2AMLogic/gf180-parasynth/refprofile/README.md

# refprofile — the frozen reference side

Reference audio rendered **once** through a qualified rig, cached, hashed, and
described in a file that is committed.

**The profile and frozen audio archive are committed.** `profile.json` holds the
hashes, the plugin's identity, every parameter the rig set, and the commit it
was built at. The WAVs live in `cache/`, which is gitignored. `frozen-cache.zip`
contains the exact sixteen previously frozen WAVs, recovered from the earlier
verification worktree. Restoration checks every file's size and SHA-256 against
`profile.json` before writing any clip. It needs no plugin and does not change
the reference.

**Evidence and commentary are split across two committed files (#129).**
`profile.json` holds only what a measurement depends on — clip hashes,
commanded and read-back parameters, rig identity — and is one of
`tools/run_case.py`'s `DEPENDENCIES`/`MODEL_INPUTS` (a hashed input: a batch
whose copy differs from `origin/main`'s refuses). The sibling
`profile-notes.json` holds the prose: the rig's own qualification verdict,
per-clip rationale, boilerplate readback captions. It is committed and it is
**deliberately not named in either tuple**, so correcting a factual error in a
verdict string never invalidates a measurement or forces a re-render.
`refprofile.load_profile()` merges the two back into one in-memory dict, so
every reader (`--list`, a rejection's `why`) still sees exactly what it saw
before the split; only what is written to and hashed from `profile.json` itself
carries none of it. `tools/refprofile.py --render` writes both files together,
from one `split_profile()` call, so they cannot drift into different clip sets.

```sh
python tools/refprofile_restore.py      # restore the committed exact audio
python tools/refprofile.py              # verify the cache against the profile
python tools/refprofile.py --list       # what it holds, and which rigs it rejects
python tools/refprofile.py --render     # re-render it — an explicit act, a visible diff
python tools/refprofile_repro.py        # render it N times and compare the bytes
```

## Why a profile and not a render on demand

A reference that is re-rendered on demand is not a reference. It moves when the
plugin updates, when the host block rate changes, when a preset drifts — and it
moves *silently*, because the number coming out looks exactly the same. Every
comparison made against it before the move becomes a comparison against
something nobody can reconstruct.

So `refprofile.load_clip` **never renders**. A cache that is absent, short, at
the wrong rate, silent, or whose bytes do not hash to what `profile.json` says
is a stated refusal, and the case that wanted it is a no-verdict with the
reason on its record. Re-rendering is `--render` and nothing else, so it always
produces a diff that somebody reviews.

The audio exists because a plugin on an operator's machine produced it;
`profile.json` records that capture. The archive makes those frozen bytes
available to clean checkouts. Fresh plugin renders remain an explicit,
separate operation.

## Three outcomes, kept apart

| exit | | |
|---|---|---|
| 0 | **OK** | every clip is on disk and hashes correctly |
| 1 | **FAIL** | a clip is there and is *not* what the profile describes |
| 2 | **REFUSED** | a precondition is unmet, so nothing was attempted |

**REFUSED is not a failure of the profile and must never be read as one.** Most
hosts in this fleet have neither the plugins nor `dawdreamer`; they can restore
and use the frozen WAVs. Missing or corrupt archives and clips still refuse.

## What is in it, and what is not

One rig qualifies. Three do not and one has **no verdict yet**, and the entries
that say **no** are the load-bearing ones — "we did not use Model D" and "Model D
cannot be used" are different facts and only the second one tells the next person
not to try. So is the entry that says **not yet**: it is neither of those two.

**Every verdict is scoped to a (rig, host) pair (#123).** Read
`tools/refprofile.py`'s `RIG_VERDICTS` through `refprofile.verdict_for(rig,
host)`, which refuses a verdict asked for under a host it was not measured
under — using `RIG_VERDICTS["modeld"]` under whatever host happens to be loaded
is the mistake #123 found.

| rig | host | | why |
|---|---|---|---|
| **Surge XT 1.2.3** Type 2 | `dawdreamer` | ✅ | open source; its LP Vintage Ladder subtype Type 2 is `sst-filters`' `VintageLadder::Huov` — Huovilainen's DAFx-04 model, the same paper DR 0001 implements. The **only** reference here whose cutoff is commanded in Hz and reads back in Hz |
| **Moog Model D** | `dawdreamer` | ❌ | **renders exact silence under `dawdreamer` 0.9.0.** Measured, not inherited: peak 0.0 with oscillator 1 on at full level and the filter wide open, and peak 0.0 with the filter self-oscillating. The rig builds and its pins hold. This verdict is about the (plugin, host) pair and **not** about the plugin — see the row below. `profile-notes.json`'s `disqualified.modeld.verdict` and `rigs.modeld.why` now carry this same host-scoped wording (#129 corrected the unscoped "renders exact silence headlessly" that used to live in `profile.json` itself — a prose edit, and it no longer touches a hashed input) |
| **Moog Model D** | `pedalboard` | ⏳ **no verdict yet** | **NOT silent under `pedalboard`** — peak 1.000, 8.57 % of samples at the rail, strongest partial 131.00 Hz for a commanded MIDI 60 (261.63 Hz, so an octave down — the same default as Mini V3, which is itself the exact reverse: it sounds under dawdreamer and is silent under pedalboard). Both of those disqualify the **default patch**, so `reference_rigs.ModelDPedalboardRig` (#124) exists to try to correct them through Model D's own parameters and measure whether it worked: it sweeps Osc 1 Range and selects the position that *sounds* the commanded note, and steps the master volume to the loudest setting with zero samples at the rail. `qualified` is **`None`, not `false`** — no operator has run it on a machine with the bundle. Run `python tools/qualify_modeld_pedalboard.py`; see [`docs/pedalboard-rig.md`](../docs/pedalboard-rig.md). **What is missing narrowed on 2026-09-30:** the *host* is no longer part of it — `pedalboard` 0.9.25 installs cleanly from a wheel on Linux / CPython 3.12 into an isolated venv, the rig's API surface has been read against that install and holds, and the refusal on this fleet is now `Moog Model D is not installed at …` rather than `no pedalboard on this machine`. The one remaining blocker is the **licensed Model D binary**, which no venv produces |
| **Arturia Mini V3** | `dawdreamer` | ❌ | makes sound under this host (it is **silent** under `pedalboard`), and every parameter is a bare 0..1 with no units and no readback. Its cutoff can be calibrated against its own self-oscillation (`reference_compare.calibrate_knob`); its **envelope** knobs cannot, because nothing here maps a Mini V3 envelope knob to a time. Its Range control also defaults an octave down — note 48 reads 65.42 Hz until parameter 45 is written. **The ❌ is `envelope_timing` alone** — see the capability matrix below, where this rig is ✅ for pitch, waveform and the sustained filter |
| **u-he Diva** | `dawdreamer` | ❌ | found running unlicensed and inserting clicks (`docs/reference-integrity.md` §1), and is a general analogue-modelling synth rather than a Minimoog emulation |

**And every verdict is scoped to a CAPABILITY (#136).** One boolean per rig
forces the most restrictive capability to gate every other one, which is how one
missing calibration came to be recorded as a 32-case blocker. `python
tools/refprofile.py --capabilities` prints this on any host, and
`capability_why` in `RIG_VERDICTS` names the measurement behind every cell:

| rig | overall | pitch | waveform | sustained filter | envelope timing | pitch causality | filter causality |
|---|---|---|---|---|---|---|---|
| **Surge XT** Type 2 | ✅ | ⏳ | ✅ | ✅ | ⏳ | ⏳ | ✅ |
| **Mini V3** | ❌ | ✅ | ✅ | ✅ | ❌ | ⏳ | ⏳ |
| **Model D** / `dawdreamer` | ❌ | ❌ | ❌ | ❌ | ❌ | ❌ | ❌ |
| **Model D** / `pedalboard` | ⏳ | ⏳ | ⏳ | ⏳ | ⏳ | ⏳ | ⏳ |
| **Diva** | ❌ | ❌ | ❌ | ❌ | ❌ | ❌ | ❌ |

⏳ is **no verdict**, not ❌ — and the asymmetry is the point. **Mini V3's pitch is
measured and Surge's is not**, because Mini V3's Range default was *broken* and
somebody therefore had to measure it (MIDI 48 at 65.42 Hz, exactly half of
130.81) while nobody ever doubted Surge's. What is recorded is what was measured,
and "probably fine" is not a verdict. The two all-❌ rows are disqualified at the
**apparatus** level — Model D returns peak 0.0 under this host, Diva was found
unlicensed and inserting clicks — so their rejections are written out across
every capability rather than left blank, and no capability-scoped query can route
around them.

**No clip in this profile comes from a pedalboard-hosted rig.** All sixteen are
Surge XT Type 2 under `dawdreamer`, and adding the pedalboard entry to
`RIG_VERDICTS` changes no clip and no hash — it appears in `profile.json` only
on the next `--render`.

Sixteen clips, all from Surge XT Type 2 at 48 kHz:

- one **wide open** (20 kHz) stepped-tone render — the passband reference that
  makes "low-band gain" a ratio *inside one instrument*
- ten at **250 Hz**, at resonance 0 and at each rung of
  `reference_compare.RES_GRID["surge"]`
- three **drive** clips: a steady 100 Hz tone at −12, −6 and 0 dBFS
- one each at **1 kHz** and **4 kHz**, resonance zero — the other two cutoff
  regions `docs/scorecard/cases.csv` states, read by F1B and F1C. Surge's own
  readback is exactly 1000.00 and 4000.00 Hz; the *corner* those produce is
  neither number and is read off the audio

Only resonance zero is rendered at the new regions, and that is a limit rather
than an omission. F1B and F1C are the only cases those clips can be read by.
F2B and F2C want a resonance ladder there and are blocked on a matched-drive
**definition**, not on audio — see `run_case.NOT_RUN["F2A"]` — so freezing ten
more rungs per region would cache audio no case can consume and move every
consumer's profile hash to do it. Whoever writes that definition renders the
ladder the definition asks for.

## Frozen, and *reproducibly* frozen — two different claims

A list of hashes says these are the bytes that were frozen. It says nothing
about whether the rig would make them again, and only the second makes the
profile a reference rather than a recording. `tools/refprofile_repro.py` asks
the second question: N separate `--render` **processes**, so the VST3 is
reloaded and the rig re-qualified every time, then a byte-for-byte comparison.

At `daf9e64`, macOS/arm64, Surge XT 1.2.3, dawdreamer 0.9.0, Python 3.14.7:

```
16/16 clips bit-identical across 4 independent renders
14 reproduced the committed sha256, 0 changed, 2 new, 0 dropped
```

The second line is a *different* claim from the first and is the load-bearing
one: a host that renders the same thing four times and something else than the
operator who froze the profile has a reproducible rig and a moved reference.
This host reproduced all fourteen, so the two new clips were frozen by the rig
that froze the rest — not merely by a rig that agrees with itself.

Asked again at `01e01e1`, on a host whose `cache/` was empty, after
`--render` rebuilt it from nothing. The verdict is committed as
[`repro-report.json`](repro-report.json) rather than quoted from a log:

```
16/16 clips bit-identical across 4 independent renders
16 reproduced the committed sha256, 0 changed, 0 new, 0 dropped   (exit 0)
```

Sixteen now, not fourteen of sixteen: the two clips #146 added are on their
second independent freeze and `profile.json` is byte-unchanged by the run.
**This is the precondition the filter cases are measured under, not a property
of the profile in general** — #164 had to leave every reference-side F1 number
as a no-verdict precisely because `cache/` is gitignored and that host could not
render it. A host can now recover the identical bytes from `frozen-cache.zip`;
the existing per-read hash guard still protects F1A/F1B/F1C's reference side.

The restored-cache check verified **16/16 exact clips**. Both previously
blocked controls now execute: missing and tampered references each change all
three valid clean F1 comparisons into refusals. No sound measurement was
revised during restoration (0/16 clip identities changed). Synthetic archive
controls also reject a missing clip, a corrupt clip, and an escaping path
before writing any audio. CI runs these controls in an independent job.

What it does **not** vary: the machine, the OS, the plugin build, the sample
rate, the block size. Those are pinned by the rig and recorded in
`profile.json`, and a claim about them needs a second machine, not a second
run. A clip that does not reproduce is not frozen, and the tool refuses to
install it.

## Pins after rendering: what the frozen profile does and does not show (#233)

**The committed `profile.json` makes no post-render pin claim, although its
`pins_held_after_render` field says `true`.** The renderer that built it
(builder `4bbd8e90…`, at `daf9e64`) checked the pinned Surge parameters once,
*before* any clip was rendered, and wrote that field as a constant. Nothing
re-read the pins after a clip. `profile.json` and the frozen audio are left
byte-unchanged here: rewriting the field would change the historical record,
and re-rendering the profile would add nothing a reproduction does not
already show. `tools/refprofile.py --list` says this about the profile, and
`refprofile.post_render_checked()` returns false for it.

Since #233, `--render` re-reads every pinned name and readback after **each**
clip render, before that clip is written, and refuses on any change. The one
name change it accepts is the Classic→Audio In rename that #231 measured at
**259, 260, 264 and 265**. The readback is still required to match exactly.
`pins_held_after_render` is now derived from those checks. The per-clip
results are recorded in `qualification.post_render_check` and in each clip's
`pins_after_render`.

**The builder hash changed, and nothing is re-pinned to it.** Any profile
rendered from now on records the new `builder_sha256`. The committed profile
still records `4bbd8e90…`. `tools/run_case.py` hashes `tools/refprofile.py` as
a model input, so a run_case result from before this change no longer covers
the tree. That is the intended effect of a hashed input.

At `9f106f7` (clean), same host, Surge XT 1.2.3 and dawdreamer 0.9.0 as above,
the new renderer checked every clip in two independent renders
([`post-233-check/`](post-233-check/)):

```
16/16 clips bit-identical across 2 independent renders
16 reproduced the committed sha256, 0 changed, 0 new, 0 dropped   (exit 0)
pins_held_after_render: true, derived; 16/16 clips checked in each run
name aliases observed on every clip: 259, 260, 264, 265 (readbacks unchanged)
```

The last line re-observes #231 independently. From the first clip onward,
Surge reports all four indices under their Audio In names. So the pre-#233
check, had it re-read the pins by exact name, would have refused every clip.
The frozen audio remains the same audio: the 16 committed hashes reproduce
under the new check. That reproduction is evidence about the *current* rig.
It does not show that the 2026-09-18 capture had a post-render check.
`profile.render1.json` in that folder is a run's output, kept for its
`qualification` and `pins_after_render` records. It is **not** the frozen
profile, and nothing reads clips through it.

## The probe level, and the floor it comes from

Every stepped-tone clip is at **−12.04 dBFS** (`amp = 0.25`), the level
`reference_compare.response_curve` has probed at since #87. That is not a level
chosen after seeing an answer, and it is not arbitrary — it is the only level
inside **our own side's** measured stability window:

| input | our corner at res 0 | our corner at res 1.20 |
|---|---|---|
| −60 dBFS | — | 55.7 Hz *(quantisation noise)* |
| −36 dBFS | — | 282.6 Hz |
| −24 dBFS | 125.2 Hz | — |
| −18 dBFS | 124.3 Hz | — |
| −12 dBFS | 117.8 Hz | 361.2 Hz |
| −6 dBFS | 105.0 Hz | — |

Below about −24 dBFS the stepped-tone probe on our 16-bit ladder is reading
truncation noise: at −60 dBFS `audio_measure.slope_db_oct` refuses every
resonant row and the corner moves by 300 Hz. Above −12 dBFS our own saturation
moves the corner. Surge is *level-independent* over the whole range — its
`thermal = 1/70` input scaling keeps it small-signal — so **the window is ours,
and it is stated as ours.** (Issue #92: a published floor that was not actually
constant withdrew a whole column of #61.)

## Rules

- **Expanded cache files remain ignored.** The one frozen archive is committed;
  new capture audio must have a reviewed profile identity before replacing it.
- **A result that used a clip names it**, by clip id and content hash.
  `tools/run_case.py` writes both into every record's `provenance.inputs`.
- **`profile.json` and `profile-notes.json` are generated together by
  `--render`, not edited by hand.** Only `profile.json` is one of
  `tools/run_case.py`'s `DEPENDENCIES`: a batch whose profile differs from
  `origin/main` refuses, because a result measured against a different frozen
  reference is not comparable with one measured against this one. `profile-
  notes.json` is deliberately absent from `DEPENDENCIES` and `MODEL_INPUTS`
  (#129): its prose is commentary, not evidence, and correcting it must never
  refuse a batch or invalidate a measurement.
- **Re-rendering is a decision, and its diff is the review.** If a clip's hash
  changes, something about the reference changed, and the diff says what.
- **A verdict belongs to a (rig, host) pair and is never overwritten by the other
  host's result.** Ask for one through `refprofile.verdict_for(rig, host)`, which
  refuses the cross-host read. Model D's dawdreamer entry records that this bundle
  renders exact silence under the host every clip here was built with; replacing
  it with a pedalboard result would erase that measurement.
- **`qualified: None` is not `qualified: false`.** "Nobody has run it" and "it
  cannot be used" are different facts. `refprofile.qualified_rigs()` returns only
  the `True` entries, and nothing may read a `None` as a rejection.
- **A verdict also belongs to a CAPABILITY, and the three-state rule applies
  there too (#136).** One boolean per rig forces the most restrictive capability
  to gate every other one: Mini V3's uncalibrated envelope knobs were recorded as
  blocking 32 Mono cases, when an oscillator-waveform comparison and a
  sustained-filter comparison need no envelope timing at all. So the key is
  (rig, host, capability):

  ```
  python tools/refprofile.py --capabilities      # the matrix, on any host
  ```

  `verdict_for(rig, host, capability)` returns that capability's verdict and
  keeps the rig-level AND as `rig_qualified`; `require_capability` raises a
  refusal **naming the capability** and saying what the rig *is* qualified for;
  `qualified_rigs(capability=...)` deliberately does **not** consult the
  rig-level boolean, which is the whole point — Mini V3's overall verdict is
  `NO` and it is qualified for `pitch`, `waveform` and `sustained_filter`.
  Asking for a capability a rig has no entry for is a **refusal**, never a
  `False`. A rig disqualified at the apparatus level (`modeld` renders silence,
  `diva` was found unlicensed) carries a measured `False` on *every* capability,
  written out rather than left blank, so no capability-scoped query can route
  around it. `capability_why` is prose and lives in `profile-notes.json` with
  the rest (#129).
- **A case says what it consumes, so the runner can ask the right question.**
  `run_case.capabilities_for(case_id)` derives it from the case's own
  `required_measurements` cell in `docs/scorecard/cases.csv` rather than from a
  second table beside it, and `run_case.capability_refusal(case, rig, host)`
  names the capability. The derivation independently reproduces which Mono cases
  run today: M1A/M5A/M5B need only capabilities Mini V3 has, and the six
  `NOT_RUN` anchors are exactly the ones that need envelope timing.
  `tools/capability_pack.py` is the pack that was parked behind that
  calibration — two waveforms at two pitches plus an open/closed filter pair —
  with the gate it passes and the apparatus refusal it still hits on a host
  with no plugins.
- **Every clip's environment tuple goes through `refprofile.environment_tuple`,
  whichever host rendered it.** One recorder — host and version, plugin and
  binary hash, block size *and its rate in Hz*, sample rate, licence state,
  preset (#123). It refuses rather than reports on a missing field, a plugin with
  no binary hash, and a `block` or `sr` given as `"unstated"`.
