2AMLogic/gf180-parasynth/docs/deadline/README.md

# The production frame deadline: three 2x saws with the 2x filter (plan075 T1)

**Verdict.**

- **Published baseline (OSC2X=1 FILTER2X=1 PULSE2X=0): fits, in every configuration exercised.**
  - The configuration PR #235's component bench refused runs with 79 cycles of sample slack.
  - Under musical stress the worst slack is 14 cycles. On SPI that stress included the full drum kit; on the Arty UART path the same voice ran with the drum page at reset (§3).
  - The observed extreme-case minimum is **6 cycles**, at register-legal increments of 2^23 and above.
  - Zero missed frames, zero sticky `overrun`, in every baseline run.
  - I2S matched the model exactly in **every musical-range comparison**: every required period decoded, once, in order, and compared. The extreme baseline runs do **not** match the model; that is #247, a separate defect, not a deadline result.
  - The cost-model bound (248 cycles, 6 of slack, for any register value) holds only **under the assumptions in §4**. It is checked on 30,333 retained frames but is not a formal proof.
- **The refusal was the bench's, not the chip's.** The bench now launches where the chip does, and its late-completion control fails for the deadline reason, to the cycle.
- **Pulse-enabled (PULSE2X=1): two separate findings.**
  - *Observed:* at register-legal increments of 2^23 and above (above Nyquist), 1597 and 1739 frames missed the deadline and the sticky overrun set.
  - *Proposed, not observed:* in the musical range the cost-model bound is exactly the deadline, 0 cycles of slack. No musical-range miss was seen; the worst musical-range stress had 4 cycles of slack.
  - **PULSE2X=1 is excluded from the first release** as a conservative decision. That is a checkpoint, not a fulfilment. A bounded correction is measured in §7 and deliberately not part of this PR.

Every simulated number comes from `docs/deadline/runs/`, the simulator runs at `2221d2c`: `run_all.json` holds each job's exit status, and each run has its own record. The batch is `tools/deadline_batch.py`. The **analysis** of those same captures was re-run without re-simulating, under analysis version 2 (§4, §4a); those records are in `docs/deadline/reanalysis/`. The traces themselves are archived gzip'd in `docs/deadline/traces/`, with their sha256 in each reanalysis record.

## 1. What was measured

| | |
|---|---|
| Source | batch run at `2221d2c` (`docs/deadline/runs/HEAD.txt`), which is `origin/main` `9337ece` (#235 merged at `ffc1c00`) plus this branch. The tree was dirty only with the batch's own output directory. |
| RTL | `rtl-sketch/voice_dp.v` `a15752570543`, `synth_top.v` `e4f8d97b9785`, `fpga/rtl/arty_a7_top.v` `664a4359af90`. All three are **byte-identical to the published Arty baseline's `source_sha256`** (`fpga/reports/arty/integrated-baseline-2025.1/publication.json`), and the other sources are hashed in each run record. |
| ROMs | `tanh16.hex` `a5c4862a7e90`, `tanh256.hex` `c6e81324b225`, `g_rom128.hex` `97bd3bc7774f`, `k_rom32.hex` `723f288d7bc1`, `sine_q256.hex` `040736830a6b`, `exp_rom65.hex` `c29b6f815d80` |
| Flags | baseline `VOICE_OSC_2X VOICE_FILTER_2X`; pulse-enabled adds `VOICE_PULSE_2X` |
| Clock / rate | 12.288 MHz core, 256 cycles per frame, 48 kHz. The Arty wrapper runs with `SIM_NO_MMCM=1`, so the bench supplies 12.288 MHz directly. |
| Benches | `tb_top_bx.v` drives synth_top through the SPI pins. `tb_uart_bx.v` drives `arty_a7_top` through the UART pins and holds SPI idle. Both are unedited. `rtl-sketch/deadline_mon*.v(h)` is attached as an extra simulation root that reads synth_top hierarchically and drives nothing. |
| Simulator | Icarus Verilog. Python is `/Users/joseph/dev/gf180-parasynth/.venv`, which is a symlink to the gf180-monosynth venv, so the logs show that path. |

**The frame, from the RTL.** `go` is at cycle 8 (`GO_CYCLE`). The voice and drum datapaths are busy from cycle 9. The SPI drain writes in cycles 1–5 and the UART in cycles 6–7; the runs observed cycle 2 (SPI) and cycle 6 (UART). No write ever landed while a datapath was busy.

`i2s_tx` loads the next period's word at cycle 255, so the **sample deadline is a strobe by cycle 254**. `synth_top` latches `overrun` if either datapath is busy in cycle 0, so the **busy deadline is cycle 255**. The next frame's boundary is cycle 256, which is cycle 0 of the next frame. The drum section finishes at cycle 125 in every frame of every run, a constant, so it never gates the voice.

## 2. The refused case, with legal setup

This is PR #235's `f1cal` configuration with SAW instead of revsaw: three 2x saw oscillators with mix 1/0/0, the 2x filter, and `surge-type2-clean-v1` at 250, 1000 and 4000 Hz with resonance 0, then 1000 Hz at resonance 1.0 and 1.1. The words come from the landed calibration and are asserted equal to #235's record: gain 42598, ogain 100825 / 302474 / 322639.

In production, every register of the image was preloaded over the SPI pins before the note. Frames were computed from reset as always, but the gate stayed off until the image was complete. The note (three INC jumps, TRACK, GATE_ON) followed, and each F1 point was then a control write during playback.

| run | frames | missed | worst strobe | sample slack | busy slack | overrun | I2S vs model |
|---|---:|---:|---:|---:|---:|---:|---|
| production, PULSE2X=0 | 3691 | 0 | 175 | **79** | 81 | 0 | 3692 periods, 0 differ |
| production, PULSE2X=1 | 3691 | 0 | 175 | **79** | 81 | 0 | 3692 periods, 0 differ |
| component bench, production launch (frame 0 = whole image + note) | 7200 | 0 | 217 | **37** | 39 | — | 7200 frames, every sample and tap identical |
| component bench, **old launch** (`--go 48`, diagnostic) | — | frame 0 | — | — | — | OVERRUN | reproduces #235's refusal, now as a deadline FAIL |

Frame 0 of the component scenario is the heaviest frame this configuration produces: every register plus three new increments, so three reciprocal divisions. At go = 8 its strobe is at cycle 217. At go = 48 the same frame would strobe at cycle 257. That is the whole refusal.

## 3. Production results for every configuration

Each "stress" run preloads the voice image and the complete 808 kit, all 147 kit words plus the accents. It then plays three audible oscillators (mix 1/0.8/0.7, noise 0.3) with glide and oscillator and filter modulation on. That means every increment moves every frame, so all three reciprocals are recomputed.

Over those notes the run strikes all eleven stops and subsets of them. It switches the drum filter (ROUTE.DFILT) on and off and moves DCUT. It sends cutoff, resonance, volume, wheel and waveform writes during playback. It includes legato glides, retriggers, a gate-off and a three-increment jump. It then sweeps legato runs across MIDI 24–127.

"Extreme" runs set every increment to 2^23 or above by register writes. That is legal, but above Nyquist; note 127 is 0x42xxxx. They glide between such values with the drum filter on, which opens both PolyBLEP windows of every edge.

| configuration | scenario | frames | missed | worst strobe | **sample slack** | busy slack | overrun / busy-at-tick | I2S vs model |
|---|---|---:|---:|---:|---:|---:|---|---|
| baseline | stress-saw (SPI) | 2155 | 0 | 240 | **14** | 16 | 0 / 0 | 2156 periods, 0 differ |
| baseline | arty-uart (UART pins, Arty wrapper) | 3496 | 0 | 240 | **14** | 16 | 0 / 0 | 3300 periods, 0 differ |
| baseline | extreme-saw | 2167 | 0 | 245 | **9** | 11 | 0 / 0 | 1809 differ, see §7 |
| baseline | extreme-saw-mod | 2167 | 0 | 248 | **6** | 8 | 0 / 0 | 1809 differ, see §7 |
| PULSE2X=1 | stress-saw | 2155 | 0 | 242 | **12** | 14 | 0 / 0 | 2156 periods, 0 differ |
| PULSE2X=1 | stress-pulse (square / pulse29 / pulse15) | 2155 | 0 | 250 | **4** | 6 | 0 / 0 | 2156 periods, 0 differ |
| PULSE2X=1 | extreme-pulse | 2167 | **1597** | 255 | **−1** | 0 | **1** / 1293 | FAIL |
| PULSE2X=1 | extreme-pulse-mod | 2167 | **1739** | — | — | — | **1** / 1675 | FAIL |

Every run delivered all its writes (for example 460 of 460 SPI and 71 of 71 UART). None were corrupted, none landed off the frame the pin predicted, and the link `overflow` stayed at 0.

For the baseline stress-saw, the gate was on with three audible 2x saws for 1644 frames: 1188 of them with the drum filter and 44 with a strike in the same frame.

**The full-kit stress claim belongs to the SPI runs only.** The arty-uart run is the published Arty configuration under UART control, checked by `fpga/verify_uart_bridge.py`'s own contract and model comparison. It strikes stops and turns on the drum filter, but its drum page stays at its **reset image**: the 147-word kit would take about 5000 frames at 115200 baud. It shows that the UART control path keeps the same voice schedule. It is **not** a UART full-kit demonstration.

## 4. The cost model: reconciled, re-analysed, and its limits

**What changed (analysis version 2).** Version 1 of `cost_model()`, as reviewed at `4433cf8`, subtracted `ywait` (the S_YWAIT wait for the voice ladder) as if it were a serial term. The README formula did not. So the committed run records said `explained: false`, with residuals 82/76/78/80, while this document said 87. The document was not backed by its own evidence.

The disagreement is visible in two committed frames of stress-saw:

| frame | ywait | every serial term | strobe |
|---|---:|---|---:|
| 538 | 5 | equal | 240 |
| 840 | 11 | equal | 240 |

Frame 840 waited 6 more cycles and completed at the same cycle. Under version 1 their residuals are 82 and 76; under the formula below both are 87. `docs/deadline/reanalysis/red-first-v1.log` records this, and `tools/test_verify_deadline.py` pins it.

**The schedule, as the RTL overlaps it.** The voice ladder is launched at S_LGO and runs in parallel with the sequencer's shadow work: envelope updates, glide slews (two extra states per gliding oscillator), red noise, the modulation pan and the drum-filter coefficients. S_YWAIT then waits for whatever is left of the ladder's latency. As long as the ladder, not the shadow work, ends that wait, the shadow work trades one-for-one with `ywait` and completion does not move:

```
strobe = C + R + O + D + W + 2·A + I + 3·K        overlap condition: ywait >= 2 in the frame
```

- R: reciprocal waits, 19 for each oscillator whose modulated increment changed.
- O: 2x-bank waits, 20 for each oscillator routed through the bank.
- D: the drum-filter wait, 1, or 23 with ROUTE.DFILT.
- W: PolyBLEP windows examined.
- A: active windows.
- I: modulated increments.
- K: shark-tooth oscillators.

`ywait` is not a term. A frame whose `ywait` is below 2 would mean the shadow work ended the wait, so the formula would not apply; it is counted as an exception, never absorbed.

**Re-analysis of every retained trace.** `tools/deadline_reanalyse.py` re-judged all 18 captures of the `2221d2c` batch with `verify_deadline.py --analyse-capture`, without simulating. Every capture was **identified**:

- its stimulus, re-derived from the record's scenario, equals the capture's own command file byte for byte;
- its re-computed frames, misses and worst slacks equal the original record's;
- all 18 re-judged statuses equal the original ones.

| | value |
|---|---|
| deadline-meeting unmutated traces checked | 12 (both threesaw, all four stress, arty-uart, both extreme-saw, four skip2xwin candidates) |
| frames checked | **30,333** |
| value of C | **87 in every frame**; no other residual |
| overlap exceptions (`ywait` < 2) | **0**; `ywait` ranged 5..11 |
| `late:14` / `late:15` controls | C = 101 / 102 in all 2155 frames each, so the stall is exactly additive |
| traces with misses (excluded from the bound) | extreme-pulse, extreme-pulse-mod and the late:160 controls. After the first overrun their frames desynchronise, and those residuals (e.g. −169) are not frames the model describes. |

The records are in `docs/deadline/reanalysis/`: `summary.json` holds the totals and the capture identities, and each `<record>.json` carries `analysis_version: 2` next to the original run's provenance.

**The per-term maximum argument, and what it assumes.**

| configuration | worst oscillator | bound, increments < 2^23 | bound, any register value | observed |
|---|---|---:|---:|---|
| PULSE2X=0 | 2x saw: O 20 + W 2 + 2·A 2·2 | 242 (slack 12) | 248 (slack 6) | 248 reached (extreme-saw-mod); musical-range worst 240 |
| PULSE2X=1 | 2x rectangular: 20 + 4 + 2·4 | 254 (slack 0), **not observed** | 266 (−12) | 255: observed misses above Nyquist; musical-range worst 250 |

The bounds take C = 87, R = 57, D = 23, I = 3, K = 0 and three of the worst oscillator. They assume:

1. **C is 87 in every reachable frame.** It is measured in 30,333 frames; it is not derived.
2. **The overlap condition holds in every reachable frame.** The largest shadow load in the traces (three gliding oscillators) still left `ywait` = 5.
3. **Per-term maxima are structural.** R ≤ 3 × 19 and I ≤ 3 because there are three oscillators. O is 20 per 2x oscillator. D ≤ 23. W is 2 per single edge and 4 per rectangular waveform. A single-edge window pair has at most 1 active when the increment is below 2^23 and at most 2 at or above it, read from the `active` expression in `voice_dp.v`. A shark oscillator (K) is outside the 2x bank and costs less than a 2x saw.
4. **The drum section completes at cycle 125 in every frame.** This is observed with every stop and pair exercised; a drum-engine change needs a re-run.
5. **Writes never land at or after `go`**, by `synth_top.v`'s drain and UART window. This is observed in every frame.

This is a bound from a cost model checked against every retained frame. **It is not a formal proof.** Where the assumptions are not observed, it is a claim. In particular, PULSE2X=1's 0-cycle musical-range figure is a *proposed* bound, not an observed miss.

## 4a. Evidence completeness: a verdict needs every period

**Version 1 accepted missing evidence.** Its I2S comparison looped over whatever periods were decoded. Given the clean SPI facts with `periods` set to 0 or 1, the verdict was still PASS (`red-first-v1.log`). Its schedule parser silently skipped malformed rows and needed only 10 frames.

**Version 2 derives what must be present from the bench contract.**

- **SPI.** The model covers `n = last landed write + tail + 1` frames. `tb_top_bx` stops `tail` ticks after its last transaction, and by its contract the last `I2S_DRAIN = 3` periods are still in the serializer. `verify_synth_top.py` gives M5A three drain frames for the same reason. So periods `0 .. n−4` must **all** be decoded and compared, the whole capture must be exactly `0, 1, …` in order, with no duplicate and no gap, and the schedule trace needs one row per decoded period.
- **Arty UART.** The interval is the one `verify_uart_bridge.analyze` compares, re-derived from the same contract: segment origin plus the model tail. Every period in it must be compared, and the raw capture must be contiguous from 0. The UART schedule and decoded-period counts are **not** assumed equal: the capture had 3498 periods and 3300 were required.
- **Schedule rows.** A malformed line, or frames that are not exactly `0, 1, 2, …`, is a problem, never skipped.

Any of these makes the verdict **NO VERDICT** (exit 2) before any deadline or model judgement. A late but complete capture is still a deadline FAIL; `late:15`'s retained capture is a test.

**Red first, on a retained capture** (`tools/test_verify_deadline.py`, 19 tests, exit 0). The clean stress-saw capture passes with 2156 of 2156 periods compared. Each of the following refuses for completeness and not as a deadline failure:

- empty I2S;
- truncated I2S (1000 rows);
- one interior period dropped;
- one period duplicated;
- empty schedule;
- one interior schedule frame dropped;
- a malformed schedule line.

**Re-applied to every retained capture:** 18 of 18 had complete evidence (`evidence_problems: []`), so no earlier verdict changes. SPI required periods equal the decoded periods exactly, for example 2156 of 2156. UART compared 3300 of the 3300 required, out of 3498 decoded.

## 5. The controls: late completion rejected for that reason

The late-completion control is a **build-time mutant**. `verify_deadline.py --mutant late:N` generates `voice_dp.v` with the master mix held N extra cycles in `S_OUT2`. Every value is unchanged; only completion is later. It is generated from the current file, and each anchor must occur exactly once or the run refuses (`tools/test_verify_deadline.py`). It is not an `ifdef` in `voice_dp.v`, because any byte change there unbinds the published Arty image: 16 `fpga/test_publish_arty.py` failures, measured.

| control | result | reason recorded |
|---|---|---|
| production SPI, threesaw-f1cal, late:160 | caught (exit 0 with `--expect-fail`) | 3691 missed frames, busy at 1846 ticks, sticky overrun 1 |
| Arty UART, late:160 | caught | 3496 missed, busy at 1749 ticks, overrun 1 |
| production stress-saw, **late:14** | PASS: slack exactly **0** (strobe 254), 0 missed, I2S exact | the measured slack of 14 is exact |
| production stress-saw, **late:15** | caught: 41 missed frames, strobe 255, first frame 538 (the recorded worst frame) | one cycle past the measured slack |
| component bench, late:160 | caught | `OVERRUN at frame 0`, a deadline FAIL, status 1 |
| component bench, **late:37** | PASS, strobe 254 | the component slack of 37 is exact |
| component bench, **late:38** | caught: `LATE SAMPLE` at frame 0, cycle 255 | one cycle past |
| component bench, `--go 48` | caught as a deadline FAIL | the original refusal, reproduced |

`--expect-fail` in `verify_deadline.py` and `--expect-deadline-fail` in `verify_voice.py` accept **only a deadline failure**. An I2S or value mismatch alone does not count; `tools/test_verify_deadline.py` pins that.

Pre-existing controls still behave. OSC2X_OFF is caught. The all-X stub red run now compiles and fails with X, exit 1. It had been dying at compile since `bd7ba32` added the `phase_os2`/`inc_mod` taps, and the stub now declares them.

## 6. The component bench's setup/launch contract (repaired)

`tb_voice.v` now pulses `go` at **synth_top's `GO_CYCLE`** (8). `verify_voice.py` REFUSES a bench whose GO differs from `synth_top.v`; `--go N` is available for diagnostics only and is labelled as such.

A frame's writes occupy the n cycles ending at go−1. When n > 7, they begin in the **previous frame's tail**. Every such cycle is asserted idle, and a write that would land mid-computation REFUSES the run rather than being applied. The register state at `go` is therefore the one the chip would hold, and **no write lands after the launch**. The chip itself delivers at most six writes per frame, all before cycle 8. The bench's larger bursts are whole-image loads for verification convenience, placed where they cannot overlap computation.

An overrun (busy in the frame's last cycle) and a strobe after cycle 254 are now FAILs of the design (status 1), not "did not run".

Regressions at the new launch all passed, bit-exact: quick default, quick `--osc2x` (64,416 frames), `waves3 --filter2x`, `waves3 --filter2x --pulse2x`, #235's `f1cal` (revsaw), and the new `threesaw` with and without `--pulse2x`.

## 7. Disposition

| configuration | disposition |
|---|---|
| **OSC2X=1 FILTER2X=1 PULSE2X=0** (published Arty baseline) | **Qualified for the frame deadline in the exercised configurations:** the #235 case (slack 79), SPI full-kit stress and UART-control stress (both 14), with every musical-range I2S comparison exact and complete. The **observed** extreme-case minimum is 6 cycles. The cost-model bound for combinations not run (242 musical, 248 any register value) holds under the §4 assumptions and is not a formal proof. |
| **PULSE2X=1** | **Excluded from the first release** (not supported, not published as supported), a conservative decision. **Observed:** deadline misses at register-legal increments above Nyquist. **Proposed, not observed:** a musical-range bound of exactly 0 slack. **Unqualified.** |
| Model/RTL agreement at glides between increments of 2^23 and above | **Separate defect, #247.** Frames 310–357 (jumps) match; the first difference is 7 frames after the first glide write. Every frame still met its deadline. It is outside the musical range but register-legal. |

**Candidate correction, measured and not shipped.** An oscillator whose output comes from the 2x bank still runs the scalar PolyBLEP window loop. That loop's `c_pp`/`c_ps` feed only the scalar path, which the oscillator does not use. Skipping it is one condition in `S_WIN`: `if (!blep || (use_osc2x && shape_osc2x)) state <= S_MIX;` (`--mutant skip2xwin`).

With the loop skipped, every 2x oscillator costs 21 cycles, so the bound becomes **233 (slack 21) for every combination in both configurations**, and the runs reach it. `extreme-pulse` went from −1 (1597 missed frames) to +24. `extreme-pulse-mod` and `extreme-saw-mod` both went to +21. On `stress-pulse` the slack went from 4 to 21 and the I2S stayed bit-exact against the unchanged model. The extreme candidate runs show the same 1809 differences as the unmodified RTL, which is #247.

It is not committed. It changes `voice_dp.v`, which would unbind the published baseline image. The baseline does not need it; it fits. And the pulse-enabled image needs a rebuild anyway (#205, plan075 T4). **It belongs in T4, with the full verify_voice and synth_top evidence at that head.**

## 8. Wrong-then-right, and apparatus incidents

1. **Launch at 48 versus 8.** The original refusal came from the bench's schedule. Re-run at the chip's launch, the same scenario passes with 37 cycles of slack.
2. **The late mutant was absorbed.** Its first version stalled in `S_DWAIT`, alongside the drum filter's own 23-cycle wait. The 1-cycle boundary control (late:15) reported NOT CAUGHT; nothing had moved. It now stalls in `S_OUT2`, and late:14 and late:15 bracket the measured slack exactly.
3. **An `ifdef` control broke the published-image binding.** It was compiled into `voice_dp.v` and caused 16 `fpga/test_publish_arty.py` failures. It was reverted and replaced by a build-time mutant.
4. **Tick-relative indexing.** `tb_voice` reads outputs just after the clock edge, so their chip cycle is `cyc + 1`. Caught when writing the deadline fields, before any run was quoted.
5. **The cost model's code disagreed with this document** (plan080 review). Version 1 subtracted `ywait`, so the run records said `explained: false` while the README said 87. Paired frames 538/840 show `ywait` overlaps rather than adds. Reconciled in analysis version 2 and re-analysed over all 30,333 frames, with no exceptions.
6. **Missing evidence could pass** (plan080 review). A verdict with 0 compared periods was PASS. Version 2 requires every period in the bench-contract interval, and every schedule frame, or gives NO VERDICT. No retained capture was incomplete.
7. Apparatus, not results:
   - A zsh batch did not word-split `$D` and ran nothing (exit 2). It is now `tools/deadline_batch.py`.
   - The stub red run was invoked with the wrong relative path (NO-VERDICT). It was re-run with the right path (`runs/run_all-stub.json`, PASS).
   - The stub itself had been uncompilable since `bd7ba32`; it is fixed.

## 8a. The batch is an investigation record, not 32 release tests

`docs/deadline/runs/run_all.json`: 24 of 32 jobs exited 0. Grouped by what they are:

| group | jobs | outcome |
|---|---|---|
| **Supported-baseline qualification** (PULSE2X=0) | production threesaw-f1cal, stress-saw, arty-uart; component threesaw; component regressions (quick, quick `--osc2x`, `waves3 --filter2x`, `f1cal`); FPGA binding and deadline tests | all PASS |
| **Controls** (must fail for the recorded reason) | late:160 on SPI, UART and the component bench; late:15 and late:38 boundaries; `--go 48`; OSC2X_OFF; the all-X stub | all caught (exit 0 under `--expect-fail`); late:14 and late:37 pass at slack 0 |
| **Excluded-configuration experiments** (PULSE2X=1) | threesaw-f1cal-p2x, stress-saw-p2x, stress-pulse-p2x, component threesaw-p2x and `waves3 --pulse2x`: PASS; **extreme-pulse, extreme-pulse-mod: FAIL** | retained design counterexamples: observed deadline misses |
| **Known-defect reproductions** (baseline, above Nyquist) | **extreme-saw, extreme-saw-mod: FAIL** | #247 model/RTL mismatch; deadline met (slack 9 and 6) |
| **Candidate correction** (skip2xwin; not in this PR) | stress-pulse-p2x PASS; **three extreme runs FAIL** | #247 only; deadline met (slack 21 to 24) |
| **Apparatus** | the stub red run, invoked with a wrong relative path | NO-VERDICT; re-run correctly in `run_all-stub.json`, PASS |

So the 8 non-passing jobs are 7 retained design counterexamples and 1 apparatus invocation error. None of them is counted as a successful test.

## 9. Reproduce

```
.venv/bin/python tools/deadline_batch.py      # writes docs/deadline/runs/, ~35 min
.venv/bin/python tools/deadline_reanalyse.py  # re-judges the retained captures, archives traces; no simulation
.venv/bin/python tools/deadline_recapture_l2.py  # re-cuts the two -l2 evidence traces, ~80 s
.venv/bin/python -m pytest tools/test_verify_deadline.py -q
```

`tools/test_verify_deadline.py` judges two committed captures,
`traces/prod-stress-saw-l2` (clean) and `traces/ctl-prod-stress-late15-l2`
(its `late:15` negative control), each against the stimulus that drove it, and
**refuses** either one whose stimulus disagrees with the one this tree builds
now on anything the schedule can see. The retained pre-L2 `prod-stress-saw` /
`ctl-prod-stress-late15` captures stay in the tree as history and are
*expected* to be refused (460 writes, not 461); one test asserts exactly that.

**What the binding is (#443).** It used to be every byte of `top_bx_cmds.txt`,
which is strictly stronger than the property it protects: it cost two
re-captures in three days, and in #426 the whole difference was two drum
register values while the schedule trace was byte-identical
(`tools/deadline_binding_probe.py --history 8c3de22 a224050`: 2 command lines,
0 of 2159 schedule lines, 997 of 2158 I2S periods). It is now
`verify_deadline.stimulus_binding`, which relaxes exactly one thing -- the data
of a drum-page write other than STOPS -- because drum_dp / modal_dp advance on
counters only and drum_regs acts on addresses, never data (the argument is in
the source, above `DRUM_LATENCY_ARGUED_AT`).

- *Still refused:* a different write count or order, any wait (landing frame),
  flag, section or address, **any voice-page value** (INC moves the PolyBLEP
  windows, WAVE the window loop, ROUTE the drum filter's wait -- the voice is
  not classified register by register, it is bound whole), the STOPS value (a
  coverage fact), and a drum value change when the drum RTL in the tree or in
  the capture's run record is not the RTL the argument was made on, or the
  capture's drum busy window is not one fixed window.
- *Admitted:* drum parameter values only, and the capture is then judged
  against its own recorded stimulus.
- *Controls:* `test_a_schedule_relevant_stimulus_change_is_still_refused` (ten
  edits on the real capture, including a voice INC value -- the issue's
  "value change that does move the slack"), the premise test, and
  `test_the_controls_can_fail`. `tools/deadline_binding_probe.py` is the
  simulator check of the argument (build box, ~80 s per probe): three drum
  perturbations must leave the schedule identical and the voice-INC control
  must move it.
- *Never covered:* the capture is bound to its stimulus, not to the RTL that
  ran it; a `voice_dp.v` change that moves the schedule is not seen. The
  byte-exact binding had the same gap.
