2AMLogic/gf180-parasynth/docs/scorecard/r1/README.md

# R1 scorecard: five gates, no average

Generated by `tools/r1_scorecard.py` from `fpga/release/r1-candidate.json`, `fpga/reports/r1-candidate/summary.json` and the case board. Do not edit by hand; `--check` fails when this file is stale.

**Candidate:** R1 player preview: contract revision 14, `synth_design -top arty_a7_top -part xc7a100tcsg324-1` with `OSC2X=1 FILTER2X=1 PULSE2X=0`, RTL frozen at `6864435aa6eb`, kit `321a93546cfa` (148 writes, clap ENV_FRATE[8] = 68), host `--image r1`. R0 is `arty-a7-100t baseline 2025.1, r1 (plan087 R0; contract revision 11; image a66c9349...)`; nothing below is evidence about R0.

Evidence produced at `14e12bc02808, ccf7ed49515b` (origin/main `86838760ccce`) on the build box; harvested at `8f6db97bb676`.

| gate | question | verdict | evidence level |
|---|---|---|---|
| trust | are the results trustworthy? | **PASS** | receipts re-checked; every declared control caught |
| implementation | does this implementation work? | **PASS** | RTL simulation of the Arty wrapper at its pins (digital production path); routed image `544499e2c970`: WNS +15.445 / WHS +0.036 ns, external I/O qualified, DSP review complete (`fpga/release/r1-2025.1.json`, BOUND, T-RELEASE-BOUND-R1) |
| playability | is it an instrument? | **PASS** (digital, 11 of 16 sounds mapped) | live-MIDI session against the device contract and the RTL; no hardware latency |
| sound properties | does it meet its references? | **property vector** (below): 9 pass, 10 fail, 7 no verdict, 74 not run of 100 | mostly fixed-point model |
| physical | did the device produce it? | **BLOCKED** | R1 image `544499e2c970` published, not yet programmed on a board, no capture (#208); simulation cannot satisfy this gate |

## Implementation

| run | identity (sender / target, kit) | workload | expected vs observed coverage | verdict | evidence level |
|---|---|---|---|---|---|
| T-DEADLINE sim | `ccf7ed49`; engineering stream (no kit) | arty-uart: three audible 2x saws, glide, wheel, waveform and control writes over the UART pins; drum page at reset (strikes silent) | arty-uart: I2S 3300/3300 periods; frames 3496, missed 0, worst sample slack 13 | **PASS** | RTL simulation, Arty wrapper at its UART pins (digital production path; no image) + deadline monitor |
| T-DEADLINE stress | `ccf7ed49`; engineering stream, kit rev 14 321a93546cfa | stress-saw: three audible 2x oscillators, glide + oscillator/filter modulation, noise, full revision-14 kit loaded and all eleven stops struck, cutoff/resonance/volume/wheel/waveform writes, drum filter toggled (a superset of the player domain) | stress-saw: I2S 2158/2158 periods; frames 2157, missed 0, worst sample slack 13 | **PASS** | RTL simulation, synth_top at its SPI pins + deadline monitor |
| T-PLAY-DIGITAL r1 | `14e12bc0`; tree / tree (frozen), kit rev 14 321a93546cfa | held notes (default, m5a-saw, m5a-pulse), `run --note 45 --fixture m5a`, `demo` and `bar808-full` as the CLI emits them (known-state preamble, full kit, three oscillators on the default patch, knob moves, glides on legato) | held-default: I2S 3820/3820 periods; I2S 3820/3820 periods, peak 12760 LSB (floor 1024) / held-m5a-saw: I2S 3820/3820 periods; I2S 3820/3820 periods, peak 7345 LSB (floor 1024) / held-m5a-pulse: I2S 3820/3820 periods; I2S 3820/3820 periods, peak 10376 LSB (floor 1024) / run-m5a: I2S 8109/8109 periods; I2S 8109/8109 periods, peak 12760 LSB (floor 1024) / phrase-demo: demo: writes 511/511, I2S 257427/257427 periods, mismatch 0, off-frame 0, worst strobe 198 / phrase-bar808-full: bar808-full: writes 397/397, I2S 266937/266937 periods, mismatch 0, off-frame 0, worst strobe 196 | **PASS** | RTL simulation, Arty wrapper at its UART pins (digital production path; no image) |
| supported domain + session start (unit) | `8f6db97b`; R1 host (--image tree) | refusals with a reason (INC_RANGE, GLIDE_247, ROUTE_DRUMFILTER, MOD_EXCURSION, WAVES, PULSE2X, NOT_IN_IMAGE R1 wording, preset with fixture); known-state preamble; queued-event refusal; wrong-kit controls | pytest exit 0: 71 passed, 2 deselected in 5.73s | **PASS** | host code (no RTL) |

## Playability

| run | identity (sender / target, kit) | workload | expected vs observed coverage | verdict | evidence level |
|---|---|---|---|---|---|
| T-LIVE-MIDI sim | `ccf7ed49`; session --image tree / frozen oracle, kit rev 14 321a93546cfa | coverage (incl. counter wrap), pressure, sustained 20 s declared load | session-sim: latency n 905 p95 16.73 p99 16.98 ms | **PASS** | host against the device contract on simulated time (no RTL) |
| T-LIVE-MIDI rtl | `14e12bc0`; session --image tree / frozen oracle, kit rev 14 321a93546cfa | the session's own bytes for coverage, pressure and 3 s of the declared load, replayed through the wrapper; two I2S controls | session-rtl: latency n 905 p95 16.73 p99 16.98 ms; RTL I2S periods compared/required coverage 109053/109053, pressure 46653/46653, sustained 166513/166513 | **PASS** | RTL simulation, Arty wrapper at its UART pins (digital production path; no image) |

The live player maps **11 of the 16** 808 sounds: BD, SD, LT, MT, HT, CH, OH, CP, CB, CL and CY. The three congas, the rimshot and the maracas are refused as unmapped; #298 tracks exposing them. MIDI-to-audio latency on hardware (USB/FTDI) is not measured.

## Trust

| run | verdict | detail |
|---|---|---|
| T-DEADLINE sim | PASS | receipt valid True; controls caught 1/1 |
| T-DEADLINE stress | PASS | receipt valid True; controls caught 1/1 |
| T-LIVE-MIDI sim | PASS | receipt valid True; controls caught 3/3 |
| T-LIVE-MIDI rtl | PASS | receipt valid True; controls caught 3/3 |
| T-PLAY-DIGITAL r1 | PASS | receipt valid True; controls caught 2/2 |
| T-RELEASE-BOUND check | PASS | receipt valid True; controls caught 2/2 |
| supported domain + session start (unit) | PASS | no receipt (pytest exit status) |

## Sound properties (per case; distances are each property's error over its own tolerance, pass at <= 1)

None of these was measured on the R1 production path. Each row names its engine and the commit it was measured at; a fixed-point-model result supports R1 development and certifies neither R0 nor R1 playback.

| case | subject | state | properties | evidence level | measured at |
|---|---|---|---|---|---|
| D01A | Bass drum / anchor | no verdict | Pitch trajectory 0.15; early/body energy 0.07 | fixed-point model | `4b560cb` |
| D02A | Snare / anchor | pass | Body/noise balance 0.65; attack 0.02; noise decay 0.04 | integrated RTL (component bench) | `99637db` |
| D03A | Low tom / anchor | fail | Pitch drop 0.06; body spectrum 6.04; decay 0.04 | fixed-point model | `7dd6337` |
| D04A | Low conga / anchor | no verdict | Pitch 0.77; body spectrum 4.14 | fixed-point model | `7dd6337` |
| D05A | Mid tom / anchor | fail | Pitch drop 0.14; body spectrum 5.46; decay 0.04 | fixed-point model | `7dd6337` |
| D06A | Mid conga / anchor | fail | Pitch 0.04; body spectrum 3.99; decay 0.0 | fixed-point model | `7dd6337` |
| D07A | High tom / anchor | fail | Pitch drop 0.14; body spectrum 4.51; decay 0.04 | fixed-point model | `7dd6337` |
| D08A | High conga / anchor | fail | Pitch 0.3; body spectrum 3.64; decay 0.01 | fixed-point model | `7dd6337` |
| D09A | Claves / anchor | pass | Pitch 0.32; attack duration 0.14; tail decay 0.61 | fixed-point model | `7dd6337` |
| D10A | Rimshot / anchor | fail | Partial balance 2.85; attack 0.39; tail decay 0.17 | fixed-point model | `811acdf` |
| D11A | Maracas / anchor | fail | Rise time 1.68; band energy 1.43; decay 5.42 | fixed-point model | `7dd6337` |
| D12A | Clap / anchor | no verdict | burst/tail ratio 0.28; decay 0.88 | fixed-point model | `d42ac140` |
| D13A | Cowbell / anchor | fail | Partial balance 2.02; unwanted difference tone 0.0; decay 0.23 | fixed-point model | `be9b0c9` |
| D14A | Cymbal / anchor | no verdict | Band energy 0.5; band decay 0.25 | fixed-point model | `32e824d` |
| D14B | Cymbal / variation | no verdict | Band energy 3.57 | fixed-point model | `32e824dc` |
| D15A | Open hat / anchor | no verdict | Band energy 0.81; attack 1.6 | fixed-point model | `7dd6337` |
| D16A | Closed hat / anchor | pass | Band energy 0.96; attack 0.57; decay 0.73 | fixed-point model | `7dd6337` |
| M1A | Round bass / anchor | no verdict | Fundamental/harmonics 19.82; bass level 0.35 | fixed-point model | `cea5525` |
| M5A | Bright high lead / anchor | fail | Pitch 0.15; Harmonic shape 7.56; Foldback energy 3.42; Envelope attack 1.07; Envelope release 0.06; Gain 0.47; Clipping 0.0 | integrated RTL (component bench) | `746b2605` |
| M5B | Bright high lead / lower / darker | fail | Pitch 0.15; Harmonic shape 5.96; Foldback energy 2.95; Envelope attack 1.21; Envelope release 0.24; Gain 0.9; Clipping 0.0 | fixed-point model | `746b260` |
| F1A | Cutoff response / low | pass | Corner frequency 0.76; low-band gain 0.0; rolloff 0.6 | integrated RTL (component bench) | `25d7efe1` |
| F1B | Cutoff response / mid | pass | Corner frequency 0.42; low-band gain 0.04; rolloff 0.02 | fixed-point model | `e356498` |
| F1C | Cutoff response / high | pass | Corner frequency 0.36; low-band gain 0.03; rolloff 0.09 | fixed-point model | `e356498` |
| E1A | Bass and kit / sparse | pass | Event timing 0.2; bus balance 0.0; output artifacts 0.0 | integrated RTL (component bench) | `af8f8ef` |
| E1B | Bass and kit / dense | pass | Event timing 0.2; bus balance 0.0; output artifacts 0.0 | fixed-point model | `d42ac140` |
| E2A | Lead and kit / sparse | pass | Event timing 0.2; bus balance 0.0; output artifacts 0.0 | fixed-point model | `d42ac140` |

A count such as the pass total above is coverage, not a quality percentage or a release-readiness percentage.
