2AMLogic/gf180-parasynth/spec/decision-records/0025-shared-bus-dc-coupling-register-and-numeric-contract.md

# 0025: The shared-bus DC coupling: register, fixed K = 10, widths, lifecycle

- **Status**: proposed. Model and contract only; no RTL (#552), no sound claim (#553).
- **Date**: 2026-10-07
- **Decided by**: Builder, issue #551 (part of #510, which rests on the diagnosis of #152 and the prototype of #165).

## Context

The drum block has no DC blocking, and the machine does (`docs/dcblock/README.md`).
`model/drums_fx.py` carried an EXPERIMENTAL constructor-selected blocker (`DrumsFx(couple=...)`),
default off, measured by `tools/probes/dc_blocker.py`. That is an instrument, not a product:
it has no register, no declared widths, no stated enable or reset behaviour, and a
Python integer accumulator that cannot overflow, so no number measured on it says what a
finite RTL word must be. #551 turns it into a specified, register-driven block so #552
(RTL) and #553 (sound preservation, decoded I2S) have one contract to meet.

## Decision

Specified in `spec/NUMERIC-CONTRACT.md` 15.10 (revision 16); the model is `drums_fx.DrumsFx`
and `drums_fx.DcBlockFx`, the tests `model/test_drums_fx.py::test_coupling_*`.

1. **Address `0x30`, one enable bit.** Audited against the model's map (`0x00`, `0x10..0x1A`,
   `0x20..0x25`, `0x40..0x87`, `0x90..0xA6`, `0xB0..0xEF`, `0xFF`) and `rtl-sketch/drum_regs.v`
   (no `8'h30` literal; decoder ranges are the same set). Candidates `0x88` and `0xA7` were
   rejected: both sit directly after a block that has already grown (ENV 8 -> 18 entries moved
   PATH and MODE once; `0x88` would be the first address ENV's next entry takes). `0x30` is
   16 addresses from ENV and 10 from OSC_INC. Bit 0 enables; bits 31..1 reserved and ignored;
   no read-back; reset 0.
2. **K = 10, fixed, not a register.** A tunable corner is a register and a verification
   surface nobody has asked for; the sweep (below) is the evidence for the value.
3. **Placement**: one filter on `dmix` (22 bits signed) and one on `body` (19 bits signed), after
   the bank and before the output stage's products and its single clamp. Not on excitations
   (`COUPLE_EXC`: the excitation is asymmetric by design) and not after the clamp
   (`COUPLE_POST`: DC removed after clipping cannot recover what the clip destroyed;
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
