2AMLogic/gf180-parasynth/docs/scorecard/mono-m1a-miniv3/phase-cycle-capture/odd-partials-vs-psi.png

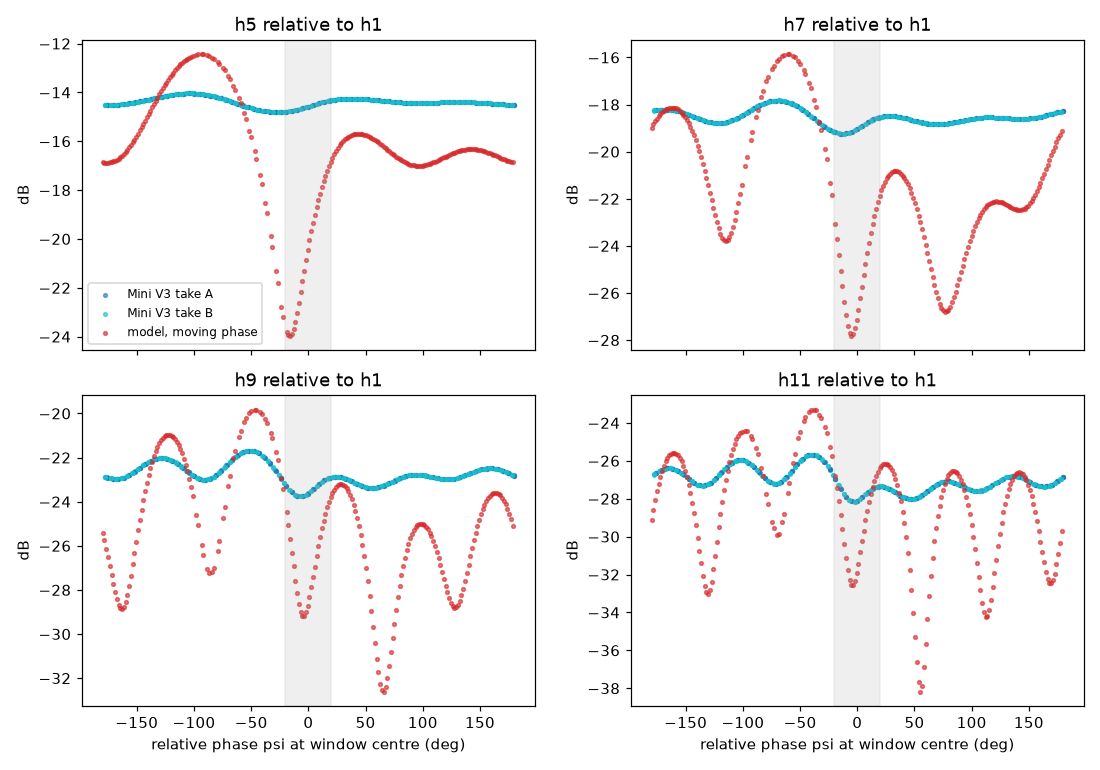
docs/scorecard/mono-m1a-miniv3/phase-cycle-capture/odd-partials-vs-psi.png
