2AMLogic/gf180-parasynth/docs/res-tuning/validation.txt

Issue #257 validation on the UNTOUCHED grid -- `python3 model/res_tuning.py validate`.
candidate: LAW_DEGREE 3, CORR_ENTRIES 33, REFIT_ENTRIES 1, correction table [32768, 32838, 32999, 33168, 33296, 33425, 33575, 33699, 33828, 33934, 33987, 34075, 34152, 34217, 34245, 34310, 34367, 34440, 34479, 34532, 34581, 34598, 34633, 34669, 34694, 34724, 34767, 34790, 34809, 34819, 34826, 34841, 34841]

offset_cents -- every point, cents of f_osc against commanded (baseline | candidate)
cut_hz b1.03 c1.03 b1.15 c1.15 b1.33 c1.33 b1.6 c1.6 b1.85 c1.85 b1.99 c1.99
30 -2.77 +10.24 -32.57 +40.85 -78.80 -0.89 -103.88 +24.60 -117.36 +11.13 -122.05 +6.45
150 +0.75 -4.59 -29.00 +0.14 -61.32 +1.64 -85.77 -2.32 -99.27 -3.13 -103.94 -7.79
300 +9.59 +4.19 -20.25 +2.53 -52.69 +4.35 -77.07 +0.75 -90.60 +3.92 -95.02 -0.48
566 +11.89 +0.88 -18.10 +0.84 -50.75 +1.21 -74.99 +3.13 -88.57 +0.73 -92.54 -0.40
1131 +13.90 +1.90 -16.45 +2.00 -49.43 +1.59 -73.43 +2.63 -87.07 +2.28 -89.99 +2.42
2263 +15.73 +3.95 -15.35 +2.69 -48.91 +1.61 -72.63 +2.48 -86.23 +1.82 -86.99 +3.55
4525 +12.86 +2.73 -19.62 -0.13 -54.27 -2.41 -78.40 -1.21 -88.14 +2.10 -88.14 +4.34
9000 -2.83 -0.94 -38.11 -6.94 -74.57 -11.02 -100.23 -11.36 -104.96 -2.72 -104.96 -0.00
12000 -11.40 +0.00 -48.63 -2.74 -86.46 -11.34 -113.18 -13.07 -116.31 +0.00 -116.31 +0.00
16000 -13.30 +4.64 -53.15 -0.00 -92.62 -0.00 -120.44 +0.00 -126.43 +0.00 -126.43 +0.00

baseline: mean-offset travel 106.08 c, worst per-cut travel 119.28 c, worst |offset| 126.43 c, mean |offset| 66.12 c
  per-cut travel: 30 Hz 119.3, 150 Hz 104.7, 300 Hz 104.6, 566 Hz 104.4, 1131 Hz 103.9, 2263 Hz 102.7, 4525 Hz 101.0, 9000 Hz 102.1, 12000 Hz 104.9, 16000 Hz 113.1
  mean offset by res: 1.03 +3.4, 1.15 -29.1, 1.33 -65.0, 1.6 -90.0, 1.85 -100.5, 1.99 -102.6
  onset (0.97 sustains / 1.03 sustains): 30 0/1, 150 0/1, 300 0/1, 566 0/1, 1131 0/1, 2263 0/1, 4525 0/1, 9000 0/1, 12000 0/1, 16000 0/1
candidate: mean-offset travel 5.45 c, worst per-cut travel 41.74 c, worst |offset| 40.85 c, mean |offset| 4.06 c
  per-cut travel: 30 Hz 41.7, 150 Hz 9.4, 300 Hz 4.8, 566 Hz 3.5, 1131 Hz 1.0, 2263 Hz 2.3, 4525 Hz 6.7, 9000 Hz 11.4, 12000 Hz 13.1, 16000 Hz 4.6
  mean offset by res: 1.03 +2.3, 1.15 +3.9, 1.33 -1.5, 1.6 +0.6, 1.85 +1.6, 1.99 +0.8
  onset (0.97 sustains / 1.03 sustains): 30 0/1, 150 0/1, 300 0/1, 566 0/1, 1131 0/1, 2263 0/1, 4525 0/1, 9000 0/1, 12000 0/1, 16000 0/1

PASS T1_mean_offset_travel
PASS T2_worst_per_cut_travel
PASS N1_worst_abs
PASS N2_mean_abs
PASS N3_onset
OVERALL PASS
