2AMLogic/gf180-parasynth/fpga/reports/arty/r2-clean/verification.txt

tb_uart_bx: SEG 0 origin_tcc 20 periods 0 strobes 0
tb_uart_bx: ran 6975 frames in 1 segments; 6974 I2S periods decoded
tb_uart_bx: writes drained 87, spi+uart slot collisions 0 (must be 0)
tb_uart_bx: sample strobed in 6975 frames, MISSING in 0, worst strobe cycle 171 of 256
tb_uart_bx: datapath busy at a tick: 0; core overrun 0; link overflow 0
tb_uart_bx: TX bytes captured 175
