2AMLogic/gf180-parasynth/docs/verification-rules.md

# Verification rules

Short, and every one of them was learned the expensive way in this repository —
the first three on 2026-09-17, rules 4 and 5 on 2026-09-26 (issue #52), rule 6
from #123, rule 7 from #135, and rule 8 on 2026-10-01 (#155). This sentence read
"there are only five" for as long as there were seven — `docs/failure-modes.md`
mechanism 4, a claim outliving its evidence, in the file that argues against it.

---

## 1. Start red

**Before an implementation exists, run its harness against a stub with the
right ports and no behaviour, and watch it fail.** Record the result. Only
then write the implementation.

A `verify_*.py` script must support this directly:

```bash
.venv/bin/python rtl-sketch/verify_ladder.py --rtl rtl-sketch/stubs/ladder_dp_stub.v
#   first mismatch at sample 6: model -1, RTL 0, error +1 LSB
#   worst |error| 64290 LSB; error RMS 25961.9 LSB vs signal RMS 25961.9 LSB (+0.0 dB)
#   exit 1
```

Model-first is not enough. This repository was already model-first — a Python
reference model as the specification, RTL compared against it — and still shipped
four separate harnesses that had never been observed to fail:

| what | how it hid |
|---|---|
| the cocotb bit-exact suite | died at `import synth_ref` before running a test; the negative-control job read *any* non-zero exit as "bug caught" and reported four catches in 1.6 s |
| `ladder_dp_t16.v` | its `tanh` index was out of range, yosys marked the datapath don't-care, **every output was X** — and it was quoted at 1,917 cells for three rounds |
| `tb_ladder_n.v` | read 120-bit words from a 128-bit vector file; it could never have passed against anything |
| `voice_dp.v` | bit-exact over 43,200 frames with **zero** injected-bug controls, so nothing had shown the bench could detect a defect |

Every one is the same shape: **a harness nobody had watched fail.** Starting
red catches all four by construction, and costs about fifteen lines of stub.

### The hardware-specific part

In software an unimplemented function raises. In hardware it outputs **X**, and
an X comparison can silently pass depending on how the bench is written — which
is exactly how `ladder_dp_t16` survived. So the red run must distinguish three
outcomes, not two:

- **X** — the design did not elaborate, or synthesis optimised it away
- **wrong value** — it computes, incorrectly
- **right value** — it computes correctly

A bench that reports "mismatch" for all three is fine. A bench that reports
"pass" for X is not a bench. Check this explicitly; do not assume it.

---

## 2. Every bench carries injected-bug controls

A green bench means nothing until each control has been demonstrated to turn it
red, with a mismatch count. Target the things most likely to be silently wrong
rather than the easy ones — in this design that has meant the PolyBLEP square
sign flip (backwards measures 5 dB *worse* than no correction at all), the
envelope release floor (without it a note never ends), and the resonance
compensation lookup (without it the filter dies above 3 kHz).

---

## 3. A cell count is not evidence of correctness

Synthesis and cycle counts establish area and schedule. They say nothing about
whether the circuit computes anything: a netlist whose every output is X has an
area, and it was reported here three times before anyone simulated it.

Quote area only alongside a simulation result, and say which flow produced it —
`klt` allows `*_1` cells and ORFS excludes them by default, which is a 22–42 %
difference on the same RTL.

This is now enforced rather than advised, for one tool: `pnr/report_synth_area.py`
simulates before it answers and REFUSES — withholding the cell count it already
has — when any output is X. Rule 5 records what that refusal cost to make
trustworthy, and why the netlist-side checks cannot do the job.

---

## 4. A multi-property suite reports what it is BLIND to, not just what failed

Rule 2 asks whether a control turns the bench red. That is a yes/no about the
**bench**. It does not say which of the bench's properties actually saw the
defect, and a property that never sees anything is decoration wearing the
costume of coverage.

So: **when a suite measures more than one property, every injected control
prints a properties × defects matrix — MOVED for the properties that saw it,
BLIND for the ones that did not.**

This is not a proposal; it has already caught a hole in a metric that looked
rigorous. `model/sound_report.py --inject ladder-cut30` — a uniform 30 %
cutoff error — put `corner ratio drift` in the BLIND column, because a
**non-uniformity** metric cannot by construction see a **uniform** skew. Both
properties were correct. One of them could never have failed for that defect.

Four suites print the matrix, and they are the only four that can:

| suite | its "properties" | example |
|---|---|---|
| `model/sound_report.py --inject` | named acoustic properties per voice | `sd-centroid-amp-weighted` moves SD brightness 1918 → 5868 Hz and leaves SD's other **five** properties BLIND |
| `fpga/verify_xdc_binding.py --matrix` | the nine properties that decide whether the Arty constraint file still binds this wrapper | `UART_SLASH_JOIN` — #315's own bytes — moves `hier_separators` and leaves the other **eight** BLIND, including `query_counts`: every query still has a declared required count, which is exactly why the text-level gates passed while both constraints were dropped |
| `rtl-sketch/verify_ctl.py --inject` | the four fields of a register write, plus the write `count` and the `drain` window | `SPI_ADDR7` moves `address` on 105 of 206 writes and the other five are BLIND. `SPI_DATA24` moves `data` on 42 of 206. `SPI_ANYLEN` moves only `count` (208 writes reach the port for 206 sent) and `SPI_DRAIN_LATE` only `drain` (206 of 206 applied at `go`) — each row is printed against its OWN population, so `count` is over the 206 sent while `drain` is over the 208 that arrived |
| `tools/probes/estimator_ground_truth.py controls` (#517) | the sixty-four estimator checks the synthetic ground-truth suite runs against `model/audio_measure.py` | twenty-two named mutants, each declared against the ONE (estimator, family) pair it must redden. `transfer` returning \|H\|&sup2; moves `transfer`, `corner_3db` and `bandwidth_q` — three of the four readers that go through it, `resonant_peak` reading the same curve's argmax and surviving a monotone squaring — and leaves the other **sixty-one** BLIND; `rms` as the mean of \|x\| moves exactly one. Thirty-nine checks are blind to every mutant, thirty-six of those were reddened by a start-red stub instead, and the run FAILS on any check reddened by **neither** |

**Every other `--expect-fail` suite here is single-property by construction and
a matrix would be a table with one column.** `verify_ladder.py`,
`verify_modal.py`, `verify_voice.py`, `verify_synth_top.py`, `verify_drums.py`,
`tools/verify_rate_conv_2x.py` and `fpga/verify_fixture.py` all compare an RTL
sample stream against the Python model **with no tolerance**, sample for
sample. There is exactly one question — "is the stream identical" — so there is
exactly one property, and "which property saw it" has one possible answer.
Those suites already report the thing a matrix would add: the first mismatching
sample, the mismatch count, and the error in LSB.

The test for whether this rule applies is therefore: *does the suite reduce its
comparison to more than one named quantity?* If yes, print the matrix. If it is
one bit-exact stream comparison, do not invent columns to fill.

`verify_ctl.py` is the one that was **not** obvious — its verdict is pass/fail
like the others, but `compare_writes` had already been decomposing the failure
into four per-field counters for its own error message. The matrix was one
function away and nobody had asked for it.

---

## 5. A bug is not closed until it is an injection

**The failure mode of injection testing is that you inject the bugs you already
thought of.** That is `docs/failure-modes.md`'s root cause wearing a lab coat:
validating against our own imagination. An injection suite grown only from
what its authors imagined is as internally consistent, and as ungrounded, as an
estimator calibrated on our own model.

There is one source of defects guaranteed **not** to come from our imagination:
the bugs this project actually made. So when a bug is fixed, the fix is half
the work; the other half is reinstating the exact broken behaviour as a
permanent control that must stay red.

Seven already work this way — two at the control layer, two at the measurement
layer, two in the build/report tools, and one at the constraint layer:

| the bug, as it shipped | the injection it became |
|---|---|
| the SPI address truncated to 7 bits | `verify_ctl.py --inject SPI_ADDR7` — the exact broken frame |
| the SPI datum truncated to 24 bits | `verify_ctl.py --inject SPI_DATA24` |
| a 5 ms moving average used as an envelope on a 56 Hz carrier — 0.28 of a cycle | `sound_report.py --inject bd-ma-envelope` |
| an amplitude-weighted centroid read where a power-weighted one belonged | `sound_report.py --inject sd-centroid-amp-weighted` |
| `ladder_dp_t16`'s out-of-range tanh index quoted at **1,917 cells** for three rounds | `pnr/report_synth_area.py --inject TANH_INDEX_OOR --expect refused-x` — the tool REFUSES and withholds the number |
| a die area recovered from its own `{"method": "utilization", "utilization_pct": 50}` | `pnr/orfs/area_provenance.py --inject UTILIZATION_TARGET --expect refused-circular`, and `CORE_UTILIZATION_SET` for the ORFS spelling |
| the two UART-RX synchroniser constraints joined their generate block with a **slash**, matched nothing, and were dropped by Vivado from the R0 **and** R1 bitstreams while every text-level gate passed (#315) | `fpga/verify_xdc_binding.py --inject UART_SLASH_JOIN --expect-fail` — and, better, the pre-#315 file itself as the bench's start-red, read straight out of `383f10b^` rather than reconstructed |

The last two are the measurement layer, which is where most of this project's
errors actually lived, and both were already pinned by a helper-function unit
test before this rule existed. **A unit test on the helper is not the same
control**: it proves the broken function is broken, not that the acceptance
path would have noticed someone using it. Reinstating them through
`sound_report.py` puts them where the verdict is issued.

A third historical measurement bug — the Hann-windowed 700 Hz noise-share
split, wrong by 15× — is kept the other way round, as a method retained
*because it must stay wrong*, in `model/test_drum_fit.py`. That is the same
rule with the sign flipped and is equally valid.

**Not yet injections**: the list is empty. It held two entries — X-propagation
quoted as a 1,917-cell area, and a die area recovered from its own utilization
input — and both became controls under issue #245. It is a debt marker, not
coverage; it shrinks only when an entry becomes a control, and it grows again
the next time a bug is fixed without one.

The two newest are refusal controls rather than comparison controls, which is a
distinction worth keeping straight. The four above ask "does the bench notice a
wrong number?" The two below ask "does the tool decline to produce a number it
cannot stand behind?", so their `--expect` names the *reason* for the refusal
(`refused-x`, `refused-circular`), not merely that one occurred. Without that, a
missing yosys would have made the X control look like it had fired.

**What enforcing the second one immediately found**, and this is the argument
for a check over a comment: `pnr/orfs/ladder_dp/config.mk` and
`pnr/orfs/synth_core/config.mk` both set `CORE_UTILIZATION = 50`, the setting
`synth_top/config.mk`'s own header warns against at length, so
`pnr/orfs/summarize.py` would have quoted a `die / synth cell area` of about 2
for either of them without a word. The convention held exactly where somebody
had written a paragraph about it and nowhere else.

**And what the first one measured is a warning about which checks are worth
anything here.** Under `TANH_INDEX_OOR` — a tanh index field one bit wider than
the table it reads, the `ladder_dp_t16` defect — the synthesised netlist contains
no `x`, simulates `x`-free at the gate level, and its cell count moves by
**0.1 %** (1,677 against 1,679). Yosys is entitled to resolve a don't-care to
anything it likes, and does. Only a behavioural simulation of the sources sees
it: `y` is `x` on 506 of 512 sampled cycles. The area is not a weak detector of
this class of defect, it is not a detector at all.

### The three conditions, because a control that cannot run looks like one that works

A control counts as caught only if **all three** hold, and anything else is
`NO VERDICT` — which is red, and is *not* a fail:

1. the clean run passes;
2. the mutant **builds, activates and actually executes**;
3. the intended assertion is the one that fails.

Condition 2 is not theoretical. The nightly's injection check once swallowed
the exit status with `|| true` and then grepped the output for `MISS`/`FAIL`/
`MOVED` — so **a traceback containing any of those words counted as a caught
defect.** A tool that could not run was indistinguishable from a control that
worked. Separately, this repository has shipped a "negative control" that
mutated a function signature into invalid Python and passed, proving only that
Python rejects syntax errors.

And per `CLAUDE.md`: **run the gate against the current state before committing
it.** An unsatisfiable gate is worse than no gate — it trains everyone to
ignore gates, including the working ones.

## 6. A claim about an external tool is a claim about a configuration

"Model D renders silence" was true of `dawdreamer` 0.9.0 and false under
`pedalboard`; unlicensed Diva clicks; Surge parameter 265 depends on oscillator
type; "94 Hz stepping" was our host block rate; "Mini V3 plays an octave down"
was a defaulted Range parameter (Model D does the same). Each recorded a tool
property that was a property of (host, version, binary hash, block size, sample
rate, licence state, preset). Rules (#123), checked by `tools/external_claim.py`
over `docs/external-tool-claims.json` in `make verify` and, through its test,
`make verify-fast`. A record with no polarity or environment is REFUSED:

1. **No external-tool claim without its environment tuple** -- host and version,
   loader, machine, binary sha256, block size, sample rate, licence state, preset. Negative
   claims included, especially.
2. **A negative result needs a second route** (different host, loader or
   machine) that reproduces it before it is believed.
3. **Which host works per plugin is data** (`host_per_plugin` in that file).
   Each entry is `unverified` or names a passing claim; `host_result()` refuses
   unverified entries. Today every entry is unverified.
4. **Assert what defaults wrongly, every time**: pitch, level (silence is not
   data) and pin readback, via `external_claim.assert_readback`. Plugin defaults
   are chosen for demos, not measurement. This rule is not yet enforced: no
   render harness calls `assert_readback` yet. Wiring it in is follow-up work.

The same applies to yosys, iverilog, ORFS and scipy defaults (`sosfiltfilt`
`padtype`, #101).

## 7. A measured effect and its mechanism are different claims

Issue #135: two renders of the same Diva patch differed in 1,763,954 of
1,764,000 samples — measured, and real, and nobody disputes it. The conclusion
drawn from that number — that the cause was an artefact inserted on a
wall-clock timer, therefore non-deterministic relative to the note, therefore
Diva is a valid *positive control* for a demo-artefact detector — was asserted
and never tested. If the real cause were a free-running LFO or a modelled
drift instead, Diva would be an ordinary analogue-modelled synth and a
*terrible* positive control: non-determinism would be correct behaviour, and a
detector calibrated on it would flag every plugin of that kind. The two
sentences read as one finding. They are not — one is evidence, the other is a
story that happened to sit next to it and borrowed its credibility.

1. **State the effect and the mechanism in separate sentences.** Do not let a
   connective like "because" join a measured number to an unmeasured
   explanation inside one clause — the explanation inherits the number's
   authority the instant they share a sentence, and a reader cannot easily
   tell which half they are agreeing with.
2. **Every mechanism claim carries its evidentiary status, from a closed
   vocabulary, machine-checked.** `mechanism=<status>` is a marker modifier
   (`docs/claim-markers.md`), usable alongside any of the existing claim kinds
   (`test=`, `grep=`, `absent=`, `commit=`). An invalid or missing status is
   `REFUSED`, the same discipline this file's marker convention already
   applies to an unrecognised key — a typo must not be able to hide as a
   confident claim. The five values, four of them #114's own
   (`model/drums_fx.py`'s constant-provenance registry) carried over
   unchanged because #135 asks for exactly that:

   | status | what it means here |
   |---|---|
   | `measured` | the mechanism itself was tested, not just the effect it explains |
   | `derived` | follows from documented behaviour (a datasheet, a spec, a known circuit) without a new measurement |
   | `inferred` | a plausible reading of indirect evidence that does exist, but was not measured for this claim |
   | `fitted` | chosen or tuned to match other data; it explains that data by construction, which is not independent support |
   | `unverified` | asserted with zero evidence of any kind — weaker than `inferred`, which at least cites something indirect. This is the Diva case: nothing was measured about *why*, only *that*. |
3. **A mechanism is load-bearing — used to justify a design decision, a
   detector, or a go/no-go call — only at `measured`.** Everything weaker may
   be recorded as a hypothesis worth testing later; it may not decide
   anything in the meantime. (This third rule is policy, not something
   `check_doc_claims.py` can enforce by itself — see
   `docs/claim-markers.md`, "What this does and does not enforce.")

The two sentences from #135 itself, marked up with the convention they argue
for — the rule demonstrating itself:

Measured, and sound: two renders of the same Diva patch differ in 1,763,954 of 1,764,000 samples; Mini V3 is bit-identical across the same test.
<!-- claim: grep="1,763,954 of 1,764,000 samples" in=docs/verification-rules.md note="the effect -- a specific count, re-derivable from this file" -->

Asserted, and never tested: that the cause is an artefact inserted on a wall-clock timer, therefore non-deterministic relative to the note, therefore Diva is a positive control for a demo-artefact detector.
<!-- claim: grep="an artefact inserted on a wall-clock timer" in=docs/verification-rules.md mechanism=unverified issue=135 note="the mechanism -- zero measurement, so not load-bearing; #135's own example of exactly this rule" -->

## 8. A guard ships with the input that defeats it, or with a stated reason none exists

**Four guards in this repository have been satisfied by the exact pathology they
were written to catch** (#155): the silence check defeated by NaN, because IEEE
comparisons with NaN are always False (#134); `tail_db` defeated by the backward
integral's own shape, which falls toward −∞ at the last sample of any finite
record (#118); the decay *length* criterion defeated by zero-padding (#139); and
the DAG verdict defeated by a node's evidence file merely existing (#140). In
every case the criterion was correct **for well-formed input** and blind outside
the domain it assumed — and in every case the question that would have found it
is askable in seconds, at the moment the guard is written:

> *What input satisfies this check while violating its intent?*

So that question is now part of writing one. **A new guard, threshold or refusal
criterion ships with the adversarial input that defeats it**, in one of exactly
two forms:

1. **A committed control** — the defeating input as a test or an `--inject`
   mutant that must stay red, per rule 5's pattern. This is the preferred form,
   because an input that lives only in a commit message stops being checked the
   moment the guard is next edited.
2. **An explicit stated reason none exists** — in the PR or the commit, naming
   what was tried. "No defeating input was constructed" is an acceptable answer;
   *silence* is not, because a guard with no stated adversary is
   indistinguishable from a guard whose adversary nobody looked for. A reason
   that turns out to be wrong is a finding, which is worth more than a blank.

**This is not rule 5 restated, and the distinction is the whole point.** Rule 5
is retrospective: a bug *this project actually made* becomes a permanent control
so the fix cannot silently regress. Its input set is the history of real
defects. Rule 8 is prospective, and applies to guards that have **never** been
defeated by anything — the input is *constructed adversarially at write time*
and need not correspond to any bug that has happened. A guard can satisfy rule 5
trivially by never having failed, and still be wide open; the four above all
were. Where a rule-8 input later turns out to describe a real bug, it graduates
into a rule-5 control and the two rules agree.

### Worked example: the decay-length guard and zero-padding (#139)

One example, worked through; **this is not a licence to retrofit every existing
guard in the tree**, the same scope-guard rule 7 uses.

The guard: a decay estimate is refused unless the record holds at least
`min_tail_t20` times the fitted T20 *after* the −25 dB point. It replaced a
*level* criterion (`tail_db`) that the backward integral defeats — so it was
already the second attempt at this guard, written by someone who had just been
burned by exactly this class of failure.

The defeating input is four words long: **append digital silence.**

```
full 2.0 s                   ok=True    T20 = 0.4605 s
truncated to 0.30 s          ok=False   REFUSED, correctly
truncated + 1.7 s of SILENCE ok=True    T20 = 0.2387 s      <-- 48 % error
```
<!-- claim: test=model/test_audio_measure.py::test_appending_silence_cannot_rescue_a_refused_decay -->

Zeros carry no information and cannot change what the decay was, so padding
converted a correct refusal into an accepted answer wrong by 48 %. The criterion
counted **samples in the array**; its intent was **signal in the tail**. Nobody
needed a corpus or a render to find this — only the question above, asked once,
before the guard shipped.

What the repair looks like under this rule: the estimate is read off the
record's *sounding* extent, which makes appending silence an exact **invariance**
of the function rather than a threshold that might hold, and both directions of
that invariance are committed controls — the pad cannot rescue a refusal, and it
cannot move an accepted answer either.
<!-- claim: test=model/test_audio_measure.py::test_appending_silence_cannot_change_an_accepted_decay_either -->

And the repair ships with form 2 as well, for the adversary it does **not**
stop: a record padded with **low-level noise** is still accepted, because that
pad is signal by every measure the function has. That is stated rather than
left to be discovered, with the measurement behind it — a −60 dB noise pad reads
−24.8 dB where `bd8/BD5050.WAV`, the board's own bass-drum reference, reads
−33.6, so any threshold that refused the pad would refuse the references first.
A known, bounded, *written-down* blind spot is rule 4's discipline applied to a
guard: report what it is blind to, not only what it catches.
