2AMLogic/gf180-parasynth/fpga/reports/arty/ARTY_MOSI_ZERO/verification.txt

verify_synth_top: 67 writes over the pins (67 voice, 0 drum), 957 frames after the last
verify_synth_top: M5A controls: pulse=pulse29; effective pulse=pulse479 (47.90% duty); saw cutoff=20000 Hz; saw volume correction=-0.45428 dB
verify_synth_top: M5A stimulus has 4 note events, smoke: envelope completion not claimed; selected filter drive 0.75; pulse pulse29; saw cutoff 20000 Hz; saw volume correction -0.45428 dB; reference sha256 a808cd22448ecea1c639f9311578eb72399f69bda373e9036174c2ca208a1f0a
verify_synth_top: selected 2x saw + causal 2x filter candidate; compile defines: VOICE_OSC_2X, VOICE_FILTER_2X, INJECT_BUG_ARTY_MOSI_ZERO
verify_synth_top: simulator backend iverilog
  sim: tb_top_bx: status word on MISO = 4d210001
  sim: tb_top_bx: 67 writes sent, 4822 frames, 4821 I2S periods decoded
  sim: tb_top_bx: transactions accepted at the pin 67, writes drained 67, landing frame differs from the pin prediction 0 times (must be 0)
  sim: tb_top_bx: sample strobed in 4822 frames, MISSING in 0, worst strobe cycle 154 of 256
  sim: tb_top_bx: datapath busy at a tick: 0 (must be 0); overrun 0; overflow 0
verify_synth_top: built from ce32c9e-dirty, outdir /private/tmp/wt-arty-bringup/build/arty-rom-controls/ARTY_MOSI_ZERO; synth_top.v e476bfdfe93d, drum_kit.v 41bdf7a73aaa, drum_regs.v c20808c86b23; ROMs tanh16.hex a5c4862a7e90, tanh256.hex c6e81324b225; 2 source(s) taken from None: arty_a7_top.v, tb_top_bx.v
verify_synth_top: NOTE -- the core strobes its sample as late as cycle 154 of 256, past the LRCLK transition at 128 (40 % of the frame still spare, no overrun). A right-channel-only defect is INVISIBLE at the pins in this configuration: see the I2S_SWAP entry in the Makefile's controls target
verify_synth_top: FAIL -- 67 of 67 writes arrived corrupted (run verify_ctl.py: that is the link, not the datapath)
