2AMLogic/gf180-parasynth/fpga/uart_host.py

#!/usr/bin/env python3
"""fpga/uart_host.py -- the USB-UART control bridge, HOST side.

The Arty's FTDI USB-UART is the control link a musician actually has: no SPI
header, just the connector the board is programmed through. This module is the
host half of that link. `spi_host.py` remains the reference for WHAT a musical
event becomes (48-bit DR 0007 revision 2 register frames, named presets, the
KeyHost note logic); this module is about DELIVERY over a byte stream, and the
one rule the project plan makes non-negotiable:

    TIMED EVENTS EXECUTE ON THE DEVICE. Host-side sleeps cannot honour an
    audio-frame deadline over USB, so they are not used. The host uploads
    commands stamped with the FRAME each write applies in; the device's event
    queue fires them.

THE WIRE. 115200 8N1 by default, LSB-first bytes. Every packet is

    opcode payload... checksum

with checksum = two's complement of the byte sum (mod 256), so a corrupted
packet is REJECTED at the device and reported, never half-applied. The payload
of a write is exactly the SPI framing's six bytes, MSB first:
{F, 6'b0, SEC, A[7:0], D[31:0]}.

PACKETS (host -> device):
  W 0x57  6 reg bytes ck          write now: applies at the start of the frame
                                  after the packet is accepted (the live path)
  E 0x45  due_lsb due_msb 6 ck    scheduled write: applies AT the due frame,
                                  executed from the device's event queue
  Q 0x51  ck                      status query; device answers on its TX
  X 0x58  ck                      abort: clear both queues (queued, unexecuted
                                  events are discarded; counters survive)

PACKETS (device -> host):
  ACK    06 seq                   accepted into a queue
  ERR    1C code seq info         1 write-queue overflow, 2 event-queue
                                  overflow, 3 due in the past / out of order,
                                  4 resync (framing error or byte gap),
                                  5 bad checksum, 6 bad opcode. `info` is the
                                  register address for drops.
  STATUS 55 fr1 fr0 evq wrq drops errs flags
                                  flags bit3..0: {resync, late, wrq_ovf, evq_ovf}

THE CONTRACT (mirrors rtl-sketch/uart_bridge.v; the bench checks the RTL
against THIS module, and the host refuses to schedule what the contract
cannot deliver):

  * accepted commands are ordered: within each queue, FIFO, never reordered;
  * per frame the device executes at most WRITE_SLOTS = 2 register writes for
    the UART path (the two cycles after the SPI drain window -- the SPI link
    keeps priority by construction), due-scheduled first, then live writes;
  * a scheduled event accepted with due >= accept_frame + 1 lands in EXACTLY
    its due frame (the deadline the SPI host could only predict);
  * a live write applies at accept_frame + 1, +-1 on real hardware from
    link-phase quantisation -- the live path has no deadline to keep;
  * both queues have published depths (EVENT_QUEUE = 64, WRITE_QUEUE = 8).
    Overflow drops the arriving packet, is counted, and is REPORTED on the
    device TX -- never silent;
  * a note-off is a live write: it is never blocked by a full event queue,
    and if it is ever dropped the ERR packet names its register address;
  * reset (BTN0 or clock unlock) clears both queues and counters. A queued
    phrase dies with the reset BY CONSTRUCTION (the queue is RAM behind the
    reset); the host detects it: status after reset shows an empty queue and
    a frame counter that did not advance as scheduled;
  * timestamps are 16-bit frames, wrap-safe within +-32768 frames (1.37 s
    modulo window). `plan()` refuses anything wider.

FLOW CONTROL (the contract this module implements and the preflight enforces):

  The device's event queue is 64 deep and the wire delivers one event packet
  per `budget()["frames_per_event_packet"]` frames. A phrase the queue cannot
  hold in flight is a phrase the device will DROP, and a dropped event is
  music that silently does not happen. The host's answer, in order of
  preference:

  1. PRELOAD: if the whole phrase's peak in-flight demand (deterministically
     computed by `preflight()` from the plan's ideal acceptance times) fits
     the queue, send it all; the device fires each event at its own due.
  2. WATERMARK BATCHING: otherwise the host must hold packets back, polling
     STATUS (the device's own evq count, ACK/ERR codes) until the queue
     drains below the watermark before sending more. That works only if the
     wire's sustained event rate meets the fixture's due rate; if it does
     not, the fixture is REFUSED with the exact packet index and reason.
  3. REFUSE: the host never relies on the device dropping packets, and never
     silently re-times a fixture to fit the wire. `preflight()` is the gate;
     REFUSED exits 2 with the packet index, the queue peak and the bandwidth
     numbers.

`DeviceClock`/`plan()` are the timing model. They are derived from the device
contract above -- NOT from USB sleeps -- and `--dry-run` prints exactly what
would go down the wire and when it would land, before any hardware is opened.

REFUSAL is a first-class outcome: no pyserial, no port, no status answer, or a
schedule the contract cannot deliver -- all exit 2 with the reason, and never
fall through to a best-effort attempt.
"""
from __future__ import annotations

import argparse
import json
import os
import sys
import time
from dataclasses import dataclass, field
from fractions import Fraction
from pathlib import Path

HERE = os.path.dirname(os.path.abspath(__file__))
ROOT = os.path.dirname(HERE)
for _p in ("model", "audition"):
    _q = os.path.join(ROOT, _p)
    if _q not in sys.path:
        sys.path.insert(0, _q)

# ---- the device contract (mirror of rtl-sketch/uart_bridge.v) ---------------
CLK_HZ = 12_288_000
CYC_PER_FRAME = 256
SR = 48_000
FRAME_S = Fraction(CYC_PER_FRAME, CLK_HZ)

DEFAULT_BAUD = 115_200
UART_DATA_BITS = 8                 # 8N1: start + 8 data (LSB first) + stop

# ---- the image this CLI drives, and so the drum kit it sends ------------------
# The kit is a property of the IMAGE on the board, not of the tree the CLI runs
# from. The published R0 image (fpga/release, integrated-baseline-2025.1) is
# contract revision 11 RTL: no ENV_FRATE, no final strike. Revision 14's
# `kit_808()` programs a clap that image cannot play, so the default -- the
# image a player actually has -- sends revision 11's frozen kit, and a board
# built from this tree is named explicitly (`--image tree`).
#
# `r1` (#323, plan092 section 2) is the NAMED, FROZEN R1 player release: the
# published R1 image (fpga/release/r1-2025.1.json). It sends R1's kit frozen by
# value (fpga/release/r1-kit.json, checked against its digest), so later work
# on the tree's kit cannot change what an R1 board is sent. `tree` stays the
# development selector: whatever this tree builds. `release` and no --image
# stay R0 (plan092: the public default does not flip).
#
# `r2` (fpga/release/R2.md) is the NAMED R2 image: OSC2X=1 FILTER2X=1
# PULSE2X=1 with the R2 RTL changes. Its drum RTL and contract revision are
# R1's (14 -- not the tree's, which moved to 15 with #388), and it has no
# preset or kit change, so it is sent R1's kit frozen by value and R1's
# known-state start: its bytes equal `r1`'s, command for command (fpga/test_named_r2.py). What differs is the image on the board and
# the qualified domain (qualified_domain.PULSE2X_IMAGES admits PULSE2X on r2).
# The host cannot read the image back, so the name is declared, not verified.
IMAGE_REVISION = {"release": 11, "tree": 15, "r1": 14, "r2": 14}
DEFAULT_IMAGE = "release"
# the images whose sessions start from the known state (voice + drum RESET)
KNOWN_STATE_IMAGES = ("tree", "r1", "r2")
# the images that are sent R1's frozen kit (uart_host.r1_kit)
R1_KIT_IMAGES = ("r1", "r2")
R1_KIT = Path(__file__).resolve().parent / "release/r1-kit.json"
R1_KIT_SHA256 = "321a93546cfa5ffab03b3cf91557580ea7655ada933ce380c81cd07597a9b683"


def r1_kit() -> list:
    """R1's kit as frozen by value; REFUSES (KitRefused) unless it hashes to
    R1_KIT_SHA256."""
    import json
    import drums_fx as dx
    rec = json.loads(R1_KIT.read_text())
    kit = [(int(a), int(v)) for a, v in rec["writes"]]
    got = dx._kit_sha256(kit)
    if got != R1_KIT_SHA256 or rec.get("sha256") != R1_KIT_SHA256:
        raise dx.KitRefused(f"{R1_KIT.name} hashes to {got[:12]}, not R1's frozen kit "
                            f"{R1_KIT_SHA256[:12]}")
    return kit


R1_PRESETS_SHA256 = "faca91bad851fbb2319de6e764a2608e442d0d2d7c6540d82d28ac75fa550146"
# the images that expose the five alternate sounds (#298): R0 (`release`) is
# qualified for its eleven stops only; `r2` has R1's drum RTL and is sent R1's
# frozen positions (fpga/release/R2.md)
ALTERNATE_IMAGES = ("tree", "r1", "r2")


def image_sound_presets(image: str) -> dict:
    """{sound: [(addr, value)]}: the writes that put each of the sixteen sounds'
    circuit in that sound's position, for `image` (#298). `r1` and `r2` read
    R1's table frozen by value (r1-kit.json, REFUSED unless it hashes to
    R1_PRESETS_SHA256; R2 has R1's drum RTL); `tree` is this tree's
    drums_fx.preset_writes; `release` has none (R0 is eleven sounds)."""
    import hashlib
    import json
    import drums_fx as dx
    if image in R1_KIT_IMAGES:
        rec = json.loads(R1_KIT.read_text())
        table = rec.get("presets") or {}
        canon = json.dumps(table, sort_keys=True, separators=(",", ":"))
        got = hashlib.sha256(canon.encode()).hexdigest()
        if got != R1_PRESETS_SHA256:
            raise dx.KitRefused(f"{R1_KIT.name} presets hash to {got[:12]}, not R1's frozen "
                                f"sound presets {R1_PRESETS_SHA256[:12]}")
        return {k: [(int(a), int(v)) for a, v in w] for k, w in table.items()}
    if image == "tree":
        return {k: [(int(a), int(v)) for a, v in dx.preset_writes(k)] for k in dx.SOUND_NAMES}
    return {}


def image_kit(image: str = DEFAULT_IMAGE) -> list:
    """The drum kit `image` plays. The frozen revision-11 kit (R0) and R1's
    frozen kit REFUSE (drums_fx.KitRefused) if they no longer hash to the image
    they were verified with; `tree` is this tree's kit_808()."""
    import drums_fx as dx
    if image not in IMAGE_REVISION:
        raise ValueError(f"image {image!r} is not one of {sorted(IMAGE_REVISION)}")
    if "WRONG_KIT" in INJECT_BUGS and image in KNOWN_STATE_IMAGES:
        # the control (#279, plan088): the release kit under `--image tree|r1`
        return dx.KITS_BY_REVISION[IMAGE_REVISION["release"]]()
    if image in R1_KIT_IMAGES:
        return r1_kit()
    return dx.KITS_BY_REVISION[IMAGE_REVISION[image]]()
BITS_PER_BYTE = 10

OP_WRITE = 0x57
OP_EVENT = 0x45
OP_STATUS = 0x51
OP_ABORT = 0x58
RSP_ACK = 0x06
RSP_ERR = 0x1C
RSP_STATUS = 0x55

ERR_WRQ_FULL = 1
ERR_EVQ_FULL = 2
ERR_DUE = 3
ERR_RESYNC = 4
ERR_CHECKSUM = 5
ERR_OPCODE = 6
ERR_NAMES = {1: "write-queue overflow", 2: "event-queue overflow",
             3: "due in the past or out of order", 4: "resync",
             5: "bad checksum", 6: "bad opcode"}

EVENT_QUEUE_DEPTH = 64
WRITE_QUEUE_DEPTH = 8
WRITE_SLOTS = 2                    # register-write slots the UART path gets per frame
WRAP_HALF = 32_768                 # 16-bit due arithmetic, wrap-safe window
MIN_LEAD_FRAMES = 2                # due must be >= accept_frame + MIN_LEAD at send time
PREFLIGHT_WATERMARK = 48           # batching threshold the preflight simulates
# Injected host defects (the Python side of the INJECT_BUG_* convention):
# fpga/verify_rolling_playback.py sets one and must turn red for its reason.
#   ROLL_QUEUE_UNAWARE  the window cut ignores earlier windows' queued events
#   ROLL_TAG_SPLIT      setup/performance split by tag (in-pattern accents
#                       and glides play at t=0) -- the defect the WIP had
#   ROLL_NO_UNWRAP      the roller reads each anchor as a signed distance
#                       from the first one: right for 0.68 s, then wrong
#   WATERMARK_PRELOAD   a watermark preflight verdict is sent as preload
#                       (the latent defect on main: nothing held back)
INJECT_BUGS: set = set()
ROLLING_HORIZON_FRAMES = WRAP_HALF - 2048   # a window's dues all sit within this
                                   # distance of ITS OWN anchor (~0.64 s): the
                                   # whole batch stays wrap-safe by construction
ROLLING_BATCH_CAP = 48             # events per window: the 64-event queue minus
                                   # in-flight margin, since a batch is accepted
                                   # far faster than its dues pass
ROLLING_QUEUE_MARGIN = 4           # queue slots never planned into: the
                                   # occupancy bound is computed at the
                                   # earliest acceptance, and a late STATUS
                                   # can only make the real queue emptier
ROLLING_START_FRAMES = 2400         # the phrase's musical t=0 lands this far
                                    # (50 ms) after the static image completes:
                                    # the first window accepts up to BATCH_CAP
                                    # packets (~2006 frames of wire at the
                                    # contract's 41.8 frames/packet), and its
                                    # earliest dues must trail that acceptance
ROLLING_PACKET_SLACK_FRAMES = 64    # per-packet safety in the window cut: the
                                    # contract needs due >= accept+1; this adds
                                    # a frame of STATUS slop per hop. It is NOT
                                    # PLAN_SLACK -- that margin is for planning
                                    # jitter inside one window, and requiring
                                    # it per packet would split every musical
                                    # cluster across dozens of windows
PLAN_SLACK_FRAMES = 500            # minimum due-minus-acceptance margin (~10 ms):
SEND_GATE_FRAMES = 120             # the send gate: send once the first due is at
                                   # least this far ahead of the verify STATUS
                                   # (2.5 ms -- beyond that we re-anchor, and a
                                   # saturated host may take a few rounds to get
                                   # there, but a schedule sent from a fresh
                                   # anchor is never a stale one)
                                   # covers USB/host arrival jitter. It is NOT
                                   # the anchor-to-send latency budget -- that is
                                   # re-anchored away by run()'s verify loop --
                                   # because for a phrase whose dues run 1 frame
                                   # apart, every frame of preload margin is a
                                   # queued event: margin and queue depth are
                                   # coupled, and the preflight holds both.


class Refused(Exception):
    """A first-class outcome, distinct from pass and fail: the link, the
    device or the schedule cannot deliver this. main() prints the reason and
    exits 2; it never falls through to a best-effort attempt."""
    pass


def checksum(payload: bytes) -> int:
    return (-sum(payload)) & 0xFF


def reg_frame(flag: int, sec: int, addr: int, data: int) -> bytes:
    """The SPI framing's six bytes, MSB first: {F, 6'b0, SEC, A[7:0], D[31:0]}."""
    word = (((flag & 1) << 47) | ((sec & 1) << 40)
            | ((addr & 0xFF) << 32) | (data & 0xFFFFFFFF))
    return word.to_bytes(6, "big")


def decode_reg_frame(b: bytes) -> tuple:
    if len(b) != 6:
        raise ValueError("register frame must be 6 bytes")
    word = int.from_bytes(b, "big")
    if (word >> 41) & 0x3F:
        raise ValueError(f"reserved bits set in {word:012x}")
    return ((word >> 47) & 1, (word >> 40) & 1, (word >> 32) & 0xFF, word & 0xFFFFFFFF)


def pkt_write(flag: int, sec: int, addr: int, data: int) -> bytes:
    body = bytes([OP_WRITE]) + reg_frame(flag, sec, addr, data)
    return body + bytes([checksum(body)])


def pkt_event(due: int, flag: int, sec: int, addr: int, data: int) -> bytes:
    if not 0 <= due <= 0xFFFF:
        raise ValueError("due must be a 16-bit frame index")
    body = bytes([OP_EVENT, due & 0xFF, (due >> 8) & 0xFF]) + reg_frame(flag, sec, addr, data)
    return body + bytes([checksum(body)])


def pkt_status() -> bytes:
    body = bytes([OP_STATUS])
    return body + bytes([checksum(body)])


def pkt_abort() -> bytes:
    body = bytes([OP_ABORT])
    return body + bytes([checksum(body)])


# ---- parsing the device's TX stream -----------------------------------------
@dataclass
class DevicePacket:
    kind: str                       # "ack" | "err" | "status" | "boot"
    seq: int = -1
    code: int = -1
    info: int = -1
    frame: int = -1
    evq: int = -1
    wrq: int = -1
    drops: int = -1
    errs: int = -1
    flags: int = -1

    def describe(self) -> str:
        if self.kind == "ack":
            return f"ACK seq {self.seq}"
        if self.kind == "err":
            return (f"ERR {ERR_NAMES.get(self.code, self.code)} (code {self.code})"
                    f" seq {self.seq} info 0x{self.info:02x}")
        if self.kind == "boot":
            return "BOOT 0xA5 (device left reset)"
        return (f"STATUS frame {self.frame} evq {self.evq} wrq {self.wrq}"
                f" drops {self.drops} errs {self.errs} flags 0x{self.flags:02x}")


def scan_packets(buf: bytes) -> tuple:
    """Resynchronising scan for BOOT/ACK/ERR/STATUS packets, with consumption:
    returns (packets, consumed) where `consumed` is the offset just past the
    last COMPLETE packet. An incomplete tail stays buffered, so a caller that
    drops `buf[:consumed]` can never serve a stale reply twice. BOOT (0xA5,
    one byte at reset release) is how a host SEES a device reset on the wire
    rather than inferring it."""
    out, i, consumed = [], 0, 0
    while i < len(buf):
        b = buf[i]
        if b == RSP_ACK and i + 1 < len(buf):
            out.append(DevicePacket("ack", seq=buf[i + 1])); i += 2; consumed = i
        elif b == RSP_ERR and i + 3 < len(buf):
            out.append(DevicePacket("err", code=buf[i + 1], seq=buf[i + 2],
                                    info=buf[i + 3])); i += 4; consumed = i
        elif b == RSP_STATUS and i + 7 < len(buf):
            out.append(DevicePacket("status", frame=(buf[i + 1] << 8) | buf[i + 2],
                                    evq=buf[i + 3], wrq=buf[i + 4], drops=buf[i + 5],
                                    errs=buf[i + 6], flags=buf[i + 7])); i += 8; consumed = i
        elif b == 0xA5:
            out.append(DevicePacket("boot")); i += 1; consumed = i
        else:
            i += 1
    return out, consumed


def parse_device_stream(buf: bytes) -> list:
    """The whole-buffer scan, for benches and logs: every parseable packet
    from the first valid header on. The live link uses `scan_packets`, which
    also says how many bytes it consumed."""
    return scan_packets(buf)[0]


# ---- the timing model: THE DEVICE CONTRACT, AS CODE -------------------------
@dataclass
class Placed:
    """One host packet, planned. Cycles are device core cycles from the origin
    the plan was anchored to; `apply_frame` is the frame the write applies in."""
    index: int
    kind: str                       # "write" | "event" | "status" | "abort"
    packet: bytes
    send_frame: int                 # frame boundary the first byte leaves at
    end_cycle: int                  # last byte's stop bit done (device cycles)
    accept_frame: int = -1          # frame the packet is accepted (push) in
    due: int = -1                   # scheduled events
    apply_frame: int = -1           # live writes: accept + 1
    note: str = ""


def byte_cycles(baud: int) -> int:
    """Device cycles per byte, as the receiver counts them: 10 bit times at
    ceil(CLK_HZ/baud). The wire's nominal rate differs by <1 %; the receiver
    re-synchronises at every start bit, so the difference never accumulates."""
    div = (CLK_HZ + baud // 2) // baud
    return BITS_PER_BYTE * div


def plan(commands: list, *, baud: int = DEFAULT_BAUD, start_frame: int = 0,
         anchor_frame: int = 0) -> list:
    """Lay packets on the wire against the device contract.

    commands: ("write", flag, sec, addr, data) | ("event", due, flag, sec, addr, data)
              | ("status",) | ("abort",) | ("wait", frames), executed in order.
              ("wait", n) sends nothing; it holds the wire idle for n frames,
              which is how a phrase's inner timing is expressed -- the DEVICE
              still fires every event at its own due frame.

    An event's `due` is RELATIVE TO THE ANCHOR (a performance whose anchor is
    device frame N and whose first phrase due is 0 fires that event N frames
    into the performance). This is deliberate: a fixture's dues are 0-based
    musical frames, and a 16-bit due interpreted against the device's
    free-running counter instead of the anchor silently means "the next
    wrap" -- a schedule the device queues for 30 000 frames and overflows.
    Absolute frames in the result are anchor + relative; the packet carries
    the low 16 bits, and every check below runs in ABSOLUTE arithmetic, where
    "30 000 frames behind" cannot masquerade as "30 000 frames ahead".

    Each packet starts at the first frame boundary at or after the previous
    packet's end, so the acceptance instant sits mid-frame by
    construction. `plan` REFUSES (raises ValueError) when the schedule asks
    the contract for something it does not deliver: a due inside the
    +-32768-frame wrap window of the anchor, a due that has already passed at
    upload speed, or dues out of order.

    `anchor_frame` is the device frame that `start_frame` names (from a STATUS
    query). Frames in the result are device frames; the caller subtracts the
    anchor to get relative time.
    """
    if baud <= 0 or CLK_HZ // baud < 16:
        raise ValueError(f"baud {baud} unsupported: need CLK_HZ/baud >= 16")
    cyc_per_byte = byte_cycles(baud)
    placed, t = [], start_frame * CYC_PER_FRAME
    last_apply = -1
    last_due = None
    for index, cmd in enumerate(commands):
        kind = cmd[0]
        if kind == "wait":
            t += max(0, int(cmd[1])) * CYC_PER_FRAME
            continue
        if kind == "write":
            packet = pkt_write(*cmd[1:5])
        elif kind == "event":
            # the wire carries the low 16 bits of anchor+due; checks below
            # use the absolute value
            packet = pkt_event((anchor_frame + cmd[1]) & 0xFFFF, *cmd[2:6])
        elif kind == "status":
            packet = pkt_status()
        elif kind == "abort":
            packet = pkt_abort()
        elif kind == "raw":
            packet = bytes(cmd[1])          # a deliberately damaged packet
        else:
            raise ValueError(f"unknown command kind {kind!r}")
        # first frame boundary at or after the previous packet's end
        end_prev = t
        send_frame = -(-end_prev // CYC_PER_FRAME)
        t = send_frame * CYC_PER_FRAME
        nbytes = len(packet)
        t_end = t + nbytes * cyc_per_byte
        # acceptance: stop-bit centre of the last byte, plus receiver sync
        div = (CLK_HZ + baud // 2) // baud
        push = t + (nbytes - 1) * cyc_per_byte + 4 + 9 * div + div // 2
        accept = push // CYC_PER_FRAME
        row = Placed(index=index, kind=kind, packet=packet,
                     send_frame=anchor_frame + send_frame,
                     end_cycle=anchor_frame * CYC_PER_FRAME + t_end,
                     accept_frame=anchor_frame + accept)
        if kind == "write":
            row.apply_frame = anchor_frame + accept + 1
            last_apply = max(last_apply, row.apply_frame)
        elif kind == "event":
            # absolute due: anchor + relative; the mask above only built the
            # wire packet. Signed distance, no mod -- a due the device would
            # queue past the wrap window is refused, not interpreted as
            # "30155 frames ahead".
            due = anchor_frame + cmd[1]
            rel = due - (anchor_frame + accept)
            if rel < 1:
                raise ValueError(f"event {index}: due {cmd[1]} (+anchor "
                                 f"{anchor_frame}) is at or before its "
                                 f"acceptance frame {anchor_frame + accept}")
            if rel > WRAP_HALF - 1 - (t_end - t) // CYC_PER_FRAME:
                raise ValueError(f"event {index}: due {cmd[1]} (+anchor "
                                 f"{anchor_frame}) is inside the wrap guard")
            if last_due is not None and kind == "event":
                if due <= last_due:
                    raise ValueError(f"event {index}: due {cmd[1]} (+anchor "
                                     f"{anchor_frame}) is not strictly "
                                     f"after the previous due {last_due}")
            last_due = due
            row.due = due
            row.apply_frame = due
        placed.append(row)
        t = t_end
    return placed


# ---- the musical front end --------------------------------------------------
def voice_image_writes(preset: str | None = None) -> list:
    """The boot image as (flag, sec, addr, data) writes, in send order.

    The same named presets `fpga/play.py --preset` accepts, through the same
    register conversion -- this module decides DELIVERY, never values."""
    import spi_host as sh
    import synth_top_model as stm
    import voice_fx as vf
    import drums_fx as dx
    import selected_preset
    regs = (selected_preset.definition(preset)["registers"] if preset
            else vf.VoiceFx.patch_regs())
    wave_code = dict(vf.WAVE_CODE)
    w = []
    for k, s in enumerate(regs["waves"]):
        w.append((0, sh.SEC_VOICE, stm.A_WAVE + k, wave_code[s]))
    for base, key in ((stm.A_AMP, "amp"), (stm.A_FILT, "fenv")):
        for j, v in enumerate(regs[key]):
            w.append((0, sh.SEC_VOICE, base + j, v))
    for addr, key in ((stm.A_CUT_LO, "cut_lo"), (stm.A_CUT_HI, "cut_hi"),
                      (stm.A_K, "k"), (stm.A_GAIN, "gain"), (stm.A_OGAIN, "ogain"),
                      (stm.A_GLIDE, "glide"), (stm.A_VOL, "vol")):
        w.append((0, sh.SEC_VOICE, addr, regs[key]))
    w.append((0, sh.SEC_VOICE, stm.A_DVOL, dx.accent_reg(0.45)))
    w.append((0, sh.SEC_VOICE, stm.A_BVOL, dx.accent_reg(0.45)))
    return w


def preset_regs(preset: str | None = None) -> dict:
    """The control image a named preset (or the default patch) programs."""
    import voice_fx as vf
    import selected_preset
    return (selected_preset.definition(preset)["registers"] if preset
            else vf.VoiceFx.patch_regs())


def voice_mixer_writes(preset: str | None = None) -> list:
    """The rest of the voice image `voice_image_writes` does not carry: the
    four mixer weights (as `MusicHost.load` writes them) and the noise/
    modulation registers. Without the weights a note-only run is SILENT --
    every weight resets to 0 -- which is what `run --note 45 --fixture none`
    played until the release validator (fpga/release/qualified_domain.py)
    refused it. Sent only when no fixture image follows (a fixture's own
    load() writes its weights), so every fixture's byte stream is unchanged."""
    import spi_host as sh
    import synth_top_model as stm
    regs = preset_regs(preset)
    w = [(0, sh.SEC_VOICE, stm.A_W + k, int(g)) for k, g in enumerate(regs["weights"])]
    for addr, key in ((stm.A_NSEL, "nsel"), (stm.A_MROUTE, "mroute"), (stm.A_MMIX, "mmix"),
                      (stm.A_MWHEEL, "mwheel"), (stm.A_MPD, "mpd"), (stm.A_MFD, "mfd")):
        w.append((0, sh.SEC_VOICE, addr, int(regs.get(key, 0))))
    return w


def apply_order(commands: list) -> list:
    """The (flag, sec, addr, data) writes of a command list in the order the
    device APPLIES them: live writes in order, the scheduled gate-off, then
    events by due (stable). What the release validator checks."""
    live = [c[1:] for c in commands if c[0] in ("write", "gate-off")]
    ev = sorted((c for c in commands if c[0] == "event"), key=lambda c: c[1])
    return live + [c[2:] for c in ev]


def qualify(commands: list, *, preset: str | None, note: int | None,
            image_sent: bool, image: str = DEFAULT_IMAGE) -> dict:
    """The player-facing release domain (fpga/release/RELEASE.md), enforced
    on the final register writes. Raises qualified_domain.Rejected."""
    sys.path.insert(0, os.path.join(ROOT, "fpga", "release"))
    import qualified_domain as qd
    regs = preset_regs(preset)
    out = {}
    if image_sent:
        out["patch"] = qd.check_patch(regs, name=preset or "default")
    if note is not None:
        qd.check_note(note, regs)
    # device state before this command is not readable: everything the
    # stream does not write is unknown, except the modulation registers the
    # player path never writes on a fixture run (declared precondition)
    out["stream"] = qd.check_stream(apply_order(commands), initial="unknown",
                                    mod_initial="reset", image=image)
    return out


def known_state_preamble() -> list:
    """R1's session start: voice RESET (0x23), drum RESET (0xFF), as
    (flag, sec, addr, data). Owned by fpga/release/r1_candidate.py."""
    sys.path.insert(0, os.path.join(ROOT, "fpga", "release"))
    import r1_candidate
    return [tuple(w) for w in r1_candidate.PREAMBLE]


def note_writes(note: int, on: bool, *, preset_regs: dict | None = None,
                held: bool = False) -> list:
    """One key event through the model's own KeyHost (contract 5.6): pitch
    increments, note track and the gate. `held` says a key is already down, so
    a note-off of the last key is GATE_OFF and a note-on while held is TRIG.

    An OFF is stateless by construction -- this host is a command line, it
    does not know which keys are down -- so an off ALWAYS means "release what
    is sounding": the gate-off write. A gate-off addressed to a silent voice
    is a no-op on the device; a gate-off that is not sent is a note that
    never ends. The second failure is the one that matters."""
    import voice_fx as vf
    import synth_top_model as stm
    import spi_host as sh
    if not on:
        return [(0, sh.SEC_VOICE, stm.A_GATE_OFF, 0)]
    regs = preset_regs or vf.VoiceFx.patch_regs()
    events = [(0, "on", note)] + ([(1, "off", 45)] if held else [])
    out = vf.KeyHost().writes(events, regs, first_from_reset=not held)
    writes = []
    for f, op, *args in out:
        if op == "INC":
            k, v, jump = args
            writes.append((1 if jump else 0, sh.SEC_VOICE, stm.A_INC + k, v))
        elif op == "TRACK":
            writes.append((0, sh.SEC_VOICE, stm.A_TRACK, args[0]))
        elif op == "GATE":
            writes.append((0, sh.SEC_VOICE, stm.A_GATE_ON if args[0] else stm.A_GATE_OFF, 0))
    return writes


def fixture_split(fixture: str, image: str = DEFAULT_IMAGE) -> tuple:
    """(static, timed, n_frames, host): a scripted fixture's writes, spread
    by the link's own rules, split into the configuration image its
    `MusicHost.load()` emitted and everything after it. The split is by
    POSITION (`load_span`), never by tag: a hit writes an "accent" and a
    key writes a "glide" too, and treating those as setup would play every
    accent of the pattern at t=0 and none on its step. The kit in the load
    image is the one `image` plays (`image_kit`)."""
    import fixtures
    import spi_host as sh
    host, n_frames, _cover = fixtures.FIXTURES[fixture](kit=image_kit(image))
    if host.load_span is None:
        raise ValueError(f"fixture {fixture!r} has no load(): nothing to "
                         "deliver as static configuration")
    first, end, load_frame = host.load_span
    load_ids = {id(w) for w in host.w[first:end]}
    if "ROLL_TAG_SPLIT" in INJECT_BUGS:
        tags = {w.tag for w in host.w[first:end]}
        load_ids = {id(w) for w in host.w if w.tag in tags}
    raw = sorted(host.w, key=lambda w: w.frame)      # stable: load order kept
    # a timed write at or before the load frame would be ambiguous: it is
    # music scheduled into the setup. Refuse rather than guess.
    early = [w for w in raw if id(w) not in load_ids and w.frame <= load_frame]
    if "ROLL_TAG_SPLIT" in INJECT_BUGS:
        early = []
    if early:
        raise ValueError(f"fixture {fixture!r} schedules {len(early)} timed "
                         f"writes at or before its load frame {load_frame}")
    is_load = [id(w) in load_ids for w in raw]
    ws = sh.feasible(raw, sh.LinkTiming.contract_max())    # 1:1, order kept
    static = [w for w, s in zip(ws, is_load) if s]
    timed = [w for w, s in zip(ws, is_load) if not s]
    return static, timed, n_frames, host


def phrase_static_and_events(fixture: str, image: str = DEFAULT_IMAGE) -> tuple:
    """A scripted phrase SPLIT the way the link delivers it: the fixture's
    configuration image (`MusicHost.load()`: patch, kit, initial accents)
    as live writes carrying no due, and everything after it (keys, hits,
    their accents, knobs, the timed coefficient sequences) as scheduled
    events at their frames.

    The split is not a convenience: the load image is 224 writes due at
    musical t=0, and the UART wire delivers one event packet per 41.8
    frames at 115200 -- a due'd load image would die under the wire no
    matter how the phrase rolled. As live writes it applies ahead of the
    music, which starts ROLLING_START_FRAMES after the image completes."""
    static, timed, n_frames, _host = fixture_split(fixture, image)
    st = [(w.flag, w.sec, w.addr, w.data & 0xFFFFFFFF) for w in static]
    ev = [(w.frame, w.flag, w.sec, w.addr, w.data & 0xFFFFFFFF) for w in timed]
    end = (max(d for d, *_ in ev) + 64) if ev else n_frames
    return st, ev, end


def phrase_events(fixture: str, image: str = DEFAULT_IMAGE) -> tuple:
    """A scripted phrase as scheduled events: (due, flag, sec, addr, data),
    reusing the existing fixtures and the link's own spreading rules. Dues are
    >= 1 frame apart, which the device's two write slots deliver exactly.

    bar808 is the full musical fixture (its preflight verdict is REFUSED --
    peak demand 189 against a queue of 64 at 115200 baud, so it exists here
    as the documented over-budget case, not as a default); `m5a` is the
    short scripted M5A phrase the UART bench (fpga/verify_uart_bridge.py
    scenario `phrase`) already proves feasible end to end. Whether a fixture
    ACTUALLY fits the queue and the wire is `preflight()`'s verdict, not
    this function's claim. Callers NAME the fixture; there is no default,
    because the last default here was the refused one.
    """
    if fixture == "m5a":
        return _phrase_events_m5a()
    import fixtures
    import spi_host as sh
    host, n_frames, _cover = fixtures.FIXTURES[fixture](kit=image_kit(image))
    link = sh.LinkTiming.contract_max()
    step = link.min_land_gap()
    ws = sh.feasible(sorted(host.w, key=lambda w: w.frame), link)
    out, prev = [], None
    for w in ws:
        due = w.frame if prev is None else max(w.frame, prev + 1)
        out.append((due, w.flag, w.sec, w.addr, w.data & 0xFFFFFFFF))
        prev = due
    return out, max(d for d, *_ in out) + 64


def _phrase_events_m5a() -> tuple:
    """The short M5A smoke phrase, as scheduled events. The same rendering the
    RTL bench's `phrase` scenario runs, so the CLI and the bench exercise one
    fixture -- and the bench's clean run is the evidence the CLI's phrase is
    bit-exact against the integer model.

    Dues are spread to the UART link's own event pacing (one 10-byte event
    packet per wire round-up of the packet time). The SPI reference spread its
    writes the same way through `feasible()` at the SPI budget; the smoke
    fixture's claim -- register schedule and bit-exact audio -- is invariant
    to that pacing, and the schedule the model is driven with is exactly the
    schedule the device fires. (bar808's tempo, by contrast, is load-bearing:
    that fixture is REFUSED rather than stretched.)"""
    gap = -(-10 * byte_cycles(DEFAULT_BAUD) // CYC_PER_FRAME)   # one event packet
    rtl = os.path.join(ROOT, "rtl-sketch")
    if rtl not in sys.path:
        sys.path.insert(0, rtl)
    import verify_synth_top as top
    cmds, tail, _info = top.m5a_script(
        str(os.path.join(ROOT, "docs/scorecard/mono-m5a-miniv3/manifest.json")),
        smoke=True, saw_cutoff_hz=20000, saw_volume_correction_db=-0.45428)
    f, prev, out = 0, None, []
    for wait, flag, sec, addr, data in cmds:
        f += wait
        due = f if prev is None else max(f, prev + gap)
        out.append((due, flag, sec, addr, data & 0xFFFFFFFF))
        prev = due
        f += 1
    return out, prev + 64


# ---- the tool ---------------------------------------------------------------
def _require_serial():
    try:
        import serial                          # noqa: F401
    except ImportError:
        print("uart_host: REFUSED -- pyserial is required for hardware and is not "
              "installed. Run `.venv/bin/pip install pyserial` (see README). "
              "--dry-run works without it.", file=sys.stderr)
        raise SystemExit(2)


class Bridge:
    """The open link. REFUSES rather than guessing: no port, no answer, no play.

    STATE the apparatus asserts, in one place: `origin` is the device frame
    the anchoring STATUS named, `lead_frames` is the send lead measured from
    THIS link's own STATUS round trip (a constant two-frame lead is no
    protection against USB/host delay), and every STATUS answer is read as
    the framed 8-byte packet it is, consumed from the buffer, so a stale
    snapshot can never be served twice."""

    def __init__(self, port: str, baud: int = DEFAULT_BAUD, timeout: float = 2.0):
        _require_serial()
        import serial
        try:
            self.ser = serial.Serial(port, baud, timeout=timeout)
        except (OSError, serial.SerialException) as exc:
            print(f"uart_host: REFUSED -- cannot open {port}: {exc}", file=sys.stderr)
            raise SystemExit(2)
        self._init_state(baud, time)

    @classmethod
    def on_serial(cls, ser, baud: int = DEFAULT_BAUD, clock=None) -> "Bridge":
        """A Bridge on an already-open endpoint and an injected clock: the
        seam deterministic tests use (uart_device_sim.SimSerial/SimClock).
        Every method is the production one; only transport and time differ."""
        self = cls.__new__(cls)
        self.ser = ser
        self._init_state(baud, clock if clock is not None else time)
        return self

    def _init_state(self, baud: int, clock) -> None:
        self.clock = clock                # anything with monotonic()/sleep()
        self.baud = baud
        self.buf = b""
        self.origin = None
        self.performance_origin = None   # device frame of a rolled phrase's t=0
        self.boots_seen = 0              # BOOT packets: the device reset
        self.device_errors: list = []    # (code, info) of every ERR packet read
        self.lead_frames = None
        self.status_round_trip_s = None
        self.acks_seen = 0
        self._run_ack_base = 0
        self._run_acks_expected = 0
        # R1 (#279): refuse to start over events or writes an earlier session
        # left queued -- they would fire into this one after its known state
        self.require_idle = False
        self._idle_checked = False

    def _take(self, kinds: set, deadline: float) -> DevicePacket | None:
        """Read bytes until one complete packet of `kinds` parses. The buffer
        is consumed only up to the last complete packet, so partial reads are
        retried and stale replies are never re-served."""
        while True:
            pkts, consumed = scan_packets(self.buf)
            self.buf = self.buf[consumed:]
            # every consumed packet is a delivery and is counted BEFORE the
            # first match returns: returning mid-scan dropped the rest of the
            # chunk from the counts, so a burst whose ACKs arrived four to a
            # read counted one in four (#281: 48 of 190 on a real-time pty;
            # SimSerial delivers one ACK per read and could not show it)
            match = None
            for p in pkts:
                if p.kind == "ack":
                    self.acks_seen += 1
                elif p.kind == "boot":
                    self.boots_seen += 1
                elif p.kind == "err":
                    self.device_errors.append((p.code, p.info))
                if match is None and p.kind in kinds:
                    match = p
            if match is not None:
                return match
            now = self.clock.monotonic()
            if now >= deadline:
                return None
            self.ser.timeout = min(0.05, max(0.005, deadline - now))
            chunk = self.ser.read(8)          # a STATUS packet is 8 bytes
            if chunk:
                self.buf += chunk

    def send(self, rows: list, *, paced: bool = True) -> None:
        """Write the plan to the wire, preserving its timing semantics.

        Contiguous packets -- each one the natural continuation of the
        previous packet's last byte -- go as one serial write: the WIRE paces
        them at exactly the spacing the plan assumed, so timing is preserved
        byte for byte; per-packet write syscalls (each ~2-3 ms on USB/pty
        drivers) would NOT preserve it, and would push scheduled dues into
        the past. Where the plan says the wire must idle (an explicit wait
        item), the burst is split and the device's own frame -- polled by
        STATUS, never a host sleep -- must reach the next send window first.
        Application timing is the device's throughout: live writes apply at
        accept+1, events at their due."""
        bursts: list[list] = []
        prev_end = None
        for row in rows:
            natural = None if prev_end is None else -(-prev_end // CYC_PER_FRAME)
            contiguous = (prev_end is not None
                          and row.send_frame <= (natural or 0))
            if bursts and contiguous:
                bursts[-1].append(row)
            else:
                bursts.append([row])
            prev_end = row.end_cycle
        for i, burst in enumerate(bursts):
            if i > 0 and paced:
                window = burst[0].send_frame - MIN_LEAD_FRAMES
                self.wait_until(window)
            self.ser.write(b"".join(r.packet for r in burst))
        self.ser.flush()

    def status(self, attempts: int = 3, timeout_s: float = 2.0) -> DevicePacket:
        """One STATUS question, one fresh answer, framed. The round trip is
        measured and carried in `status_round_trip_s` for the plan's lead."""
        for _ in range(attempts):
            # a fresh question deserves a fresh answer -- but packets already
            # in the buffer are still deliveries: count them before the discard
            for p, _n in [scan_packets(self.buf)]:
                self.acks_seen += sum(1 for q in p if q.kind == "ack")
                self.boots_seen += sum(1 for q in p if q.kind == "boot")
                self.device_errors += [(q.code, q.info) for q in p if q.kind == "err"]
            self.buf = b""
            t0 = self.clock.monotonic()
            self.send([Placed(0, "status", pkt_status(), 0, 0)], paced=False)
            pkt = self._take({"status"}, t0 + timeout_s)
            if pkt is not None:
                self.status_round_trip_s = self.clock.monotonic() - t0
                return pkt
        print("uart_host: REFUSED -- no STATUS reply from the device; check the "
              "bitstream, wiring (A9/D10) and baud", file=sys.stderr)
        raise SystemExit(2)

    def assert_idle(self) -> None:
        """One STATUS before anything is sent: both device queues must be
        empty, or the session start is not a known state. REFUSES."""
        st = self.status()
        self._idle_checked = True
        if st.evq or st.wrq:
            raise Refused(f"the device holds {st.evq} queued events and {st.wrq} queued "
                          "writes from an earlier session; they would play into this one. "
                          "Run `uart_host.py --port ... abort` (or press BTN0) and retry")

    def run(self, commands: list, *, dry_run: bool = False, baud: int = DEFAULT_BAUD,
            quiet: bool = False, hold_frames: int = 0) -> list:
        """Origin FIRST, then the plan: the schedule is anchored to the
        device's own frame counter and the origin is applied EXACTLY ONCE
        (`start_frame` is relative to it). The plan is then preflighted; a
        fixture the queue and wire cannot deliver is REFUSED before the first
        packet leaves, with the packet index and the arithmetic.

        Because a real host takes real milliseconds to plan (and USB takes
        more to deliver), the anchor is VERIFIED before sending: a fresh
        STATUS must still leave slack before the first event's due, or the
        plan is re-anchored -- a plan whose dues died during planning is
        re-planned, never sent late."""
        if self.require_idle and not self._idle_checked:
            self.assert_idle()
        markers = [c for c in commands if c[0] == "gate-off"]
        if markers:
            return self._run_with_hold(commands, baud=baud, quiet=quiet,
                                       hold_frames=hold_frames)
        if rolling_needed(commands):
            # a phrase longer than one planning window: roll it. (A marker
            # path that also needs rolling is handled inside the hold.)
            return self.run_rolling(commands, baud=baud, quiet=quiet)
        self._run_ack_base = self.acks_seen
        rows = None
        ahead = 0
        planned = commands
        for _ in range(8):
            anchor = self.status()
            self.origin = origin = anchor.frame
            round_trip = self.status_round_trip_s or 0.0
            self.lead_frames = lead = (MIN_LEAD_FRAMES
                                       + int(round_trip * SR) + 1)
            rows = plan_show(planned, hold_frames=hold_frames, baud=baud,
                             start_frame=lead, anchor_frame=origin)
            if planned is commands:
                # the first plan: a schedule the queue and wire cannot carry
                # is refused NOW, for that reason -- not after the verify
                # loop has had a chance to fail first on host timing noise
                # (preflight is anchor-relative, so this verdict holds)
                early = preflight(rows, baud=baud)
                if early["verdict"] != "FEASIBLE":
                    raise Refused(early["reason"])
            dues = [r.due for r in rows if r.kind == "event"]
            if not dues:
                break
            now = self.status()
            ahead = (dues[0] - now.frame) & 0xFFFF
            if WRAP_HALF > ahead >= SEND_GATE_FRAMES:
                break               # the first due is comfortably ahead: send
            # planning + the STATUS round trips consumed part of the margin:
            # shift the dues by the deficit (spacing intact) and re-anchor,
            # so the schedule is re-established rather than sent late. The
            # deficit never goes negative: a wrapped `ahead` means the dues
            # are BEHIND the device by 65536-ahead frames, and the correction
            # must add that, not subtract.
            behind = 0 if ahead < WRAP_HALF else (1 << 16) - ahead
            # top up to the full plan margin, not just the send gate: a
            # top-up to the gate leaves the next verify hovering at the gate
            # and the loop coin-flipping against scheduling noise
            deficit = max(0, PLAN_SLACK_FRAMES - ahead) + behind
            planned = [c if c[0] != "event" else
                       ("event", c[1] + deficit, *c[2:]) for c in planned]
        else:
            raise Refused("the device's frame counter kept outrunning "
                          f"planning (last first-due margin {ahead} frames); "
                          "refusing to send a schedule whose dues are "
                          "already dying")
        verdict = preflight(rows, baud=baud)
        if verdict["verdict"] != "FEASIBLE":
            raise Refused(verdict["reason"])
        if dry_run:
            return rows
        if (verdict.get("mode") == "watermark"
                and "WATERMARK_PRELOAD" not in INJECT_BUGS):
            # preflight proved a HELD-BACK schedule lands every due; `send`
            # holds nothing back (it lays the plan down as preload), so a
            # watermark verdict sent that way overflows the queue -- 7 drops
            # on `run --note 45 --fixture bar808`. The roller is the sender
            # that bounds the queue against STATUS: deliver through it.
            return self.run_rolling(commands, baud=baud, quiet=quiet)
        self._run_acks_expected = len(rows)
        self.send(rows)
        if not quiet:
            for row in rows:
                print(f"  send f{row.send_frame:<6} {row.kind:<7} "
                      f"{row.packet.hex()} -> applies f{row.apply_frame}")
        return rows

    @staticmethod
    def _refuse_unreachable_hold(hold_frames: int, *, rtt_frames: int,
                                 lead: int, baud: int,
                                 anchor_frame: int) -> None:
        """Plan the gate-off alone against the REAL anchor (so an
        anchor-dependent guard would show here, not be hidden); a due plan()
        calls inside the wrap guard becomes Refused (exit 2), not a
        ValueError traceback."""
        probe = [("event", max(1, int(hold_frames) - rtt_frames), 0, 0, 0, 0)]
        try:
            plan_shifted(probe, baud=baud, start_frame=lead,
                         anchor_frame=anchor_frame)
        except ValueError as exc:
            raise Refused(f"hold_frames {hold_frames} cannot be delivered as "
                          f"one scheduled note-off: {exc}. The device reasons "
                          f"about dues within +-{WRAP_HALF} frames; use a "
                          f"shorter hold") from None

    def _run_with_hold(self, commands: list, *, baud: int, quiet: bool,
                       hold_frames: int) -> list:
        """A scheduled note-off anchors to the OBSERVED gate, not a
        prediction: the live writes go first, the gate-on's ACK is waited for
        (the device ACKs every accepted packet), a fresh STATUS names the
        frame the gate actually landed in, and only then is the gate-off
        event -- and the phrase behind it -- planned and sent. A hold
        measured from reality survives exactly the host/USB jitter that
        breaks a predicted schedule."""
        import synth_top_model as stm
        anchor = self.status()
        self.origin = origin = anchor.frame
        round_trip = self.status_round_trip_s or 0.0
        self.lead_frames = lead = (MIN_LEAD_FRAMES + int(round_trip * SR) + 1)
        # REFUSE an unreachable hold before the note-on leaves: a refusal
        # after it would leave a gate sounding (issue #458). The wrap guard
        # measures the due from its own acceptance frame, so this verdict is
        # a function of the hold and the lead, not of the free-running
        # counter's anchor -- re-anchoring and retrying cannot change it.
        if hold_frames > 0:
            self._refuse_unreachable_hold(
                hold_frames, rtt_frames=int(round_trip * SR),
                lead=MIN_LEAD_FRAMES + 1, baud=baud, anchor_frame=origin)
        mi = next(i for i, c in enumerate(commands) if c[0] == "gate-off")
        live_cmds, markers, rest = commands[:mi], commands[mi], commands[mi + 1:]
        rows_live = plan(live_cmds, baud=baud, start_frame=lead,
                         anchor_frame=origin)
        verdict = preflight(rows_live, baud=baud)
        if verdict["verdict"] != "FEASIBLE":
            raise Refused(verdict["reason"])
        acked_before = self.acks_seen
        self.send(rows_live)
        # the note-on's GATE_ON write is the last live packet: its ACK is the
        # gate landing, loud on the wire
        want = acked_before + len(live_cmds)
        deadline = self.clock.monotonic() + 10.0
        while self.acks_seen < want:
            if self.clock.monotonic() > deadline:
                raise Refused(f"the note-on's gate write was never ACKed "
                              f"({self.acks_seen - acked_before} of "
                              f"{len(live_cmds)} packets acknowledged)")
            # short sub-windows: the ACK that satisfies the count must not
            # leave the loop waiting out a long read deadline -- every extra
            # millisecond here is added to the musician's hold
            self._take({"status"}, min(deadline, self.clock.monotonic() + 0.02))
        # the gate's frame, sampled on the device's own timeline: one STATUS
        # right after the gate's ACK, minus that STATUS's own round trip
        fresh = self.status()
        rtt_frames = int((self.status_round_trip_s or 0.0) * SR)
        gate_frame = fresh.frame - rtt_frames
        if hold_frames <= 0:
            raise Refused(f"hold_frames {hold_frames} is not a hold")
        gate_off_due = gate_frame + int(hold_frames)
        origin2 = fresh.frame
        lead2 = MIN_LEAD_FRAMES + 1
        min_phrase = min((c[1] for c in rest), default=None)
        offset = 0
        if min_phrase is not None:
            offset = max(0, (gate_off_due + 1) - (origin2 + min_phrase))
        ev_cmds = [("event", gate_off_due - origin2, *markers[1:5])]
        ev_cmds += [("event", c[1] + offset, *c[2:]) for c in rest]
        rows = rows_live
        needs_flow = False
        if not rolling_needed(ev_cmds):
            # short enough for one window -- but can it PRELOAD? A watermark
            # verdict needs a sender that holds packets back (see run())
            probe = plan_shifted(ev_cmds, baud=baud, start_frame=lead2,
                                 anchor_frame=origin2)
            needs_flow = (preflight(rows_live + probe,
                                    baud=baud).get("mode") == "watermark"
                          and "WATERMARK_PRELOAD" not in INJECT_BUGS)
        if needs_flow or rolling_needed(ev_cmds):
            # the phrase behind the gate-off is a musical-length one: the
            # gate-off event is musical t=0 (it IS the hold's deadline), and
            # the rest rolls from there. Live rows are already counted; the
            # roller adds its own windows to the expected-ACK total.
            self._run_acks_expected = len(rows_live)
            ev_abs = [(origin2 + c[1], c) for c in ev_cmds]
            self.performance_origin = origin2 & 0xFFFF
            rows_ev = self._roll_events(ev_abs, baud=baud, quiet=quiet)
            rows += rows_ev
            if not quiet:
                for row in rows:
                    print(f"  send f{row.send_frame:<6} {row.kind:<7} "
                          f"{row.packet.hex()} -> applies f{row.apply_frame}")
            return rows
        try:
            rows_ev = plan_shifted(ev_cmds, baud=baud, start_frame=lead2,
                                   anchor_frame=origin2)
        except ValueError as exc:
            # backstop: the gate is already on, so say so
            raise Refused(f"the gate-off cannot be planned ({exc}); the "
                          "note-on was already sent -- run `abort`") from None
        rows = rows_live + rows_ev
        verdict = preflight(rows, baud=baud)
        if verdict["verdict"] != "FEASIBLE":
            raise Refused(verdict["reason"])
        self._run_acks_expected = len(rows)
        self.send(rows_ev)
        if not quiet:
            for row in rows:
                print(f"  send f{row.send_frame:<6} {row.kind:<7} "
                      f"{row.packet.hex()} -> applies f{row.apply_frame}")
        return rows

    # ---- rolling scheduling --------------------------------------------------
    #
    # A MUSICAL-length phrase (bar808-full, demo: four seconds, three counter
    # wraps) cannot be planned in one window: `plan` refuses any due beyond
    # the +-32768-frame horizon its anchor can reason about, and even if it
    # did not, 200+ events would overrun the 64-event queue. The phrase is
    # delivered in ROLLING WINDOWS instead: static initialization first (the
    # patch image and note-on are live writes -- no dues, no horizon), then
    # successive batches of scheduled events, each planned against a FRESH
    # STATUS anchor with every due inside one wrap-safe horizon, each
    # preflighted against the queue and the wire before its first packet
    # leaves. The device is unchanged: its queue fires each event at its own
    # due; the host merely keeps the queue topped up. The wire needs one
    # event packet per ~500 frames at musical tempo and delivers one per
    # 41.8 -- the existing baud is not the constraint, the queue is, and the
    # batch cap leaves it margin.

    def run_rolling(self, commands: list, *, baud: int = DEFAULT_BAUD,
                    quiet: bool = False) -> list:
        """Deliver a phrase too long for one planning window.

        Static initialization goes first through the ordinary planned path
        (live writes: no dues, no horizon). The timed events then roll via
        `_roll_events`, each batch planned from a FRESH STATUS anchor with
        every due inside one wrap-safe horizon and preflighted against the
        queue and the wire before its first packet leaves. The performance's
        musical t=0 lands ROLLING_START_FRAMES after the static image
        completes."""
        static = [c for c in commands if c[0] != "event"]
        events = [c for c in commands if c[0] == "event"]
        static_rows = self.run(static, baud=baud, quiet=True)
        if not events:
            return static_rows
        anchor = self.status()
        origin = anchor.frame
        lead = MIN_LEAD_FRAMES + int((self.status_round_trip_s or 0.0) * SR) + 1
        p0 = origin + lead + ROLLING_START_FRAMES   # musical t=0 on the device
        self.performance_origin = p0 & 0xFFFF       # recorded for replay checks
        ev_rows = self._roll_events([(p0 + c[1], c) for c in events],
                                    baud=baud, quiet=quiet)
        return static_rows + ev_rows

    def _roll_events(self, ev_abs: list, *, baud: int = DEFAULT_BAUD,
                     quiet: bool = False) -> list:
        """The window loop, shared by the plain and the hold paths.

        `ev_abs` is [(absolute_due, ("event", due_rel, flag, sec, addr,
        data)), ...] in due order, on an UNWRAPPED timeline whose zero is
        the device frame the first anchor named. Each iteration takes a
        fresh STATUS and asks `rolling_batch` what is deliverable from it:
        a batch (planned, preflighted FEASIBLE, sent), or the frame the
        device must reach first (horizon entry, or a queue slot freeing),
        which the host waits for on the device's own counter. An event
        whose due died is REFUSED: P0 belongs to the performance, and
        moving it would be a musical edit, not scheduling."""
        all_rows: list = []
        sent_dues: list = []
        i = 0
        # the device's 16-bit counter wraps several times during a musical
        # phrase: progress is accumulated per STATUS as a signed step
        # (wrap-safe because consecutive answers are far less than half a
        # revolution apart) and COUNTED across revolutions
        anchor = self.status()
        boots0 = self.boots_seen
        errs0 = len(self.device_errors)
        # place this anchor on ev_abs's own scale: the callers built it from
        # an earlier STATUS a few frames ago, so the signed 16-bit distance
        # to the first due is exact even if the counter wrapped in between
        ref = ev_abs[0][0]
        d = (anchor.frame - ref) & 0xFFFF
        origin0 = ref + (d if d < 0x8000 else d - 0x10000)
        prev16, progress = anchor.frame, 0
        t_prev = self.clock.monotonic()   # host time of the previous anchor
        origin_prev = None

        def unwrap(frame16: int) -> int:
            nonlocal prev16, progress
            if "ROLL_NO_UNWRAP" in INJECT_BUGS:
                d = (frame16 - (origin0 & 0xFFFF)) & 0xFFFF
                progress = d if d < 0x8000 else d - 0x10000
                return origin0 + progress
            step = (frame16 - prev16) & 0xFFFF
            progress += step if step < 0x8000 else step - 0x10000
            prev16 = frame16
            return origin0 + progress

        while i < len(ev_abs):
            anchor = self.status()
            before = progress
            t_now = self.clock.monotonic()
            interval_s = t_now - t_prev
            t_prev = t_now
            interval_frames = interval_s * SR
            # the modulo step cannot show a whole revolution (#459, #474
            # pattern): REFUSE rather than unwrap an interval it can alias
            if "ROLL_NO_UNWRAP" not in INJECT_BUGS \
                    and interval_frames >= 0x10000:
                raise Refused(
                    f"host latency: {interval_s * 1000:.0f} ms between anchors "
                    f"({interval_frames:.0f} frames) reaches the 16-bit "
                    "counter's one-revolution aliasing bound (0x10000 frames, "
                    "1.365 s at 48 kHz); the unwrap cannot tell it from a "
                    "short or zero step -- refusing to re-time the phrase. "
                    "This is the host or USB link, not the device")
            origin = unwrap(anchor.frame)
            if self.boots_seen != boots0:
                raise Refused("the device reset mid-phrase (BOOT on the wire): "
                              "its queue and patch are gone -- refusing to "
                              "continue a phrase with a hole in it")
            if all_rows and progress <= before:
                raise Refused(self._no_advance_verdict(anchor, interval_s))
            # every event sent and due after this anchor must still be
            # queued: fewer means the device lost them (a reset clears the
            # queue by construction) and the music has a hole the host
            # cannot see any other way. Only dues >= origin + 2 count: an
            # event due at the anchor frame may fire as STATUS is answered.
            owed = sum(1 for d in sent_dues if d >= origin + 2)
            if anchor.evq < owed:
                errs = self.device_errors[errs0:]
                why = (f"the device reported ERR {sorted({c for c, _ in errs})}"
                       if errs else "no ERR was read, so the queue itself was lost")
                raise Refused(f"the device holds {anchor.evq} queued events "
                              f"but {owed} sent events are not yet due: "
                              f"{owed - anchor.evq} never queued ({why}) -- "
                              "refusing to continue a phrase with a hole in it")
            lead = MIN_LEAD_FRAMES + int((self.status_round_trip_s or 0.0) * SR) + 1
            try:
                batch, wait = rolling_batch(ev_abs, i, origin, lead, baud,
                                            inflight=sent_dues[-EVENT_QUEUE_DEPTH:],
                                            prev_origin=origin_prev,
                                            anchor_interval_s=interval_s)
            except ValueError as exc:
                raise Refused(f"{exc} -- refusing to re-time the phrase") from None
            origin_prev = origin
            if not batch:
                # wait on the DEVICE for the frame the cut named, in steps
                # inside the +-32768 window the 16-bit compare can answer
                step = min(wait - origin, ROLLING_HORIZON_FRAMES)
                try:
                    self.wait_until((anchor.frame + max(1, step)) & 0xFFFF,
                                    timeout_s=5.0)
                except SystemExit:
                    raise Refused("the device's frame counter did not reach "
                                  "the next window; the phrase's dues will "
                                  "die -- refusing to re-time the phrase") from None
                continue
            rows = plan([("event", due_abs - origin, *c[2:])
                         for due_abs, c in batch],
                        baud=baud, start_frame=lead, anchor_frame=origin)
            # `plan` restores the absolute due (anchor + relative) itself
            verdict = preflight(rows, baud=baud)
            if verdict["verdict"] != "FEASIBLE":
                raise Refused(f"window at device frame {origin} cannot deliver "
                              f"its {len(batch)} events: {verdict['reason']}")
            self.send(rows)
            all_rows += rows
            sent_dues += [d for d, _c in batch]
            self._run_acks_expected += len(rows)
            i += len(batch)
            if not quiet:
                print(f"  window f{origin:<6}: {len(batch)} events, dues "
                      f"f{rows[0].due}-f{rows[-1].due}")
        self.wait_until(all_rows[-1].due + 64)
        return all_rows

    # the 16-bit step the unwrap can read as forward progress is < 0x8000
    # frames; the roller plans its waits ROLLING_HORIZON_FRAMES below that,
    # so a host interval within this margin of the horizon is where a step
    # may already have crossed it
    UNWRAP_AMBIGUOUS_FRAMES = WRAP_HALF - ROLLING_HORIZON_FRAMES

    def _no_advance_verdict(self, anchor: DevicePacket, interval_s: float) -> str:
        """Why did the unwrapped counter not move between two anchors? A
        stopped device and a host that stalled past the unwrap horizon
        (0x8000 frames, 0.683 s) look identical to the modulo step: both
        read as 'no forward progress'. The HOST clock between the two reads
        separates them where it can; where it cannot, a second STATUS gives
        the direction, and the verdict names the evidence it used (#459)."""
        frames = interval_s * SR
        ms = interval_s * 1000
        tail = "the phrase's dues will die -- refusing to re-time the phrase"
        if frames < WRAP_HALF - self.UNWRAP_AMBIGUOUS_FRAMES:
            return ("the device's frame counter did not advance "
                    f"(STATUS f{anchor.frame}; {ms:.0f} ms since the previous "
                    f"anchor, inside the 0.683 s unwrap horizon, so the "
                    f"host's own delay cannot explain it); {tail}")
        # the host interval is long enough to have crossed the horizon:
        # ask the device again to learn which way the counter is moving
        again = self.status()
        moved = (again.frame - anchor.frame) & 0xFFFF
        if 0 < moved < WRAP_HALF:
            return (f"host latency: {ms:.0f} ms between anchors "
                    f"({frames:.0f} frames) exceeds the 16-bit unwrap horizon "
                    "(0.683 s), so the step read as backwards. A second STATUS "
                    f"read f{anchor.frame} -> f{again.frame} and the counter "
                    f"advanced {moved} frames: the device clock is running; "
                    f"{tail}")
        return ("the device's frame counter did not advance "
                f"(STATUS f{anchor.frame}); the interval since the previous "
                f"anchor ({ms:.0f} ms) was long enough to hide a stall, so a "
                f"second STATUS was read: f{again.frame}, no forward motion "
                f"-- the counter is stopped; {tail}")

    @staticmethod
    def _reached(frame: int, target: int) -> bool:
        """Wrap-safe 'has the 16-bit frame counter reached target': true iff
        frame is at or after target within the +-32768-frame window the
        contract defines. An ordinary integer compare answers the question
        backwards for half the counter's range."""
        return ((frame - target) & 0xFFFF) < WRAP_HALF

    def wait_until(self, due_frame: int, *, timeout_s: float = 30.0) -> DevicePacket:
        deadline = self.clock.monotonic() + timeout_s
        target = due_frame & 0xFFFF
        last = self.status()
        while not self._reached(last.frame, target):
            if self.clock.monotonic() > deadline:
                print(f"uart_host: REFUSED -- device frame {last.frame} did not "
                      f"reach {due_frame} within {timeout_s:.0f}s", file=sys.stderr)
                raise SystemExit(2)
            self.clock.sleep(0.02)
            last = self.status()
        return last


def render_plan(plan_rows: list, *, anchor_frame: int = 0) -> str:
    lines = [f"{'#':>3} {'send@frame':>10} {'accept':>7} {'due':>7} {'applies':>8}  bytes",
             f"{'':>3} {'contract: device time, not host sleeps':>48}"]
    for row in plan_rows:
        due = f"{row.due}" if row.due >= 0 else "-"
        accept = f"{row.accept_frame}" if row.accept_frame >= 0 else "-"
        lines.append(f"{row.index:>3} {row.send_frame:>10} {accept:>7} {due:>7} "
                     f"{row.apply_frame:>8}  {row.packet.hex()}")
    return "\n".join(lines)


def plan_shifted(commands: list, *, baud: int = DEFAULT_BAUD, start_frame: int = 0,
                 anchor_frame: int = 0) -> list:
    """plan() with the whole phrase shifted later, dues' spacing intact, until
    the contract accepts it: a phrase rendered from absolute musical frames
    often starts before its own upload finishes, and the contract refuses
    what the device cannot deliver. The shift is whole frames; the schedule
    stays the device's. EVERY event carries PLAN_SLACK_FRAMES of margin over
    its acceptance -- the last packet of a dense phrase is the one that
    otherwise arrives with none."""
    shift = PLAN_SLACK_FRAMES
    for _ in range(400):
        shifted = [c if c[0] != "event" else ("event", c[1] + shift, *c[2:])
                   for c in commands]
        try:
            rows = plan(shifted, baud=baud, start_frame=start_frame,
                        anchor_frame=anchor_frame)
        except ValueError as exc:
            if "acceptance" not in str(exc):
                raise
            shift += 256
            continue
        slack = _min_event_slack(rows)
        if slack >= PLAN_SLACK_FRAMES:
            return rows
        shift += PLAN_SLACK_FRAMES - slack
    raise Refused("could not plan the phrase within 400 shifts of 256 frames: "
                  "no schedule puts every due far enough past its packet's "
                  "acceptance")


def _min_event_slack(rows: list) -> int:
    """The smallest (due - acceptance) margin over a plan's events, in
    absolute frames -- the plan's dues are anchor-relative and its checks run
    in absolute arithmetic, so there is no mod window to hide behind."""
    return min(((r.due - r.accept_frame) for r in rows
                if r.kind == "event"), default=PLAN_SLACK_FRAMES)


def plan_show(commands: list, *, hold_frames: int = 0, baud: int = DEFAULT_BAUD,
              start_frame: int = 0, anchor_frame: int = 0) -> list:
    """Plan a whole performance. A ("gate-off", flag, sec, addr, data) command
    marks the note-off: it is scheduled ON THE DEVICE as an event due at the
    note-on's gate apply frame + `hold_frames` -- the hold is the device's,
    never a host sleep (host-side sleeps cannot honour an audio-frame
    deadline over USB). Phrase events follow the gate-off, shifted later in
    whole frames so their dues stay strictly increasing and each lands after
    its packet can possibly be accepted; a shift never reorders or rescales
    musical time inside the phrase.

    `start_frame` is RELATIVE to `anchor_frame` (the device frame the STATUS
    reply named); the caller's origin enters the arithmetic exactly once."""
    import synth_top_model as stm
    markers = [i for i, c in enumerate(commands) if c[0] == "gate-off"]
    if not markers:
        return plan_shifted(commands, baud=baud, start_frame=start_frame,
                            anchor_frame=anchor_frame)
    if len(markers) > 1:
        raise Refused("more than one scheduled note-off in one plan: upload "
                      "them as separate performances")
    mi = markers[0]
    prefix, marker, rest = commands[:mi], commands[mi], commands[mi + 1:]
    for c in rest:
        if c[0] != "event":
            raise Refused(f"a ({c[0]!r} ...) command sits after the gate-off: "
                          "the scheduled note-off must come after the live "
                          "writes and before the phrase events")
    live_rows = plan(prefix, baud=baud, start_frame=start_frame,
                     anchor_frame=anchor_frame)
    gate_apply = None
    for r in live_rows:
        if r.kind == "write" and decode_reg_frame(r.packet[1:7])[2] == stm.A_GATE_ON:
            gate_apply = r.apply_frame
    if gate_apply is None:
        raise Refused("a gate-off was requested but the live writes carry no "
                      "note-on gate (A_GATE_ON) write")
    if hold_frames <= 0:
        raise Refused(f"hold_frames {hold_frames} is not a hold: the note-off "
                      "must be scheduled after the note-on's gate lands")
    gate_off_due = gate_apply + int(hold_frames)
    if gate_off_due - gate_apply > (1 << 16) - 4096:
        raise Refused(f"hold_frames {hold_frames} leaves the +-32768-frame "
                      "wrap window the contract can reason about")
    # the gate-off's own packet must be accepted strictly before its due;
    # a hold shorter than the packet's upload time is refused, not bent
    try:
        probe = plan(prefix + [("event", gate_off_due - anchor_frame, *marker[1:5])],
                     baud=baud, start_frame=start_frame, anchor_frame=anchor_frame)
    except ValueError as exc:
        raise Refused(f"hold_frames {hold_frames} is shorter than the gate-off "
                      f"packet's own upload time: {exc}") from exc
    gate_off_row = probe[-1]
    first_phrase = min((c[1] for c in rest), default=None)
    offset = 0
    if first_phrase is not None:
        # the phrase starts after the note ends: one ordered due sequence,
        # carrying the same planning-slack margin as every scheduled batch
        offset = max(0, gate_off_due + 1 - first_phrase) + PLAN_SLACK_FRAMES
    rel_gate_off = gate_off_due - anchor_frame
    for attempt in range(400):
        ev_cmds = [("event", rel_gate_off, *marker[1:5])]
        ev_cmds += [("event", c[1] + offset, *c[2:]) for c in rest]
        # the gate-off event goes on the wire FIRST: its due is ~hold_frames
        # in the future, while the boot image ahead of it is live writes the
        # device applies whenever they arrive. Sending the event after 20-odd
        # live packets would tie its arrival to the whole upload and push it
        # past its due on a slow host; sending it first makes the deliverable
        # deadline the device's, not the host's.
        try:
            rows = plan(ev_cmds[:1] + prefix + ev_cmds[1:], baud=baud,
                        start_frame=start_frame, anchor_frame=anchor_frame)
        except ValueError as exc:
            if "acceptance" not in str(exc):
                raise
            offset += 256
            continue
        # the gate-on's apply frame in THIS layout is what the hold is
        # measured against; the leading event moved it by one packet
        # position, so re-derive the due once from the final layout
        gate_apply_final = None
        for r in rows:
            if r.kind == "write" and decode_reg_frame(r.packet[1:7])[2] == stm.A_GATE_ON:
                gate_apply_final = r.apply_frame
        if gate_apply_final is not None and gate_apply_final + int(hold_frames) != gate_off_due:
            gate_off_due = gate_apply_final + int(hold_frames)
            rel_gate_off = gate_off_due - anchor_frame
            if attempt >= 398:
                raise Refused("could not settle the gate-off due")
            continue
        slack = min(((r.due - r.accept_frame) for r in rows
                     if r.kind == "event" and r.due != gate_off_due),
                    default=PLAN_SLACK_FRAMES)
        if slack >= PLAN_SLACK_FRAMES:
            return rows
        offset += PLAN_SLACK_FRAMES - slack
    raise Refused("could not plan the phrase within 400 shifts of 256 frames")


def preflight(rows: list, *, baud: int = DEFAULT_BAUD,
              event_queue: int = EVENT_QUEUE_DEPTH,
              watermark: int = PREFLIGHT_WATERMARK) -> dict:
    """Queue AND bandwidth feasibility, deterministic from the plan's ideal
    acceptance times. Nothing here is measured on a live link: the plan says
    when each packet is accepted and each event is due, and arithmetic says
    whether the device's 64-deep queue absorbs the difference.

    In-flight demand at the moment packet i is accepted is every earlier
    event whose due is still in the future. Peak demand over the whole plan
    against the queue depth is the whole verdict:

      * peak <= event_queue: FEASIBLE by preload -- send it all; the device
        fires each event at its own due and nothing is dropped.
      * peak >  event_queue: the watermark schedule (hold packets back until
        STATUS shows the queue below the watermark) is simulated; it lands
        every event before its due only if the wire's sustained event rate
        meets the fixture's due rate. If it cannot, REFUSED -- naming the
        first packet whose deadline fails, the peak, the index where the
        queue first overflows, and the bandwidth arithmetic.

    The host never relies on the device dropping packets and never silently
    re-times a fixture to fit the wire."""
    cyc = byte_cycles(baud)
    packet_frames = {8: 8 * cyc / CYC_PER_FRAME, 10: 10 * cyc / CYC_PER_FRAME}
    ev_rows = [r for r in rows if r.kind == "event"]
    total_bytes = sum(len(r.packet) for r in rows)
    report = {
        "verdict": "FEASIBLE", "baud": baud, "packets": len(rows),
        "events": len(ev_rows), "bytes": total_bytes,
        "event_queue": event_queue, "watermark": watermark,
        "frames_per_event_packet": round(packet_frames[10], 1),
    }
    if not ev_rows:
        report["reason"] = "no scheduled events: nothing can queue"
        return report
    # dues are absolute (anchor-relative, checked in plan without mod) and
    # strictly increasing in plan order
    unwrapped = [r.due for r in ev_rows]
    acc = [r.accept_frame for r in ev_rows]
    span = unwrapped[-1] - unwrapped[0] + 1
    report["due_span_frames"] = span
    report["wire_frames"] = -(-total_bytes * cyc // CYC_PER_FRAME)
    in_seq = [unwrapped[i] - unwrapped[0] for i in range(len(ev_rows))]
    avg_gap = in_seq[-1] / max(1, len(ev_rows) - 1)
    report["avg_frames_between_dues"] = round(avg_gap, 1)

    def inflight_curve():
        peak, peak_i, first_excess = 0, 0, None
        for i in range(len(ev_rows)):
            n = sum(1 for j in range(i + 1) if unwrapped[j] > acc[i])
            if n > peak:
                peak, peak_i = n, i
            if n > event_queue and first_excess is None:
                first_excess = i
        return peak, peak_i, first_excess

    peak, peak_i, first_excess = inflight_curve()
    report["peak"] = peak
    report["peak_index"] = peak_i
    report["first_excess_index"] = first_excess
    if peak <= event_queue:
        report["mode"] = "preload"
        report["reason"] = (f"peak in-flight demand {peak} fits the "
                            f"{event_queue}-deep event queue: preload the "
                            "whole schedule, the device fires at each due")
        return report

    # watermark batching: hold packets back until the queue drains below the
    # watermark, then resume. Send times slide; dues do not. A held packet
    # still costs the wire its own transmission time -- the pacing constraint
    # chains through the holds (accept_i >= prev_accept + packet wire time).
    pace = [-(-len(r.packet) * cyc // CYC_PER_FRAME) for r in ev_rows]
    queued, prev_acc, first_miss = [], None, None
    for i, (a, d) in enumerate(zip(acc, unwrapped)):
        if prev_acc is None:
            earliest = a
        else:
            earliest = max(a, prev_acc + pace[i])
        if len(queued) >= watermark:
            need = len(queued) - watermark + 1
            resume = sorted(queued)[need - 1] + 1     # fires free slots next frame
            accept = max(earliest, resume)
        else:
            accept = earliest
        prev_acc = accept
        queued = [q for q in queued if q > accept]
        queued.append(d)
        if first_miss is None and accept >= d:
            first_miss = {"index": i, "accept": accept, "due": d}
    report["watermark_first_miss"] = first_miss
    if first_miss is None:
        report["verdict"] = "FEASIBLE"
        report["mode"] = "watermark"
        report["reason"] = (f"peak demand {peak} exceeds the queue; the "
                            f"watermark-{watermark} schedule lands every "
                            "event before its due")
        return report
    i = first_miss["index"]
    report["verdict"] = "REFUSED"
    report["mode"] = "none"
    report["reason"] = (
        f"event packet {i} cannot be delivered in time: earliest acceptance "
        f"frame {first_miss['accept']} is at or after its due "
        f"{first_miss['due']}. The wire carries one 10-byte event packet per "
        f"{packet_frames[10]:.1f} frames at {baud} baud but this fixture "
        f"schedules one every {avg_gap:.1f} frames; the queue's peak demand "
        f"is {peak} against a depth of {event_queue} (first excess at packet "
        f"index {first_excess}). The fixture cannot preload and flow control "
        f"cannot keep up: REFUSED at {baud} baud. Musical dues are not "
        "silently moved to fit the wire.")
    return report


def rolling_needed(commands: list) -> bool:
    """True when the phrase cannot be planned in one window: any event due
    beyond ROLLING_HORIZON_FRAMES from the performance's start would die in
    plan()'s wrap guard. Static-only command lists never roll."""
    events = [c[1] for c in commands if c[0] == "event"]
    return bool(events) and (events[-1] - events[0]) > ROLLING_HORIZON_FRAMES


def event_packet_frames(baud: int = DEFAULT_BAUD) -> int:
    """Wire frames one 10-byte event packet occupies, rounded up: the pacing
    unit the device's own acceptance rate runs at."""
    return -(-10 * byte_cycles(baud) // CYC_PER_FRAME)


def event_packet_frames_min(baud: int = DEFAULT_BAUD) -> int:
    """The FASTEST a 10-byte event packet can arrive, rounded down: the
    sender's true baud (10*CLK/baud cycles a byte, 1066.7 at 115200), not
    the receiver's 10*div (1070). Back-to-back bytes arrive at the sender's
    rate -- measured: a 202-packet burst lands 21 frames ahead of the
    receiver-rate model on the RTL bench. Use this where EARLIER is the
    unsafe direction (queue occupancy), `event_packet_frames` where LATER
    is (deadlines)."""
    return (10 * 10 * CLK_HZ) // (baud * CYC_PER_FRAME)


def rolling_batch(ev_abs: list, i: int, origin: int, lead: int,
                  baud: int = DEFAULT_BAUD, inflight: list = (), *,
                  prev_origin: int = None, anchor_interval_s: float = None
                  ) -> tuple:
    """The window cut, shared by the live roller and the virtual planner.

    From event `i`, take the events deliverable from a STATUS anchor named
    `origin`: each must sit within ROLLING_HORIZON_FRAMES of the anchor
    (wrap safety), the batch caps at ROLLING_BATCH_CAP (queue), and -- the
    rule that orders the whole phrase -- event j of the batch must leave the
    wire time to accept it: due >= origin + lead + (j+1) packets + slack.
    That last bound is what makes consecutive windows chain: the cut event's
    relative due minus the previous window's wire time is exactly the next
    window's first-packet requirement, so the phrase neither starves the
    queue nor dies under the wire, whatever the local density of the music.

    `inflight` is the absolute dues of events ALREADY sent by earlier
    windows: they occupy the queue until their dues pass, so the queue
    bound is checked at each packet's acceptance against everything the
    device will still hold then -- earlier windows plus this one -- not
    against the batch alone (a batch cap alone overflowed `demo` four
    times on the contract device).

    Returns (batch, wait_until): when the batch is EMPTY, `wait_until` is
    the absolute frame the anchor must reach before the next event can be
    taken -- its horizon entry, or the due that frees a queue slot. None
    when the batch is not empty or the phrase is done. An event that can
    never be accepted before its due (the wire cannot reach it from this
    anchor) raises: waiting would only make it later."""
    F = event_packet_frames(baud)
    F_min = event_packet_frames_min(baud)
    batch = []
    wait = None
    for j, (due_abs, c) in enumerate(ev_abs[i:]):
        rel = due_abs - origin
        if rel <= 0:
            # lateness (#459) vs a malformed schedule: a due that was still
            # AHEAD of the previous anchor died while the host was between
            # the two reads -- host/USB latency, not the device and not the
            # schedule. A due already behind the previous anchor (or with no
            # previous anchor) was never deliverable from where it started.
            if (prev_origin is not None and anchor_interval_s is not None
                    and due_abs > prev_origin):
                raise ValueError(
                    f"event due f{due_abs} is behind the anchor f{origin} by "
                    f"{-rel} frames ({-rel * 1000 / SR:.1f} ms): its due died "
                    "before the window could deliver it -- host/USB latency "
                    f"({anchor_interval_s * 1000:.1f} ms between anchors), "
                    "not a device fault and not a malformed schedule")
            raise ValueError(f"event due f{due_abs} is behind the anchor "
                             f"f{origin}: its due died before the window "
                             "could deliver it (the schedule itself is "
                             "late for its anchor)")
        if rel > ROLLING_HORIZON_FRAMES:
            if not batch:
                wait = due_abs - ROLLING_HORIZON_FRAMES
            break
        if len(batch) >= ROLLING_BATCH_CAP:
            break
        if rel < lead + (len(batch) + 1) * F + ROLLING_PACKET_SLACK_FRAMES:
            if not batch:
                raise ValueError(
                    f"event due f{due_abs} is {rel} frames from the anchor "
                    f"f{origin}; one packet needs {lead + F} frames of wire "
                    f"plus {ROLLING_PACKET_SLACK_FRAMES} of slack -- it "
                    "cannot be accepted before its due")
            break
        # queue occupancy when this packet lands, bounded at its EARLIEST
        # possible acceptance -- fewer events have fired by then. That is
        # origin + (j+1) packets and NOT + lead: `lead` is mostly STATUS
        # round trip already spent when the anchor is read, and a poll queued
        # behind the previous window's bytes measures that backlog as round
        # trip (628 frames observed). With lead included the bound predicted
        # acceptances up to 600 frames late and demo reached 62 of 64.
        accept = origin + (len(batch) + 1) * F_min
        if "ROLL_QUEUE_UNAWARE" in INJECT_BUGS:
            inflight = ()
        held = (sum(1 for d in inflight if d >= accept)
                + sum(1 for d, _c in batch if d >= accept) + 1)
        if held > EVENT_QUEUE_DEPTH - ROLLING_QUEUE_MARGIN:
            if not batch:
                # the queue is full of earlier windows' events: the next
                # slot frees when the earliest of them fires
                pending = sorted(d for d in inflight if d >= accept)
                wait = pending[0] + 1 - F_min
            break
        batch.append((due_abs, c))
    return batch, wait


def plan_rolling_virtual(commands: list, *, baud: int = DEFAULT_BAUD,
                         origin0: int = 0) -> tuple:
    """The rolling schedule WITHOUT a device: (rows, windows) -- the window
    structure the real run produces, under the EARLIEST anchors the contract
    allows (the device frame advances no slower than the wire). Conservative
    by construction -- smaller relative dues split windows sooner -- so a
    schedule this function accepts, a real run accepts with room to spare;
    and the rows are a complete, replayable byte schedule (origin0 stands in
    for the anchoring STATUS). This is what --dry-run renders and --capture
    writes for the RTL bench before any hardware exists; a real run
    re-anchors from live STATUS and its capture is the one the board
    hears."""
    static = [c for c in commands if c[0] != "event"]
    events = [c for c in commands if c[0] == "event"]
    windows = 0
    rows = plan(static, baud=baud, start_frame=MIN_LEAD_FRAMES + 1,
                anchor_frame=origin0) if static else []
    if not events:
        return rows, 0
    lead = MIN_LEAD_FRAMES + 1
    # the first window's anchor is the static image's wire end (the real run
    # STATUSes after the init completes); musical t=0 clears it by the start
    # margin, so no timed event is ever due while the config is still in
    # flight
    origin = (max((r.end_cycle for r in rows), default=0) // CYC_PER_FRAME)
    p0 = origin + lead + ROLLING_START_FRAMES
    ev_abs = [(p0 + c[1], c) for c in events]
    i = 0
    sent_dues: list = []
    while i < len(ev_abs):
        try:
            batch, wait = rolling_batch(ev_abs, i, origin, lead, baud,
                                        inflight=sent_dues[-EVENT_QUEUE_DEPTH:])
        except ValueError as exc:
            raise ValueError(f"{exc} (virtual anchor f{origin})") from None
        if not batch:
            # nothing deliverable from this anchor yet: advance the virtual
            # anchor to the frame the cut named (the wait the live roller
            # makes with wait_until)
            origin = max(origin + 1, wait)
            continue
        wrows = plan([("event", due_abs - origin, *c[2:])
                      for due_abs, c in batch],
                     baud=baud, start_frame=lead, anchor_frame=origin)
        verdict = preflight(wrows, baud=baud)
        if verdict["verdict"] != "FEASIBLE":
            raise ValueError(f"window at virtual anchor {origin} cannot "
                             f"deliver its {len(batch)} events: "
                             f"{verdict['reason']}")
        rows += wrows
        sent_dues += [d for d, _c in batch]
        i += len(batch)
        origin = wrows[-1].end_cycle // CYC_PER_FRAME
        windows += 1
    return rows, windows


def _row_expect(r):
    """The decoded intent of one planned row: what the device should do."""
    if r.kind == "write":
        flag, sec, addr, data = decode_reg_frame(r.packet[1:7])
    elif r.kind == "event":
        flag, sec, addr, data = decode_reg_frame(r.packet[3:9])
    else:
        return None
    return {"flag": flag, "sec": sec, "addr": addr, "data": data}


def write_capture(prefix: str, rows: list, *, origin: int,
                  baud: int = DEFAULT_BAUD) -> str:
    """The exact bytes the tool emits, in plan order, with the schedule the
    planner gave them: `<prefix>.cmds` in the RTL bench's S-line format and
    `<prefix>.plan.json` with every row (rebased so frame 0 is the first
    send). The bench path (fpga/verify_uart_bridge.py --replay) feeds these
    bytes through the UART RX of the real wrapper -- what is verified there
    is what this CLI emits, not a bench-scripted lookalike."""
    base = rows[0].send_frame if rows else 0
    parent = os.path.dirname(os.path.abspath(prefix))
    os.makedirs(parent, exist_ok=True)
    cmds_path, plan_path = f"{prefix}.cmds", f"{prefix}.plan.json"
    with open(cmds_path, "w") as fh:
        for row in rows:
            fh.write(f"S {row.send_frame - base} {row.packet.hex(' ')}\n")
    # "packet" is what the tool EMITS (the stimulus); "expect" is the decoded
    # schedule the tool INTENDED (the expectation). Keeping them separate lets
    # a replay mutate the emitted bytes and still know what should have
    # happened -- a stimulus-only mutation is otherwise invisible by
    # construction, which is exactly the kind of self-consistent pass this
    # repository does not trust.
    record = {
        "origin": origin, "baud": baud, "base_send_frame": base,
        "rows": [{"index": r.index, "kind": r.kind,
                  "packet": r.packet.hex(),
                  "expect": _row_expect(r),
                  "send_frame": r.send_frame - base,
                  "accept_frame": r.accept_frame - base,
                  "due": (r.due - base) if r.due >= 0 else -1,
                  "apply_frame": r.apply_frame - base} for r in rows],
    }
    with open(plan_path, "w") as fh:
        json.dump(record, fh, indent=2)
        fh.write("\n")
    return cmds_path


def budget(baud: int = DEFAULT_BAUD) -> dict:
    """The link's numbers, from the contract. Quoted wherever a schedule is."""
    cyc = byte_cycles(baud)
    per_frame = CYC_PER_FRAME / cyc
    return {
        "baud": baud,
        "bytes_per_s": CLK_HZ / cyc,
        "frames_per_write_packet": CYC_PER_FRAME / (8 * cyc),
        "frames_per_event_packet": CYC_PER_FRAME / (10 * cyc),
        "event_packets_per_frame": per_frame / 10,
        "write_slots_per_frame": WRITE_SLOTS,
        "event_queue": EVENT_QUEUE_DEPTH,
        "write_queue": WRITE_QUEUE_DEPTH,
        "max_sustained_event_rate_per_kframe": per_frame / 10 * 1000,
    }


def main(argv=None, *, bridge_factory=None) -> int:
    """`bridge_factory(port, baud)` replaces `Bridge` for tests and replay
    capture (uart_device_sim.SimSerial): everything else is the CLI as shipped."""
    open_bridge = bridge_factory or Bridge
    ap = argparse.ArgumentParser(description=__doc__,
                                 formatter_class=argparse.RawDescriptionHelpFormatter)
    ap.add_argument("--port", default=os.environ.get("UART_BRIDGE_PORT", ""))
    ap.add_argument("--baud", type=int, default=DEFAULT_BAUD)
    ap.add_argument("--preset", default=None, help="named selected preset to load")
    ap.add_argument("--note", type=int, default=None, help="MIDI note for on/off/run")
    ap.add_argument("--hold-frames", type=int, default=1920, help="note hold (40 ms default x48)")
    ap.add_argument("--fixture", default=None,
                    help="scripted phrase: none (no phrase; run's note-only "
                         "mode -- the DEFAULT), m5a (the short phrase the "
                         "UART bench proves), bar808 (full musical fixture; "
                         "preflight REFUSES it: over queue and wire budget)")
    ap.add_argument("--image", default=DEFAULT_IMAGE, choices=sorted(IMAGE_REVISION),
                    help="the Arty image on the board, which decides the drum kit a "
                         "fixture sends: release (the published R0 image, contract "
                         "revision 11, no final strike -- the DEFAULT), r1 (the "
                         "published R1 player release, its frozen kit and known-state "
                         "start), r2 (the R2 image, PULSE2X=1: the same bytes as r1, "
                         "fpga/release/R2.md) or tree (an image built from this tree, "
                         "revision 14; development)")
    ap.add_argument("--dry-run", action="store_true",
                    help="render the exact byte schedule and landing frames; no hardware")
    ap.add_argument("--engineering", action="store_true",
                    help="skip the release-domain validator: the raw engineering "
                         "interface, OUTSIDE the qualified player-facing domain")
    ap.add_argument("--capture", default=None, metavar="PREFIX",
                    help="write the exact emitted bytes to PREFIX.cmds (RTL bench "
                         "S-line format) and PREFIX.plan.json, for replay through "
                         "the wrapper sim (fpga/verify_uart_bridge.py --replay)")
    # the same flags on every subcommand, so `run --note 45` and
    # `--note 45 run` both parse
    common = argparse.ArgumentParser(add_help=False)
    # SUPPRESS defaults: a subparser that does not see the flag must not
    # clobber the value the top-level parser already parsed
    common.add_argument("--port", default=argparse.SUPPRESS,
                        help="serial device (or UART_BRIDGE_PORT)")
    common.add_argument("--baud", type=int, default=argparse.SUPPRESS)
    common.add_argument("--preset", default=argparse.SUPPRESS)
    common.add_argument("--note", type=int, default=argparse.SUPPRESS)
    common.add_argument("--hold-frames", type=int, default=argparse.SUPPRESS)
    common.add_argument("--fixture", default=argparse.SUPPRESS)
    common.add_argument("--image", default=argparse.SUPPRESS, choices=sorted(IMAGE_REVISION))
    common.add_argument("--dry-run", action="store_true", default=argparse.SUPPRESS)
    common.add_argument("--engineering", action="store_true", default=argparse.SUPPRESS)
    common.add_argument("--capture", default=argparse.SUPPRESS, metavar="PREFIX",
                        help="write the exact emitted bytes to PREFIX.cmds (RTL bench "
                             "S-line format) and PREFIX.plan.json, for replay through "
                             "the wrapper sim (fpga/verify_uart_bridge.py --replay)")
    sub = ap.add_subparsers(dest="cmd")
    for name, help_text in (("load", "load the preset image"),
                            ("note-on", "start a note"),
                            ("note-off", "release a note"),
                            ("play", "replay a scripted phrase, scheduled on the device"),
                            ("run", "ONE command: preset, note on, hold, off, phrase"),
                            ("status", "query the device"),
                            ("abort", "clear both queues")):
        sub.add_parser(name, parents=[common], help=help_text)
    a = ap.parse_args(argv)

    commands = []
    phrase = None
    # the phrase, split BEFORE assembly: a fixture's setup image belongs
    # with the preset (ahead of any held note -- loading a patch under a
    # sounding key changes the note), its timed writes after the note-off
    fx_static, fx_events = [], []
    if a.cmd in ("play", "run"):
        # the default is the FEASIBLE mode: a bare `run` is the held note and
        # nothing else. bar808 was the default once; preflight refused it
        # every time, so the advertised first playback failed by construction.
        # The first phrase is `--fixture m5a` (bench-proven), never a default.
        fixture = a.fixture or "none"
        if fixture == "m5a":
            fx_events, _end = phrase_events(fixture, a.image)
        elif fixture != "none":
            # the fixture's own structure: its load() image as live setup,
            # everything after it as scheduled events
            fx_static, fx_events, _end = phrase_static_and_events(fixture, a.image)
    fixture_image = a.cmd in ("play", "run") and (a.fixture or "none") != "none"
    if fixture_image and a.preset and not a.engineering:
        # the fixture programs its own patch over the preset: the player
        # would hear the fixture's sound under the preset's name
        print(f"uart_host: REFUSED -- --preset {a.preset} with --fixture {a.fixture}: "
              "the fixture loads its own patch over the preset", file=sys.stderr)
        return 2
    image_sent = a.cmd in ("load", "run") or a.cmd is None
    if image_sent and a.image in KNOWN_STATE_IMAGES:
        # R1's known-state session start (#279): voice RESET and drum RESET
        # zero every register and state of both sections BEFORE the image,
        # so routing, modulation, drift and any drum register the image does
        # not write are known -- not assumed from an earlier (engineering)
        # session. The frozen target lives in fpga/release/r1_candidate.py.
        # The release image's byte streams are unchanged (its manifest pins them).
        for flag, sec, addr, data in known_state_preamble():
            commands.append(("write", flag, sec, addr, data))
    if image_sent:
        for flag, sec, addr, data in voice_image_writes(a.preset):
            commands.append(("write", flag, sec, addr, data))
        if not fx_static:
            for flag, sec, addr, data in voice_mixer_writes(a.preset):
                commands.append(("write", flag, sec, addr, data))
    for flag, sec, addr, data in fx_static:
        commands.append(("write", flag, sec, addr, data))
    if a.cmd == "note-on" or (a.cmd == "run" and a.note is not None):
        note = a.note if a.note is not None else 45
        for flag, sec, addr, data in note_writes(note, True,
                                                 preset_regs=preset_regs(a.preset)):
            commands.append(("write", flag, sec, addr, data))
    if a.cmd == "note-off":
        # a standalone off releases what is sounding: the live gate-off write
        note = a.note if a.note is not None else 45
        for flag, sec, addr, data in note_writes(note, False):
            commands.append(("write", flag, sec, addr, data))
    if a.cmd == "run" and a.note is not None:
        # the run's note-off is a DEVICE-side event: gate lands, the device
        # counts hold_frames, the gate goes off -- no host sleep involved
        note = a.note if a.note is not None else 45
        for flag, sec, addr, data in note_writes(note, False):
            commands.append(("gate-off", flag, sec, addr, data))
    for due, flag, sec, addr, data in fx_events:
        commands.append(("event", due, flag, sec, addr, data))
    if a.cmd == "status":
        bridge = open_bridge(a.port, a.baud)
        print(bridge.status().describe())
        return 0
    if a.cmd == "abort":
        bridge = open_bridge(a.port, a.baud)
        bridge.send([Placed(0, "abort", pkt_abort(), 0, 0)])
        print("sent abort (queued events discarded)")
        return 0
    if not commands:
        ap.print_usage(); return 2
    played_note = (a.note if a.note is not None else 45) if (
        a.cmd == "note-on" or (a.cmd == "run" and a.note is not None)) else None
    if a.engineering:
        print("uart_host: ENGINEERING -- release-domain validator skipped; this "
              "traffic is OUTSIDE the qualified player-facing domain", file=sys.stderr)
    else:
        sys.path.insert(0, os.path.join(ROOT, "fpga", "release"))
        import qualified_domain as qd
        try:
            q = qualify(commands, preset=a.preset, note=played_note, image_sent=image_sent,
                        image=a.image)
        except qd.Rejected as exc:
            print(f"uart_host: REFUSED -- outside the qualified release domain: {exc}",
                  file=sys.stderr)
            return 2
        st = q["stream"]
        print(f"uart_host: release domain OK -- {st['inc_writes']} increment writes, "
              f"{st['glide_transitions']} glide transitions, all in "
              f"[{qd.INC_LO}, {qd.INC_HI}]")

    if a.dry_run:
        try:
            if rolling_needed(commands):
                # the window structure the device will see, under the
                # earliest anchors the contract allows; every window is
                # preflighted inside, and the rows are a complete,
                # replayable byte schedule
                rows, windows = plan_rolling_virtual(commands, baud=a.baud)
                n_events = sum(1 for r in rows if r.kind == "event")
                verdict = {"verdict": "FEASIBLE", "mode": "rolling",
                           "reason": f"{n_events} scheduled events delivered "
                                     f"in {windows} wrap-safe windows, each "
                                     f"preflighted against the queue and the "
                                     f"wire before its first packet"}
            else:
                rows = plan_show(commands, hold_frames=a.hold_frames, baud=a.baud)
                verdict = preflight(rows, baud=a.baud)
        except Refused as exc:
            print(f"uart_host: REFUSED -- {exc}", file=sys.stderr)
            return 2
        except ValueError as exc:
            print(f"uart_host: REFUSED -- {exc}", file=sys.stderr)
            return 2
        if a.capture:
            write_capture(a.capture, rows, origin=0, baud=a.baud)
        b = budget(a.baud)
        print(f"uart_host: {len(rows)} packets, {sum(len(r.packet) for r in rows)} bytes "
              f"at {b['baud']} baud; device schedule (frames are device frames):")
        print(render_plan(rows))
        print(f"contract: {b['write_slots_per_frame']} write slots/frame, "
              f"event queue {b['event_queue']}, write queue {b['write_queue']}, "
              f"1 event packet per {1/b['frames_per_event_packet']:.1f} frames at this baud")
        print(f"preflight: {verdict['verdict']} ({verdict.get('mode', 'none')}) -- "
              f"{verdict['reason']}")
        if verdict["verdict"] != "FEASIBLE":
            print(f"uart_host: REFUSED -- {verdict['reason']}", file=sys.stderr)
            return 2
        return 0

    if not a.port:
        print("uart_host: REFUSED -- no --port given (or UART_BRIDGE_PORT); "
              "use --dry-run for the schedule without hardware", file=sys.stderr)
        return 2
    try:
        bridge = open_bridge(a.port, a.baud)
        # only a command that establishes R1's known state asserts it: a
        # standalone note-off must never be refused for a busy queue
        bridge.require_idle = a.image in KNOWN_STATE_IMAGES and image_sent
        rows = bridge.run(commands, baud=a.baud, hold_frames=a.hold_frames)
    except Refused as exc:
        print(f"uart_host: REFUSED -- {exc}", file=sys.stderr)
        return 2
    if a.capture:
        write_capture(a.capture, rows, origin=bridge.origin, baud=a.baud)
    last = max(r.apply_frame for r in rows)
    end = bridge.wait_until(last + 64)
    acked = bridge.acks_seen - bridge._run_ack_base
    if acked < bridge._run_acks_expected:
        # the device ACKs every accepted packet; a packet with no ACK never
        # arrived -- and nothing on the wire announces an absence
        print(f"uart_host: FAIL -- {bridge._run_acks_expected - acked} of "
              f"{bridge._run_acks_expected} packets "
              "were never ACKed by the device", file=sys.stderr)
        return 1
    st = bridge.status()
    print(f"uart_host: done; device frame {st.frame}, evq {st.evq}, wrq {st.wrq}, "
          f"drops {st.drops}, errs {st.errs}, flags 0x{st.flags:02x}")
    if st.drops or st.errs or (st.flags & 0x0F):
        print("uart_host: FAIL -- the device reported dropped or corrupted traffic",
              file=sys.stderr)
        return 1
    return 0


if __name__ == "__main__":
    raise SystemExit(main())
