2AMLogic/gf180-parasynth/fpga/verify_rolling_playback.py

#!/usr/bin/env python3
"""Verify musical-length playback: the real CLI, rolled, against the fixture.

    .venv/bin/python fpga/verify_rolling_playback.py                 # sim + controls
    .venv/bin/python fpga/verify_rolling_playback.py --rtl demo      # + UART RTL replay

WHAT IS UNDER TEST. `uart_host.main(["run", "--fixture", F])` -- the shipped
command, its Bridge and its rolling scheduler -- talking to the device
contract (fpga/uart_device_sim.py) on SIMULATED time. Nothing in the host is
replaced but the serial port and the clock (`main(bridge_factory=...)`).

WHAT IT IS CHECKED AGAINST. The fixture itself, not the planner: every
write `MusicHost.load()` emitted must execute, in order, before the music's
t=0; every other write must execute at EXACTLY t=0 plus its fixture frame
(after the link's own simultaneous-event spreading, which is part of the
fixture's rendering and is reported, not hidden). t=0 is the one number the
host chooses; it is read from the host and checked for plausibility, and
every other expectation is fixed relative to it.

WHAT IT RECORDS. The feasibility numbers the plan's whole-phrase average
cannot give: peak event-queue occupancy, minimum deadline slack (due minus
acceptance frame, per event), window count, counter wraps crossed, and the
spreading: how many writes the link moved and how far the worst anchor
(a stop bit or gate -- the audible instant) moved.

--rtl ALSO replays the host's ACTUAL bytes (the SimSerial transmit log,
STATUS polls included, at the frames the host wrote them) through the UART
RTL wrapper bench (fpga/verify_uart_bridge.py), whose I2S is compared with
the model driven by the INTENDED schedule above -- so a host that emitted
the wrong due, value or order is visible on the wire, not cancelled out.

CONTROLS (each must turn the run red for its recorded reason):

  ROLL_QUEUE_UNAWARE  window cut ignores queued events -> device drops (demo)
  ROLL_TAG_SPLIT      setup split by tag -> in-pattern accents play at t=0
  ROLL_NO_UNWRAP      anchors not counted across wraps -> refused or late
  WATERMARK_PRELOAD   watermark verdict sent unthrottled -> device drops, FAIL
  corrupt-byte        one payload bit flipped on the wire -> checksum ERR, FAIL
  reset-mid           device reset mid-phrase -> host REFUSES, never continues
  UNWRAP_LONG_REST    a 1 s rest between bars -> writes further apart than a
                      16-bit frame log can step -> REFUSED, not measured

Exit 0 when every clean case passes and every control is caught for its
reason, 1 otherwise, 2 refused (apparatus precondition failed).
"""
from __future__ import annotations

import argparse
import contextlib
import hashlib
import io
import json
import sys
from pathlib import Path

ROOT = Path(__file__).resolve().parents[1]
for _p in ("fpga", "rtl-sketch", "model"):
    sys.path.insert(0, str(ROOT / _p))

import uart_device_sim as dev                     # noqa: E402
import uart_host as uh                            # noqa: E402

sys.path.insert(0, str(ROOT / "fpga" / "release"))
import r1_candidate as r1c                        # noqa: E402

SR = uh.SR
FIXTURES = ("bar808-full", "demo")
RTL_TIMEOUT_S = 10_800
TAIL_S = 1.0          # simulated time after the host returns: decay tails
ANCHOR_TAGS = {"stops-on", "gate", "trig"}        # the audible instants


# ---- the intended schedule, from the fixture ---------------------------------
def intended(fixture: str, preset: str | None = None,
             note: int | None = None, image: str = uh.DEFAULT_IMAGE) -> dict:
    """What must happen, derived from the fixture and the preset image
    alone. `static` is in send order; `timed` is (rel_frame, flag, sec,
    addr, data) with rel_frame measured from the music's t=0. With `note`,
    the held note's on-writes follow the setup and its gate-off is the
    first timed write (`held` names it); the phrase's frames are then
    fixed RELATIVE to each other -- the host places the whole phrase after
    the hold, spacing intact.

    `image` is the TARGET the expectation is built for, never the sender's
    selector. For R1 ("r1", the named release; #323) and R2 ("r2", which is sent R1's
    kit and start) the expectation is checked against the frozen
    target (fpga/release/r1_candidate.py) before it is used: the known-state
    preamble and the revision-14 kit by digest, with its nonzero final
    strike. An expectation that is not that target REFUSES (Refused)."""
    static_w, timed_w, _n, _host = uh.fixture_split(fixture, image)
    static = [tuple(w) for w in r1c.PREAMBLE] if image in uh.KNOWN_STATE_IMAGES else []
    static += [tuple(w) for w in uh.voice_image_writes(preset)]
    static += [(w.flag, w.sec, w.addr, w.data & 0xFFFFFFFF) for w in static_w]
    held = []
    if note is not None:
        static += [tuple(w) for w in uh.note_writes(note, True)]
        held = [tuple(w) for w in uh.note_writes(note, False)]
    timed = [(w.frame, w.flag, w.sec, w.addr, w.data & 0xFFFFFFFF) for w in timed_w]
    if image in uh.R1_KIT_IMAGES:           # r1, and r2 (R1's kit and start; R2.md)
        probs = r1c.check_init(static, kit_expected=True)
        if probs:
            raise r1c.Refused(f"the {fixture} expectation is not the frozen R1 target: {probs}")
    moved = [w for w in timed_w if w.frame != w.nominal]
    anchors = [w for w in timed_w if w.tag in ANCHOR_TAGS]
    worst = max((w.frame - w.nominal for w in anchors), default=0)
    return {"static": static, "timed": timed, "held": held, "target": image,
            "spreading": {"timed_writes": len(timed_w),
                          "moved": len(moved),
                          "anchors": len(anchors),
                          "anchors_moved": sum(1 for w in anchors
                                               if w.frame != w.nominal),
                          "worst_anchor_shift_frames": worst,
                          "worst_anchor_shift_ms": round(worst * 1000 / SR, 3)}}


# ---- one run of the real CLI on the simulated device --------------------------
class Harness:
    def __init__(self, epoch: int = 0):
        self.clock = dev.SimClock()
        self.sim = dev.UartDeviceSim(epoch_frame=epoch, clock=self.clock)
        self.ser = dev.SimSerial(self.sim)
        self.bridge = None

    def factory(self, _port, baud):
        self.bridge = uh.Bridge.on_serial(self.ser, baud, clock=self.clock)
        return self.bridge


def run_cli(fixture: str, *, epoch: int = 0, inject: str | None = None,
            wire_fault=None, reset_after_events: int | None = None,
            note: int | None = None, image: str = uh.DEFAULT_IMAGE,
            target: str | None = None) -> dict:
    """uart_host.main on the scripted device; returns everything observed.
    `image` is what the SENDER is told (`--image`); `target` is what the
    expectation is built for (default: the same, the historical R0 check).
    They are separate so a sender that picks the wrong kit is visible."""
    h = Harness(epoch)
    if wire_fault:
        h.ser.mutate = wire_fault
    if reset_after_events is not None:
        # press BTN0 once the device has accepted this many scheduled events
        orig_accept = h.sim._accept

        def accept(op, pkt, t):
            orig_accept(op, pkt, t)
            n = sum(1 for k, _ in h.sim.received if k == "event")
            if op == dev.OP_EVENT and n == reset_after_events and not h.sim.resets:
                h.ser.reset()
        h.sim._accept = accept
    want = intended(fixture, note=note, image=target or image)   # uninjected intent
    saved = set(uh.INJECT_BUGS)
    uh.INJECT_BUGS.clear()
    if inject:
        uh.INJECT_BUGS.add(inject)
    out, err = io.StringIO(), io.StringIO()
    try:
        with contextlib.redirect_stdout(out), contextlib.redirect_stderr(err):
            try:
                argv = ["run", "--fixture", fixture, "--port", "sim", "--image", image]
                if note is not None:
                    argv += ["--note", str(note)]
                rc = uh.main(argv, bridge_factory=h.factory)
            except SystemExit as exc:          # a Bridge REFUSED path
                rc = exc.code if isinstance(exc.code, int) else 2
    finally:
        uh.INJECT_BUGS.clear()
        uh.INJECT_BUGS.update(saved)
    h.ser.run_until(h.clock.t + TAIL_S)
    return {"rc": rc, "stdout": out.getvalue(), "stderr": err.getvalue(),
            "h": h, "want": want}


class UnwrapRefused(RuntimeError):
    """The 16-bit frame log cannot be unwrapped unambiguously here."""


UNWRAP_GAP_BOUND = 0x8000
"""The largest step `_unwrap` can read. Its own branch is `d < 0x8000 ->
forward, else backward`, so a TRUE forward gap of 0x8000 or more is read as a
backward one: the bound is 0x8000, not the 0x10000 of the forward-only
`naive_unwrap` in fpga/test_play_song.py. Same ambiguity, a different half of
it, because this unwrap admits backward steps (the link can log two writes out
of frame order) and that one does not."""


def _unwrap(frames16: list, start: int, expected: list) -> list:
    """16-bit device frames as a monotone timeline beginning near `start`.

    PRECONDITION, ASSERTED HERE RATHER THAN ASSUMED (#474): consecutive
    writes are less than UNWRAP_GAP_BOUND frames apart. A modulo-2^16 step
    cannot show a longer gap -- g and g - 2^16 are the same 16-bit step -- and
    the log itself cannot say which happened, so `expected` (the schedule the
    run is checked against, in frames from `start`) is checked instead and an
    unmeasurable one REFUSES rather than being silently mis-unwrapped.

    WHAT THE PRECONDITION DOES NOT COVER, because the expected schedule cannot
    say it: a write DELIVERED an exact multiple of 2^16 frames off its due
    frame is unwrapped straight back onto it, and one delivered further than
    0x8000 off is aliased to the wrong size and possibly the wrong sign. The
    first is undetectable from the log; the second is still reported (as a
    write off its frame) but with a wrong number attached. `check()` closes
    both against the sim's own unwrapped log, which a board does not have --
    see `_unwrap_offsets`."""
    gaps = [b - a for a, b in zip(expected, expected[1:])]
    worst = max((abs(g) for g in gaps), default=0)
    if worst >= UNWRAP_GAP_BOUND:
        raise UnwrapRefused(
            f"the expected schedule steps {worst} frames between consecutive "
            f"writes; a 16-bit frame log cannot tell that from "
            f"{worst - 0x10000}, so this run cannot be unwrapped (bound "
            f"{UNWRAP_GAP_BOUND})")
    out, prev, acc = [], start & 0xFFFF, start
    for f in frames16:
        d = (f - prev) & 0xFFFF
        acc += d if d < 0x8000 else d - 0x10000
        prev = f
        out.append(acc)
    return out


def _unwrap_offsets(got_frames: list, truth: list) -> list:
    """How far `_unwrap`'s answer sits from the device's own UNWRAPPED log,
    which the sim keeps (`UartDeviceSim.write_frames`) and a board does not.

    Every unambiguous step moves both timelines by the same amount, so a
    correct unwrap is a SINGLE constant offset -- `start` is a 16-bit value and
    the truth is not, so the constant is whatever whole wraps separate them.
    Two or more offsets means some step was read as its alias: the answer is
    wrong from that write on, and the harness must refuse rather than report
    it. This is the one check here whose reference is independent of the thing
    being measured."""
    return sorted({g - t for g, t in zip(got_frames, truth)})


def check(run: dict) -> dict:
    """Compare what the device executed with the fixture's intent."""
    h, want = run["h"], run["want"]
    sim, bridge = h.sim, h.bridge
    res = {"rc": run["rc"], "reasons": []}
    ev_i = [i for i, w in enumerate(sim.writes) if w[5] == "event"]
    live = [w for w in sim.writes if w[5] == "live"]
    ev = [sim.writes[i] for i in ev_i]
    res["static_executed"] = len(live)
    res["static_intended"] = len(want["static"])
    res["timed_executed"] = len(ev)
    res["timed_intended"] = len(want["timed"])
    res["device_errors"] = [list(e) for e in sim.errors]
    res["drops"] = sim.drops
    res["resets"] = sim.resets
    if run["rc"] != 0:
        tail = (run["stderr"].strip().splitlines() or ["?"])[-1]
        res["reasons"].append(f"cli rc {run['rc']}: {tail}")
    if sim.errors or sim.drops:
        codes = sorted({e[0] for e in sim.errors})
        res["reasons"].append(f"device errors {codes}, drops {sim.drops}")
    executed = [(w[1], w[2], w[3], w[4]) for w in live]
    if want.get("target") in uh.R1_KIT_IMAGES:
        # the frozen R1 target (r1, and r2, which is sent R1's kit and start),
        # checked on what the device EXECUTED from the
        # host's bytes: a wrong kit is a host-correctness failure, named
        res["init_check"] = r1c.check_init(executed, kit_expected=True)
        for p in res["init_check"]:
            res["reasons"].append(f"init bytes: {p}")
    if executed != list(want["static"]):
        res["reasons"].append("static image not executed exactly, in order")
    p0 = bridge.performance_origin if bridge else None
    res["performance_origin"] = p0
    if p0 is None:
        res["reasons"].append("host recorded no performance origin")
        res["ok"] = False
        return res
    # P0 must follow the whole static image: music never plays on a
    # half-loaded patch
    if live and ((p0 - live[-1][0]) & 0xFFFF) >= 0x8000:
        res["reasons"].append(f"t=0 f{p0} precedes the last static write "
                              f"f{live[-1][0]}")
    # The device logs 16-bit frames. Unwrapping them is only unambiguous while
    # consecutive writes stay inside UNWRAP_GAP_BOUND, which the log cannot
    # show -- so the EXPECTED schedule is checked and an unmeasurable one
    # REFUSES (#474). t=0 leads it: the first timed write is unwrapped from
    # `p0`, so its own distance from t=0 is a step like any other. A held
    # note's gate-off IS t=0 and the phrase behind it is placed by the host,
    # so that one step is not in the expectation -- `_unwrap_offsets` below is
    # what covers it.
    try:
        got_frames = _unwrap([w[0] for w in ev], p0,
                             [0] + [e[0] for e in want["timed"]])
    except UnwrapRefused as exc:
        res["refused"] = str(exc)
        res["reasons"].append(f"REFUSED: {exc}")
        res["ok"] = False
        return res
    # ... and then the answer is checked against the sim's own unwrapped log,
    # which is not derived from it. Skipped after a reset: the device's frame
    # counter (and the sim's absolute timeline with it) restarts at 0, so the
    # two sides have no common origin to be constant about.
    truth = [sim.write_frames[i] for i in ev_i]
    if not sim.resets and len(truth) == len(got_frames):
        offs = _unwrap_offsets(got_frames, truth)
        res["unwrap_offsets"] = offs
        if len(offs) > 1:
            res["refused"] = (f"the frame log unwrapped to {len(offs)} different "
                              f"offsets from the device's own unwrapped log "
                              f"{offs}: at least one write is further than "
                              f"{UNWRAP_GAP_BOUND} frames from the one before it")
            res["reasons"].append(f"REFUSED: {res['refused']}")
            res["ok"] = False
            return res
    got = [(f - p0, w[1], w[2], w[3], w[4]) for f, w in zip(got_frames, ev)]
    exp = list(want["timed"])
    if want["held"]:
        # the gate-off(s) first, then the phrase: the phrase is checked
        # relative to its own first write (the host shifts it past the hold
        # whole), the gate-off against the requested hold
        nh = len(want["held"])
        if [g[1:] for g in got[:nh]] != want["held"]:
            res["reasons"].append("the held note's gate-off is not the first "
                                  "timed write")
        res["hold_frames_observed"] = got[0][0] if got else None
        got = got[nh:]
        if got:
            base_g, base_e = got[0][0], exp[0][0]
            got = [(g[0] - base_g, *g[1:]) for g in got]
            exp = [(e[0] - base_e, *e[1:]) for e in exp]
    timing_bad = sum(1 for g, e in zip(got, exp) if g[0] != e[0])
    value_bad = sum(1 for g, e in zip(got, exp) if g[1:] != e[1:])
    res["timing_bad"], res["value_bad"] = timing_bad, value_bad
    if len(got) != len(exp):
        res["reasons"].append(f"{len(got)} timed writes executed, {len(exp)} intended")
    if timing_bad:
        first = next((g, e) for g, e in zip(got, exp) if g[0] != e[0])
        res["reasons"].append(f"{timing_bad} timed writes off their frame "
                              f"(first: at {first[0][0]}, intended {first[1][0]})")
    if value_bad:
        res["reasons"].append(f"{value_bad} timed writes with wrong values/order")
    # feasibility numbers, from the device's own acceptance log
    acc = [(f, due) for k, v in sim.received if k == "event" for f, due, *_ in [v]]
    slack = [((due - f) & 0xFFFF) for f, due in acc]
    slack = [s if s < 0x8000 else s - 0x10000 for s in slack]
    span = (got_frames[-1] - got_frames[0]) if got_frames else 0
    res["metrics"] = {
        "peak_queue": sim.evq_peak, "queue_depth": uh.EVENT_QUEUE_DEPTH,
        "min_deadline_slack_frames": min(slack) if slack else None,
        "event_packets": len(acc),
        "status_polls": sim.status_requests,
        "phrase_span_frames": span,
        "phrase_span_s": round(span / SR, 4),
        "counter_wraps_crossed": ((p0 + span) >> 16) - (p0 >> 16) if span else 0,
        "host_sim_seconds": round(h.clock.t, 3),
        "spreading": want["spreading"],
    }
    bound = uh.EVENT_QUEUE_DEPTH - uh.ROLLING_QUEUE_MARGIN
    if sim.evq_peak > bound:
        res["reasons"].append(f"queue peaked at {sim.evq_peak}, above the "
                              f"planned bound {bound}: the cut's occupancy "
                              "model is not conservative")
    res["ok"] = not res["reasons"]
    return res


# ---- the RTL replay of the host's actual bytes -------------------------------
def _packets(data: bytes) -> list:
    sizes = {dev.OP_WRITE: 8, dev.OP_EVENT: 10, dev.OP_STATUS: 2, dev.OP_ABORT: 2}
    out, i = [], 0
    while i < len(data):
        n = sizes[data[i]]
        out.append(data[i:i + n])
        i += n
    return out


def write_rtl_capture(run: dict, prefix: Path) -> dict:
    """<prefix>.cmds/.plan.json in verify_uart_bridge's replay format, from
    the host's TRANSMIT LOG (the bytes main() actually wrote, at the frames
    it wrote them) with expectations from the INTENDED schedule. Requires a
    run from epoch 0 so device frames and bench frames coincide."""
    h, want = run["h"], run["want"]
    if h.sim.epoch != 0 or h.sim.resets:
        raise ValueError("RTL capture needs an epoch-0 run with no reset")
    p0 = h.bridge.performance_origin
    # the wire at the TRUE baud (the bench serialises bits of 1e9/baud ns):
    # 10*CLK/baud = 1066.7 cycles a byte, not the receiver's 10*div = 1070.
    # Across a 202-packet back-to-back setup burst the difference is 21
    # frames -- a receiver re-syncs per start bit, but a continuous burst's
    # bytes arrive at the SENDER's rate. Acceptance is the planner's rule:
    # the last byte's stop-bit centre as the receiver samples it.
    bc = 10 * uh.CLK_HZ / uh.DEFAULT_BAUD
    div = (uh.CLK_HZ + uh.DEFAULT_BAUD // 2) // uh.DEFAULT_BAUD
    rows, static_i, timed_i = [], 0, 0
    wire_free = 0
    first_event_t = next(t for t, b in h.ser.tx_log if b and b[0] == dev.OP_EVENT)
    k = round((first_event_t * SR - p0) / 65536)
    p0u = p0 + 65536 * k                       # t=0 on the bench's timeline
    for t, data in h.ser.tx_log:
        send = int(t * SR) + 1                 # the bench starts on a frame edge
        for pkt in _packets(data):
            start = max(send * uh.CYC_PER_FRAME + 1, wire_free)
            end = start + len(pkt) * bc
            wire_free = end
            push = start + (len(pkt) - 1) * bc + 4 + 9 * div + div // 2
            accept = int(push // uh.CYC_PER_FRAME)
            row = {"index": len(rows), "packet": pkt.hex(), "send_frame": send,
                   "accept_frame": accept}
            if pkt[0] == dev.OP_WRITE:
                f, s_, a, d = want["static"][static_i]
                static_i += 1
                row.update(kind="write", due=-1, apply_frame=accept + 1,
                           expect={"flag": f, "sec": s_, "addr": a, "data": d})
            elif pkt[0] == dev.OP_EVENT:
                rel, f, s_, a, d = want["timed"][timed_i]
                timed_i += 1
                row.update(kind="event", due=p0u + rel, apply_frame=p0u + rel,
                           expect={"flag": f, "sec": s_, "addr": a, "data": d})
            elif pkt[0] == dev.OP_STATUS:
                row.update(kind="status", due=-1, apply_frame=-1, expect=None)
            else:
                raise ValueError(f"unexpected opcode 0x{pkt[0]:02x} in the host log")
            rows.append(row)
    prefix.parent.mkdir(parents=True, exist_ok=True)
    with open(f"{prefix}.cmds", "w") as fh:
        for r in rows:
            fh.write(f"S {r['send_frame']} {bytes.fromhex(r['packet']).hex(' ')}\n")
    rec = {"origin": 0, "baud": uh.DEFAULT_BAUD, "base_send_frame": 0,
           "performance_origin": p0u, "source": "SimSerial transmit log",
           "rows": rows}
    Path(f"{prefix}.plan.json").write_text(json.dumps(rec, indent=1) + "\n")
    return {"rows": len(rows), "writes": static_i, "events": timed_i,
            "last_due": max((r["due"] for r in rows), default=0)}


def rtl_replay(fixture: str, outdir: Path, reuse: bool = False, *,
               image: str = uh.DEFAULT_IMAGE, target: str | None = None) -> dict:
    """The capture (the evidence of what was replayed) lands in `outdir`;
    the bench's bulky wave/I2S dumps stay under build/, one directory per
    (sender, target) so a reuse can never cross images."""
    import verify_uart_bridge as vub
    target = target or image
    run = run_cli(fixture, image=image, target=target)
    sim_res = check(run)
    if not sim_res["ok"]:
        # a wrong sender is found here, in seconds, before any RTL
        return {"state": "FAIL" if sim_res.get("init_check") else "REFUSED",
                "reason": "the sim run is not clean; replaying it would test nothing",
                "sim": sim_res}
    cap = write_rtl_capture(run, outdir / fixture)
    work = "rolling-rtl" if (image, target) == (uh.DEFAULT_IMAGE, uh.DEFAULT_IMAGE) \
        else f"rolling-rtl-{image}-for-{target}"
    # the RTL defines and the model are the TARGET image's configuration
    # (r2: PULSE2X=1; vub.image_config); the run identity records the defines,
    # so a reuse can never cross configurations either
    with vub.image_config(target):
        rr = vub.simulate_replay(str(outdir / fixture),
                                 ROOT / "build" / work / fixture,
                                 tail_frames=int(TAIL_S * SR),
                                 # ~258k frames of the full wrapper: 3600 s
                                 # reached 87% on a loaded machine (62 fr/s)
                                 timeout_s=RTL_TIMEOUT_S, reuse=reuse)
        if rr is None:
            return {"state": "REFUSED", "reason": "RTL replay did not run",
                    "capture": cap}
        ok, comp, detail = vub.analyze(rr)
        # completeness (#300 review): every period the stimulus requires, and a
        # control showing the check can fail
        trunc = vub.truncation_control(rr)
    # the run's RECEIPT (sources, ROMs, defines, stimulus, length, output
    # digests) is published beside the result it produced
    receipt = Path(rr["outdir"]) / "run_identity.json"
    published = outdir / f"{fixture}.run_identity.json"
    published.write_bytes(receipt.read_bytes())
    out = {"state": ("NO VERDICT" if comp.get("i2s_incomplete") or not trunc["caught"]
                     else "PASS" if ok else "FAIL"), "capture": cap,
           "truncation_control": trunc,
           "comparison": comp, "detail": detail[:10],
           "reused_rtl_run": bool(rr.get("reused")),
           "rtl_run": vub.rtl_run_report(rr),
           "run_receipt": {"path": published.name,
                           "sha256": hashlib.sha256(published.read_bytes()).hexdigest()}}
    with vub.image_config(target):
        out["control"] = rtl_control(fixture, outdir, vub, work)
    if not out["control"]["caught"] and out["state"] == "PASS":
        out["state"] = "FAIL"
    return out


def rtl_control(fixture: str, outdir: Path, vub, work: str = "rolling-rtl") -> dict:
    """The comparison must be able to fail: move ONE intended event a single
    frame later in the expectation (stimulus untouched) and re-analyse the
    same RTL run. It must report that event off its frame."""
    import shutil
    src = outdir / fixture
    ctl = outdir / f"{fixture}-control-due+1"
    shutil.copyfile(f"{src}.cmds", f"{ctl}.cmds")
    rec = json.loads(Path(f"{src}.plan.json").read_text())
    evs = [r for r in rec["rows"] if r["kind"] == "event"]
    victim = evs[len(evs) // 2]
    victim["due"] += 1
    victim["apply_frame"] += 1
    Path(f"{ctl}.plan.json").write_text(json.dumps(rec, indent=1) + "\n")
    rr = vub.simulate_replay(str(ctl), ROOT / "build" / work / fixture,
                             tail_frames=int(TAIL_S * SR), reuse=True)
    if rr is None:
        return {"caught": False, "reason": "control could not re-analyse"}
    ok, comp, detail = vub.analyze(rr)
    caught = (not ok) and comp.get("frame_pred_bad") == 1 and not comp.get("i2s_incomplete")
    return {"caught": caught, "victim_index": victim["index"],
            "frame_pred_bad": comp.get("frame_pred_bad"),
            "wire_mismatch": comp.get("wire_mismatch"), "detail": detail[:3]}


# ---- controls ---------------------------------------------------------------
def _flip_one_event(nth: int):
    """Wire fault: flip one payload bit of the nth scheduled-event packet."""
    seen = {"n": 0}

    def mutate(data: bytes) -> bytes:
        out = bytearray(data)
        for off, pkt in _offsets(data):
            if pkt[0] == dev.OP_EVENT:
                seen["n"] += 1
                if seen["n"] == nth:
                    out[off + 5] ^= 0x01
        return bytes(out)
    return mutate


def _offsets(data: bytes):
    i = 0
    for pkt in _packets(data):
        yield i, pkt
        i += len(pkt)


CONTROLS = {
    # name: (fixture, run kwargs, predicate on the result, the reason)
    "ROLL_QUEUE_UNAWARE": ("demo", {"inject": "ROLL_QUEUE_UNAWARE"},
                           lambda r: r["drops"] > 0 and any(
                               e[0] == dev.ERR_EVQ_FULL for e in r["device_errors"]),
                           "event-queue overflow reported by the device"),
    "ROLL_TAG_SPLIT": ("bar808-full", {"inject": "ROLL_TAG_SPLIT"},
                       lambda r: r["timed_executed"] < r["timed_intended"]
                       and r["static_executed"] > r["static_intended"],
                       "in-pattern writes executed as setup, missing from the music"),
    "ROLL_NO_UNWRAP": ("bar808-full", {"inject": "ROLL_NO_UNWRAP"},
                       lambda r: r["rc"] != 0 and r["timing_bad"] + abs(
                           r["timed_executed"] - r["timed_intended"]) > 0,
                       "phrase not delivered past the first half-revolution"),
    "WATERMARK_PRELOAD": ("bar808", {"inject": "WATERMARK_PRELOAD", "note": 45},
                          lambda r: r["drops"] > 0 and r["rc"] == 1,
                          "a held-back schedule sent as preload overflows "
                          "the queue; the CLI exits FAIL"),
    "corrupt-byte": ("bar808-full", {"wire_fault": "flip"},
                     lambda r: r["rc"] == 2 and any(
                         e[0] == dev.ERR_CHECKSUM for e in r["device_errors"])
                     and any("never queued" in x and "ERR [5]" in x
                             for x in r["reasons"]),
                     "checksum ERR; the host sees the missing event at its "
                     "next window and REFUSES rather than play on with a hole"),
    "UNWRAP_LONG_REST": ("bar808-rest", {},
                         lambda r: bool(r.get("refused"))
                         and "16-bit frame log" in r["refused"],
                         "consecutive writes 0x8000 frames or more apart: the "
                         "device's 16-bit log cannot be unwrapped, so the run "
                         "is REFUSED rather than mis-measured"),
    "reset-mid": ("demo", {"reset_after_events": 100},
                  lambda r: r["rc"] == 2 and r["resets"] == 1
                  and r["timed_executed"] < r["timed_intended"],
                  "host REFUSES after the reset instead of continuing"),
}


def run_control(name: str, image: str = uh.DEFAULT_IMAGE, target: str | None = None) -> dict:
    fixture, kw, pred, reason = CONTROLS[name]
    kw = dict(kw)
    if kw.get("wire_fault") == "flip":
        kw["wire_fault"] = _flip_one_event(120)
    r = check(run_cli(fixture, image=image, target=target, **kw))
    caught = (not r["ok"]) and bool(pred(r))
    return {"control": name, "fixture": fixture, "intended_reason": reason,
            "caught": caught, "reasons": r["reasons"],
            "rc": r["rc"], "timed": [r["timed_executed"], r["timed_intended"]],
            "static": [r["static_executed"], r["static_intended"]],
            "device_errors": sorted({e[0] for e in r["device_errors"]})}


def wrong_kit_control(fixture: str, target: str) -> dict:
    """The sender plays the RELEASE (revision-11) kit under `--image <target>`
    (r1 or r2; uart_host INJECT WRONG_KIT) while the expectation stays the
    frozen R1 target. Caught only if the check fails FOR THE KIT: the
    init-byte check names the kit or the final strike (plan088)."""
    r = check(run_cli(fixture, image=target, target=target, inject="WRONG_KIT"))
    init = r.get("init_check") or []
    kit_named = any("kit" in p or "ENV_FRATE" in p for p in init)
    return {"control": "WRONG_KIT", "fixture": fixture,
            "intended_reason": "the sender's revision-11 kit under a frozen revision-14 target "
                               "is a host-correctness FAIL at the init bytes",
            "caught": (not r["ok"]) and kit_named, "reasons": r["reasons"][:4],
            "init_check": init, "rc": r["rc"]}


def main(argv=None) -> int:
    ap = argparse.ArgumentParser(description=__doc__.split("\n")[0])
    ap.add_argument("--outdir", type=Path,
                    default=ROOT / "fpga/reports/arty/rolling-playback")
    ap.add_argument("--rtl", nargs="*", default=None, metavar="FIXTURE",
                    help="also replay the host bytes through the UART RTL")
    ap.add_argument("--reuse-rtl", action="store_true",
                    help="re-analyse the RTL run on disk (refused unless its "
                         "stimulus is byte-identical to this capture's)")
    ap.add_argument("--epochs", default="0,32000,65300",
                    help="device frame counter at the host's first STATUS")
    ap.add_argument("--reuse-rtl-if-identical", action="store_true",
                    help="re-analyse the RTL run on disk when its full identity (sources, "
                         "defines, stimulus, length, outputs) is this run's; else simulate")
    ap.add_argument("--image", default=None, choices=sorted(uh.IMAGE_REVISION),
                    help="the SENDER's image selector (uart_host --image); default release")
    ap.add_argument("--expect-image", default=None, choices=sorted(uh.IMAGE_REVISION),
                    help="the TARGET the expectation is built for. Required with --image: "
                         "the target is never inferred from the sender (plan088)")
    ap.add_argument("--expect-fail", action="store_true",
                    help="exit 0 only if every clean case FAILS at the init bytes (a sender "
                         "that is not the target); no RTL, no host controls")
    a = ap.parse_args(argv)
    if a.image is not None and a.expect_image is None:
        print("verify_rolling_playback: REFUSED -- --image names the sender; state the "
              "target with --expect-image (it is never inferred from the sender)")
        return 2
    image = a.image or uh.DEFAULT_IMAGE
    target = a.expect_image or image
    try:
        if target in uh.R1_KIT_IMAGES:
            r1c.frozen_kit()                    # the frozen target exists, or nothing runs
        for fx in FIXTURES:
            intended(fx, image=target)          # the expectation is the target, or REFUSED
    except (r1c.Refused, ValueError) as exc:
        print(f"verify_rolling_playback: REFUSED -- {exc}")
        return 2
    epochs = [int(e) for e in a.epochs.split(",")]
    a.outdir.mkdir(parents=True, exist_ok=True)
    ok = True
    clean = {}
    cases = [(fx, ep, None) for fx in FIXTURES for ep in epochs]
    if not a.expect_fail:
        cases += [(fx, ep, 45) for fx in FIXTURES + ("bar808",) for ep in (0, 65300)]
    for fx, ep, note in cases:
            r = check(run_cli(fx, epoch=ep, note=note, image=image, target=target))
            key = f"{fx}@{ep}" + (f"+note{note}" if note is not None else "")
            clean[key] = r
            ok &= r["ok"]
            m = r.get("metrics", {})
            print(f"rolling[{key}]: {'PASS' if r['ok'] else 'FAIL'} -- "
                  f"timed {r['timed_executed']}/{r['timed_intended']}, static "
                  f"{r['static_executed']}/{r['static_intended']}, peak queue "
                  f"{m.get('peak_queue')}, min slack "
                  f"{m.get('min_deadline_slack_frames')} fr, wraps "
                  f"{m.get('counter_wraps_crossed')}"
                  + ("" if r["ok"] else f" -- {r['reasons']}"))
    ident = {"sender": image, "target": target,
             "target_contract_revision": uh.IMAGE_REVISION[target],
             "target_kit_sha256": (r1c.KIT_R14_SHA256 if target in uh.R1_KIT_IMAGES else None)}
    refused = {k: r["refused"] for k, r in clean.items() if r.get("refused")}
    if refused:
        # the apparatus could not measure these runs. That is not a FAIL about
        # the host, and must not be reported as one (#474).
        record = {"tool": "fpga/verify_rolling_playback.py", "image": ident,
                  "clean": clean, "controls": {}, "state": "REFUSED",
                  "refused": refused}
        (a.outdir / "verification.json").write_text(
            json.dumps(record, indent=2, default=str) + "\n")
        for k, why in refused.items():
            print(f"verify_rolling_playback: REFUSED [{k}] -- {why}")
        return 2
    if a.expect_fail:
        fails = {k: r.get("init_check") for k, r in clean.items()}
        caught = bool(clean) and all((not r["ok"]) and r.get("init_check")
                                     for r in clean.values())
        record = {"tool": "fpga/verify_rolling_playback.py", "image": ident, "clean": clean,
                  "controls": {}, "state": "FAIL" if caught else "PASS",
                  "expect_fail": {"caught": caught, "init_check": fails}}
        (a.outdir / "verification.json").write_text(
            json.dumps(record, indent=2, default=str) + "\n")
        print(f"rolling: expect-fail {'CAUGHT' if caught else 'NOT CAUGHT'} -- sender "
              f"{image}, target {target}")
        return 0 if caught else 1
    controls = {}
    for name in CONTROLS:
        c = run_control(name, image=image, target=target)
        controls[name] = c
        ok &= c["caught"]
        print(f"rolling control {name}: {'CAUGHT' if c['caught'] else 'MISSED'} "
              f"-- {c['reasons'][:2]}")
    if target in uh.R1_KIT_IMAGES:
        for fx in FIXTURES:
            c = wrong_kit_control(fx, target)
            controls[f"WRONG_KIT:{fx}"] = c
            ok &= c["caught"]
            print(f"rolling control WRONG_KIT[{fx}]: {'CAUGHT' if c['caught'] else 'MISSED'} "
                  f"-- {c['init_check'][:2]}")
    record = {"tool": "fpga/verify_rolling_playback.py", "baud": uh.DEFAULT_BAUD,
              "image": ident, "clean": clean, "controls": controls,
              "state": "PASS" if ok else "FAIL"}
    if a.rtl is not None:
        rtl = {}
        for fx in (a.rtl or ["demo"]):
            rr = rtl_replay(fx, a.outdir / "rtl-replay",
                            reuse="auto" if a.reuse_rtl_if_identical else a.reuse_rtl,
                            image=image, target=target)
            rtl[fx] = rr
            ok &= rr["state"] == "PASS"
            comp = rr.get("comparison", {})
            print(f"rolling RTL[{fx}]: {rr['state']} -- writes "
                  f"{comp.get('writes_seen')}/{comp.get('writes_sent')}, timing bad "
                  f"{comp.get('frame_pred_bad')}, I2S mismatch "
                  f"{comp.get('wire_mismatch')} over {comp.get('periods')} periods"
                  + (f"; control due+1 "
                     f"{'CAUGHT' if rr.get('control', {}).get('caught') else 'MISSED'}"
                     f" ({rr.get('control', {}).get('frame_pred_bad')} off-frame)")
                  + (f" -- {rr.get('detail') or rr.get('reason')}"
                     if rr["state"] != "PASS" else ""))
        record["rtl"] = rtl
        nv = any(r["state"] in ("NO VERDICT", "REFUSED") for r in rtl.values())
        record["state"] = "NO VERDICT" if nv else "PASS" if ok else "FAIL"
        if nv:
            (a.outdir / "verification.json").write_text(
                json.dumps(record, indent=2, default=str) + "\n")
            return 2
    (a.outdir / "verification.json").write_text(
        json.dumps(record, indent=2, default=str) + "\n")
    return 0 if ok else 1


if __name__ == "__main__":
    raise SystemExit(main())
