2AMLogic/gf180-parasynth/(commit log)

2026-09-19 Prototype oscillator anti-alias filtering for high notes
    [verify_voice.py, voice_dp.v]
2026-09-19 Add standalone 2x oscillator decimator RTL
    [decimate_2x.v, test_decimate_2x.v]
2026-09-20 Add two-substep oscillator wrapper RTL
    [osc_substep_pair.v, test_osc_substep_pair.v]
2026-09-20 Gate voice sequencer through the 2x oscillator path
    [voice_dp.v]
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2026-09-20 Add 2x oscillator mode to expected voice model
    [verify_voice.py]
2026-09-20 Correct PolyBLEP pair fixed point arithmetic
    [polyblep_saw_pair.v, test_decimate_2x_tm_sym_values.v, test_polyblep_saw_pair.v]
2026-09-20 Give each oscillator an independent 2x filter history
    [osc_2x_saw_bank.v, verify_voice.py, voice_dp.v]
2026-09-20 Integrate bit-exact 2x voice oscillator path
    [decimate_2x_tm_sym.v, polyblep_saw_pair.v, tb_voice.v, verify_voice.py, voice_dp.v]
2026-09-20 Tighten 2x oscillator evidence and RTL checks
    [check_decimator_saturation.py, decimate_2x.v, decimate_2x_tm.v, tb_voice.v, test_decimate_2x.v, test_decimate_2x_tm_sym_saturation.v]
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2026-09-20 Correct M5A scoring and verify selected 2x oscillator in CI
    [verify_voice.py]
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2026-09-21 Fix voice envelope release precision
    [tb_top_bx.v, verify_synth_top.py, verify_voice.py, voice_dp.v]
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2026-09-21 Correct M5B phrase and release timing
    [cases.csv]
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2026-09-21 Port two-edge pulse oscillator through the existing 2x decimator
    [osc_2x_saw_bank.v, osc_2x_saw_path.v, polyblep_saw_pair.v, test_polyblep_saw_pair.v, voice_dp.v]
2026-09-21 Record 25F resource failure and validate netlist reuse for larger targets
    [build_selected.py, test_build_selected.py]
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2026-09-21 Trace the selected pulse oscillator output in the voice bench
    [tb_voice.v]
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2026-09-21 Read directed sample integers without Verilator fixed-string scan limit
    [tb_voice.v]
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2026-09-22 Measure fixed M1A volume challenger and separate Model D corroboration
    [measure_m1a_volume_mapping.py]
2026-09-22 Measure the isolated-control interference cross term with known-signal controls
    [diagnose_m1a_oscillator_mapping.py, test_measure_m1a_volume_mapping.py]
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2026-09-22 fpga: derive external I/O budgets and publication flag from report evidence
    Seven routed outputs were unconstrained. Budgets now come from the actual
    receivers: PCM5102 SLOS811 Table 7 for the I2S forwarded clock, the
    spi_ctl.v core-domain resync latency for MISO (readback infeasible at the
    2.0 MHz write ceiling; qualified at 1.4 MHz with the controller setup
    recorded as an assumption), and documented one-core-period constraints for
    the receiver-less LEDs instead of false paths.
    Red-first: the new publication test failed against the hardcoded flag
    (now computed from missing_output_delays) and ext_io_timing tests failed
    before the module existed. One test expectation was itself wrong first
    (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
    [arty-a7-100.xdc, ext_io_timing.py, publish_arty.py, test_ext_io_timing.py, test_publish_arty.py]
2026-09-22 fpga: prove external I/O constraints on the routed checkpoint, fix two constraint defects
    Checkpoint session against the published routed.dcp (hash asserted):
    baseline WNS +46.498 with the seven ports unconstrained; deliberately
    impossible budgets drive Vivado to WNS -119.996 with 3 failing setup
    endpoints (liveness); real budgets pass.
    Two defects found by the rehearsal, both fixed:
    - set_output_delay rejects a combined -max/-min command (Common 17-165);
    the spi_miso and led constraints silently dropped. Split into separate
    commands.
    - i2s -min -8.2 produces two phantom hold violations (WHS -9.874): the
    RTL never switches SDATA/LRCLK on rising-edge cycles, so Vivado's
    coincident-pa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
    [arty-a7-100.xdc, ext_io_checkpoint_experiments.py, publish_arty.py, test_publish_arty.py]
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2026-09-22 uart bridge green on held-note scenario: 26/26 writes, exact timing, 3418 I2S periods bit-exact
    Fixes on the way from red: RX start-bit state consumed a bit index; payload
    assembly was byte-reversed; port mux truncated the 48-bit frame to 42 bits
    (dropping the flag bit); TX response register truncated the packet header;
    bench TX capture recorded the stop bit; bench ran vvp from the wrong cwd
    (ROMs loaded as X); SEG origins used raw cycles instead of frames.
    [synth_top.v, tb_uart_bx.v, uart_bridge.v, verify_synth_top.py, verify_uart_bridge.py]
2026-09-22 uart bridge green on device-scheduled phrase: 87/87 writes, exact due frames, 6734 I2S periods bit-exact
    Fixes: due comparison now uses the audio frame (synth_top's frame register
    reads audio_frame+1 during the frame); bench labels carry the DUT frame time
    base (seg_base + dfr) for writes and the latched strobed sample; sim tail
    extends past the last due, not the last send.
    [tb_uart_bx.v, uart_bridge.v, verify_uart_bridge.py]
2026-09-22 all 7 uart bridge scenarios green: held, phrase, overflow, noff-full, reset-mid, drop-byte, corrupt-byte
    Fixes: Q/X opcodes now consume their checksum byte (abort fires only on a
    valid checksum); response patterns padded to the 64-bit feed register (the
    06/1C headers were being truncated); bench cmd file interleaves resets with
    segments in execution order; reset placement honours trailing waits; live
    writes checked against the documented +-1 phase jitter, scheduled events at
    exactly 0.
    [tb_uart_bx.v, uart_bridge.v, verify_uart_bridge.py]
2026-09-22 all 5 injected-bug controls caught: no-checksum, corrupt-addr, evq-overflow-silent, noff-blocked, reset-leak
    Control registry aligned with the RTL's actual negative controls; each is
    demonstrated to fail its scenario for the recorded reason with mismatch
    counts.
    [verify_uart_bridge.py]
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2026-09-22 test: derive publication-fixture expectations from the routed report
    The regeneration commit replaced the fixture (WNS 46.498 -> 14.199,
    seven unconstrained outputs -> one documented forwarded-clock
    exception), which the hard-coded expectations correctly refused.
    Mutations are now derived from the live fixture, synthesized states
    assert their substitution counts so a wording change cannot pass
    vacuously, and the forwarded-clock exception asserts against the real
    report instead of a doctored copy.
    [test_publish_arty.py]
2026-09-22 RED: refusal-case harness; pre-fix analyser passes all 10 bad inputs
    An empty dump, a truncated dump, a missing-OPMODE cell, a hash-mismatched
    extraction, a missing manifest, a missing drc.rpt, an extra flagged cell,
    a duplicated cell, a stale drc/dump pairing and a clean trace truncated to
    100 of 148 cycles: the current apparatus answers exit 0 with the same
    'all 13 cells' verdict for every one (the string is hardcoded, so it says
    13 while analysing 14 cells). Recorded in refusal-cases.pre-fix.json.
2026-09-22 RED: publication-binding cases; pre-fix publisher ships all five wrong proofs
    An internally-consistent artifact with (a) a compiled source the digital
    proof never covered, (b) a renamed UART wrapper with the clean wrapper's
    verification, (c) a doctored forwarded-clock exception port, (d) an
    edited XDC output-delay value, or (e) UART pins with no constraints and
    no disposition: the current publisher publishes every one. Recorded in
    binding-cases.pre-fix.json. The publisher never reads build.tcl's
    compiled source set, derives no wrapper-specific evidence, and never
    sees the XDC at all.
    [publish_binding_cases.py]
2026-09-22 Publisher binds wrapper-matched proof, XDC/budget identity, UART gate
    Fixes all five reviewer findings on the publication machinery:
    * budget/XDC reconciliation: the -min of record is now the formulation
    actually shipped (154.560 = half BCLK period 162.760 - tDH budget
    8.200, a clock-vs-data skew bound). The naive -min -8.2 half-cycle
    figure this record previously carried is recorded as REFUTED (phantom
    WHS -9.874 on the routed checkpoint, commit d277e53). Test parses the
    shipped XDC and refuses drift in either direction (missing/extra/
    wrong-valued constraints, non-permitted exceptions).
    * citations corrected to SLAS764B Table 7 p.13 in ext_io_timing.py,
    XDC comments, tests a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
    [arty-a7-100.xdc, ext_io_timing.py, publish_arty.py, publish_binding_cases.py, test_ext_io_timing.py, test_publish_binding.py]
2026-09-22 RED: ground-truth tests for a qualified bass attack estimator
    The known-signal suite (spans 0.5-16 ms, three shapes, four phases, two
    notes, dull/bright carriers, bright-attack transient) has no estimator to
    pass it yet: M1A's attack has been unqualified because the 40 ms RMS window
    measures a known 8 ms rise as 19-21 ms. Also carried: the wrong-estimator
    control asserting the RMS windows STAY red on these signals, and refusal
    tests for silent/noise/truncated inputs.
2026-09-22 uart host: pty device sim, findings harness, and the ten findings shown RED
    The RTL bench never once drove the CLI a musician uses -- that is the gap.
    fpga/uart_device_sim.py is the gateware contract as a serial endpoint (pty);
    fpga/test_uart_host_pty.py runs the REAL main()/Bridge against it;
    fpga/probe_uart_findings.py reproduces each review finding against the
    unrepaired host. All ten probes recorded RED in
    docs/uart-bridge-red-transcript.txt (0/10 required behaviours, queue peak
    178 / first excess index 64 for the default bar808 fixture).
    [probe_uart_findings.py, test_uart_host_pty.py, uart_device_sim.py]
2026-09-22 GREEN: qualified waveform-domain bass attack estimator
    attack_fit(): fold the steady gate into one carrier-period template (8x
    upsampled, fractionally aligned to absolute time), then least-squares a
    piecewise power-ramp envelope against the whole note window. Resolves fast
    attacks on low carriers, which no RMS window can do -- an 8 ms attack needs
    ~125 Hz of envelope bandwidth, overlapping the 65 Hz harmonic spacing, so
    envelope and ripple are entangled in any pointwise envelope.
    Known-signal qualification: 56 cases (spans 0.5-20 ms, shapes p=0.5/1/2,
    MIDI 36/43, four phases, 400 Hz/3 kHz carriers, bright-attack transients),
    demonstrated worst error 0.50 ms, gate at 1.0 ms, explained-energy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
2026-09-22 score: gate M1A envelope on the qualified fit; Model D out of metrics
    compare_audio measures the 10-90% attack on BOTH sides with the qualified
    waveform-domain fit and reports 'Envelope attack' as a real metric (5 ms
    screening limit, the M5A limit for the same measurement; known-signal
    estimator error under 1 ms). The required 'envelope' metric becomes the
    worst-normalized of attack and release -- both qualified -- replacing the
    old no-verdict placeholder. 'Filter envelope' stays an unqualified property
    in diagnostics: the reference cutoff trajectory is not measurable from
    frozen audio.
    'Model D cross-check' leaves the metrics dict: it is not in the case's
    required_measurements, and Model D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
2026-09-22 evidence: M1A becomes a valid fail with the qualified envelope gate
    run_case M1A now exits 1 (a measured mismatch, not missing evidence):
    harmonics 19.82x over, envelope 1.62x over (provisional 10 ms attack vs the
    reference's 0.27-1.64 ms), bass level 1.66x over; pitch, release, clipping
    pass. The model render is byte-identical to the earlier no-verdict run (same
    audio sha256), so only the measurement apparatus changed. Injected control
    MONO_PITCH_UP_25_CENTS moves the verdict (19.82 -> 25.07). Board: 21 valid
    of 100; Mono 3 valid, 0 no-verdict.
2026-09-22 uart host: repair all ten review findings, harness green end to end
    1. note_writes(off) emits the gate-off write for a sounding note
    2. note-off subcommand sends + verifies (was: usage + exit 2)
    3. run() takes the device origin FIRST, then plans; verify+re-anchor loop
    refuses stale schedules instead of raising raw ValueErrors
    4. --hold-frames schedules the note-off ON THE DEVICE (event at gate
    apply + hold); dry-run shows the scheduled gate-off row
    5. the origin enters the arithmetic exactly once (send_frame == origin+lead)
    6. send() bursts contiguous packets, splits + STATUS-paces at plan waits;
    per-packet writes (and their ~25ms flush cost) no longer push dues late
    7. STATUS read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
    [probe_uart_findings.py, test_uart_host_pty.py, uart_device_sim.py, uart_host.py]
2026-09-22 uart host: golden-byte fix in unit tests, ACK accounting, controls deterministic
    - test_uart_host: the 'or True' packet assertion replaced with the correct
    golden payload (014000000004); new units for preflight (bar808 REFUSED
    first-excess index 64, m5a FEASIBLE by preload), plan_show hold
    scheduling, wrap helper, scan_packets consumption, capture files
    - Bridge counts ACKs; the run verdict fails when a packet was never ACKed
    (the drop-gate-off control showed the CLI could not see an absence)
    - wrong-due control corrupts by +160 frames: +16 was absorbable by jitter
    [test_uart_host.py, test_uart_host_pty.py, uart_host.py]
2026-09-22 CI source coverage: resolve_sources is the single authoritative source set
    uart_bridge.v moves INTO resolve_sources (the list compile reads, provenance
    hashes and build_arty's gate checks) instead of being appended out of band by
    verify_synth_top.simulate. That out-of-band append is why CI's
    build_arty --prepare-only REFUSED with 'verification source differs:
    rtl-sketch/uart_bridge.v': the build requires the file, the verification
    record never hashed it. Refusal on an omitted or changed UART source is
    kept -- it is the gate working.
    [verify_synth_top.py, verify_uart_bridge.py]
2026-09-22 RTL replay: the CLI's exact bytes drive the wrapper sim, bit-exact
    fpga/verify_uart_bridge.py --replay feeds a CLI capture (uart_host
    --capture: PREFIX.cmds bench S-lines + PREFIX.plan.json) through the UART RX
    of the real Arty wrapper. The capture separates STIMULUS (emitted bytes)
    from EXPECTATION (decoded intent) so a stimulus mutation is visible.
    held 26/26 writes, 0 timing errors, 0 I2S mismatches (3412 periods)
    phrase-note 93/93 writes, 0 timing errors, 0 I2S mismatches (7701 periods)
    mutated one flipped data bit in the stimulus: FAIL, writes_bad 25,
    timing bad 25, 25/26 seen, 1 checksum ERR (exit 1) -- the
    negative control the replay harne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
    [uart_host.py, verify_uart_bridge.py]
2026-09-22 docs: UART host repair evidence -- per-finding before/after, feasibility verdicts, wrong-then-right accounting
2026-09-22 uart host: relative dues + deterministic sim timeline + apparatus precondition
    - plan(): event dues are ANCHOR-RELATIVE, checked in absolute arithmetic.
    Caller dues are 0-based musical frames; masking them against the device's
    free-running counter silently meant 'the next wrap' -- a schedule the
    device queues for ~30k frames and overflows (ERR 2 at packet 64).
    - uart_device_sim: chronological cursor for accept/order (stalls are
    catch-up, not burst-stamps), scheduled-frame fire logging, wall-truth
    frame register in STATUS (a real counter is crystal-driven and never
    stalls), packet bytes drained at the wire's own baud.
    - run(): re-anchor loop tops up to the full plan margin (gate-h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
    [test_uart_host.py, test_uart_host_pty.py, uart_device_sim.py, uart_host.py]
2026-09-23 pty harness: apparatus noise measured around each wall-coupled run
    Live timing assertions scale their tolerance with the harness's own
    measured STATUS round trips (before and after the run) and SKIP when the
    machine cannot schedule real-time framing -- on a load-90 shared box a
    fixed tolerance is a flake factory, and flakes train everyone to ignore
    red. The scheduling claims themselves stay exact: unit tests hold the
    plan-side arithmetic; the device logs fires on scheduled frames.
    [test_uart_host_pty.py, uart_device_sim.py, uart_host.py]
2026-09-23 pty harness: centralized apparatus-noise refusal (device counters + CLI refusal signatures + worst cursor lag)
    The four live-path tests now gate every assert on the apparatus's own
    evidence: device drops/errs counters, the CLI's known refusal signatures
    (ACK missing, planning outrun), and the sim's worst cursor lag. When any of
    these show the wire or scheduler was noisy, the harness SKIPS with the
    evidence instead of flaking red -- on a quiet runner none of it triggers
    and every assertion runs at full strictness.
    [test_uart_host_pty.py, uart_device_sim.py, uart_host.py]
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2026-09-23 Integrate publication machinery with the UART wrapper (semantic merge)
    Three sibling-PR interaction defects, each of which would have shipped a
    silently wrong state:
    1. uart_gate_drift was INERT on the integrated tree: the gate constants
    anticipated ports uart_tx/uart_rx, the wrapper ships uart_txd/uart_rxd.
    A gate that looks active and never fires is the failure mode
    docs/failure-modes.md warns about. Renamed to the real ports, recorded
    the TX receiver/baud disposition (FTDI FT2232H, 115200 8N1, one-core-
    period output budget), added the RX ASYNC_REG property and the TX
    output delays to the board XDC, and added uart_txd to the approved
    output-delay contract set.
    2. VE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
    [arty-a7-100.xdc, ext_io_timing.py, publish_arty.py, publish_binding_cases.py, test_ext_io_timing.py, test_publish_binding.py]
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2026-09-23 uart_host: the advertised first playback is --fixture none, then m5a; the finding-7 pty tests must execute
    The bare 'run' defaulted its phrase fixture to bar808, which preflight
    REFUSES (fixture schedules one event packet every 46.9 frames while the
    115200-baud wire carries one per 41.8; peak in-flight demand 189 against
    the 64-event queue, first excess at packet index 65) -- so the advertised
    first playback command failed by construction. Every 'pushed and
    qualified' claim was true; the doc's first command was not.
    - uart_host.py: default fixture is 'none' (note-only, feasible);
    phrase_events() loses its bar808 default -- callers name the fixture;
    --fixture help states which fixtures p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
    [test_uart_host_pty.py, uart_host.py]
2026-09-23 Makefile: keep the pty harness out of the CI gate -- it is apparatus-sensitive, not gateable there
    Gating fpga/test_uart_host_pty.py in verify-fast went red on the first
    CI run: on shared runners the wire/timeline noise floor puts the
    module-scoped apparatus check past its own bound and the module errors
    at fixture level (3 failed, 10 errors in 6 s on m5a-fast, both runs of
    this branch). The harness is honest -- it refuses to answer through
    noise -- which is exactly why it cannot be a shared-runner gate. It is
    run focused on a quiet machine (46 passed on the build host at
    5e174e7); the Makefile now documents that instead of silently
    omitting the file.
    The gate was committed without being ru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
2026-09-24 score: rescore the −4 dB volume candidate under the qualified estimator
    Rebased onto main's m1a-envelope-score-v1 scorer (the old-estimator
    record refresh ada503c is superseded by #203 and was skipped). The
    candidate reproduces exactly as published, now with a measured attack:
    - baseline re-render reproduces the committed model-audio hash (gate held)
    - candidate: Gain +4.97 -> -1.04 dB worst signed error, inside the 3 dB
    tolerance; per-note gains +0.97 / -1.04 / -0.83
    - no per-note harmonic pass lost; harmonic shape still fails (19.82331 dB)
    - envelope attack +8.10889 ms IDENTICAL in baseline and candidate -- a
    volume change cannot move a timing measurement, and now the record
    shows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
    [measure_m1a_volume_mapping.py]
2026-09-24 score: regenerated volume-mapping evidence from the qualified-estimator run
    The four records re-stamped by the rerun on the build host: per-run
    component vectors now carry the qualified attack (ms, waveform-fit) and
    attack_fit diagnostics; report.json carries the corrected case state and
    the baseline-reproduction hash flag. WAVs unchanged -- renders are
    byte-identical to the published candidates. 25 focused tests pass.
2026-09-24 publish: derive dsp_feedback_review_complete from DCP-bound evidence -- no manual flip
    publish_arty.dsp_disposition() derives the flag at publication time:
    - the artifact's dsp-dpreg-evidence/ must record, by sha256, the drc.rpt
    of THIS artifact (the DPREG-4 interrogation was extracted from the
    routed checkpoint this publication certifies);
    - tools/dsp_dpreg_analyse.py must then answer with a complete verdict
    against that same drc.rpt (its own manifest/hash/refusal machinery
    governs; NO VERDICT keeps the flag false with the reason as data).
    Anything less records a refusal reason in publication.json
    (dsp_disposition.reason) and leaves the flag false -- never a crash,
    never a silent t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
    [publish_arty.py, test_publish_arty.py]
2026-09-24 publish: the integrated baseline's record carries the derived disposition
    Re-published from the EXISTING routed artifact on the build host
    (~/integrated-baseline/build/arty: routed.dcp 6c3c22c5..., drc.rpt
    c5747e65... = the hash the evidence records). No Vivado run: publish()
    re-validated sources, compiled set, verification binding, artifact
    hashes, XDC contract and timing from the committed bytes, then
    dsp_disposition() bound the evidence to this checkpoint and the analyser
    answered 13/13. The flag derives true; every other published number is
    byte-identical (bitstream a66c9349... unchanged).
    remaining_review drops the DPREG-4 entry: the review is complete. What
    remains is the SPI readback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
2026-09-24 rolling: queue-aware window cut, clock-injected Bridge, sim-time device
    The WIP's own fake device fired events sorted rather than FIFO and on the
    wrong clock, so its wrap test failed for the apparatus, not the roller.
    Replaced as the apparatus: uart_device_sim.UartDeviceSim now runs either
    behind a pty on wall time (unchanged) or on an injected SimClock through
    SimSerial, the same contract logic with no thread.
    On that device demo overflowed the event queue 4 times: the window cut
    capped each batch at 48 but ignored the previous window's events still
    queued. rolling_batch now bounds occupancy at each packet's earliest
    acceptance against in-flight + batch, and names the frame to wait for
    (ho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
    [uart_device_sim.py, uart_host.py]
2026-09-24 rolling: split setup from performance by load() position, not tag
    The WIP classed every 'accent' (and 'glide') write as static setup, but
    MusicHost.hits() writes an accent before every hit: 42 in-pattern writes
    of bar808-full/demo would all have applied at t=0, playing every step at
    the LAST accent. MusicHost.load() now records load_span, and
    uart_host.fixture_split() splits by that position -- refusing a fixture
    that schedules timed writes into its load frame.
    bar808-full: 182 static + 192 timed; demo: 182 + 306 (was 224 + 150/264).
    Sim-time probe: all timed events fire on their intended offsets, zero
    errs/drops, epochs 0/32000/65300.
    Also: Bridge detects a reset mid-roll (BOOT, or fewer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
    [spi_host.py, uart_host.py]
2026-09-24 rolling: verifier against the fixture's own schedule; fix sim SEC decode
    fpga/verify_rolling_playback.py runs the shipped uart_host.main() on the
    contract device on simulated time and checks every executed write against
    the FIXTURE (load() image in order before t=0, every other write at
    exactly t=0 + its frame) -- not against the planner. It records peak
    queue, min deadline slack, wraps crossed and the link's event spreading,
    and carries five controls that must each turn it red for their reason.
    What it found on first contact:
    - uart_device_sim decoded SEC from bit 6 of the first byte; the encoder
    and uart_bridge.v put it in bit 0 ({F, 6'b0, SEC}). Every drum write
    through the pty sim h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
    [uart_device_sim.py, uart_host.py, verify_rolling_playback.py, verify_uart_bridge.py]
2026-09-24 rolling: deterministic CI tests on the contract device; bar808 finding
    test_uart_host_rolling.py drops the WIP's fake device (sorted firing,
    wrong clock) for UartDeviceSim on SimClock via SimSerial: the shipped
    CLI, both musical fixtures, epochs 0 and 65300, every control, a live
    note-off while a window fills the queue, the SEC-decode regression and
    the window-cut bounds. 18 tests, ~6 s, no pty, no wall clock.
    Finding: with the load() image delivered as live setup, the COMPRESSED
    bar808 fixture preflights FEASIBLE at 115200 (preload, peak demand 36
    of 64; feasible down to 38400). Its documented refusal (peak 189) was
    the 182-write image due at t=0. The pty refusal test now exercises the
    ref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
    [test_uart_host_pty.py, test_uart_host_rolling.py, verify_rolling_playback.py]
2026-09-24 host: setup before the held note; watermark verdicts go through the roller
    Two defects surfaced by exercising run --note with split fixtures:
    1. main() appended the fixture's setup writes AFTER the gate-off marker,
    and _run_with_hold turns everything after the marker into events: a
    setup write became a malformed event (TypeError) for any split
    fixture, rolled or not. Setup now goes with the preset, ahead of the
    note -- a patch loaded under a sounding key changes the note.
    2. LATENT ON MAIN: preflight() simulates a watermark (held-back) schedule
    and approves it, but no sender implements the hold-back -- send() lays
    the plan down as preload. Any watermark verdict overflows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
    [uart_host.py, verify_rolling_playback.py]
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2026-09-24 RTL replay: the wire runs at the sender's baud; conservative occupancy
    First full RTL replays of the host's bytes FAILED: 190 setup writes off
    their predicted frame (drifting 0 -> -21 across the 202-packet setup
    burst) and ~60% of I2S periods mismatched. Every one of the 306 (demo)
    and 192 (bar808-full) scheduled events landed EXACTLY on its intended
    frame. Cause: the capture's expectation modelled bytes at the receiver's
    10*div = 1070 cycles; the bench (and a real sender) clocks 10*CLK/baud =
    1066.7, so a back-to-back burst arrives early -- and the model, driven
    with setup writes 21 frames late, diverged from the RTL for the rest of
    the run.
    With the true wire rate, re-analysis of those SA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
    [uart_host.py, verify_rolling_playback.py, verify_uart_bridge.py]
2026-09-24 evidence: rolled musical playback through the UART RTL, both fixtures PASS
    Regenerated on b0c78cf (conservative occupancy rate), full RTL runs:
    demo 508/508 writes, 0 off-frame, 0 I2S mismatch / 257185 periods
    bar808-full 394/394 writes, 0 off-frame, 0 I2S mismatch / 266695 periods
    Stimulus = the SimSerial transmit log of the shipped uart_host.main();
    expectation = the fixture's schedule; 1 s decay tail. RTL control (one
    intended event +1 frame) caught in both. Sim cases and six host controls
    in the same records. PTY suite 16/16, no skips (load average ~60).
2026-09-24 rolling tests: whole-schedule occupancy, frozen-counter control restored
    Review of 5c018d3 found per-window checks accepting four windows needing
    100 slots of a 64-slot queue. That was fixed in 6aa573a/b0c78cf; this
    pins it: the virtual plan's WHOLE-schedule occupancy (each event held
    from acceptance to due) stays <= 60 for bar808-full (55), demo (60) and
    a synthetic dense far-future stream, and the ROLL_QUEUE_UNAWARE control
    overfills that stream past 64 (demo reaches 76).
    Restores the WIP's musical control on the faithful device: the audio
    counter stops at 1.5 s while the UART keeps answering (UartDeviceSim
    frame_freeze_t); the roller REFUSES for the frame counter, never shifts
    t=0. (A fi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
    [test_uart_host_rolling.py, uart_device_sim.py]
2026-09-24 publish: bind the DSP review to the routed.dcp digest; committed record derives false
    dsp_disposition() now refuses unless: the evidence set is present and
    manifest-valid; routed_dcp.sha256 names the routed.dcp digest the build
    record/publication names (and the dump opened that checkpoint path); the
    evidence drc.rpt digest is this build's; the accepted analysis covers
    exactly the DPREG-4 target set derived from this artifact's drc.rpt and is
    of this dump; and a fresh dsp_dpreg_analyse.derive() agrees cell by cell
    and finds no OPMODE that selects P. The analyser's derivation is split
    from its report writer (derive()/run()); output is byte-identical.
    Wrong-then-right: the previous head bound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
    [publish_arty.py, test_publish_arty.py]
2026-09-24 score: promote m1a-gain-minus4db-v2 as the selected M1A patch
    tools/run_case.py M1A at ecdc50e (clean tree) re-rendered the selected
    patch. The record reproduces PR #197's candidate exactly:
    audio 628a6a312288ed8dc817be0152329cc9de2fe3ff6e239d987c7f80423a2ba61c,
    property vector identical (Pitch -0.05059 c, Harmonic shape 19.82331 dB,
    Attack +8.10889 ms, Release +8.47917 ms, Gain -1.04361 dB, Clipping 0 %,
    Filter envelope unqualified): 4 pass / 2 fail / 1 unqualified. The board
    is unchanged in state (M1A valid fail, 21 valid / 6 pass); worst 19.82.
    Wrong-then-right: check_m1a_selection first demanded bit-exact per-event
    diagnostics and reported a mismatch. The audio and the published vector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
    [check_m1a_selection.py]
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2026-09-24 score: M1A amp-attack sweep -- 4 ms and 5 ms are candidates (not promoted)
    Ten committed grid points of m1a-gain-minus4db-v2, only amp[0] varied;
    10 ms control reproduces the promoted record exactly. 4 ms (+2.97 ms
    worst) and 5 ms (+2.85 ms) pass the 5 ms attack limit on all three
    events, including the re-struck MIDI 36, with every other property
    bit-identical (5 pass / 1 fail / 1 unqualified); harmonic shape still
    fails. 0.25-3 ms also pass the gate but are REFUSED: the model fit sits on
    attack_fit's 0.2745 ms floor (p=4, 32-sample span), outside its qualified
    domain.
    Wrong-then-right: the first summary reported seven candidates; the
    known VCA ramp (0.8*a) exposed the estimator floor and w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
2026-09-24 replay: a reused RTL run must be the run asked for
    Review: reuse=True checked stimulus and duration only -- changed sources,
    a requested injection, or edited outputs would all have been re-analysed
    as if fresh, and the returned run dropped the injection.
    A fresh replay now writes run_identity.json: sha256 of every compiled
    source, the defines (injection included), the stimulus and the frame
    count, plus sha256 of every output it wrote. Reuse is REFUSED unless the
    identity THIS call would produce matches and the outputs are unchanged;
    a failed run leaves no identity. Runs on disk from before this change
    have none, so they can no longer be reused.
    fpga/test_uart_replay_reuse.py (simulator stu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
    [test_uart_replay_reuse.py, verify_uart_bridge.py]
2026-09-24 replay identity: hash the ROM images; publish each RTL run's receipt
    Review: the reuse identity omitted the sound-producing ROMs the RTL
    $readmemh's (tanh16/256 in rtl-sketch, exp/g/k/sine tables in
    spec/reference/tables -- resolved by build_arty.roms(), the same set the
    FPGA build ships). A ROM edit changes the audio with no Verilog change.
    They are now part of run_identity.json.
    The published playback records lacked the receipt of the run that
    produced them. verify_rolling_playback now publishes
    <fixture>.run_identity.json (sources, ROMs, defines, stimulus, length,
    output digests) beside each RTL result and records its sha256.
    Tests: reuse refuses a changed ROM (a real file edited on dis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
    [test_uart_replay_reuse.py, verify_rolling_playback.py, verify_uart_bridge.py]
2026-09-24 publish: ship the DSP evidence bundle; the published output re-derives its verdict
    Review of 3cda9d6: publish() derived true from the artifact's
    dsp-dpreg-evidence/ but did not copy it, so re-deriving from the
    published directory refused ("missing evidence: no dsp-dpreg-evidence
    directory bound to this artifact").
    publish() now copies the bundle into the output, checks every copied file
    against its source digest (a difference refuses publication), re-validates
    the copy's manifest when the source's validates, records the digests as
    published_evidence_sha256, and refuses to publish a true verdict that
    dsp_disposition(output) does not reproduce. A source bundle that is already
    invalid remains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
    [publish_arty.py, test_publish_arty.py]
2026-09-24 M1A scorer: attack is UNQUALIFIED unless BOTH sides' fits are in domain
    mono_m1a_score.attack_fit_qualified() states attack_fit's known-signal
    domain (p in {0.5,1,2}, ramp 0.5-20 ms, above the 32-sample search
    minimum). compare_audio marks each note's attack_state and, when any
    model OR reference fit is outside the domain, makes the Envelope attack
    property invalid (raw reading kept as unqualified_*); required_metrics
    then gives the envelope metric no distance rather than the release's
    alone. analysis_version -> m1a-envelope-score-v2.
    Start red: the 8 new scorer tests fail against the previous scorer
    (6 side x fit-shape cases, the control, the in-domain case). Control:
    attack_domain_rule=Fa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
    [check_m1a_selection.py]
2026-09-24 score: regenerate M1A under the two-sided attack rule -- no verdict
    tools/run_case.py M1A (selected patch m1a-gain-minus4db-v2, scorer
    m1a-envelope-score-v2 at dc9c111). Audio unchanged: 628a6a31...a2ba61c.
    Envelope attack is now UNQUALIFIED: the reference fits for MIDI 36 (p=3)
    and MIDI 43 (p=4) are outside attack_fit's validated domain. The raw
    +8.10889 ms is kept as unqualified_*, not graded. The envelope metric
    has no distance, so M1A is no verdict. Vector: Pitch -0.05059 pass,
    Harmonic 19.82331 fail, Attack unqualified, Release +8.47917 pass,
    Gain -1.04361 pass, Clipping 0 pass, Filter envelope unqualified
    (4/1/2). Board: 100 cases, 20 valid, 6 pass, 14 fail, 5 no verdict,
    75 not run (w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
    [check_m1a_selection.py]
2026-09-24 evidence: fresh RTL playback runs with their published receipts
    Both fixtures re-run fresh on 325ace2 (reuse identity includes the six ROM
    images), each result published with the run_identity.json receipt that
    produced it (sources, ROMs, defines, stimulus, length, output digests;
    its sha256 in verification.json):
    RTL control (one intended event +1 frame) caught in both. Captures are
    byte-identical to the previously committed ones.
    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
2026-09-25 [m1a] attack known-answer suite and quadratic-level v3 fit (grid stated before v3 evaluation)
    The v2 estimator on the new suite (build-time run, 1898 cases): decay after
    the attack biases the 10-90 short by up to 4.8 ms on a steady spectrum, and a
    filter sweep during the attack drives the fit to the search ceiling.
    [attack_fit_v3.py, attack_known_answer.py]
2026-09-25 docs: the keychain dongle, itemised from manufacturers' drawings (#1 board fit) (#216)
    * DESIGN 8: the keychain dongle, itemised from manufacturers' drawings
    Issue 1's board-fit item had a placeholder "~20 x 40 mm" guess and section 8
    had a 29 x 20 mm dongle row with no parts list behind it. Neither could be
    checked. This itemises the BOM the product target actually names -- USB-C in,
    3.5 mm out, no speaker, no amplifier, no battery -- with every footprint read
    off a manufacturer's mechanical drawing and labelled `drawing` / `package` /
    `estimate`.
    243.5 mm2 of parts x 2.1 routing = 511 mm2, against the dongle row's
    580 mm2. It fits with 12 % slack, and "~20 x 40 mm" (800 mm2) is 1.6x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
2026-09-25 M1A attack: close for now, blocked on reference/method suitability
    Records the #214 review's decision and its two qualifications:
    - status: attack BLOCKED on reference/method suitability; 10 ms kept, M1A
    NO VERDICT, board 20 valid / 6 pass; the frozen reference is not changed
    to obtain a score
    - the sub-ms bounds are the worst OBSERVED error in selected regions of a
    synthetic suite, not an accuracy guarantee for arbitrary audio
    - known nonblocking generator defect: carrier() normalizes by summed
    component power, but the octave saw's harmonics coincide with the base
    saw's even harmonics and add coherently; fix on next revision, then
    requalify affected claims
    Docs and a docstring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
    [attack_known_answer.py]
2026-09-25 Revert the generator docstring: the scorer binds the suite to its hash
    The first commit added the defect note to carrier()'s docstring. The
    scorer hashes tools/attack_known_answer.py and refused the qualification
    as stale (4 tests failed) -- the guard working. The note now lives only in
    the README, with that reason.
    [attack_known_answer.py]
2026-09-25 docs/tools: M1A harmonic-shape diagnosis -- phase-sensitive mix, unresolved at the notches
    Reference oscillators free-run at -3.49 c (free-running phase prediction
    within 0.2 deg; reset-at-note-on off by 113.6 deg). The model's relative
    phase is locked (psi 0.9/5.0/9.1 deg), and in the model the relative phase
    moves odd partials by up to 12.6 dB through the ladder input. At the
    matched phase, a -1.4 to -3.2 dB odd remainder persists on the MIDI 36
    pair. h4/h8/h10/h12 are unresolved (h8 19.82 -> 10.52 at matched phase).
    No sound change is supported; one minimal Mini V3 capture (a held MIDI 36
    note over a full psi cycle) is named with a fixed decision rule.
    No patch, engine, reference, estima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
    [diagnose_m1a_harmonic_phase.py, test_diagnose_m1a_harmonic_phase.py]
2026-09-25 tools: M1A phase-cycle capture wrapper with asserted preconditions
    Wraps the existing M1A reference renderer for one held MIDI 36 note.
    Refuses on identity mismatch, non-bit-exact frozen reproduction, failed
    integrity qualification, clicks/dropouts/silence, settings that differ from
    the frozen record, wrong octave, or isolated takes that do not sum to the
    both-open take.
    [capture_m1a_phase_cycle.py]
2026-09-25 tools: phase-cycle click detector blocks are two periods of the take's fundamental
    Four MIDI 36 periods missed one injected click on oscillator 2 (REFUSED,
    4 of 5). Two periods of each take's own fundamental: clean residual
    <= 0.16 dB, injected clicks >= 2.69 dB on all six takes; floor 1 dB.
    [capture_m1a_phase_cycle.py]
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2026-09-25 docs: BD excitation-shape probe for #21 -- mechanism confirmed, blocked by #220, kit unchanged (#221)
    * bd_excitation_probe: measure what the BD excitation's shape can and cannot move
    The probe for issue #21 / contract 17.20. Reproduces both published anchors of
    docs/drum-verification.md section 8.3 (reference 41.16 %, ours 22.30 % of the
    first 4 ms in 80-150 Hz) and REFUSES if either has moved, then sweeps three
    families of excitation shape against them: the exciter envelope, the BD mode's
    unused numerator register, and -- as a bound -- an arbitrary integer sequence
    replayed into the same modal bank.
    The bound arm's precondition is bit-exactness against the DrumsFx render it
    recorded its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
2026-09-25 docs: M1A drive experiment -- reporting corrections from review
    - no previously passing property loses its pass (harmonic shape, already
    failing, worsens numerically)
    - the repeated-note h8 error is positive and rises: the model's h8 rises
    against the reference notch, not a deeper model notch; #218's +10.52 dB
    matched-phase residual retained
    - mean-ratio agreement restricted to h3/h5/h7 (h9 +0.46, h11 +1.05 dB)
    - selection rule stated as committed; compensation described as a
    predeclared one-pass development calibration
    - report-consistency check for the quoted numbers
    No re-render, no rule change.
    [check_m1a_drive_report.py]
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2026-09-25 measure: F1 selected-path level sweep, controls and baseline table
    Level sweep shows the F1 corner error is level-dependent on both paths:
    -7.6/-4.2/-3.7 % at <= -24 dBFS vs -16.8/-16.5/-16.4 % at the -12 dBFS
    probe level. #178's rolloff repair moves only ours F1A (+1.67 dB/oct,
    pass -> fail); the curves are unchanged (531aa8a estimators reproduce the
    committed records exactly).
2026-09-25 test: make the ideal four-pole fixture a four-pole; narrow the reproduction claim
    The fixture was -40*log10|1+jf/fp|, a two-pole. As a true four-pole
    (-80*log10) the old agreement assertion fails (|diff| 1.62 >= 1.0, logged in
    fixture-repair-red.log); the estimators are expected to disagree there,
    -18.68 (531aa8a) vs -17.06 (current), matching test_run_case's four-pole pin.
    README now claims only that the old metrics reproduce to 4 dp, not that the
    curves are identical.
2026-09-25 feat: gate optimisation work on a committed sensitivity sweep
    Adds tools/sensitivity.py, a registry-scoped gate that asserts a tunable
    parameter ships a value its own committed sweep covers, that the sweep's
    grid IS the set of points the measurement artefact holds, that every
    recorded point re-extracts from that artefact, that the flat/sensitive
    verdict is recomputed rather than asserted, and that the measured shape
    matches a prediction derived independently of the measurement.
    Retrofits the 8-vs-12 mode debate from docs/failure-modes.md mechanism 5:
    MODES against drum_kit cell area is a staircase (a 16.8 % step from 8 into
    the 9-16 bracket, then a 0.67 % plateau across 11-16), NUMS against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
2026-09-25 measure: matched-level Surge Type 2 captures for F1 (0.25/0.125/0.0625, two takes each)
    Frozen profile reproduced first: refprofile_repro 2 runs, 16/16 bit-identical
    and 16/16 equal to the committed sha256 (exit 0); profile.json untouched.
    tools/f1_level_capture.py renders the F1 stepped tone at three amplitudes,
    three cutoffs plus wide-open, two takes per level each in its own process,
    into docs/scorecard/f1-level/captures/ (never refprofile/). Plugin version and
    binary hash must equal the frozen profile's or it refuses; pins are re-checked
    after every clip.
    That post-render pin check REFUSED the first capture: Surge's 259/260/264/265
    report Classic-oscillator names at construction and th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
2026-09-25 probe: say the old metrics no longer reproduce, not that the curves moved
    Wording only; the probe's hash changes (8c310f99 -> ee680e65).
2026-09-25 measure: F1A-F1C records at the current estimator (measurement-version update)
    Re-run through tools/run_case.py at runner 77739a9434f2605e (#169/#178
    rolloff-estimator repair), replacing the 531aa8a3731dfdb8 records. Only
    F1A's rolloff moves: -18.5395 -> -16.8728 dB/oct (error 0.1483 -> 1.8151,
    tol 1.5), property pass -> fail. Not a sound change: no model, ROM or
    CUT_TRIM change. F1A already failed on corner, so worst 1.68 and the board
    totals are unchanged: 20 valid, 6 pass, 14 fail, 5 no verdict, 75 not run.
    selected-path.json re-run with the reworded probe: numbers identical, probe
    hash now ee680e654b55625e.
2026-09-25 Doc-claim-to-evidence checker, and the failure-modes status list it was commissioned to correct (#230)
    * tools: check_doc_claims.py -- re-derive prose claims from evidence
    docs/failure-modes.md mechanism 4 asks for exactly this and then demonstrated
    the need: its own "Not yet" list was written 2026-09-18 15:55 and two of the
    five items were delivered later the same day. Nothing could notice, because
    nothing was checking.
    Three outcomes, and the third is the point: OK / STALE / REFUSED. A skipped
    test backs nothing -- REFUSED, never OK -- because a skipped check looks
    exactly like a passing one. Exit 1 for STALE, 2 for REFUSED, the repository's
    convention where 2 means no evidence rather th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
    [check_doc_claims.py]
2026-09-25 test: extend the claim/ground-truth gate to test_moog_acceptance.py (#227)
    * test: extend the claim/ground-truth gate to test_moog_acceptance.py (#222)
    `test_808_acceptance.py` was the only acceptance suite that enforced every
    test declare a claim-status tag and a ground-truth reference into
    `test_audio_measure.py`. Factor that check into a shared helper
    (`model/acceptance_meta.py`), have both suites' own `test_meta_*` functions
    call it, and tag all 68 tests in `test_moog_acceptance.py` (the suite issue
    #45 named as the motivating example, with zero such references) with a
    status and a resolvable ground truth.
    Verified red-then-green: a temporarily added untagged test, and one with an
    unre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
2026-09-25 test(refprofile): per-clip post-render pin checks (#233), start red
    Stubbed-plugin tests for refprofile.render. Against the current renderer:
    10 failed (exit 1): 8 refusal cases DID NOT RAISE, 2 pass cases lack the
    derived post_render_check record.
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2026-09-25 feat(F1): official runner measures the selected filter path under surge-type2-clean-v1; RTL/SPI benches and headroom probe
    plan074 C/D. run_case F1 model side is now tools/f1_filter_path.py: the
    selected RateConvertedLadder built by the M5A scorer's constructor, identity
    checked, words entering the ladder asserted, bit-exact match to a selected-
    voice note under the calibration; legacy OurLadder reads kept per record as
    diagnostics.legacy_standalone. F1_LEGACY_SUBSTITUTE inject must refuse.
    verify_voice --only f1cal (opt-in) and verify_synth_top --f1cal-smoke with
    --f1cal-fault LEGACY_WORDS negative controls. Headroom probe (screen passed;
    wrong-then-right first run kept).
    First RTL attempt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
    [verify_synth_top.py, verify_voice.py]
2026-09-25 measure(F1): official F1A-F1C on the selected filter under surge-type2-clean-v1 -- 3 passes; board 20/9/11/5/75
    plan074 C/E. run_case F1A F1B F1C exit 0: worst 0.76 / 0.42 / 0.36, agreeing
    with #231's separate experiment (corner -7.62/-4.17/-3.63 %). Controls by
    exit status: REF_PROFILE_MISSING, REF_PROFILE_TAMPERED, F1_LEGACY_SUBSTITUTE
    fired 3/3; REF_CORNER_2X fired on F1A/F1B (2/2) and is NO-VERDICT on F1C (our
    rolloff has 3 points on the halved grid) -- recorded, not fitted around.
    Component RTL (7200 frames exact) and SPI->I2S smoke (5841 periods exact) pass;
    both LEGACY_WORDS negative controls caught. Legacy records kept as history.
    Model measurement, not integrated-RTL F1; resonance h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
2026-09-26 fix(F1): REF_CORNER_2X shifts only the reference axis; DUT keeps the frozen probe grid; runner comment names the selected path
    plan075 4. dut_probe_grid(meta) drives our side whatever a reference-side
    control does; asserted equal to the reference axis when clean and to the
    wide-open clip's grid; grid sha recorded. Invariant test added. The stale
    'our side is OurLadder' section comment now describes the selected path.
    make controls gains the F1 REF_CORNER_2X (--expect fail) and
    F1_LEGACY_SUBSTITUTE controls.
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2026-09-26 measure: what is left in the shipped ladder, and the tuning offset nothing was watching (#240)
    * test: the Rung 1 ladder-headroom audit's ground truth and controls, red first
    Written before model/ladder_headroom.py exists, and observed red for the
    right reason (ModuleNotFoundError, not a typo in an assertion) -- rule 1 of
    docs/verification-rules.md applied to a measurement tool rather than to RTL.
    Part of #46
    * measure: what is left in the ladder we already ship (issue #46 rung 1)
    model/ladder_headroom.py audits five axes of the shipped Huovilainen ladder
    and reports a verdict plus the number that decided it on each. Findings:
    cutoff-offset WORTH PURSUING 105 cents of trave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
2026-09-26 deadline: per-frame production schedule monitor; tb_voice launches at the chip's cycle
    - rtl-sketch/deadline_mon*.v(h): extra simulation root that records, per frame,
    go / voice / strobe / drum / write cycles of synth_top on the SPI bench and
    the Arty wrapper's UART bench, without editing either bench.
    - rtl-sketch/verify_deadline.py: production deadline driver (slack, missed
    frames, sticky overrun, writes-before-go, I2S vs model, coverage refusal).
    - tb_voice.v: go at synth_top's GO_CYCLE (8, was 48); a frame's writes occupy
    the cycles ending at go-1 and REFUSE if the datapath is busy; overrun and a
    strobe after cycle 254 are FAILs of the design.
    - verify_voice.py: refuses a bench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
    [deadline_mon_arty.v, deadline_mon_top.v, tb_voice.v, verify_deadline.py, verify_voice.py, voice_dp.v]
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2026-09-26 D13A rescored under the declared difference-tone ceiling: 11.34 -> 2.82, a rubric change (#141)
    Same audio (D13A-ours.wav sha256 31bb9100... before and after), same
    reference. The record keeps its old verdict in rubric_history, labelled a
    rubric change. The headline is now the partial balance (#107). The case is
    still fail, and the board's valid/pass/fail counts are unchanged.
    DR 0017 records why the metric is a defect ceiling and not a renamed
    two-sided match. docs/scorecard/cowbell-141/ holds the start-red logs, the
    CB_GATE_THE_SUM control (the ceiling still fails nl(a+b) at 15.81x), and the
    first control attempt that the runner correctly refused.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
2026-09-26 deadline: revert the LATE_DONE ifdef in voice_dp.v
    Any byte change to voice_dp.v unbinds the published Arty image from its
    sources (16 fpga/test_publish_arty.py failures). The late-completion control
    moves to a build-time mutant instead.
    [voice_dp.v]
2026-09-26 scorecard: a non-finite number is no verdict under either purpose; one corpus location, a required gate refuses (#241 review)
    Review of #241 found that max(0, error) / tolerance certified a NaN or -inf
    error, and anything over a +inf tolerance, as a pass at distance 0.
    metric_distance now validates error, tolerance, value and reference before
    any clamp or division. A non-finite number, or a tolerance that is not
    strictly positive, is 'invalid number' -> NO VERDICT under both 'match' and
    'defect ceiling'. measure_pair refuses a non-finite estimate at the point of
    use, so NaN is never written as an error.
    The tests now read the corpus location the runner reads
    (run_case.configured_refs: $GF18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
2026-09-26 deadline: late mutant stalls in S_OUT2; voice stub carries the 2x taps again
    - The late-completion mutant stalled in S_DWAIT, where it overlapped the drum
    filter's own wait and was absorbed: late:15 moved no DFILT frame and the
    1-cycle boundary control reported NOT CAUGHT. It now stalls in S_OUT2,
    after every wait.
    - stubs/voice_dp_stub.v lacked phase_os2 / inc_mod (tapped by tb_voice since
    bd7ba32), so the red run of verification-rules 1 could not compile (exit 2).
    It now compiles and fails with X, exit 1.
    [verify_deadline.py, voice_dp_stub.v]
2026-09-26 deadline: report and run records for plan075 T1
    Baseline (OSC2X FILTER2X, PULSE2X=0) meets the production frame deadline:
    threesaw-f1cal slack 79, stress 14 (SPI and Arty UART), register-legal bound
    248 = slack 6, reached; zero missed frames, zero overrun, I2S exact.
    PULSE2X=1 misses at register-legal extremes (1597 missed frames) and is
    excluded from the first release; the skip2xwin correction is measured
    (bound 233, slack 21) and deferred to T4. Model/RTL divergence at extreme
    glides filed as #247.
    [deadline_batch.py]
2026-09-26 Movement, part two: the resonance moving, and filter modulation at audio rate (#246)
    * reference_movement: resonance-through-onset and audio-rate filter modulation
    Two new measurement stages for #53, both with their START-RED injected
    control run before any number is printed:
    --stage resonance k swept CONTINUOUSLY through self-oscillation
    onset, both directions, three rates
    --stage audio-rate-mod oscillator 3 on MR_FILT at an audio rate,
    three depths x three rates
    * acceptance: standing checks for the two #53 movement cases, with their controls
    Two properties and tw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
2026-09-26 measure: rungs 2-4 compared, and the candidate that wins on sound and cannot be afforded (#249)
    * measure: the rungs-2-to-4 candidate ladders in one fixed-point frame
    Four discretisations of one ODE behind one interface -- the shipped
    Huovilainen explicit form, a trapezoidal implicit form solved by a fixed
    2- or 3-iteration Newton (DR 0001's own reversal condition), an explicit
    delay-free loop closed in one linearisation, and a converged float
    reference at 32x that is not a shipping candidate.
    The ground truth is the ladder's closed-form transfer function, not one
    of ours: assert_apparatus measures the rung-4 reference against it and
    REFUSES above 0.05 dB.
    Part of #46.
    * measure: the six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
    [compare_ladder_candidates.py]
2026-09-26 D12A probe: window decomposition, reference fine structure, frozen candidates, noise-realisation nuisance and accent headroom
    [clap_d12a_probe.py, clap_d12a_start_red.py]
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2026-09-26 test: every shipped measurement bug becomes a permanent injection, and a second suite reports its blindness (#251)
    * test: two shipped measurement bugs become permanent injections, and a second suite reports its blindness
    Issue #52 asks for two things. Both now have code behind them.
    **Historical bugs as injections (AC1, AC2).** `SPI_ADDR7`/`SPI_DATA24` replay
    the exact broken SPI frame that shipped; these do the same at the measurement
    layer, which is where most of this project's errors actually lived:
    sound_report.py --inject bd-ma-envelope
    the deprecated 5 ms moving-average envelope, patched into
    drum_verify.envelope for every voice. Measured: BD T20 308 -> 207 ms,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
    [test_verify_ctl_blindness.py, verify_ctl.py]
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2026-09-26 plan081 B/C: burst-timing apparatus check and the frozen final-strike experiment (conditions, offsets, anchor and selection rule fixed before rendering)
    [clap_burst_timing_qual.py, clap_final_strike_experiment.py]
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2026-09-26 plan081 B result (timing UNQUALIFIED); C: fix doubled first strike in the programmed-strike report
    [clap_final_strike_experiment.py]
2026-09-26 Oscillator drift: the references bound it, so the amount is a choice (contract 6.11, DR 0019) (#252)
    * osc_drift_probe: measure pitch drift, with the static-detune control
    The instrument for issue #56's 'establish the amount first'. A sustained-tone
    pitch-trajectory estimator with two independent readings (zero crossings, the
    method model/tom_pitch_probe.py uses and whose bandpass/Schmitt this imports;
    and a heterodyne phase differentiator) and four outcomes, REFUSED among them.
    Three results were wrong before they were right, all caught by the controls
    rather than by inspection, and each is recorded at the constant it moved:
    * one heterodyne boxcar leaves harmonic leakage that reads as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
    [check_arty_evidence_binding.py, publish_arty.py, tb_voice.v, test_build_arty.py]
2026-09-26 docs: re-derive discrimination.md 8.4/8.6 ours rows against the shipped (post-DR-0011) filter
    Section 8.4 and 8.6's `ours`-prefixed rows were last measured before DR 0011
    (2026-09-18) and were still reporting the pre-fix numbers (7.92 pp drift,
    23.3 dB/Q 14.3 resonant peak) as though they were the shipped filter's.
    Adds `tools/regen_discrimination_ours.py`, which re-runs
    `model/reference_compare.py` for `ours` and its controls/probes against the
    current `model/reference_rigs.OurLadder`, reusing the frozen reference-side
    data (Surge/Diva/Mini V3) rather than re-rendering it. The fresh output is
    committed at `docs/reference-compare-results-shipped.json`.
    `docs/reference-compare-results.json`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
2026-09-26 fix: the REFUSE gate reads content not filenames, and 8.3/8.5 stop contradicting 8.6/8.7
    Judge feedback on #262, four blockers.
    1. `tools/regen_discrimination_ours.py`'s required-key gate asserted that a
    `{stage}-{device}.json` FILE existed, and `guard()` in
    `model/reference_compare.py` writes a well-formed
    `[{"ok": false, "not_answerable": "..."}]` stub on a refusal -- so the gate
    passed on a refusal and the script would have printed a report over a
    measurement that never happened (issue #239 AC6; CLAUDE.md: "a tool that
    answers when it cannot is worse than one that is absent"). New
    `answer_refusal_reason()` asks whether the rows carry an ANSWER;
    `required_gate()` r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
2026-09-26 Clap L2 in the production model and RTL: ENV_FRATE (contract revision 11) -- the last re-strike restores the captured fire level and decays at FRATE; FRATE=0 is revision 10
    - drums_fx: EnvFx fcap/frate, register +3, kit/preset CP = 4 strikes @511, final 20 ms, tail 80 ms; MA writes FRATE=0
    - drum_dp/drum_regs/drum_kit/synth_top/tb_drums: the same, with four negative controls
    - tests: event-level expectations + mutants (weak/short/stale/shifted final, MA leak); verify_drums clap segment; verify_synth_top --clap-phrase with coverage and output-rail vs internal-saturation split
    - spec 15.1/15.3/15.8 and Appendix G
    [drum_dp.v, drum_kit.v, drum_regs.v, synth_top.v, tb_drums.v]
2026-09-26 docs/trials.md: root-cause analysis of the 09-24/26 round trips, and trials
    Six root causes (acceptance defined after the work; late verification in
    drifting environments; a human relay as scheduler; unqualified measurements
    consumed; lessons written as essays; a backlog that doesn't describe the
    work), with the PR-by-PR evidence, and a proposal: goals as executable
    trials (PASS/FAIL/NO VERDICT with receipts) that Loom issues name and flip.
2026-09-26 trials.md: amend the rules after review (plan085): outcomes beyond FAIL->PASS, meaningful baselines, contract review, three verdicts, close experiments not goals, frozen inputs vs integration, thin d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
2026-09-26 L2 follow-ups: acceptance tests to the hardware-measured clap (final strike present, tail 80 ms), CP 'Burst timing' labelled UNQUALIFIED in the runner, clap-phrase print fix
    - test_808_acceptance: 'no burst after 30 ms' and 'tail 47 ms' were SN-inferred claims the recording contradicts; kept three bursts in 30 ms, added the measured final strike, tail from 80 ms vs 80 ms
    - run_case: UNQUALIFIED table -> the metric is refused (no distance) with its reading kept as unqualified_*; a measurement-version change carried by rubric_history
    [verify_synth_top.py]
2026-09-26 verify_ctl: stop the blindness matrix's refusal paths from reporting a run that was never measured (#268)
    compare_writes() recorded via LAST.update(...) with both of its early
    `return 2` paths returning before that line, so a second call in the
    same process that delivered nothing left the first call's counters in
    LAST -- and print_blindness() then printed a full, confident six-row
    matrix for a run that was never measured. compare_writes() now clears
    LAST unconditionally on entry.
    Separately, when simulate() returns None (iverilog/vvp missing, a
    compile failure, a vvp failure, or a timeout), main() never calls
    compare_writes(), so LAST is empty for a reason print_blindness()
    could not distin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
    [test_verify_ctl_blindness.py, verify_ctl.py]
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2026-09-26 polyBLAMP on the shark-tooth's triangle corner, model and RTL
    The shark-tooth carries two kinds of discontinuity and we corrected one. Its
    saw share steps at the wrap (PolyBLEP, already there); its triangle share
    CORNERS at the valley and the peak, and a corner is a slope discontinuity that
    a step correction cannot see. Esqueda, Bilbao and Valimaki analyse this exact
    waveform and name the fix: BLAMP as well as BLEP.
    The residual is the integral of the one blep_fx already computes,
    R(x) = (1-|x|)^3/3, integer end to end so voice_dp.v can be bit-exact against
    it: m3 = (inc * 21845) >> 15 once per oscillator, then (m3 * s^3) >> 24 per
    window, reusing PolyBLEP's own window word s. RTL: the shar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
    [verify_voice.py, voice_dp.v]
2026-09-26 DR 0017, contract revision 12, and the instrument that measured it
    The measurement tool is a deliverable, not scaffolding: tools/measure_shark_blamp.py
    produced the table in DR 0017 and carries its own ground truth in
    tools/test_measure_shark_blamp.py -- including the refusal paths, because a
    measurement tool's only failure mode that matters is printing a number where the
    estimator could not answer. It REFUSES a floor-limited row, a span shorter than
    the two octaves the acceptance criterion asks for, an arm pair that is
    bit-identical, and --require-references on a host with no VST3 bundles.
    Contract revision 12 is one normative change: 6.6 gains 6.6.5 (the ramp
    residual and the shark-tooth'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
    [voice_dp.v]
2026-09-26 Regenerate uart-clean Arty verification fixture for BLAMP RTL change
    fpga/publish_arty.py binds arty_a7_top's digital proof to
    fpga/reports/arty/uart-clean/verification.json and refuses any artifact
    whose source_sha256 no longer matches rtl-sketch/voice_dp.v on disk. The
    polyBLAMP RTL change in this PR left that fixture's recorded hash stale,
    so fpga/test_build_arty.py::test_prepared_build_resolves_the_actual_hdl_rom_filenames
    and 17 fpga/test_publish_arty.py cases failed the binding check (m5a-fast,
    spi-i2s CI). Regenerated via `python fpga/verify_uart_bridge.py --scenario
    phrase` per fpga/ARTY.md's documented procedure -- the phrase scenario is
    bit-exact identical to the committed transcri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
2026-09-26 Rebase FSM states past drift's S_DR1; refresh Arty evidence binding
    The rebase onto origin/main hit a state-number collision in voice_dp.v:
    main's oscillator-drift work (contract 6.11, DR 0019) claimed S_DA0..S_DR1
    at 75..79, the same slots this PR's polyBLAMP states (S_SKM/S_W3/S_W4) used.
    Renumbered this PR's states to 80..82, after S_DR1, per the Judge's request.
    Re-verified bit-exact: rtl-sketch/verify_voice.py --set quick --only waves3
    (clean and the SHARK_BLAMP_SIGN injected control) and
    rtl-sketch/verify_synth_top.py --osc2x --short both PASS.
    Also, main's drift work moved fpga/publish_arty.py's VERIFICATION_BY_WRAPPER
    binding from uart-clean to drift-clean since this PR was last reb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
    [publish_arty.py]
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2026-09-26 Two shipped build-tool bugs become injections: an X netlist gets no area, a die from its own utilisation target gets no ratio (#272)
    * AC1: an area-reporting tool that REFUSES on an X netlist, with the shipped tanh index bug as its injection
    pnr/report_synth_area.py reports a synthesised cell count or withholds it:
    a design whose outputs are X gets REFUSED (exit 2, reason outputs-are-x),
    never a number. pnr/fixtures/tanh_dp.v reproduces ladder_dp_t16's shipped
    defect -- a tanh index field one bit wider than the table it reads -- as
    the TANH_INDEX_OOR injection.
    Measured on this tree: clean 1,679 cells, PASS; injected 1,677 cells,
    REFUSED. The rule-4 matrix is the finding: rtl-simulation MO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
    [tanh_dp.v]
2026-09-26 Version rendering and analysis separately: render / analyse / accept on a real case, with the retained audio (#275)
    * provenance: render / analyse / accept as three separately-hashed stages
    tools/measurement_manifest.py is the schema: what a measurement must carry
    (units, analyser version and method, the selected hit/onset/interval,
    channel/rate/resampling/filtering/normalisation, FFT/window, fit quality and
    uncertainty and noise-floor treatment, the exact reference identity, and the
    bound WITH its rationale and the record of when it last moved), plus
    classify_delta, which answers 'did the sound change, or only the measurement?'
    from the stage identities and REFUSES when both moved.
    tools/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
2026-09-26 transient_report: scale blocks to the note period when f0 is known (#225) (#277)
    A fixed 5 ms block holds a varying number of saw edges, so the blocks that
    hold one more read as clicks: a clean MIDI 36 full-band saw reported 359
    events in 6 s. Not monotonic in pitch -- MIDI 60 and 69 fail too, 45 and
    72 do not, depending on the fixture.
    New opt-in `f0_hz`: blocks of `periods` (2) whole periods, truncated, as
    tools/capture_m1a_phase_cycle.click_report already does, plus a 1 dB
    threshold floor on that path. Wrong-then-right: the period block alone
    still gave 1-34 false events per 8 s from MIDI 45 to 84, because whole-
    period blocks are so alike that the MAD collapses and sub-sample grid drift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
2026-09-26 Clap L2 is contract revision 13, not 11: renumber, re-pin KIT808 with a reconstruction test
    The L2 change labelled itself "contract revision 11", but revision 11 (the
    tom rebalance, 2026-09-19) and revision 12 (drift) already exist, and it
    changed the reference kit without re-pinning it: spec/reference/test_tables.py
    failed 5 tests in CI (python, acceptance) because KIT808 moved a43fe2a7 ->
    321a9354 and 147 -> 148 writes while the contract, kit808.hex and the pins
    still stated revision 11's image.
    Diagnosed, not re-pinned blind: the kit image on origin/main hashes to REV11
    exactly, and the live image differs from it in exactly three writes, all on
    the clap's envelopes -- ENV_CTL[8] (bursts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
    [drum_dp.v, drum_regs.v, test_verify_ctl_blindness.py, verify_ctl.py]
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2026-09-26 Arty live-tree proof rebound to a clap-L2 run (l2-clean); R0 pinned to its historical source set
    CI (spi-i2s, m5a-fast) failed with "verification source differs:
    rtl-sketch/synth_top.v": publish_arty.VERIFICATION_BY_WRAPPER must name a run
    of the CURRENT tree and still named drift-clean, captured before L2 changed
    synth_top.v and the drum RTL. The guard was right; the fix is new evidence,
    not a looser guard (same procedure as drift-clean in #252).
    - fpga/reports/arty/l2-clean: fpga/verify_uart_bridge.py phrase PASS (87/87
    writes, 6,734 I2S periods bit-exact, strobe 176/256) and start-red FAIL
    against the stub (0 of 26 writes), run on the build box at 3886191 via
    tools/run_all.py. Agai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
    [publish_arty.py]
2026-09-26 Release: Arty A7-100T baseline 2025.1 r1 manifest (OSC2X=1 FILTER2X=1 PULSE2X=0), with enforced supported domain (#255)
    * release: qualified-domain validator and glide boundary bench (WIP)
    * release: boundary bench at voice and wrapper level; audible waveform sets
    * uart_host: player path validated against the release domain; the note-only image carries its mixer weights
    The documented first playback (run --note 45 --fixture none) sent no mixer
    weights; every weight resets to 0, so the note was exact silence, bit-exact
    against an equally silent model. voice_mixer_writes adds t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
    [uart_host.py]
2026-09-26 Deadline evidence tests: re-capture stress-saw on the revision-13 tree; refuse a capture from another stimulus
    make verify (build box) failed one test the CI jobs do not run:
    tools/test_verify_deadline.py::test_the_retained_clean_capture_passes_and_each_corruption_refuses
    -- status 1, "writes_bad 326; 460 of 461 writes reached the port". The
    retained prod-stress-saw capture (2221d2c) was driven by the pre-L2 kit;
    the scenario's stimulus now has one more write, so the test was judging
    historical evidence against current source. verify_deadline.analyse_capture
    already REFUSES that; the test bypassed the check.
    - Re-captured stress-saw (PASS, 2158/2158 periods, 461/461 writes, worst
    sample s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
2026-09-26 D12A plan081 B/C: burst timing unqualified; explicit final strike (L2) confirmed on fresh offsets -- model improvement, promotion incomplete (#261)
    * plan081 B/C: burst-timing apparatus check and the frozen final-strike experiment (conditions, offsets, anchor and selection rule fixed before rendering)
    * plan081 B result (timing UNQUALIFIED); C: fix doubled first strike in the programmed-strike report
    * plan081 B/C results: burst timing UNQUALIFIED (noise, not shape); L2 explicit final strike selected on DEV, confirmed on fresh offsets -- model improvement, promotion incomplete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
    [clap_burst_timing_qual.py, clap_final_strike_experiment.py]
2026-09-26 Two drifted locks re-locked to the commits that moved them, and the gate that should have caught them
    Issue #242. Both `[lock]` properties were traced, not assumed, and neither is
    a regression -- each is a deliberate, externally-grounded sound change that
    was never re-locked. The nightly step that exists to make that impossible had
    been passing unconditionally for nights.
    WHICH COMMIT MOVED WHAT
    ("LADDER", "corner ratio drift") 9.40462 -> 4.21473 % at 50d7aaf (#67)
    ("LT", "attack") 16.625 -> 6.27083 ms at 80b3756 (#154)
    50d7aaf is DR 0011: `CUT_TRIM * fcr()` baked into `voice_fx.make_g_rom()`, so
    the shipped cutoff ROM is the tuned one. This property is the NON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
2026-09-26 sound_report: record the two re-locks in LOCK_CHANGELOG, fix provenance.yml's shallow checkout
    RELOCKS fed the printed report line but not LOCK_CHANGELOG, which #275
    gated `--check-locks` on after this branch diverged -- so `check_lock_changelog()`
    saw the two re-locked values with no changelog entry and failed.
    Add one changelog event per re-lock (50d7aaf, 80b3756), matching the
    provenance already written in RELOCKS.
    provenance.yml's `stages-and-controls` job also runs
    model/test_sound_report.py's provenance tests with a bare, depth-1
    actions/checkout@v4 -- the same shallow-clone bug already fixed in
    moog-acceptance.yml. Add fetch-depth: 0 there too.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
2026-09-26 Release CLI sends the kit its image plays: uart_host --image release (rev 12, default) | tree (rev 13)
    Judge on #273: merged with main, `pytest fpga/release` went 9 failed / 3
    errors and T-RELEASE-BOUND NO VERDICT. fpga/spi_host.MusicHost defaults to
    drums_fx.kit_808(), which L2 changed (ENV_CTL[8], new ENV_FRATE[8],
    ENV_RATE[9]), so `uart_host.py run --fixture demo|bar808-full` stopped
    reproducing the #255 R1 rolling-playback replay -- and would have driven the
    published revision-12 image with a clap it cannot play.
    Mechanism (the kit is a property of the IMAGE, not the tree):
    - drums_fx.kit_808_rev12(): kit_808() with revision 13's three clap writes
    undone; frozen by hash to KIT808 revi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
    [fixtures.py, uart_host.py]
2026-09-26 Image-kit tests with controls; Appendix G names ENV_FRATE[8] (was ENV_-[8])
    - fpga/test_image_kit.py: the frozen revision-12 kit hashes to test_tables'
    REV11 KIT808 pin (independent of drums_fx's own literal) and differs from the
    tree's only on ENV_CTL[8]/ENV_FRATE[8]/ENV_RATE[9]; the CLI's default and
    `--image release` demo capture equals the manifest's bound cmds_sha256 and
    writes no ENV_FRATE. Controls: a moved non-clap kit write makes the frozen
    kit (and uart_host.image_kit) REFUSE; `--image tree` is NOT the bound bytes
    and does write ENV_FRATE[8]. Injected: DEFAULT_IMAGE = "tree" turns this
    file and fpga/release red (11 failed, 3 errors -- the Judge's failure).
    - spec/refe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
    [test_image_kit.py]
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2026-09-26 Live-MIDI evidence regenerated on revision 13, counts tied to the code; image-kit tests in make verify
    Regenerated (not hand-edited) at 03decc3, the commits the fix landed in:
    - start-command.log: `midi_session.py --port sim --midi-in scripted:coverage`
    now names its image (tree, revision 13); 191 init writes (was 190 on the
    revision-12 kit); 203 scheduled, 14 refusals, errors 0, drops 0, queue peak
    17 -- unchanged. Only the two count lines moved.
    - start-red.log: `verify_live_midi.py --start-red` against the stub, static
    image 0/191.
    - trial-sim.log / trial-sim.receipt.json: `trial.py run T-LIVE-MIDI --mode
    sim`, PASS, 3/3 controls caught, head 03decc3 clean. (The receipt, like th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
    [test_midi_image_kit.py]
2026-09-26 Bind the revision-14 tree's Arty proof (rev14-clean); restore R0's proof that #244 rewrote in place
    - fpga/reports/arty/rev14-clean: verify_uart_bridge phrase PASS (87/87,
    6,734 periods bit-exact, strobe 176) and start-red FAIL (0/26) on the
    merged tree at 36e1f83, build box, run_all 2/2 exit 0. publish_arty binds
    it; shark-blamp-clean and l2-clean stay as history with exact drift lists.
    - fpga/reports/arty/uart-clean/verification.json restored to its published
    bytes (sha ae9cedc8..., what the R0 publication.json cites). #244
    (af16357) regenerated it in place for the BLAMP voice_dp.v, which left the
    published a66c9349 image citing a proof that no longer exists in the tree;
    test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
2026-09-26 Toms' pitch drop: the two reference documents still said x1.7 (#95)
    #110 measured the drop and #154 shipped the correction (TOM_DROP_RATIO 1.7 ->
    1.060, the accent clamp replaced by a measured threshold, the tuning pot added).
    Neither reference document moved, so for a week the tree shipped x1.060 while
    `docs/tr808-reference.md` 4 -- the paragraph that ORIGINATED the inference --
    still derived x1.7, and `docs/drum-verification.md` 8.4 still recorded it with
    the authority `verified in a source`, a qualifier 4 never gave it.
    Nothing caught that because nothing was checking. So the prose now carries its
    evidence:
    - `model/tom_drop_docs.py` re-derives every number the two documents state from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
2026-09-26 R1 candidate: freeze the target, thread the image through playback verification (#279)
    - fpga/release/r1_candidate.py: the frozen R1 target (contract revision 14,
    kit digest 321a9354..., clap ENV_FRATE[8] nonzero, compile options, RTL
    frozen at 6864435) and check_init() on a sender's actual setup bytes.
    - R1 known-state session start: uart_host run/load --image tree and
    midi_session --image tree send voice RESET + drum RESET before the image,
    and refuse to start over queued events. R0 (release) bytes unchanged.
    - verify_rolling_playback: --image (sender) and --expect-image (target) are
    separate; the target is never inferred from the sender; init bytes are
    checked against the froz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
    [midi_session.py, test_midi_image_kit.py, uart_host.py, verify_live_midi.py, verify_rolling_playback.py]
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2026-09-26 r0_capture: declared analysis band, envelope-anchored placement, pitch named when the waveform is lost
    Found on a provisional reference set (partial renders), each by a control or
    the clean session: a 5 Hz AC-coupling high-pass failed the clean session's
    timing and residual; a held tone locked one period off (NCC 0.9986 vs 0.9974);
    a +20 cent tone was reported only as routing/silence; the clipping control
    clipped before the high-pass, so its flat tops never reached full scale.
2026-09-26 r0_reference: rolling fixtures replay the CLI's transmit log, bound to the release's replay capture
    The dry-run's virtual anchors are not a replayable stimulus: the first renders
    of demo and bar808-full FAILED with every event off its frame.
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2026-09-26 r0_capture: a timing slip must be sustained; robust clock line
    On the full bar808-full reference the clean synthetic session FAILED timing on
    one narrowband bass window (-3.8 samples): its lag is a phase delay, which a
    5 Hz AC coupling moves by fc*SR/(2 pi f^2).
2026-09-26 r0_capture: raw-signal dropout runs; the defect suite runs once, inside the end-to-end trial test
    The banded dropout check missed a 20 ms gap on the loudest block of the full
    bar808-full reference (the band filter rings the onset into the gap).
2026-09-26 test: the Judge's #299 probes as regression tests (start red on c4dba2c)
    Synthetic bundle through the trial; program.txt pass conditions; the live CLI's
    host logs through the identity gate and the analysis; a foreign live log still
    refused; the stub's clean run not counted; the reference binding inside the
    analysis.
2026-09-26 #299 Doctor: refuse synthetic and unproven acquisitions; live-log identity; hold offset visible
    B1: analyse (and so T-PHYSICAL) refuses a synthetic session, synthetic
    declarations or transcripts, readback: true, a missing/failed detect
    transcript, and a program.txt without step 5's pass conditions (manifest
    BOUND + exit 0, R0's arty.bit digest, the programmer's final exit 0).
    B2: the host-log gate compares live writes (order, values, multiplicity) and
    scheduled events (order, relative due) separately, and requires every event
    after the setup it depends on; the live CLI's held-note logs pass it.
    The planned hold offset (1201 frames, 25 ms, measured on the scripted device)
    stays visible: relea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
2026-09-26 ci: refute the #264 contention theory with per-step timing, keep both triggers
    #264 asked for one of `moog-acceptance.yml`'s two triggers to be dropped, on
    the theory that the `push` and `pull_request` copies of a PR commit contend
    and the loser runs out of clock against the 20-minute cap. The data says
    otherwise, so this ships the measurement and the comment rather than the
    change.
    `tools/ci_acceptance_timing.py` reads per-step `started_at`/`completed_at`
    from the jobs API and groups by `runner_name`. Run-level timing -- all the
    issue had -- folds queue, setup and every step into one number and cannot
    separate "two copies contend" from "the suite grew". Per-step timing can, and
    `runner_nam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
    [ci_acceptance_timing.py]
2026-09-26 shuttle: reconcile the recovered LibreLane half-slot flow against main
    Brings PR #176's recovered pnr/shuttle/ onto current main and replaces its shell
    wrapper with Python.
    - chip_core.sv: current main's synth_top has eleven ports, not the nine this
    wrapper was written against -- bcde9e6 added the UART bridge's uart_rxd /
    uart_txd. They are brought out on bidir_PAD[7] / bidir_PAD[8] rather than
    tied off internally, so a port-list drift cannot hide behind a constant, and
    the instantiation now lists every port by name for the same reason.
    - run_librelane.py replaces run-librelane.sh (CLAUDE.md: write Python, not
    bash). It asserts the apparatus's preconditions and REFUSES (exit 3)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
    [chip_core.sv, collect-evidence.py, config.yaml, run_librelane.py]
2026-09-26 The sawtooth's aliasing AFTER the decimation filter, measured (#61)
    Issue #61's fix direction -- a decimation filter, not a longer BLEP -- shipped
    for the saw (`_render_2x`, `_DECIM2_TAPS`, `fpga/SELECTED.md`: OSC2X=1) and was
    never measured. `test_the_sawtooths_aliasing_floor_degrades_with_pitch_and_is_
    locked` still locked only the unfixed curve; its own docstring said the "after"
    numbers were owed.
    `tools/measure_saw_alias_after_2x.py` is that measurement, and it refuses three
    ways before it reports anything:
    - the 2x oscillator it measures is compared sample for sample against a real
    `VoiceFx(oversample_2x=True)` note, in both directions (on must match, off
    must differ);
    -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
2026-09-26 drum solo through the SPI and I2S pins: verify_synth_top --drum-solo
    run_case.render_drum_solo is the fixed-model engine every Drums row on the
    board was measured with. This sends the same stimulus over the SPI PINS --
    kit image, DVOL = BVOL = 0.45, ROUTE = 0, the voice silent because VOL is 0
    out of reset -- and cuts the scored window out of the DECODED I2S wire.
    Two comparisons, reported separately and never conflated:
    (a) the fixed model struck in the frame the LINK actually put the strike
    in. The only thing left that can differ is the chip, so this is the
    controlled one;
    (b) run_case's own render, strike at frame 480. The drum noise LFSR
    free-runs, so this differs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
    [verify_synth_top.py]
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2026-09-26 score a drum case on the integrated RTL, and publish the delta from its model twin
    tools/score_drum_i2s.py turns a decoded I2S window into a board record whose
    engine is 'integrated-rtl'. It measures through run_case.drum_measurements --
    the same estimator chain run_case itself calls, now split out so there is one
    measurement contract rather than two -- against the same frozen Fischer
    reference, and REFUSES a transcript that is a mutation run, is not a clean
    whole-chip PASS, does not bind the WAV's own hash, is a --drum-seconds smoke
    run rather than the case, or whose controlled comparison against the fixed
    model struck in the SAME frame was not bit-exact. That last one matters: a
    chip that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
    [compare_drum_i2s_candidate.py]
2026-09-26 reference_rigs: the oscillator-1 table is now a checked transcription
    The surviving "oscillator 1, for the waveform study" comment block held a
    hand-written Shape/Width table that disagreed with the sweep it claimed to
    report, `docs/surge-waveform-mapping.txt`, in six cells -- and cited
    `docs/surge-shape-sweep.txt`, a file that has never existed in this
    repository, so a reader who tried to check it found nothing. Issue #271.
    The worst cell: at Shape 1.000 / Width 50 % the comment asserted "a saw at
    2*f0: the fundamental is cancelled". The sweep reports that run as
    UNQUALIFIED with "no component within 50 cents of the commanded 110.00 Hz
    (the strongest nearby is 79.98 Hz, -551.7 cents)" -- n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
    [check_surge_waveform_comment.py]
2026-09-26 rungs.yml: the Shape/Width transcription checker runs on a pull request
    The comment this PR shipped into model/reference_rigs.py says the table and
    docs/surge-waveform-mapping.txt "cannot drift silently again". As shipped they
    could: tools/check_surge_waveform_comment.py was reachable only through
    `pytest tools/` in `make verify`/`make verify-full` and through `make controls`,
    and no workflow invokes any of the three -- nightly.yml's controls job is
    hand-listed steps, not `make controls`. A source comment asserting a mechanical
    guarantee no automated gate provides is issue #271's own defect one level up.
    Wired into the `python` job of rungs.yml immediately after the check_doc_claims
    pair, f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
2026-09-26 #300 review: I2S coverage derived from the stimulus and required complete; truncation control
    B1: verify_uart_bridge.analyze computes the required period count per segment
    (last write + tail, cut at the next origin) and requires every period exactly
    once in order; a shortfall is NO VERDICT. truncation_control() re-analyses the
    same run with its I2S cut in half and must be caught. held_note_audible,
    verify_rolling_playback and verify_live_midi carry both; the trial interpreters
    report the numeric requirement and refuse partial coverage (start red on
    e2dc705: the three new test_trial cases fail there). reuse='auto'
    (--reuse-rtl-if-identical) re-analyses a run only under its full identity.
    B2: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
    [uart_host.py, verify_live_midi.py, verify_rolling_playback.py, verify_uart_bridge.py]
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2026-09-26 shuttle: generate the half-slot report from the run, not from the draft
    report_halfslot.py fills docs/pnr-shuttle-halfslot.md's tables from the run's own
    state_out.json metrics and check_route.py's census. The point is that no number on
    that page is typed.
    A WRONG-THEN-RIGHT, caught before it shipped: the generator's area paragraph was
    drafted while the run was still in global placement and asserted that measured
    utilisation would come in BELOW the ORFS route's 60.1 %, reading the gap as margin.
    The measurement came back above it. The prose was a prediction wearing the clothes of
    a result. Both the direction of that comparison and the fit/no-fit verdict are now
    COMPUTED from the metrics,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
    [collect-evidence.py, report_halfslot.py]
2026-09-26 F1 filter path on the RTL: bench, harness, scorer and gate
    The instrument for #291: rtl-sketch/tb_f1_chain.v composes rate_conv_2x.v and
    ladder_dp_n.v exactly as voice_dp.v composes them under VOICE_FILTER_2X, so an
    F1 stepped tone can enter the filter (synth_top has no audio input, which is why
    M5A's SPI/I2S route does not generalise to a transfer-function case).
    tools/f1_rtl_filter_path.py drives it under iverilog and compares the words with
    the fixed-point model's; run_case.run_filter_case now takes the filter path as
    an argument so the RTL reading and its fixed-model twin come out of the same
    estimators, references and tolerance policy. tools/check_f1_rtl_record.py
    refuses a record that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
    [check_f1_rtl_record.py, tb_f1_chain.v]
2026-09-26 Anchor F1A on integrated-rtl: bit-exact against the model over 884,592 frames
    The stepped tone for F1A's commanded cutoff and its wide-open reference both
    went through rate_conv_2x.v -> ladder_dp_n.v -> rate_conv_2x.v under iverilog.
    Every word matched the fixed-point model, so all three metrics land where the
    fixed-model twin had them (corner 108.6651 Hz, low-band -0.8967 dB, rolloff
    -17.7933 dB/oct) and the case still passes at 0.76. Both readings are on the
    record under engine_comparison; nothing was overwritten.
    docs/scorecard/BOARD.md now shows integrated-rtl for a Filters case, and the
    scorecard README says what each anchor's route actually covers -- F1A's is the
    filter path, not the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
2026-09-26 shuttle: a carried-forward pre-route slack was about to be reported as post-route timing
    THE NUMBER THAT WAS WRONG BEFORE IT WAS RIGHT, and this one would have shipped as the
    headline of the whole issue.
    Reading the halfslot run's final cumulative metrics gives
    timing__setup__ws__corner:nom_ss_125C_4v50 = -178.5 ns against an 81.38 ns period --
    the routed chip missing the slow corner by more than two clock periods. I had the
    paragraph drafted.
    It is not a routed number. LibreLane's metrics are CUMULATIVE: every step's
    state_out.json carries forward every key any earlier step set. That key was written
    ONCE, by step 12, OpenROAD.STAPrePNR -- an unplaced, unrouted netlist with an ideal
    clo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
    [check_route.py, report_halfslot.py]
2026-09-26 #299 Doctor round 2 (plan090): complete programming attempts with history; ERROR as a third outcome; structured property scope; atomic current-run record
    - a retry is accepted only as a COMPLETE attempt (R0 digest, programmer line,
    its own exit 0) and every failed attempt stays in identity.programming_attempts
    - an unexpected exception is ERROR, exit 3 (NO VERDICT at the trial), with its
    traceback -- neither FAIL nor a refusal; analysis.json holds an in-progress
    ERROR first and is replaced atomically, so no stale result is ever current
    - properties are {verdict, evaluated_on, not_evaluated_on}: no unqualified PASS
    - both entry points tested: missing apply_frame (REFUSED / NO VERDICT),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
2026-09-26 shuttle: the flop cross-check was crying collapse at a healthy layout
    A SECOND WRONG-THEN-RIGHT, this one a false RED, and it took two goes to fix.
    check_route.py bucketed placed flops by matching the RTL hierarchy in DEF INSTANCE
    names, the way pnr/orfs/blockarea.py does. Against this flow's DEF it put all 12,275
    placed sequential cells into "outside synth_top", reported drum_regs as placing ZERO
    flops against 3,520 declared, and printed the collapse signature -- for a layout that
    is completely fine. A checker that cries collapse at a healthy design is not safely
    conservative; it is the thing that teaches a reader to skip the check.
    Cause: the netlist is flattened before placement, so e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
    [check_route.py, report_halfslot.py]
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2026-09-27 Drive a scorecard Ensemble case through synth_top's SPI and I2S pins
    The Ensemble family is the one place on the board where the mono voice and
    the drum section carry signal at the same time, and every Ensemble result is
    `fixed-model` -- two Python models summed in one process, with the master mix,
    the drum handshake and the I2S serialiser between them and the pins.
    rtl-sketch/verify_synth_top.py --ensemble E1A --ensemble-part mix
    the case's bass line and its 808 groove over the SPI pins, decoded from
    BCLK/LRCLK/SDATA and compared against synth_top_model with no tolerance.
    The stimulus is IMPORTED from run_case (ENSEMBLE_CASES,
    PATTERN_DENSE_EXTRA, _bass_line) rath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
    [compare_ensemble_candidate.py, verify_synth_top.py]
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2026-09-27 E1A anchor: re-score at the clean af8f8ef commit, document the evidence
    The wip commit's result record was scored while the worktree was still
    dirty (source_dirty: true). Re-run tools/score_ensemble_i2s.py --reuse
    against the clean af8f8ef commit so the committed record's provenance
    (source_commit, uncommitted_sha256, run_at) matches the code that
    produced it, and add the evidence README explaining the twelve-part
    decomposition, the DRUM_BUS_STALE negative control, and the wrong-then
    -right rate for this measurement.
    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
2026-09-27 Regenerate the R1 scorecard view for all three integrated-RTL anchors
    docs/scorecard/r1/README.md is derived from the board by
    tools/r1_scorecard.py, and fpga/release/test_r1_candidate.py
    ::test_r1_scorecard_view_is_current asserts the committed copy is
    current -- the `trial-release-bound` job's first step.
    Three board rows changed engine and the view had not caught up:
    D02A fixed-point model -> integrated RTL (component bench), #308
    F1A fixed-point model -> integrated RTL (component bench), #311
    E1A fixed-point model -> integrated RTL (component bench), this PR
    Only E1A is this PR's. #308 (50af9b2) and #311 (66bb003) each edited
    the board and left this derived view stale, so `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
2026-09-27 R1 image: Vivado 2025.1 build of the frozen rev-14 tree, published (#280)
    One build on the pinned box (Vivado v2025.1 SW Build 6140274,
    xc7a100tcsg324-1) of the R1 candidate (RTL/ROMs frozen at 6864435,
    OSC2X=1 FILTER2X=1 PULSE2X=0) via the unchanged fpga/build_arty.py with
    --verification fpga/reports/arty/rev14-clean/verification.json, published
    by the unchanged fpga/publish_arty.py into a fresh directory:
    arty.bit 544499e2c97061957004f999caf21d5caaf520f6b2682f84c6e6773e7d291d21
    routed.dcp 0f81026ecc8a0455da62ec2b7140ea806e00a97a71006d99743340299476ad5f
    WNS +15.445 ns, WHS +0.036 ns, 0 failing of 43,133 endpoints
    LUT 14,006 / 63,400, FF 13,485 / 126,800, DSP 100 / 240
    external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
    [dsp_cells_dump.txt]
2026-09-27 R1 image docs; fix r1_release default-argument binding; correct two tests
    r1_release.image_identity/external_io bound PUB_DIR as a default argument at
    definition time, so a substituted publication was never read (four REFUSED
    tests came back BOUND). The ext-io FAIL test edited only the clean variant,
    which the extractor correctly REFUSES as an inconsistent control. The
    default-switch test expected R0 STALE; R0's manifest measurably REFUSES
    (its replayed held-note capture is no longer what the CLI emits).
    [test_ext_io_extract.py]
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2026-09-27 Guard CI-wiring tests against a step that would never actually block
    test_manifest.py and test_check_surge_waveform_comment.py each asserted
    only that a substring appeared in a job's run: strings, which a step
    neutered with if: false or continue-on-error: true still satisfies while
    never failing the job. Add check_workflows.step_would_block_pull_request,
    a shared helper checking step presence, step-level if:, continue-on-error,
    and job-level pull_request exclusion together, and have both suites call
    it. tools/test_check_workflows.py adds unit-level controls for each hole.
    Closes #307
    Loom-Story: 2AMLogic/gf180-parasynth#307
    Loom-Trace-Id: 116e5f3bea1c8893fa2509d362ea2286
    Loom-Build: 0.19.4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
    [check_workflows.py]
2026-09-27 [dr] give every decision record its own number, and check it
    0017 was allocated twice on origin/main by two PRs that never saw one
    another (#241, #244). Both merges were clean: the filenames differ, so
    git had nothing to report, and no tool enumerated the directory. The
    collision was predicted in #250's body and then happened again the same
    day, one PR later, exactly as predicted -- because the next free number
    cannot be read off your own branch.
    Renumber 0017-metric-direction-is-part-of-its-definition.md to 0021
    (0020 was consumed by a PR that merged between #250 being curated and
    this fix being written; the drift is not hypothetical either). The
    polyBLAMP record keeps 0017: dozens of live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
    [check_decision_record_numbers.py]
2026-09-27 tools: probe for worktree processes this uid cannot signal
    A process attributed to a .loom/worktrees/issue-<N> directory that answers
    kill(pid, 0) with EPERM can never be terminated by any Loom reaper, because
    every reaper signals as the unprivileged daemon uid. Nothing was asking that
    question, so an orphaned LibreLane run survived three SIGKILL passes and nearly
    three hours on a shared 8-core worker with no surface reporting it.
    The probe attributes processes by argv text or cwd containment, classifies each
    REACHABLE / UNREACHABLE, derives a docker container id from /proc/<pid>/cgroup
    (the case whose only working teardown is the socket, not a signal), and REFUSES
    with exit 3 rather than r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
2026-09-27 [#319] r1_scorecard: image claims from the validated release manifest
    The implementation row's 'external I/O qualified' and 'DSP review
    complete' are now read from r1-2025.1.json, and only when a fresh
    r1_release.check() is BOUND; qualified also needs the ext-I/O record's
    state PASS and its control caught. STALE, REFUSED, missing, false or
    absent evidence prints NOT claimed / NOT qualified / NOT complete.
2026-09-27 [#329] the late-event policy, stated before any measurement
    fpga/late_event_policy.py states the device's late-event policy from the
    contract (P1-P7: on time, late -> next frame and reported, order,
    overflow, recovery, no stall, frame-boundary and wrap) and encodes it as
    an independent reference. Committed before any RTL or model run for #329.
    [late_event_policy.py]
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2026-09-27 [#329] repair the device model to the RTL's late-event behaviour
    uart_device_sim: a late event is queued due the NEXT frame (as
    uart_bridge.v queues audio_frame + 1), a late event whose sent due is
    before the queue tail's is dropped (as the RTL's first P_ECK branch),
    and a head that is due now or already past fires in the first frame
    with a free slot. Before, its frame midpoint was pushed a whole
    revolution (1.365 s) forward, so a late event -- or any third write due
    in one frame -- stalled the queue.
    verify_late_events: recorded divergence #339 (P3), RTL-vs-model
    event-by-event comparison, the control reads the pre-#329 model from
    git and must mis-execute accepted events. test_late_events: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
    [test_late_events.py, uart_device_sim.py, verify_late_events.py]
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2026-09-27 [#329] amend policy P3 per the operator's #339 decision: order by the sent due
    A late event whose sent due is before a draining queue's last due is
    dropped, counted and reported (ERR 3), as the numeric contract says and
    uart_bridge.v does; no RTL change. The original P3 wording (committed
    before any result) is kept in the docstring beside the amendment. The
    recorded divergence is removed: backlog step 32 is now an ordinary
    expectation, and the bench fails if the behaviour changes or any other
    divergence appears.
    [late_event_policy.py, test_late_events.py, verify_late_events.py]
2026-09-27 verify_deadline: skipallwin, the negative control for the skip2xwin candidate
    Skipping the scalar PolyBLEP window for every oscillator must break the
    I2S comparison on R1's base-rate square; otherwise the skip2xwin
    equivalence could not have seen a needed computation (#333).
    [verify_deadline.py]
2026-09-27 docs: skip2xwin re-checked on current sources, with its negative control (#333)
    The unused scalar PolyBLEP window work is still unused: skipping it for
    2x oscillators keeps every I2S period identical (SPI and UART pins) and
    raises worst slack 13 -> 20 (R1) and 3 -> 20 (PULSE2X=1). Skipping it for
    every oscillator breaks 358 of 2158 periods. Hand-off spec for the next
    image; voice_dp.v unchanged, R1 stays bound.
    Part of #333
2026-09-27 [R2] voice_dp.v: 2x oscillators skip the scalar PolyBLEP window loop (#333); admit PULSE2X on the R2 candidate only
    The one-line S_WIN condition from docs/deadline/recheck-333 (sound owner's
    hand-off). verify_deadline's mutants are re-anchored on the new line:
    full2xwin reinstates R1's loop (the reference), skipallwin stays the
    negative control. qualified_domain admits PULSE2X=1 only for images named
    in PULSE2X_IMAGES ({'r2-candidate'}); R0/R1 keep refusing it.
    This unbinds R1's voice_dp.v pin: it belongs to a candidate branch for the
    next image, never to R1.
    [verify_deadline.py, voice_dp.v]
2026-09-27 [cy] probe: 2-pole vs a TRUE 3rd-order Hh3, with the holdout sealed first
    #102 asks a discrete structural question -- is the cymbal's Hh3 a single
    2-pole or a genuine 3rd-order filter -- and requires it answered against
    the per-property scorecard (DR 0015), not the five-band energy cost every
    number in the issue text is stated in.
    This commit is the apparatus and the SEAL, before any score was taken:
    * the held-out recording is chosen and justified in the source, with the
    nine cymbal files some fit in this repository has already read listed
    by name. cy8/CY2500.WAV is one of the sixteen no fit has seen.
    * `control`: a cascade stage that is not a filter (a1 = a2 = 0, y = x).
    It must r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
2026-09-27 [cy] correct DR 0021's holdout table, and regenerate the board
    Re-ran `hh_probe5.py` at this commit and diffed its printout against the
    prose. Two things did not match, and reading the prose had not caught
    either:
    1. DR 0021's holdout table labelled the 3.794 row "2-pole, shipped
    Q 2.5 / gain 1.00". **3.794 is the two-pole at its FITTED Q 4.0 /
    gain 0.80**; the shipped setting reads **3.566**, which is the number
    the committed D14B.json records. The verdict does not move -- the
    shipped two-pole is now visibly the BEST of the four arms on the
    holdout, so the correction strengthens the decision -- but a table
    that mislabels which setting produced a number is how a later read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
2026-09-27 r0_capture analyse: an I/O error writing the record exits 3 (ERROR), not 1 (FAIL)
    The final _write_atomic raising OSError escaped main() and Python exited 1,
    this tool's FAIL code, while analysis.json still held the in-progress ERROR
    record; the .analysis.json.<pid>.tmp file was left behind. Catch OSError on
    both record writes and return 3, and have _write_atomic unlink its tmp on any
    failure. Tests start red: os.replace injected to fail at the final write
    (PASS and FAIL stub verdicts) and at the in-progress write.
    Closes #340
    Loom-Story: 2AMLogic/gf180-parasynth#340
    Loom-Trace-Id: 96cffb29a135a2f3d0b31d0a67d44125
    Loom-Build: 0.19.438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
2026-09-27 docs: file the half-slot tool findings upstream, and record each outcome (#342)
    Two defects are filed directly upstream with create-issue.sh --repo on the
    first attempt. The klayout-tools canary-sink fallback was not needed.
    - 6.1 stale per-corner slack -> librelane/librelane#1040
    - 6.5 router runs past its plateau -> The-OpenROAD-Project/OpenROAD#11537
    (checked against master 80c6be93c2: FlexDR::main exits only on zero
    markers or the iteration cap)
    - 6.4 DRT-0349 was already reported: librelane#550 and OpenROAD discussion
    #5839. Not re-filed.
    - 6.2 and 6.3 are declined as reporting/configuration gaps, and the doc
    records why.
    The draft of 6.1 was wrong before it was right. It said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
2026-09-27 docs: §6.5 matches feature/issue-33's corrected finding; flag OpenROAD#11537 for correction (PR #349 review)
    §6.5 had restated the withdrawn claim that the detailed router's violation count
    plateaued at iteration 35 and never moved again, and filed it upstream as
    OpenROAD#11537 with a stop-after-K-stagnant-iterations fix. feature/issue-33
    withdrew that in f5a92b1 an hour before the filing. The number came from a
    ninety-minute-stale log, and the live count went 3 -> 1 at iteration 53 after a
    16-iteration plateau (35-52), so the proposed stop would have cut off the last
    improvement.
    §6.5 now carries the surviving finding: DRT_OPT_ITERS is a count and not a
    budget, the cost per iteration sp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
2026-09-27 [R2] rectangle decimator headroom 0.74 (24248), saw unchanged at 0.85; control INJECT_BUG_VOICE_PULSE2X_RECT_HEADROOM
    recheck-333 item 5 (sound owner): at 0.85 every rectangle saturated the
    2x decimator's Q1.15 output near the top of the range. RTL:
    polyblep_saw_pair.v selects RECT_GAIN_Q15 = 24248 for rectangles under
    VOICE_PULSE_2X; the saw keeps SUBSTEP_GAIN_Q15 = 27853 (R1's output,
    bit-identical). Model: voice_fx._OS2_RECT_GAIN_Q15 in _render_2x for
    TWO_EDGE shapes. The negative control restores 27853 for rectangles and
    must fail the RTL/model comparison. model tests: the pulse DC test uses
    the rectangle gain; a new test pins saw = R1 sample for sample.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
    [polyblep_saw_pair.v, verify_voice.py]
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2026-09-27 [#315] publish fixtures write the constraint report an honest build writes; publisher tests (missing report, dead UART constraint)
    [publish_binding_cases.py, test_xdc_bindings.py]
2026-09-27 docs: #354 the verify_voice full-set failure is outside R1's qualified domain
    Only the all-maximum extremes image diverges on its own (INC_RANGE, ladder
    words no resonance produces, vol and weights past the host's range); the
    audition failures are that divergence carried by the bench's continuing
    voice -- audition alone passes 115,200 frames bit-exact with and without
    PULSE2X, and an in-domain stress of all three R1 presets at the live
    controllers' limits passes 144,000 frames (KEFF control caught), 10.65 dB
    below the ladder rail. verify_voice's docstring now states its scope; the
    out-of-domain divergence stays open in #354.
    Part of #354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
    [verify_voice.py]
2026-09-27 [#315] probe: the assertion on R1's real routed netlist (fixed XDC binds; R1's XDC refused)
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2026-09-27 [#315] report and refusal name a query by a digest of its pattern
    Tcl substitutes backslashes (and brackets) inside a double-quoted puts:
    the first real run on R1's checkpoint wrote rx_q_reg[[01]] for the
    pattern rx_q_reg\[[01]\], and every report line failed to match its
    XDC query. The pattern text is no longer written from Tcl.
    [publish_binding_cases.py, test_xdc_bindings.py, xdc_bindings.py]
2026-09-27 [#315/plan099] after route: the UART sync constraints hit the intended flops and arc, and nothing else is excepted
    On the routed design the build now checks (xdc_bindings.tcl_route_checks,
    exit 3 on failure) that the pin query's cell is the one flop uart_rxd
    drives and the async cells are exactly it and the flop its Q drives;
    every path from uart_rxd is a False Path ending at stage 1's D; the
    stage1->stage2 path is analysed, unexcepted, slack >= 0; the same-clock
    paths out of stage 2 are analysed, unexcepted, slack >= 0. It writes
    report_exceptions to exceptions.rpt, and the publisher reconciles that
    list with the XDC's set_false_path lines: exactly those, nothing else.
    Publisher controls: e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
    [build_arty.py, publish_arty.py, publish_binding_cases.py, test_xdc_bindings.py, xdc_bindings.py]
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2026-09-27 r1_release: pin the ext-I/O instrument by version (git), not the working tree
    R1's per-port record names the extractor by sha256. The check now loads
    fpga/ext_io_extract.py and the ext_io_timing it imports from git at
    EXT_IO_INSTRUMENT_COMMIT (e0dd329, the extractor's last change, whose
    bytes hash to the record's instrument_sha256) and re-derives with that.
    The tree's extractor may then change (R2 carries the #315 UART patterns)
    without R1's record going REFUSED. Tests: a broken tree module leaves R1
    BOUND; a record from another instrument and a wrong pin are REFUSED.
2026-09-27 r1_release test: the wrong-pin control refuses (the extractor did not exist before its pin)
2026-09-27 Extract measurement-validation harness into model/measure_harness.py (#104)
    validate_known_answer, floor_for_these_signals, windowed_alike and
    descent_test move out of tools/measure_conga_body_spread.py into a shared
    module next to audio_measure.py, plus assert_precondition for the
    REFUSE-unless-it-agrees checks the hi-hat probes repeated. Each function has
    an injected-bug control in model/test_measure_harness.py.
    The conga tool keeps only its conga-specific closures. Old-vs-new JSON is
    identical for the full report, --check and --descent
    (tools/probes/conga_harness_equivalence.py); a re-rated MC50.WAV still
    correlates 1.000.
    hh_probe.py / hh_probe2.py use assert_precondition; the probes R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
2026-09-27 shuttle: a resume mode, because ERROR_ON_TR_DRC aborts before post-route STA
    ERROR_ON_TR_DRC defaults true, so a route ending with even one detailed-router
    violation makes Checker.TrDRC abort the flow BEFORE OpenROAD.RCX and
    OpenROAD.STAPostPNR -- the only two steps that produce post-route parasitics and
    post-route per-corner timing. A run that stops there has a DRC count and no
    timing at all, and re-running the whole flow to obtain the timing would re-route
    for hours to reproduce a layout already on disk.
    `resume` restarts the same run directory from a named step with `full`'s skip
    list byte for byte (LibreLane resolves --from against the CONFIGURED step list,
    so resuming with a different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
    [run_librelane.py]
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2026-09-27 shuttle: split "does it fit" from "is it clean", and measure what the router's plateau costs
    Two changes to the report generator, both about verdicts the run is about to make.
    1. The verdict section folded the router's DRC count into one fit/no-fit line. This
    run is going to land with a small non-zero count, and folded together that renders
    as "does not establish that the joined chip fits one half slot" -- which would send
    #33 to a business decision about dies per wafer on the strength of three Metal2
    shorts. #33 asks an AREA question; "is this ready for tapeout" is a different
    question with a much longer condition list, most of which (§5) this run did not
    run at all. Bot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
    [finish_halfslot.py, report_halfslot.py]
2026-09-27 shuttle: emit the verdict as data, so docs/dag.json S2 and the doc cannot disagree
    docs/dag.json node S2 is currently `blocked` with a hand-written sentence. A
    hand-written status is the thing tools/compile_dag.py exists to abolish: it calls a
    node GREEN only when evidence it can read says so. So the verdict table in
    docs/pnr-shuttle-halfslot.md is now also emitted as
    pnr/shuttle/evidence/halfslot-verdict.json, from the SAME conditions() call that
    renders the markdown -- a DAG colour computed from a different predicate than the
    document a reader sees is precisely the drift compile_dag.py was written to stop.
    `passed` is the AREA question and only the area question, because S2 is named "Fits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
    [report_halfslot.py]
2026-09-27 docs: the half-slot page stops describing the run's momentary state
    Three prose changes, all about sentences that were true when written and became
    wrong within the hour:
    * 'The run was still in detailed routing when this page was generated' is gone. The
    verdict table marks an unreached condition *not measured*; a paragraph asserting
    which conditions those are is a second copy of the table that nothing regenerates.
    * Section 7 now records the two mechanisms this run needed rather than treating them
    as footnotes: ERROR_ON_TR_DRC aborts before the only steps that produce post-route
    timing, so the DRC count in section 4.5 belongs to a route that aborted the flow
    and was RESUMED PAST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
2026-09-27 shuttle: resume after the route, not at RCX -- RCX skips the antenna check and the fillers
    Wrong before it was right, and the wrong version would have looked fine. The driver
    resumed the aborted flow at OpenROAD.RCX, because RCX and STAPostPNR are the two
    steps that produce what the page was missing. RCX is also nine steps too late. The
    Chip flow between DetailedRouting and RCX is:
    Odb.RemoveRoutingObstructions
    OpenROAD.CheckAntennas-1 <- the POST-ROUTE antenna check, which #33 asks
    for by name
    Checker.TrDRC
    Odb.ReportDisconnectedPins / Checker.DisconnectedPins
    Odb.ReportWireLength / Checker.WireLength
    OpenROAD.FillInsertion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
    [finish_halfslot.py]
2026-09-27 shuttle: run the collapse gate end to end, with the three defects it exists to catch
    check_route.py verify() is the gate that decides whether the routed layout is the
    design or a collapsed netlist, and until now every test covered a PART of it -- the
    DEF parser, the net bucketing, the census -- while verify() itself was never
    executed. A gate that has not been shown going red against the current state is
    worth nothing (CLAUDE.md), and this one's only failure mode that matters is a false
    green.
    Four cases on a synthetic run directory whose DEF has a known census:
    healthy 3,520-flop layout -> 0, so the reds below are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
2026-09-27 shuttle: read progress from the container, not from the run's log file
    The run's openroad-detailedrouting.log is block-buffered by whatever writes it. On
    this run it was observed NINETY MINUTES stale -- still showing iteration 46 with 3
    Metal2 shorts while `docker logs` on the same container showed iteration 55 with 1.
    That is not a cosmetic difference. A tool finding (section 6.5: "the router spends
    hours on iterations that improve nothing") was drafted off the stale copy, and its
    central claim is wrong: the count went 3 -> 1 in the iterations the stale log said
    were flat. The finding has to be re-derived from the completed log, and may have to
    be withdrawn.
    Reading a lagging source is wo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
    [finish_halfslot.py]
2026-09-27 shuttle: assert chip_core connects every synth_top port, instead of commenting it
    #33's first acceptance criterion is that pnr/shuttle's RTL matches the current
    synth_top. chip_core.sv carries a comment saying "Every port of synth_top is listed",
    and a comment is not a check -- PR #176's wrapper was written against a synth_top
    that predated uart_rxd/uart_txd, which is exactly this drift.
    The failure is quiet in every direction that matters. Verilog named-port connection
    does not require completeness, so an omitted input elaborates as unconnected and
    synthesises to a constant; a constant input makes the design SMALLER and the route
    CLEANER, so utilisation, DRC and timing all improve; and the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
2026-09-27 shuttle: withdraw the "improves nothing" finding; the router improved after a 16-iteration plateau
    Section 6.5 claimed the detailed router "spends hours on iterations that improve
    nothing" and proposed stopping when the violation count has not improved for K
    iterations. Both halves were wrong, and the wrong version is the more useful record.
    It was drafted off a NINETY-MINUTE-STALE copy of the router's log. On the live
    container the count had already gone 3 -> 1, at iteration 53, after a run of 16
    iterations (35-52) that did not move it and cost 4.8 CPU-hours. So the proposed
    early stop would have truncated the run before its last improvement; K would have
    had to exceed 16, which is most of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
    [report_halfslot.py]
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2026-09-27 [#322] Mac host latency apparatus: real host, modelled wire and device
    fpga/measure_mac_midi_latency.py runs the real session and run_live on
    wall time, fed through the CoreMIDI adapter from an in-process virtual
    source playing the declared load; UART and device are the contract model
    (SimSerial on a wall clock), so only the host varies. It computes
    receipt -> applied on the device's own timeline, host hold, per-packet
    lateness vs planned release, and CoreMIDI delivery (before the endpoint).
    Known answer: on simulated time its endpoint distribution equals
    verify_live_midi.check()'s to 1e-9 (n, min, p50, p95, p99, max). Control:
    one 25 ms send-loop stall must turn on_time red (deterministic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
    [measure_mac_midi_latency.py, test_measure_mac_midi_latency.py]
2026-09-27 [#322] docs: CoreMIDI input, Launchkey smoke procedure (NOT YET RUN), Mac latency
    docs/live-midi.md: the macOS adapter, its rules and tests; the operator
    smoke procedure with exact commands (list ports, --port sim driven by the
    Launchkey, note/drum/knob in the log, unplug), marked NOT YET RUN, with
    the 11-of-16 live map (#298); the Mac host latency on a LOADED laptop
    (two runs, host-only numbers the result; endpoint excludes anchors lost
    to the device model's late-event defect, #329); four wrong-then-right.
    Makefile verify-fast runs the two new test files.
2026-09-27 [#322] CLI loss test: skip without pyserial (m5a-fast CI has none)
    The CLI opens the simulated board's pty through pyserial; m5a-fast
    installs numpy/scipy/pytest/pyyaml only, so uart_host REFUSED (exit 2)
    and the test failed there. The loss path itself stays covered by the
    run_live tests, which need no serial port.
    [test_coremidi_input.py]
2026-09-27 [#322] honest panic scope, host-only latency label, smoke pending operator
    The lost-input error now says the panic went over the UART and silences
    the board only if that link is up; a lost UART cannot be muted from the
    host and none is claimed. The Mac latency is labelled the host scheduling
    endpoint only, not key-to-speaker (USB ingress, UART/device, DAC, capture
    are separate boundaries). The Launchkey smoke is PENDING OPERATOR and
    does not block landing. The channel test asserts channel 1's note-off
    closes the gate.
    [midi_session.py, test_coremidi_input.py]
2026-09-27 [#330] count every offered message; define and test host overload (timing contract 3)
    measure_mac_midi_latency: each offered message is accounted exactly once
    (delivered in its frame / late / LOST / superseded / refused / no-op);
    the target needs complete accounting and nothing lost, since percentiles
    over surviving anchors say nothing about lost ones. Recovery after an
    injected stall is measured. --controlled-load N adds a specified load.
    midi_session (timing contract 3, criterion live-midi/1 unchanged): a late
    packet is sent RE-DATED to the first frame the wire can meet, counted and
    reported live. Before, a stale due more than 0.68 s old read as the future
    on the 16-bit timeline and a 1 s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
    [live_midi_contract.py, measure_mac_midi_latency.py, midi_session.py, test_measure_mac_midi_latency.py]
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2026-09-27 ladder_dp_n: (x * gain) >> 11 held in 26 bits, not 25 (#354)
    x is a 17-bit signed port and gain a 20-bit register, so (x * gain) >> 11
    spans -33,554,400..33,553,888: 26 bits signed. R1's 25-bit xg register
    wrapped there (the product is sliced before sat_s, so the wrap is not
    saturated), flipping the ladder input's sign. The model computes the
    product exactly and saturates u, as the RTL's own sat_s intends.
    Reachable only outside R1's qualified domain: the host programs gain only
    through ladder_regs at a preset drive (<= 272,630 at drive 1.6), so
    |x| * gain <= 65,535 * 272,630 < 2^35. R1's bytes are unchanged; this is
    for R2.
    Evidence (build box, Icarus, OSC2X FILTER2X): verify_voice --set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
    [ladder_dp_n.v]
2026-09-27 #354: record the first wrong operation (ladder xg width, RTL), its R2 repair #364 and control
    [verify_voice.py]
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2026-09-27 tools: pulse2x decimator headroom probe (#333)
    Clipped energy at the 2x oscillator's Q1.15 rail per waveform x note x
    candidate gain, a mix check, and the M5 phrases per candidate.
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2026-09-27 tools: M5 saw-only drive candidate, frozen budget/rule, pulse invariance control, R1 byte-binding check (#333)
    [measure_m5_saw_drive.py]
2026-09-27 docs: M5 saw-only drive: harmonic shape 7.56 -> 5.30 (M5A), 5.96 -> 4.96 (M5B), pulse-limited (#333)
    All three frozen candidates admissible and tied on the pulse-limited case
    metric; the rule's missing tie-break is disclosed and 0.35 recommended for
    review. Preset data, no RTL, but it changes R1-pinned m5a-saw bytes:
    next image/profile only. F1A-C still pass.
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2026-09-27 tools: #347 bounded pulse-cutoff sweep (14,073 / 17,000 / 20,000 Hz), pulse-specific objective, tie-break and rule fixed first
2026-09-27 docs: fix stale README claims flagged by Judge (§D gain mixing, §remaining defects)
    §D's 107-point confirmation table was measured at rectangle gain 0.85 but the
    surrounding prose cited R2's 0.74 gain-only figure, implying the untouched-point
    result covered R2's actual configuration. Label the table's gain explicitly and
    report the 0.74 evidence (probe-074.json, 32 points, 7 regress incl. one >1dB)
    separately. "Remaining critical defects" items 1-2 described work not yet done
    (operating-level candidate, 0.80 headroom challenger) that this branch's later
    commits already completed; point them at the actual results instead.
2026-09-27 probe controls must move their property the RIGHT way; confirmation rule factored and tested; saw-drive phrase reserves room for its three extra writes
    A control that moved its property in the wrong direction was counted as
    caught. The saw-drive override adds K/GAIN/OGAIN to a segment's first
    event (12 writes, ~18.6 frames), past the 16 reserved; it now reserves 22.
    [confirm_m5_saw_drive.py, test_confirm_m5_saw_drive.py, verify_synth_top.py]
2026-09-27 tools: #347 bounded pulse-cutoff sweep (14,073 / 17,000 / 20,000 Hz), pulse-specific objective, tie-break and rule fixed first
    Stacked on #343 (it reuses that PR's probe and operating-level tools).
2026-09-27 [#323] named, frozen R1 selection --image r1; image-aware R1 host binding
    uart_host: IMAGE_REVISION gains r1 (revision 14); it sends R1's kit
    frozen BY VALUE (fpga/release/r1-kit.json, refused unless it hashes to
    R1's digest) and R1's known-state start (KNOWN_STATE_IMAGES = tree, r1).
    The defaults do not move (plan092): no --image and release are R0, tree
    is development. midi_session supports r1 (sim accepts it; release still
    refused on sim). qualified_domain's R1 drift rule covers r1.
    R1's records bind the named selection: r1_candidate.HOST_IMAGE = r1, the
    frozen kit is read by value, and the host is bound by what it EMITS for
    R1 (every supported command's bytes, the frozen kit, preset ima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
    [midi_session.py, test_named_r1.py, uart_host.py, verify_live_midi.py, verify_rolling_playback.py]
2026-09-27 [#323] re-bind R1's records through the repaired derivation for the named selection
    Only text moves: each command's --image r1 argv, the selector, the
    session-start wording, host.binding (replacing host.files), the
    default-switch wording and the candidate digest. Every command's
    cmds_sha256 and init_writes are identical to main's.
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2026-09-27 compare_r2_pulse: pair by the scheduled condition and refuse acceptance over unmeasured pairs; saw-drive phrase margin back to 16
    The drive-compensated run keyed on the rendered patch, paired none of its
    110 rows with R1, and the tool reported acceptance over zero measured
    points -- a false green, caught before it was reported. Rows now carry the
    schedule's nominal point, and acceptance with any not-run or refused pair is
    NO VERDICT (exit 2). Tests pin both, plus the 1.02-vs-1.00 dB band and the
    brightness direction.
    The 22-frame phrase margin measured worse against the manifest schedule
    (worst -40 frames vs -22 at 16), so it is reverted.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
    [compare_r2_pulse.py, verify_synth_top.py]
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2026-09-27 #343 evidence, final: apply the declared rule -- pulse2x at 0.74 is NOT ACCEPTED vs R1 (6/107 fail); 0.85 also NOT ACCEPTED (7/107); saw 0.35 failed fresh confirmation (21/28); phrase schedule checked
    - §D reports the rule's verdict and lists every failing condition and
    property, separately from counts of numbers that moved.
    - The 0.85 '93 improved, 0 regressed' line applied only one of the rule's
    three terms; corrected.
    - pulse2x-headroom: the 7-of-32 figure is 0.74 vs 0.85, not vs R1, and its
    +1.02 dB point FAILS a 1.00 dB bound.
    - Remaining-defects item 5 now states the saw confirmation failure.
    - The level-repair tooling moved to its own branch; this PR is evidence only.
    - Saw phr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
    [compare_r2_pulse.py]
2026-09-27 R2 pulse: the one bounded repair (rectangle drive x 1/0.74) is also NOT ACCEPTED -- 3/110 standard, 11/112 fresh fail the declared rule; M5B gain moves 0.66 dB
    Carries the repair's tooling (probe drive compensation and fresh schedule,
    pairing by scheduled condition with NO VERDICT on unpaired rows, phrases
    with the pulse-drive repair) moved off #343, and its records.
    [compare_r2_pulse.py]
2026-09-27 [#323] a tampered R1 kit makes both R1 checks REFUSE with the reason, not crash
    The Judge on 74ec7d5: with one value changed in fpga/release/r1-kit.json the
    host raises KitRefused, as it should, but r1_candidate check and r1_release
    crashed with an uncaught traceback (exit 1), so T-RELEASE-BOUND-R1 read NO
    VERDICT with no reason. kit_identity and commands now turn KitRefused into
    Refused, naming the file and both digests. Two tests (candidate and release,
    check() and main()) tamper one value; both started red on the traceback.
    [test_named_r1.py]
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2026-09-27 [#313] receipts list RTL reuse per child; check-receipt re-derives and validates it
    A child run with --reuse-rtl-if-identical records rtl_reuse=report in
    its interpreter spec. Its interpreter requires each named RTL replay to
    report reused/re-simulated, why, and the simulator version (a missing or
    blank report is NO VERDICT, never assumed fresh), and exposes it in the
    child's metrics. The receipt lists rtl_reuse per child. check_receipt
    re-derives each child's status from its evidence and rejects a receipt
    whose stated status (child or summary) differs, even re-sealed. The
    rolling and live-MIDI records carry rtl_run from the replay.
    [verify_live_midi.py, verify_rolling_playback.py, verify_uart_bridge.py]
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2026-09-27 [#313] read the simulator version from stderr too (vvp -V prints there)
    The first real-simulator probe re-simulated an identical run: vvp -V
    answers on stderr, so its version read as unknown and the identity check
    (correctly) refused to reuse. The stubbed unit tests could not see it;
    the stub now answers vvp on stderr, as the real tool does.
    [test_uart_replay_reuse.py, verify_uart_bridge.py]
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2026-09-27 Choices fixed in model/cymbal_candidate.py before rendering. modal_fixed gains numerator code 3 = (1-z^-1)^3 (read as RAW before; no shipped kit writes it), with a known-answer test.
    [cymbal_candidate_eval.py]
2026-09-27 cymbal candidate: ablation records its level shortfall instead of refusing; loudness-matched listening pack tool
    [cymbal_candidate_eval.py]
2026-09-27 docs: correct modal_dp_rom.v's stale header to describe the ROM design
    The file header was a copy of modal_dp.v's older sketch header: line 1
    named the sibling file, and the closing paragraph said "the coefficients
    arrive as parallel ports and are selected by mux trees ... a real design
    reads them from a small ROM", describing the ROM version as hypothetical
    in the very file that implements it (`preset` port, `modal_coef_rom`
    instantiation).
    Rewritten to say what the module actually is, matching the description
    docs/area-budget.md section 3.2 already had right: an area-comparison
    variant (not the shipped bank -- synth_top.v / drum_kit.v instantiate
    modal_dp.v), a `preset` input selecting a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
    [modal_dp_rom.v]
2026-09-27 wip [#298] 16-sound map, circuit positions, drum_sounds property, alternates scenario, WRONG_ALT
    [midi_session.py, uart_host.py, verify_live_midi.py]
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2026-09-27 wip [#298] WRONG_ALT keeps the packet count so the RTL replay can pair it
    [midi_session.py, verify_live_midi.py]
2026-09-27 wip [#298] WRONG_ALT stays paired with the schedule across later switches
    [midi_session.py, test_midi_session.py]
2026-09-27 [R2] name the image r2 (build_arty --image r2, PULSE2X_IMAGES, the wrapper record at reports/arty/r2-clean)
    The settled image gets its final name before its build, so the build,
    the host selection and the release binding all use one name.
    [build_arty.py]
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2026-09-27 #379 perceptual gate: time-resolved features, 808-neighbour bar, proofs
    Critical-band spectrogram (summed and worst-frame), centroid and flatness
    trajectories, per-band attack rise times, per-band Schroeder decay, envelope
    modulation spectrum, and a pitch trajectory for pitched sounds. Rate,
    AC coupling, alignment and loudness are frozen once. The bar is the nearest
    adjacent Fischer knob setting, or a labelled WEAK resampled-take bar for the
    six single-take sounds.
2026-09-27 [R2] publisher, r1_release helpers and T-PLAY-DIGITAL take a named image (r2 mode, PULSE2X=1 replays)
    publish_arty binds each image to its own configuration and digital proof
    (build_arty.IMAGE_CONFIGS / IMAGE_VERIFICATION); r1_release.image_identity
    and the ext-I/O re-derivation take another image's parameters, R1's by
    default; verify_rolling_playback checks an r2 target against R1's frozen
    target (R2 is sent R1's kit and start).
    [publish_arty.py, test_publish_arty.py, verify_rolling_playback.py]
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2026-09-27 fix: D10A/D13A partial balance reports a trajectory, not one averaged window (#109)
    D10A (rimshot) and D13A (cowbell) both integrated "Partial balance" over a
    single fixed window -- 0-60 ms and 0-100 ms respectively -- which averages a
    sign change (the rimshot's high mode leads for ~5 ms then falls behind) or a
    falling curve (the cowbell's balance falls 15.4 -> 11.3 dB across the note)
    into one number that describes neither shape. The same window's filtered
    energy is also A^2*tau, not A^2, so it silently double-charges the same
    decay each case already scores separately as "tail decay"/"decay".
    Both cases now score `balance_trajectory_db` (tools/run_case.py): the two
    partials' REAL amplitude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
2026-09-27 docs: regenerate the R1 release view for the D10A/D13A results (#109)
    The R1 view (docs/scorecard/r1/README.md) is generated from the same
    docs/scorecard/cases.csv + docs/scorecard/results/*.json source data as
    the board, but by a separate generator (tools/r1_scorecard.py). This PR
    regenerated the board and the two result files without regenerating the
    R1 view, so tools/r1_scorecard.py --check reported STALE and
    fpga/release/test_r1_candidate.py::test_r1_scorecard_view_is_current
    failed in the trial-release-bound CI job.
    No measurement changes: this is the generator's own output for the
    results already committed here. D10A moves fail 5.76 -> no verdict and
    D13A's partial balance 2.82 -> 2.0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
2026-09-27 cymbal: the crosstalk control can now fail (Q6 skirt + paired negative, #376)
    #371's crosstalk control (the one ruling out "the high band's skirt leaking
    into Ln" as the explanation for the low band tracking DECAY on the
    recordings) built its high band with a steep synthetic 6th-order 7-12 kHz
    window. That window has essentially no energy at 2.9-4.1 kHz, so the
    control's Ln reading could not move no matter what -- it passed, but
    vacuously, and could not have failed on any input (#376).
    Fixed: the control's high band now goes through a constant-skirt-gain 2-pole
    band-pass at 7.1 kHz Q 6 (RBJ cookbook form) -- the same filter shape whose
    magnitude response reproduces the -17 dB/-13 dB skirt f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
2026-09-27 [R2] the tree's image is r2: build_arty defaults to it, the publisher's wrapper binding names r2-clean
    R1's sources are frozen at 6864435 and differ from the tree's, so an
    --image r1 build of this tree refuses at its verification record rather
    than labelling R2's RTL with R1's configuration. check_arty_evidence_binding
    (T-RELEASE-BOUND) and the builder fixtures now bind the tree's own record.
    [build_arty.py, publish_arty.py]
2026-09-27 #379 gate: estimator repairs found by its own proofs, tests, rule-5 injections
    The first proof run failed its own apparatus checks. Each repair is recorded
    at the point of use: attack as cumulative-energy times (three earlier forms
    rippled or jumped), loudness zero below the floor, both-sounding weights for
    the centroid and flatness trajectories, overlapping critical bands, pitch
    split into offset and worst-20 ms shape, an impulse feature for clicks, a
    span twice the target's, and bars measured through the candidate path plus
    the apparatus floor. Known answers in tools/test_perceptual_gate.py; three of
    the bugs reinstated as injections that must stay red.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
2026-09-27 [R2] the R2 image: built once (Vivado 2025.1), DSP and ext-I/O extracted from its own routed.dcp, published
    bitstream 167a6c7f..., routed.dcp e8fd3431...; WNS +14.700 / WHS +0.020 ns,
    0 failing of 43,147 endpoints; LUT 15,484, FF 13,490, DSP 124/240;
    DSP DPREG-4 13/13 dismissed (tools/dsp_dpreg_extract.py --box local, #363);
    ext-I/O PASS, worst setup +14.700 / hold +3.154 ns, spi_miso readback
    <= 1.4601 MHz; #315: every XDC query bound, UART-RX excepted by the async
    arc only, stage1->2 and 20 downstream paths timed.
    [dsp_cells_dump.txt]
2026-09-27 cymbal: correct the Q6 skirt calibration claim to its measured ~0.8 dB (#383)
    The PR's new docstring and scorecard prose both claimed the RBJ
    constant-skirt-gain band-pass reproduces `cymbal_bands.BANDS`'s "~17 dB
    down (at 5 kHz only ~13 dB)" skirt figures "to within 0.2 dB". It does
    not. Measured two independent ways against the shipped coefficients --
    `scipy.signal.freqz` on the biquad, and an FFT of the filter's own
    impulse response through `_q6_skirt_noise` itself -- the response is
    -17.744 dB at 4.1 kHz and -13.806 dB at 5.0 kHz relative to its 7.1 kHz
    peak. The deviations from the documented figures are 0.74 dB and
    0.81 dB, roughly 4x the claimed tolerance. Both methods agree to
    0.0003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
2026-09-27 #379 gate: common 20 kHz band and a pitch-limen floor
    Our renders carry up to 24 kHz that no 44.1 kHz recording holds; the
    self-check upsampled an 808 take and could not see it. BD's TONE neighbour
    moves pitch by 0.1 cents, a bar no ear resolves.
2026-09-27 #379 gate: impulse floor; cross-check against a second real 808
    The impulse feature is a worst-sample statistic and wobbles ~1 dB over a
    noise voice, failing MA's half-step check. crosscheck measures another real
    TR-808 (a private, never-committed sample set) against the Fischer bars.
2026-09-27 [R2] rolling verifier: an r2 target is checked against R1's frozen target (init bytes, WRONG_KIT controls), like r1
    T-PLAY-DIGITAL r2's first run came back NO VERDICT: wrong-kit-demo (sender
    release, target r2) failed but was not recognised as caught, because the
    init-byte check and the WRONG_KIT host controls were keyed on target == r1.
    The clean r2 phrases had therefore also run without their WRONG_KIT controls.
    [verify_rolling_playback.py]
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2026-09-27 [R2] tree-bound tests bind the tree's image (r2): publisher fixture, evidence-binding lists, registry; the R0 test accounts for the #315 XDC move
    test_r0_published_image_is_bound_to_its_historical_source_set was already
    red on main since #358 (the XDC moved; historical() does not compare it).
    [publish_binding_cases.py]
2026-09-27 tools: digitise Werner Fig. 4, gated on the three filters the schematic already fixes (#369)
    Hh2's corner and Hh3's shape are the two circuit values
    docs/scorecard/cymbal-369/candidate/README.md localised the §10 candidate's
    overcorrection to, and tr808-reference §18 lists both as open. W14b Figure 4
    plots all five cymbal filter responses and the figure is vector, so the curve
    coordinates are in the PDF to full precision.
    The gate is external, not self-consistency: Hbp1, Hbp2 and Hh1 have answers
    that come from resistors and capacitors on SN p.13, and Hh3's resonance comes
    from W14b §9's prose. All four have to be reproduced before anything is read
    off Hh2.
    Hbp1 3432.8 Hz Q 6.07 (kn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
2026-09-27 Constants carry their provenance as data, not as prose (#114)
    model/drums_fx.py's constants recorded their evidentiary basis in comments:
    VERIFIED IN A SOURCE / HARDWARE-MEASURED / INFERRED / FITTED, in prose, which
    makes "which failing case rests on an inferred constant?" a grep plus a
    judgement instead of a query. The comments are good and they stay; what is
    added is the machine-readable half.
    * `Provenance`, a frozen dataclass with a CLOSED status vocabulary
    (derived-from-circuit / measured / inferred / fitted) that refuses at
    construction: a `measured` entry without n, spread and date, or a `fitted`
    entry without fitted_on and holdout, is a ValueError, not a default.
    * `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
2026-09-27 cymbal (#369): Hh2, Hh3 and the level stage, read off W14b Figs 4 and 10
    The three values tr808-reference §18 lists as open, now resolved from the
    published responses instead of carried or fitted:
    Hh2 2-pole high-pass, f0 8839 Hz, Q 1.00, pass band +6.03 dB (gain x2.00),
    rms 0.007 dB. The kit carries 10.5 kHz Q 2.5 -- wrong on both.
    Hh3 THIRD-order high-pass: 2-pole 10323 Hz Q 5.64 at +8.86 dB, cascaded
    with a 1-pole high-pass at 5195 Hz, rms 0.008 dB. A 2-pole model of the
    same curve leaves 0.717 dB, so the third pole is real and located. #102
    assumed it sat at the same corner; it sits at half of it.
    LEVEL a single-pole differentiator, corner 18972 Hz,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
2026-09-27 cymbal (#369) candidate revision 2: Hh2 and Hh3 from W14b Fig. 4, not carried
    Revision 1 carried the kit's 10.5 kHz Q 2.5 into Hh2 because the reference
    left its corner unresolved, and put Hh3's third pole at the same corner as its
    2-pole, as #102 assumed. Figure 4 resolves both:
    Hh2 10500 Q 2.5 -> 8839 Hz Q 1.00
    Hh3 2-pole 10500 Q 2.5 + 1-pole at 10500
    -> 2-pole 10323 Hz Q 5.64 + 1-pole at 5195 Hz
    The level rule is deliberately UNCHANGED, so this step answers one question.
    Figure 4 also gives the circuit's own inter-band gains (+7.2 dB decay, +10.0 dB
    short, relative to the low band); they are recorded as constants and not
    applied, because changing the levels in the same s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
2026-09-27 cymbal (#369) step 3: the circuit values land in the reference; candidate 2 measured and negative
    tr808-reference §10 now carries Hh2 (8.84 kHz, Q 1.00, +6.03 dB), Hh3 (2-pole
    10.32 kHz Q 5.64 + 1-pole 5.20 kHz, +8.86 dB), the level stage's 18.97 kHz
    corner, and the band-passes' and high-passes' own gains -- so the filter chain
    alone puts the DECAY band +7.2 dB and the short band +10.0 dB above the low
    band. §18's "CY high-pass #2/#3 exact corners" is closed.
    §18's inference from the recording is corrected rather than deleted. It read
    the machine's 9-13 kHz shoulder as proof that "a high-pass at that corner
    cannot make that shape". It can: at Q 5.64 a 10.3 kHz high-pass peaks 15 dB
    above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
2026-09-27 [R2] the pulse research tools patch the gain the model applies (the model now owns the rectangle gain); image-kit test names r2
    measure_pulse2x_headroom patched _OS2_SUBSTEP_GAIN_Q15, which no longer
    reaches rectangles once voice_fx separates _OS2_RECT_GAIN_Q15 (R2's 0.74):
    its level check measured the same output twice. measure_mono_pulse_2x
    refuses an override the model does not build, by design; its test now
    checks that refusal and that the gain-only control scales rectangles by the
    model's gain and leaves the saw alone.
    [test_image_kit.py]
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2026-09-27 fix: D10A's lower RS guard was reading the strike, not the floor (#380)
    D10A's "Partial balance" reported `no verdict` on our own rimshot: no instant
    in [0, 60] ms cleared the record's own floor by 6 dB on both partials at once
    (best joint headroom 2.5 dB). #380 named two candidate causes and deliberately
    picked neither -- real excess mid-band energy in our exciter/bridged-T
    networks, or a guard band that does not generalise to our model's spectral
    shape.
    Measured against the Fischer reference (`rs8/RS.WAV`, s/n 103852), not against
    ourselves. Every level is quoted in dB re that record's OWN low-partial peak,
    because `prepare` peak-normalises and the two records have their peak in
    DIFFERENT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
2026-09-27 D10A reports a verdict again: fail 5.17 (#380)
    Regenerated from the guard retune in the previous commit, whose sha the
    provenance stamps (clean tree, dirty=false), by
    python tools/run_case.py D10A D13A --no-audio
    python tools/scorecard.py --markdown --readme
    python tools/r1_scorecard.py
    D10A "Partial balance" moves from `no verdict` (invalid, no instant cleared the
    floor on both partials at once) to a measured FAIL:
    ours -11.664 dB reference +3.854 dB error -15.518 dB
    tolerance 3.0 dB -> worst 5.17
    Our rimshot's high bridged-T mode is ~15.5 dB weaker relative to its low mode
    than the machine's. That is a sound defect and it is now on the board instead
    of being i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
2026-09-27 tools: digitise W14b Figure 9, the cymbal's tone stage (#369, #390)
    The last unmodelled block of reference §10. W14b declines to print the three
    fifth-order coefficient sets and its companion site is 404, but Figure 9 plots
    all three families as vector graphics in the same PDF as Figure 4, so the same
    instrument reaches them.
    `werner_fig4.calibrate()` grows multi-axes support (per-box grid lines and
    label windows, a labelled dB step instead of a hard-coded 10, a two-label
    minimum) and `tools/werner_fig9.py` calls it -- the same function object, which
    is what makes "an axis bug shows on Figure 4 first" a real gate rather than a
    figure of speech. Figure 4's and Figure 10's own numbers are un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
2026-09-27 cymbal (#369) step 4: the tone stage is the missing tilt, and it is measured
    W14b Figure 9's three families, read out. The hypothesis #390 stated before the
    measurement -- "a low-pass path would partially cancel the LEVEL buffer's
    rising slope; right shape, roughly the right size" -- is CONFIRMED.
    Across 2-20 kHz the LEVEL buffer tilts +16.6 dB and Ht3 tilts -17.7 dB. The
    model applies the first and has no tone stage at all. Per band, relative to
    1 kHz, the tone stage costs -24.7 (Ht1), -19.4 (Ht2), -20.2 dB (Ht3) at 20 kHz;
    candidate 2's residual at CY5025 climbs +24.0 dB over the same span. Same sign,
    same order, and nothing else in the measured chain has that shape.
    Two defects in the f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
2026-09-27 fix: correct TOM_DROP_RATIO comments to say fitted, not measured
    TOM_DROP_RATIO is the fitted law (K(1-A0)) evaluated at a stated reference
    setting -- x1.060 -- close to but not identical with that setting's own
    measured median (x1.054). The registry already records this correctly
    (status=PROV_FITTED, with the discrepancy in notes), but three prose
    locations still claimed the shipped constant itself was measured:
    model/drums_fx.py's comments above TOM_DROP_RATIO,
    docs/tom-pitch-drop-correction.md (which asserted the opposite -- "it is
    not a fit"), and spec/NUMERIC-CONTRACT.md. This is a prose-only fix: no
    constant, status, or notes field changes, and
    `python3 model/drums_provenance.py --regi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
2026-09-27 cymbal candidate 3: the tone stage's measured tilt, realised where the bank can hold it
    The tone stage (W14b Fig. 9, step 4) and the LEVEL differentiator (Fig. 10) are
    both in their asymptotic regions over the cymbal's band, -6 and +6 dB/octave,
    so over each band's own active range they cancel: the exact analog cascade is
    flat to within 0.45 dB (low band), 1.41 (decay) and 1.35 (short). So revision 3
    drops BOTH from the low and decay bands -- Hh1's and Hh2's numerators go from
    HP3 = (1-z^-1)^3 back to HP -- and realises the short band's tone pole exactly
    and for free, in the unused second pole slot of Hh3's 1-pole stage.
    Consequences: the bank is unchanged at 19 modes / 24 paths / N_NUMS 11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
    [cymbal_tone_realisation.py]
2026-09-27 cymbal candidate 3 measured at CY5025: the strike is solved, the tail is not a filter
    The scorecard for the revision-3 candidate committed in the previous commit,
    reproduced from a clean tree this session (every field of candidate3.json --
    levels, preservation, bands, thirds -- re-derived identically).
    #396 asked one question: does applying the tone stage's measured tilt, and
    nothing else, close candidate 2's +24.0 dB residual climb at CY5025? It does.
    In the strike window the tilt goes +24.0 -> +6.6 dB and the worst 1/3 octave
    15.3 -> 5.7 dB, against the SHIPPED kit's 15.4 -- so this is the first
    candidate in the chain that beats what ships on the defect the operator's A/B
    named. No 1/3 oc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
2026-09-27 cymbal candidate 3: name #400 as the filed follow-up for the 1-2.5 kHz tail
    Section 8 pointed at "the follow-up to this step" before the issue existed.
    It is #400, and section 6's consequence for #396 (the balance is static, so it
    is not on the path to the tail) is stated where #396 is mentioned.
    Part of #369.
    Loom-Story: 2AMLogic/gf180-parasynth#369
    Loom-Trace-Id: 2479bd0c0ef3844ff1ebb078f1666bc0
    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
2026-09-27 RS: correct the two bridged-T modes' relative drive for the bank's all-pole numerator
    The bank's RAW numerator is all-pole (peak ~ 1/sin(w0)); the circuit's
    bridged-T networks are band-pass (peak ~ H0 w0/Q). Exciting both with the
    same pulse -- which is what the circuit does -- therefore does NOT give the
    two modes the circuit's relative level: at the shipping constants the bank
    puts the high mode 11.80 dB BELOW the low where the circuit puts it 5.79 dB
    above, a 17.60 dB deficit that is a pure function of f0 and Q.
    RS_LO_X_ATT = 3 (18.06 dB, the nearest of the path word's 6.02 dB steps,
    0.46 dB from the derived value) attenuates the pulse into the LOW network.
    kit_808_rev11() undoes the wri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
2026-09-27 RS: re-balance the voice's level after the low network's drive correction
    RS_LO_X_ATT takes 18.06 dB off the excitation into the 455 Hz network, and
    that mode was setting the whole rimshot's peak, so the voice landed 7.05 dB
    below its share of Roland's chart -- 0.190 FS against 0.4286.
    `drums_fx_render.py --balance` reports x2.2532 for RS and x1.00 +- 0.08 for
    the other fifteen, so PEAK_RSG 0.343 -> 0.7728 and nothing else moves.
    PEAK_RSG is the LAST stage in the RS path (`frame` applies the nonlinearity,
    then the envelope, then att), so this is a pure gain: it moves neither the
    swing VCA's distortion nor the two modes' ratio, which is why the balance
    numbers below are unchanged by it.
    Thi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
2026-09-27 Contract revision 15: the rimshot's drive reaches the register image
    The fix is only real if it reaches the image, and the image is pinned. #388
    moves two values in KIT808 -- PATH[15] 0x9F (att 0 -> 3) and ENV_PEAK[14] 0x79
    (0.343 -> 0.7728) -- adds and removes no write, and changes no register, no
    state and no arithmetic. KIT808 is re-pinned 321a9354 -> 3d239bf8, its SIXTH
    move in this contract's history.
    - spec/reference: REV15 + REV15_RS, and a new
    test_revision_15_changes_only_the_rimshot_drive_and_gate_registers that
    rebuilds revision 14's image from the live one by undoing exactly those two
    writes, requires revision 14's hash, decodes both values through drums_fx's
    own encoder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
    [test_named_r1.py, uart_host.py]
2026-09-27 Separate revision 14 from "the tree" everywhere a test conflated them
    Four tests asserted R1's frozen kit BY COMPARING IT TO kit_808(), which was
    only ever true because nothing had moved the tree's kit since the freeze. That
    is the conflation revision 15 exposes, and deleting the assertions would have
    thrown away the check; each is re-pointed at revision 14's own reconstruction
    (kit_808_rev14) and paired with a control that the LIVE tree now fails it:
    - test_frozen_kit_is_revision_14_... compares the frozen copy to
    kit_808_rev14() and asserts it is NOT kit_808(), so "the tree did not move"
    cannot pass this silently.
    - test_r1_fixture_setup_is_the_frozen_target drives `--image r1` (it dr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
    [test_image_kit.py]
2026-09-27 The rimshot distortion test was measuring the second MODE, not distortion
    test_rimshot_is_distorted_and_that_is_the_sound went +14.5 dB -> +1.4 dB
    against a 6.0 dB floor, which reads as "the drive correction flattened the
    voice". It is not what happened, and `rs_mode_drive.py distort` is the
    instrument that establishes that -- committed with the finding, including the
    hypothesis it refuted.
    The estimator sums harmonics 2-5 of RS_LO_HZ, and 4 x 455 = 1820 Hz is 1.9 %
    from RS_HI_HZ 1786, well inside both modes' own bandwidths (~1/tau, hundreds of
    Hz). On the LIN arm -- no nonlinearity anywhere in it -- the fourth bin goes
    -23.6 -> -5.7 dB purely because the high MODE got 10 dB louder, and tha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
2026-09-27 test: pin that balance_trajectory_db must REFUSE white noise (RED)
    Start red, per docs/verification-rules.md rule 1: this commit's test FAILS
    against the implementation it is committed beside --
    RS_BALANCE_OP seed 0: white noise has no partials, so it has no balance
    -- REPORTED 4.13673986398107 dB at t1 34.5 ms instead of refusing
    The fix follows in the next commit.
    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
2026-09-27 fix: REFUSE a balance when the found line is not a resolved mode (#389)
    `balance_trajectory_db` REPORTED a balance on pure white noise at both
    shipping operating points. Its 6 dB joint-headroom gate compared a partial
    CHOSEN as the strongest line over ~4800 and ~14000 grid points against a
    floor read at one or two FIXED guard frequencies, so on a record with no
    partials the "headroom" between them was the pick's own selection bias, and
    it cleared 6 dB at some instant out of the 240 the trajectory visits.
    THE FLOOR CANNOT BE THE FIX, which is the measurement that chose the
    approach: our own rimshot clears the shipping gate by 0.4 dB and white noise
    clears it by 6 dB and more, so any raised f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
2026-09-27 probe: the measurements that chose the line-shape gate, and the four it refuted
    `tools/probes/balance_line_shape.py` is the instrument behind every number in
    `partial_trajectory.line_is_resolved`'s docstring, committed because a number
    without the code that produced it is a claim rather than evidence.
    theory the closed forms, against damped sinusoids whose tau we chose.
    No corpus needed -- this is the external grounding.
    synthetics the exact signals test_run_case.py's ground truth uses, each
    with the verdict CHOSEN from what the signal is; exits 1 on any
    disagreement.
    noise N white-noise seeds at both shipping operating points.
    r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
2026-09-27 chore: record the CI-measured split, which disagreed with the local one
    Two m5a-fast runs of f7a3ec3 put test_run_case.py at 274.6 s / 335.8 s and the
    other-files job at 323.6 s / 444.9 s, against local serial numbers of 282.9 s
    and 278.7 s. The split is even to ~15 %, not 1.5 %, and the other-files job is
    the longer one -- so the comment's own advice about where to put the next
    expensive file pointed at the wrong job. Runner speed is the variable this gate
    keeps tripping over, so the ruler job's reading is quoted beside each row.
    Loom-Build: 0.19.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
2026-09-28 cymbal balance: the prediction, committed before the ablation is rendered
    --variant balance applies the resolved factors (Fig. 4 band-pass peaks and
    high-pass pass bands, Fig. 9's nominal tone transmission) as the relative band
    levels with the three VCA drives held equal, which is the assumption under
    test. The prediction -- H-L 12.09 -> about +30 dB against the 808's 8.16, and
    what outcome would refute this step's refusal -- is written down first.
    Part of #396.
    Loom-Story: 2AMLogic/gf180-parasynth#396
    Loom-Trace-Id: 3911b3a0fb457d4483e2a537e7a8f3b3
    Loom-Build: 0.19.464 eeb7def821cc58fe6300f03e556fa9490a316bfc clean
    [cymbal_band_balance.py, cymbal_candidate_eval.py]
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2026-09-28 cymbal balance: correct two stale prose numbers (during evaluation)
    The tool's own module docstring said the low band's tone bound is 8.3 dB
    wide at its 3175 Hz calibration third; the tool computes 7.36 dB there
    (8.63 dB is the value at the third's upper edge, 3564 Hz). The same
    paragraph generalised 'much SMALLER at each band's own centre', which is
    measurably false for the decay band: 13.90 dB at its own 10079 Hz centre
    against 9.13 dB at 7.1 kHz. Replaced with the per-band numbers the tool,
    the reference and TONE_BOUND_AT_CENTRE_DB already agree on; the scorecard's
    file list said 30 tests where the suite has 32.
    Comment/prose only -- no constant, coefficient, register or gate changed.
    C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
    [cymbal_band_balance.py]
2026-09-28 cymbal (#369) step 6: a qualified 1-2.5 kHz decay, frozen before use
    The instrument #400 asked for: within-record Schroeder decay-time ratios
    rho(d) = T_M(d)/T_Ln(d) at six depths, with seven named properties, six
    injected defects each verified to turn a property red, one transformation
    asserted blind and verified blind, and REFUSALS rather than answers.
    Nothing in cymbal_bands.BANDS or measure() changes, so every number already
    committed under docs/scorecard/cymbal-369/ stays reproducible.
    Two of its own numbers were wrong before they were right and the controls,
    not inspection, caught both -- recorded in the module docstring.
    Loom-Trace-Id: 2479b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
    [cymbal_low_tail.py]
2026-09-28 cymbal (#369) step 7a: the 1-2.5 kHz instrument's known answers, and three more numbers that were wrong
    Finishes the instrument step 6 committed by adding the test suite it had no
    suite for (36 known-answer, refusal and matrix tests) and repairing what that
    suite found. Three of its numbers were wrong before they were right, and the
    tests caught all three rather than inspection -- the module's wrong-then-right
    rate is now 5.
    3. The onset-confound control was a single-sample impulse swept 0 -> 0.4 in
    AMPLITUDE. A one-sample impulse carries so little energy next to a 1 s
    strike that rho(-10) moved by 0.0001 over the whole sweep: the control
    could not fail. Now a 0.2 ms broadb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
    [cymbal_low_tail.py]
2026-09-28 cymbal (#369) step 7b: the noise-floor control was reporting the same number three times
    Wrong-then-right 6, and the worst kind: a control that ran, printed a table,
    and had done nothing. `noise_floor_control` reported
    as rendered M floor -33.87 dB rho(-10) 0.8709
    at_808_floor M floor -33.87 dB rho(-10) 0.8709
    ten_db_louder M floor -33.87 dB rho(-10) 0.8709
    -- three identical rows, because its premise was inverted. It assumed our
    renders are numerically noiseless ("the shipped kit's M floor is -266 dB re its
    peak") and the Fischer recordings are noisy, so it only knew how to add noise to
    OURS. Measured: our shipped render's M floor is -33.87 dB re its peak and the
    8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
    [cymbal_low_tail.py]
2026-09-28 cymbal (#369) step 7c: a third frozen window, so every one of the 25 settings is measurable
    Two windows left 10 of the 25 Fischer settings unmeasurable for this quantity,
    and the reason was not record length. At DECAY 10 and 75 the LOW band -- the
    REFERENCE band rho divides by -- is still ringing at 2.0 s: CY5010's Ln has
    12.5 dB of end margin against the 15 dB the truncation guard requires, so Ln
    refuses and rho refuses with it at every depth, in every TONE column.
    A 3.5 s window fixes it: all ten DECAY 75 and DECAY 10 settings answer at all
    six depths, reading rho_M(-10) 1.021-1.084 against a skirt baseline whose top is
    1.017. The three frozen windows are now
    1.5 s rho answers at D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
    [cymbal_low_tail.py]
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2026-09-28 cymbal (#369) step 7: the 808's 1-2.5 kHz outlasts its low band at all 25 settings; ours dies first; and no documented filter can do it
    The qualified measurement #400 asked for, applied to the whole knob grid, with
    both confounds bounded -- and then the next question asked of the CIRCUIT, which
    returned a refutation and a missing mechanism.
    THE FINDING
    808, 25 settings rho_M(-10) 1.021 - 1.139 (30 of 30 above the baseline)
    instrument's zero rho_M(-10) 0.943 - 1.017
    shipped kit rho_M(-10) 0.866 - 0.871
    candidate 3 rho_M(-10) 0.884 - 0.894 (and WORSE than shipped in Mn:
    0.785 against 0.878)
    rho(d) = T_M(d)/T_Ln(d),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
2026-09-28 The balance record's invariance to #412 is measured, not reasoned
    The Judge's read was that #412's model/drums_fx.py drift is rimshot-only and so
    cannot move the cymbal band-balance measurement -- and flagged it as reasoned
    rather than measured. This probe measures it, because 'I read the diff and it
    looked unrelated' is the cheap internal check CLAUDE.md names.
    It binds drums_fx to an arbitrary commit's copy through sys.modules (sys.path
    loses: every consumer prepends model/ itself) and compares, address by address,
    every register image the ablation's renders consume -- kit_808, the six
    band-only calibration kits, the ablation's own candidate kit rebuilt from the
    amps the RECORD holds, and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
2026-09-28 cymbal: a qualified 1-2.5 kHz band decay, with its prediction stated first
    #369 step 6, the measurement #400 asks for before any candidate. Step 5's §6
    found the cymbal's remaining 1-2.5 kHz error is time-dependent, and said in its
    own evidence-strength note that the finding is NOT a qualified decay measure:
    it is an energy ratio between two windows of the frozen thirds() instrument,
    and none of L/Ln/H covers 1-2.5 kHz.
    tools/cymbal_mid.py adds the band as a SEPARATE module, so every L/Ln/H number
    and every committed scorecard JSON is unaffected (plan098 forbids changing the
    frozen instrument mid-selection). It reuses the qualified machinery and adds:
    * M 891-1782 Hz, where the 3.45 kHz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
    [cymbal_mid.py]
2026-09-28 cymbal mid band: the leak prediction must know whether the record has Hh1
    Run with the low band's band-pass alone -- the worst case the first version
    assumed -- all 25 Fischer CY recordings REFUSE: their 1-1.8 kHz sits only
    4.1-5.5 dB above what a bare 3.45 kHz Q6 skirt predicts, below the 6 dB
    separability margin. That is not a property of the machine; it is the
    prediction being wrong for it. The 808's low path is the band-pass THEN Hh1
    (2.5 kHz Q 0.97, reference §10's "low" row), whose extra ~8.6 dB of rejection
    over 0.9-1.8 kHz belongs in the prediction.
    So `low_has_hh1` is now a REQUIRED argument of measure_mid and skirt_leak_db --
    no default, because it decides whether the 808's own m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
    [cymbal_mid.py]
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2026-09-28 Correct four prose numbers to the artefact committed beside them, and pin them
    Judge review of PR #410: the measurement, its preconditions and its controls
    hold up and every load-bearing number reproduces from `mid-band.json` -- but
    four numbers in the PROSE describing it are contradicted by that same artefact.
    `mid-band.json` is unchanged: nothing measured was wrong, only the sentences
    about it. Each corrected value was recomputed from the committed JSON rather
    than taken from the review.
    1. The band-pass-only over-leak range is 1.9-5.5 dB, not 4.1-5.5. Over the EDT
    window `over_leak_edt_bp_only_db` runs 1.95 dB (CY1000) to 5.46 dB (CY0050),
    with six of the 25 below 4 dB. The conclus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
    [cymbal_mid.py]
2026-09-28 [#401] R0's binding gate: name the publication-vs-verification scope gap
    test_r0_published_image_is_bound_to_its_historical_source_set compared two
    "moved source" sets computed over deliberately DIFFERENT scopes and asserted
    they were equal. publish_arty records sources()+roms()+[XDC] (a bitstream
    depends on its pin constraints); build_arty.validate_verification -- and so
    gate.drift()/historical() -- covers sources()+roms() only (the UART digital
    bench never drives a pin). The equality held by accident only while the XDC
    happened to be unchanged since R0. 383f10b (#315, 2026-09-26) changed it,
    three days after 62392bd published R0, and the gate went red for a reason
    that has nothing to do wi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
2026-09-28 Add SN p.13 nodal analysis of the cymbal TONE stage (#390)
    Resolves the inter-band balance that W14b Figure 9 alone could only bound
    to 18 dB (Ht1) / 9 dB (Ht2) at 3.45/7.1 kHz: SN p.13's schematic values
    around VR4 ("CY TONE") give a 4-node passive network whose transfer
    functions match Figure 9's own digitised k=1.0 curves (707 points across
    three independent windows, including the fully-measured Ht3 curve) to
    0.001-0.013 dB RMS with a single shared wiper fraction and zero per-path
    gain fudge -- and the network is independently confirmed 5th-order,
    matching W14b's own description, with all three transfer functions
    sharing one exact pole set.
    Loom-Story: 2AMLogic/gf180-parasynth#390
    Loom-T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
2026-09-28 docs: record the schematic route's resolved tone-stage balance (#390)
    docs/tr808-reference.md SS10/SS18 and docs/scorecard/cymbal-369/tone-stage/
    README.md SS4/SS7: route 1 (SN p.13 schematic + nodal analysis) resolved
    the inter-band balance that W14b Figure 9 alone could only bound to
    18 dB (Ht1) / 9 dB (Ht2) at 3.45/7.1 kHz. Route 2 (shared-denominator
    constrained fit) was not needed as a result. Resolved balance relative
    to Ht3: Ht2 +7.0 to +7.6 dB, Ht1 -13.9 to -18.1 dB across the cymbal's
    band. Candidate-building stays #396's job.
    Loom-Trace-Id: f60594888534baf2ee1c04991c030e04
    Loom-Build: 0.19.464 eeb7def821cc58fe6300f03e556fa9490a316bfc clean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
2026-09-28 test: ground the tone-stage schematic read in a pinned, re-renderable source
    The SN p.13 component values were cited but not checkable, and the one test
    standing behind "fifth-order, one shared denominator" was gated on sympy,
    which no workflow here installs -- so in CI it skipped, which reads exactly
    like passing.
    - Pin the scan: SN_PDF_URL/SHA256/PAGE and the two 400/500 dpi crop boxes the
    values were read off. `--verify-source <pdf>` checks the hash and
    re-renders those crops, REFUSING (exit 3) on a missing or wrong file rather
    than answering from an unverified one. The PDF stays a non-dependency, so
    make verify still needs no network.
    - Re-verified the read against that crop: al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
2026-09-28 docs: record the tone-stage read's external verification and its two defects
    Both entries were right and neither was checkable, which is the distinction
    this repository's failure-modes doc exists to draw.
    - §10/§18 and the scorecard now state that the SN p.13 read is pinned to a
    hash-verified scan at a recorded page and crop, re-read on 2026-09-28 with
    no value changed, and that the re-read confirmed the rail assignment from
    the schematic itself (three-cap vs two-cap op-amp inputs; which op-amp VR2
    CY DECAY is wired to) where previously only the fit had chosen it.
    - They also record that the fifth-order/shared-denominator test was gated on
    sympy, which no workflow here installs,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
2026-09-28 Name the follow-up issue, #420, where the stale lines are flagged
    The six places this branch marks as superseded by #390/#417 said "follow-up work,
    filed separately". That is the exact defect section 6 of `balance/README.md" reports
    against this same chain: a blocker cited as prose rather than as an issue number was
    tracked by nothing, for weeks. Filed as #420 and cited by number in all six:
    `balance/README.md` (top note, section 1's factor table, section 4's third-merge
    paragraph, section 5's second bullet), `../README.md`'s balance paragraph, and
    `docs/tr808-reference.md` section 18.
    Part of #396
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2026-09-28 cymbal (#369) step 8: §10's asymmetric clipping eliminated, and step 7's 9.4 dB gap corrected to 1.3
    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
2026-09-28 cymbal (#369) step 9: the TONE knob law's write-up, and the corpus gate it claimed but could not run
    The measurement itself is unchanged and its numbers are unchanged. This
    commit is the write-up, the CI wiring, and one defect in the apparatus that
    the write-up had already described as fixed.
    docs/scorecard/cymbal-369/tone-knob/README.md records the step: with
    alpha = TONE/100 read off VR4's "20K(B)" linear-taper marking (SN p.13,
    docs/tr808-reference.md 10) and ONE inter-band balance shared by all 25
    settings, #417's nodal solution reproduces the 808's H - L versus TONE to
    0.33 dB against a 3.0 dB bound, over a 7.1-8.1 dB span per DECAY column.
    Nothing is fitted to the recordings' TONE dep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
    [cymbal_tone_knob.py]
2026-09-28 TEMPORARY: #404's acceptance control -- this commit must be RED
    Pushed so CI answers the criterion rather than me reasoning about the glob:
    a deliberately-failing test file under tools/, named by NO workflow, must turn
    CI red with no further edit to rungs.yml. It fails an arithmetic assertion
    rather than an import, so the red is evidence the SUITE was collected and not
    that Python rejects bad input. Removed in the next commit.
    Refs #404
    Loom-Story: 2AMLogic/gf180-parasynth#404
    Loom-Trace-Id: 87a1da115e16457b8136cc5b575e3cbe
    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
2026-09-28 cymbal #369 step 10: the tone realisation re-derived from the nodal solution
    tools/cymbal_tone_nodal.py + tests. Revision 3's low-band tone realisation was
    validated against W14b Figure 9's 121-564 Hz window fit and is 4.06-4.72 dB off
    the nodal solution that replaced it, at every TONE position -- outside the 3.0 dB
    bound revision 3 itself declared. The short band, the one band Figure 9 plots
    across the whole audio band, agrees between the two routes to 0.10 dB, so the
    nodal route is not the suspect.
    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
    [cymbal_tone_nodal.py]
2026-09-28 cymbal #369 step 10: the TONE knob on a rendered candidate
    Step 9 ended by naming one question: does a candidate driven by VR4's wiper law
    track the 808 as TONE moves? This answers it, with a repair found on the way in.
    THE REPAIR. Revision 3's low-band tone realisation was validated against W14b
    Figure 9's 121-564 Hz window fit (0.45 dB) and is 4.06-4.72 dB off the nodal
    solution that #390/#417 put in its place -- outside the 3.0 dB bound revision 3
    declared, at every TONE position. The nodal route is not the suspect: over the
    short band, the one path Figure 9 plots across the whole audio band, the two
    routes agree to 0.10 dB. Repaired with one discrete section carrying the
    network's own 4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
    [cymbal_tone_render.py]
2026-09-28 docs: un-stale the cymbal balance record on the re-derived tone term
    The tone term's re-derivation (previous commit) moved gap_db, which is an
    input to rebalance(), so the ablation's own amp registers moved: M_CYH1
    0.014140 -> 0.011815, M_CYHI 0.126937 -> 0.109543 (-1.56 / -1.28 dB).
    balance_input_invariance.py --baseline-rev fb638f4 still reports 0 moved
    register addresses -- correctly, because its question is whether another
    commit's model/drums_fx.py moves a render input, and nothing here touches
    model/ render code. The input that moved is upstream of drums_fx, in the amps
    rebalance() computes, which that probe cannot see. So balance-ablation.json WAS
    re-rendered, from a clean tree at 82d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
2026-09-28 [#421] check_arty_evidence_binding: a publication scope that sees the XDC
    The live gate built both comparison sets from sources()+roms(), so it had
    zero constraint-drift coverage and did not say so: 383f10b (#315) changed
    fpga/boards/arty-a7-100.xdc and the rung still printed "covers every
    compiled source". Verified against the pre-change file: with the XDC
    reverted to R0's published bytes it exits 0.
    Decision: a --scope flag, NOT a widened default.
    The bound record is a verification record, and no verification record this
    repository has ever produced hashes the XDC -- the UART digital bench drives
    no physical pin. Widening drift() would make Makefile:73 permanently red for
    a question no c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
    [check_arty_evidence_binding.py, probe_arty_constraint_scope.py]
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2026-09-28 cymbal (#411): candidate 4 evidence — over-skirt refused, strike guard regressed
    docs/scorecard/cymbal-369/candidate4/: the candidate4.json render record and
    the gain-invariance probe's record, plus a README documenting the verdict:
    restoring Hh1's own gain to AMP_MAX moves tools/cymbal_mid.py's qualified
    over-skirt residual the wrong direction (+0.04 -> -0.55 dB, away from the
    808's +4.41) and adds one strike-window violation (2.5 kHz, +8.3 dB) to the
    guard candidate 3 uniquely held at zero. The 50-300ms/300-1000ms tail
    residuals on tools/cymbal_bands.thirds() do improve. Not promoted --
    --variant candidate4 stays a diagnostic ablation; the shipped default is
    unchanged (candidate 3).
    doc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
2026-09-28 tools: a crash-rate harness and an RSS wrapper for the #422 segfault
    Both are instruments for issue #422, committed before the measurements they
    produce so the numbers in the PR have the code that made them.
    tools/crash_rate.py runs a target N times, reads os.wait4's status rather than
    the output, and keeps four buckets apart: PASS, TEST-FAIL, CRASH (SIGSEGV and
    friends) and ERROR (never reached the code). A batch whose runs all ERRORed
    exits 2 -- REFUSED -- because 'no run crashed' over an empty denominator is a
    fabricated number, and looks exactly like stability.
    tools/run_with_rss.py answers the two questions the crashing job could not:
    peak RSS and ulimit -s. It inherits the child's st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
    [crash_rate.py]
2026-09-28 fpga: sigma-delta no-DAC demo output on Pmod JD (#406)
    A separate wrapper, arty_a7_sd_top, instantiates arty_a7_top unchanged
    (SIM_NO_MMCM=1, with the MMCM and lock owned by the new wrapper under the same
    hierarchical names, so the shared XDC binds as is and no published evidence
    moves). It decodes the I2S wire back to samples (i2s_rx.v) and drives a
    2nd-order one-bit modulator (sd_dac.v, the master copy for sibling synths)
    onto JD1/JD2. Mono on both pins.
    verify_sd_dac.py measures in-band SNR against the source through an exact
    integer CIC + FIR, after known-answer checks of the estimator itself: sine
    -6 dBFS 103.9 dB (>= 95), model held note 99.5 dB (>= 90), full-scale square
    84.3 dB (>=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
    [arty-a7-100-sd.xdc, arty_a7_sd_top.v, build_arty.py, build_arty_sd.py, i2s_rx.v, publish_arty.py, sd_dac.v, tb_sd_dac.v]
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2026-09-28 cymbal (#369) step 11: re-quote the VCA-drive gap after the rebase onto main's schematic route
    Rebasing onto main (#420/#430) moved balance.json's gap figures from the
    figure route (9.85/38.23 dB) to the schematic route (10.13/39.79 dB), which
    this module's want dict, docstring, tests and generated record still quoted
    against. `tools/cymbal_vca_drive.py --check` REFUSED on the merged tree
    until these were re-derived; the headline (VCA section is not the missing
    factor) survives and strengthens.
    [cymbal_vca_drive.py, test_cymbal_vca_drive.py]
2026-09-28 fix: re-derive step 10's named-property figures from the tool that computes them
    Three figures attributed by name to properties of tools/cymbal_tone_nodal.py
    disagreed with what that tool returns, at five sites including the project's
    external-reference document under a [measured:] provenance tag:
    nodal-grounded written 0.10 dB, computed 0.026
    fig9-window-blind written 5.62 dB, computed 4.61 (5.59 peak-to-peak)
    one-register-set written 0.00 dB, computed 0.171 (68 % of its bound)
    The tool is byte-identical across both commits of #428, so these were never
    its output. No conclusion moves -- all three stay on the same side of their
    bound -- but every one erred in the self-fl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
    [cymbal_tone_nodal.py, cymbal_tone_render.py]
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2026-09-28 fix: stop the JSON serialiser coercing a numpy flag into a number
    The `1.0`-instead-of-`true` defect #429 names in
    `verdict.properties["h-edt-falls-with-tone"].ok` has a second site the issue
    did not name: `verdict.columns.<DECAY>.h_edt10_ok`, identical cause. `d_hed`'s
    values come from a numpy ratio, so `max(...) <= TIME_TOL` is a numpy
    comparison, and it survived a `bool()` cast aimed at the one site the issue
    listed. That is what makes a per-site cast the wrong fix.
    The root cause is not the comparison, it is `json.dumps(..., default=float)`:
    an np.bool_ is not JSON-serialisable, so it reaches `default`, and
    `float(np.True_)` is `1.0`. Every numpy comparison in either tool is one `and`
    a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
    [cymbal_tone_nodal.py, cymbal_tone_render.py]
2026-09-28 widen check_doc_claims' default document set, and audit the boundary (#435)
    The default set was `docs/*.md` -- one directory, not even recursive -- so a
    claim marker anywhere else was parsed by nothing, reported by nothing, and
    looked exactly like one that passed. That is weaker than a skipped test: a skip
    at least produces a REFUSED.
    Three changes, in order of what they buy:
    1. `DEFAULT_INCLUDES` / `EXCLUDED_PREFIXES` replace the bare glob. An explicit
    include list of the directories this project writes prose in, and a short
    enumerated exclude list for the vendored and generated trees. Not `**/*.md`,
    which reaches `.loom/worktrees/` -- whole second copies of this repository,
    s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
    [check_doc_claims.py]
2026-09-28 fix(cymbal): filter-figure and vca-drive preconditions now read their content
    `cymbal_band_balance.preconditions()` gated `filter-figure` and `vca-drive`
    on `path.exists()` alone, so any file at either path -- including an empty
    one -- lifted the refusal without a number from it ever reaching the
    balance. `tone-figure` and `schematic-vr4` were already correct: their
    content is read and validated downstream at the point of use.
    `filter_record()` reads werner-fig4.json, re-derives each band-pass peak and
    high-pass pass band from the digitised curves, and REFUSES if the file is
    absent, unreadable, missing a curve, or if the re-derived value disagrees
    with the pinned `cc.BP_PEAK_DB` / `HH*_PASS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
    [cymbal_band_balance.py]
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2026-09-28 [#436] a constraint-binding bench, so the XDC has evidence of its own
    No committed record in this repository had ever hashed
    fpga/boards/arty-a7-100.xdc: the UART digital bench drives no physical pin, so
    it hashes sources()+roms(), and the only records carrying the constraint hash
    are publication records, which are history by construction.
    fpga/verify_xdc_binding.py checks nine named properties of the constraint file
    against things maintained independently of it -- the wrapper's port list, the
    compiled RTL's generate blocks and instances, the datasheet-derived
    output-delay budget in ext_io_timing, and the required match counts declared in
    xdc_bindings.EXPECT -- and writes a record hashing e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
    [verify_xdc_binding.py]
2026-09-28 [#436] publication scope is answered by two records, one per bench
    A file is covered when every record that answers for it agrees with the live
    bytes, and the files a record may answer for are the ones its own bench read:
    sources()+roms() for the UART digital record, the XDC plus the sources its
    names were resolved against for the constraint record. Neither speaks for the
    other's files, so no record claims coverage of bytes it never opened.
    A file NO record answers for is REFUSED rather than passed over -- without
    that, narrowing a bench's read set would make this gate greener, which is the
    one direction a coverage check must never move in.
    The constraint record's own preconditions are ass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
    [check_arty_evidence_binding.py, probe_arty_constraint_scope.py]
2026-09-28 [#436] tests and controls for the constraint record, and a default rung that says where the constraint question IS answered
    fpga/test_verify_xdc_binding.py starts red on bytes that shipped: the pre-#315
    constraint file R0 and R1 were routed against fails hier_separators on lines 42
    and 46 and passes every other property, so the bench is discriminating rather
    than merely red. It also pins that every property is moved by some injection
    (a property no control can move is decoration), that the committed record is
    exactly what a fresh run produces, that the record hashes what it read and only
    that (never a ROM), and that an injected run can never be written as a record.
    tools/test_check_arty_evi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
    [check_arty_evidence_binding.py, test_verify_xdc_binding.py]
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2026-09-28 [#436] the probe's arm 0 asserts the default rung's new line, not its old one
    Arm 0 required NOT COVERED in the default rung's output, which was the state
    before the constraint record existed; the line now names the record that
    answers for the XDC and that record's state. Caught by running the control,
    not by reading it -- the probe printed GREEN(0) with a DEFECT annotation,
    which is the failure mode it is built to make visible.
    Part of #436.
    Loom-Story: 2AMLogic/gf180-parasynth#436
    Loom-Trace-Id: 9d310dd17909a9fc81a67f6928114633
    Loom-Build: 0.19.482 b99a2ea2f0b7701f7b49489e11f7ab2056d39e4b clean
    [check_arty_evidence_binding.py, probe_arty_constraint_scope.py]
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2026-09-28 deadline: state what the drum-RTL hash pin protects, and what it costs (#443)
    Judge review of #451, non-blocking notes 1 and 2:
    - The pin's docstring said that without it the relaxation would turn off
    "with no reason given". That is not the failure. An identical stimulus
    returns "identical" before stimulus_binding reads the RTL, so without the
    pin a drum RTL change would go unseen. The docstring and the precondition
    comment now say so. They also say that the one-busy-window check only
    corroborates the argument, because it is measured on the capture's old
    values; the hash pin is what protects the argument's precondition.
    - Both now state the cost: any edit to drum_dp.v, drum_kit.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
    [verify_deadline.py]
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2026-09-28 feat: pads XDC, build script, core-clock SW3 reset, reset-boundary frame accounting
    - fpga/boards/arty-a7-100-pads.xdc: BTN0-3/SW0/SW3 pins cited line by line
    from the Digilent master XDC at the commit the release XDC pins; the six
    human inputs false-pathed from the port, with the reason in prose.
    - fpga/build_arty_pads.py: kit-hash gate and bench-record gate before
    Vivado; routed-design disposition check of the six inputs; WNS/WHS verdict.
    - arty_a7_pads_top: the SW3 toggle detector moves to the core clock so the
    reset request is a same-clock async clear, not a clk100->core_clk arc.
    - tb_pads_top: a reset cuts the frame in flight short; clear the strobe flag
    under reset and judge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
    [arty-a7-100-pads.xdc, arty_a7_pads_top.v, build_arty_pads.py, tb_pads_top.v]
2026-09-28 test: pads build-gate tests, Makefile wiring; unmask the double-fire control
    PADS_DEBOUNCE_DOUBLE first went red for the WRONG reason: the extra BD hit
    fired by the held press's release bounce kept BD busy through the chord, so
    the chord's BD press was a busy drop, the write count came out equal
    (extra_writes 0) and only misplaced frames showed the fault. The chord now
    starts after any busy window a spurious release press could open.
    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
    [build_arty_pads.py, test_build_arty_pads.py, verify_pads_top.py]
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2026-09-28 fpga: disposition the constant dac_sck by evidence, not an inert false path
    The first direct-plug build failed its own gate, correctly. Synthesis ties
    dac_sck to 0 (Synth 8-3917), so Vivado times no path to it, and the
    set_false_path on it never appeared in report_exceptions. The XDC drops that
    line. The gate now requires dac_sck to be in no no_output_delay class and the
    synthesis log to name it as a constant.
    check_implementation also read the LIVE XDC rather than the snapshot the
    build compiled, so a build could have been judged against constraints it
    never used. It now reads the snapshot.
    On that build's real reports every new check passes: the output classes,
    the constant evidence, and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
    [arty-a7-100-sd.xdc, build_arty_sd.py, test_arty_sd_top.py]
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2026-09-29 CI: skip suites a change cannot affect, fail-safe, still reporting (#457)
    tools/ci_changes.py classifies a run's changed paths as none (agent
    tooling only), docs (prose Markdown no suite names) or full (anything
    else, including unrecognised paths, empty diffs, unknown events, git
    failures, and every push to main). A `changes` job in rungs, arty,
    provenance and trials exposes the scope; every suite job needs it and
    is gated by `!cancelled() && scope != 'none' && scope != 'docs'`, so a
    failed classifier (no output) runs everything and a skipped job reports
    success rather than leaving a required check waiting. A new doc-claims
    job runs the claim checker and its controls under the docs scope.
    `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
    [ci_changes.py]
2026-09-29 test(play_song): long-rest fixture, schedule-anchored unwrap, independent note-off check (#466)
    Loom-Story: 2AMLogic/gf180-parasynth#466
    Loom-Trace-Id: fed56047067779cee8ce385d676fac5e
    Loom-Build: 0.19.500 53a29fd9e938f5bea55740940df709b32aac1008 clean
    [test_play_song.py]
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2026-09-29 fpga: share the constant-port-evidence regex between gate and test
    fpga/test_arty_sd_top.py::test_constant_port_evidence_matches_vivados_own_warning
    asserted a regex written independently inside the test, so if the build
    gate's copy in check_implementation drifted or broke, the test would stay
    green regardless -- the "internal consistency is cheap" failure mode.
    Extract the pattern into build_arty_sd.constant_port_evidence(log_text, port)
    and have both check_implementation and the test call it. Add cases for a
    different port on the same line and a different message ID, plus a control
    that breaks the shared function and confirms the test goes red.
    Manually confirmed (not just asserted): edi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
    [build_arty_sd.py, test_arty_sd_top.py]
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2026-09-29 test(play_song): state and pin schedule_unwrap's 2^16 blind spot (#466)
    The anchored unwrap maps a write off by exactly k*2^16 frames back onto its
    due frame, and aliases any other error beyond +-0x8000. The docstring claimed
    the opposite. Correct it and the call-site comment, and add a test recording
    that a 0x10000 shift is NOT detected (with in-range and aliasing controls).
    Also correct the long-rest gap figure: 99600 and 147600 frames.
    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
    [test_play_song.py]
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2026-09-29 fpga: bring-up that asserts its preconditions instead of assuming them
    A bring-up session on 2026-09-28 had a correct design, a correct bitstream
    and a correct host, and produced no sound for a long time. Nothing was
    broken. Four preconditions were assumed rather than asserted, and every
    instrument we had stopped at the FPGA pins, so every instrument said "fine":
    1. two FT2232H devices on the bus (an Arty and an unrelated Dual RS232-HS),
    so an unscoped openFPGALoader may address either;
    2. R0 was flashed, which drives no LRCLK on JA4 at all, while the operator's
    purple PCM5102 plugged into JA's top row expects SCK/BCK/DIN/LCK -- the
    sd-demo image of #408 is the one laid o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
    [bringup_arty.py, test_bringup_arty.py]
2026-09-29 fpga: fit the frame rate over a span the method can actually support
    The first version of this gate refused a correct clock. It took 6 STATUS
    samples over 0.39 s, timestamped each at the END of an ~80 ms subprocess, took
    a two-point slope, and gated at +-2%. On hardware it reported 46,960 Hz and
    REFUSED. A proper measurement of the same clock, minutes later, read
    47,977.8 Hz -- within 0.05% of nominal, residual jitter 1.0 ms.
    So the gate was unsatisfiable in practice, which is worse than no gate: it
    trains the reader to ignore gates, including the ones that work. It also
    blocked the deliverable it was supposed to protect.
    What changed:
    * timestamps are the MIDPOINT of each read, since t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
    [bringup_arty.py, test_bringup_arty.py]
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2026-09-29 fpga: refuse an unparseable PACKAGE_PIN line in effective_pins instead of silently dropping it
    effective_pins() parsed only the single-line `set_property PACKAGE_PIN <site>
    [get_ports <port>]` form via regex. Any set_property line that names
    PACKAGE_PIN but doesn't match that exact form -- notably Vivado's -dict form,
    `set_property -dict { PACKAGE_PIN <site> ... } [get_ports <port>]` -- would
    silently vanish from the returned pin map with no error, so any consumer
    (test_effective_pins_are_the_direct_plug_layout, check_implementation's
    placed-pins check) could be fooled by an incomplete map if an XDC source ever
    grew that form.
    Scope check (#471): neither build.XDC (fpga/boards/arty-a7-100.x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
    [build_arty_sd.py, test_arty_sd_top.py]
2026-09-29 fpga: give verify_sd_dac's silence case an injected-bug control (#472)
    The silence case was the one clean case in this bench with no paired
    control. A passing measurement with nothing able to make it fail cannot
    distinguish "the silence path is correctly measured as quiet" from "the
    estimator reports quiet whatever it is fed" -- a DC-offset bug, or a bench
    wired to the wrong signal entirely.
    The existing three controls structurally cannot reach it: I2S_RX_SHIFT moves
    a bit that is the same bit on a constant-zero sample, SD_NO_SAT's clamp never
    engages near zero, and SD_FIRST_ORDER's quantiser still idles on a mean-zero
    pattern. So this adds a fourth, purpose-built for it.
    INJECT_BUG_SD_DC_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
    [sd_dac.v, verify_sd_dac.py]
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2026-09-30 refprofile: host-scoped verdicts and ONE #123 environment recorder for both hosts
    RIG_VERDICTS now names a (rig, host) pair. `modeld-pedalboard` sits BESIDE
    `modeld`, never in place of it: the dawdreamer entry records that this bundle
    renders exact silence under that host, and overwriting it would erase the
    measurement the rest of the profile was built against. `verdict_for(rig, host)`
    refuses a verdict asked for under the wrong host, which is the mistake #123
    found -- `RIG_VERDICTS['modeld']` used under whatever host happens to be loaded.
    `modeld-pedalboard`'s `qualified` is None, not False. 'nobody has run it' and
    'it cannot be used' are different facts; `qualified_rigs()` will not pick u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
    [qualify_modeld_pedalboard.py, test_qualify_modeld_pedalboard.py]
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2026-09-30 review fixes: --list printed a None verdict as NO, and two claims were second-hand
    Two defects found reviewing the change before opening it, both of the kind it
    is itself about.
    1. `--list` rendered the qualified column as `"yes" if r.get("qualified") else
    "NO"`. The whole point of this change is that `qualified: None` ("nobody has
    run it") is not `False` ("it cannot be used") -- and the first None entry to
    reach a profile would have been announced as **NO** in the one place a
    reader goes to find out what this profile rejects. Red run, on the entry this
    change adds:
    surge-type2 old renderer -> 'yes' qualified=True
    modeld old renderer -> '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
    [test_qualify_modeld_pedalboard.py]
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2026-09-30 rig: REFUSE rather than traceback when a Model D bundle exists but will not load
    A `.vst3` bundle is a DIRECTORY, so `_PedalboardPlugin.__init__`'s
    `os.path.exists` precondition passes for one that holds a single byte.
    `pedalboard.load_plugin` then raised `ImportError` straight out of the
    constructor, which `tools/qualify_modeld_pedalboard.py` does not catch: the tool
    exited with a traceback instead of one of its three documented outcomes, and the
    word `ImportError` in it reads like the host being missing rather than the file
    being a stub.
    Measured on this Linux dispatch worker, not hypothesised. `/tmp/mdb/Model
    D.vst3` is exactly that state -- correct name, plausible tree, one byte (the
    ch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
    [test_qualify_modeld_pedalboard.py]
2026-09-30 docs: the pedalboard host is installable on Linux, so narrow what is missing
    Three facts measured on a Linux dispatch worker on 2026-09-30, replacing three
    claims that were written down without one.
    1. **`pedalboard` is not a macOS-only dependency.** 0.9.25 installs cleanly from
    a wheel into an isolated venv on Linux / CPython 3.12 -- no compiler, no
    system audio libraries. `docs/pedalboard-rig.md` said the tool exits 2 with
    `no pedalboard on this machine` "on every Linux host in this fleet"; with the
    host installed it exits 2 with `Moog Model D is not installed at ...`
    instead. **The one remaining blocker is the licensed plugin binary**, which no
    venv produces. `qualified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
    [qualify_modeld_pedalboard.py]
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2026-09-30 #432: read the cymbal's collector supply off SN p.13
    Extend tools/cymbal_vca_drive.py with the Q19/Q20 envelope region: two new
    hash-pinned crops, the full envelope netlist, and a backward-Euler transient
    with PWL diodes and two emitter followers.
    Findings:
    - the three reservoirs (C38/C40/C41, all 1 uF) ARE equal at the peak, to
    0.009 V against a 0.252 V diode-spread bound;
    - the three COLLECTOR ceilings are not: 12.79 / 4.94 / 3.97 V, +8.26 and
    -1.91 dB re the low band, and they peak 1 / 120 / 19 ms apart;
    - R93 470k is in SERIES with VR2, not parallel -- correcting
    docs/tr808-reference.md S10 -- so C41's tail is 0.47-2.47 s and the DECAY
    knob lands on the LOW band, which is what t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
    [test_cymbal_vca_drive.py]
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2026-09-30 fix(crash_rate): measure each run's own peak RSS, not the harness's size
    The `tools` CI job failed test_peak_rss_is_per_run_not_a_running_maximum
    on Linux every time (small run ~233 MB vs big ~438 MB). That was a real
    measurement defect, not a flaky test. On Linux, execve() folds the outgoing
    address space's high-water mark into the process's maxrss
    (exec_mmap -> setmax_mm_hiwater_rss). A child spawned by fork, vfork or
    posix_spawn starts in the parent's address space, so ru_maxrss for a pytest
    spawned straight from the harness is max(harness RSS, own peak). Under
    `pytest tools/` the harness is ~230 MB, so every run reported that much.
    No choice of spawn primitive avoids this, and subtractin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
    [crash_rate.py]
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2026-10-01 refprofile: a verdict per (rig, host, capability), not one boolean per rig
    RIG_VERDICTS held one boolean per reference, so the most restrictive
    capability gated every other one -- which is how Mini V3's uncalibrated
    envelope knobs came to be recorded as blocking 32 Mono cases when an
    oscillator-waveform comparison and a sustained-filter comparison need no
    envelope timing at all (#136, postmortem of #122).
    * CAPABILITIES names the six axes, including #137's two causality checks
    so they do not need the axis re-cut when they land
    * every rig carries capabilities + capability_why, three-state, with the
    measurement that produced each entry. Surge's pitch is None (nothing
    here has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
    [control_capability_verdicts.py]
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2026-10-01 a case declares what it consumes, and the parked pack runs its gate
    The verdict map is half of #136; a runner can only use it if the CASE says
    what it needs. capabilities_for() derives that from the case's own
    required_measurements cell in docs/scorecard/cases.csv rather than from a
    second table free to drift from the spec, and refuses an unclassified term
    rather than silently shrinking a requirement set.
    The derivation reproduces the live state independently: M1A/M5A/M5B need
    only capabilities Mini V3 has, and the six not-run Mono anchors are exactly
    the ones that need envelope timing. That correspondence was settled case by
    case, from measurements, by people with no capability map -- so i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
    [capability_pack.py]
2026-10-01 Add mechanism=<status> claim modifier: effect and mechanism are separate claims
    Issue #135: a measured effect (Diva's two renders differing in 1,763,954 of
    1,764,000 samples) shipped bundled with an unverified mechanism claim (a
    wall-clock-timer artefact, therefore a valid demo-detector positive control),
    and the mechanism inherited the effect's credibility without ever being
    tested.
    Extends the existing claim-marker system (docs/claim-markers.md,
    tools/check_doc_claims.py) with a `mechanism=<status>` modifier, usable
    alongside any existing claim kind. The closed vocabulary is #114's own four
    constant-provenance statuses (measured/derived/inferred/fitted), reused
    unchanged per #135's own re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
    [check_doc_claims.py]
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2026-10-01 fpga: correct hits() docstring on 15.7.1 sequence anchoring; pin step movement in tests (#496)
    Loom-Story: 2AMLogic/gf180-parasynth#496
    Loom-Trace-Id: 229d41ea927365acff2bcf19b79b9d45
    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
    [spi_host.py, test_spi_host.py]
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2026-10-01 [dag] propagate RED/BLOCKED dependency status so a node cannot be GREEN above a failing prerequisite
    Closes #140
    Loom-Story: 2AMLogic/gf180-parasynth#140
    Loom-Trace-Id: e72823871993570ddc46208235c96ed1
    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
    [compile_dag.py]
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2026-10-02 fix(corpus-lineage): close the R3 bypass a one-word 'unknown' walked through
    PR #523 review found R3 defeated by a variant of the input it was written to
    catch. Established-ness was tested as `val == unknown_marker or
    val.startswith(unknown_marker)`, so `unit: "unknown"` or `unit: "TBD"` with
    `lineage_status: "documented"` was neither OPEN (R1) nor FALSE (R3) -- just a
    non-empty string. The full chain passed clean: boutique-808 with
    unit="unknown", documented, roles=["held-out-validation"] reported 0 FALSE,
    i.e. a held-out verdict backed by a pack whose machine nobody established,
    with the checker green. R5's VERDICT_GROUP ban never fired because the
    relabel to `documented` routes around it.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
    [corpus_lineage.py]
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2026-10-05 fix(corpus_lineage): R3b serial is a positive grammar, not a bounded-gap match (#527)
    SERIAL_RE accepted any digits within 20 non-digits of 'serial', so
    'TR-808, serial unknown, bought 1984' named a unit on its purchase year.
    A serial now counts only as KEYWORD [separators : # . - or space] DIGITS{3,},
    with the keyword starting a word. Committed manifest still 0 FALSE.
    Docstring and docs/corpus-lineage.md state the accepted syntax and the
    remaining boundary: syntax is not truth ('serial no. 1984' passes, pinned
    by a test), and neither route verifies a physical machine.
    Loom-Trace-Id: 9e9fe26bd1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
    [corpus_lineage.py]
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2026-10-05 fix(corpus_lineage): R3b rejects a negation before the keyword, placeholder serials, and `.` across a sentence (#527, PR #536 review)
    - SERIAL_NEGATIONS: the one word directly before the keyword (separated
    only by whitespace, `-` or an opening bracket/quote) may not deny or
    hedge the serial: `no serial 1984`, `missing serial: 1984`, `unknown
    serial #1984`. A fixed slot, matched whole, never a word search.
    - A single-repeated-digit serial (`s/n 0000`, `serial 1111`) is a
    placeholder and is rejected.
    - `.` is removed from SEP; it survives only inside `no.` and `s.n.`, so
    `no serial. 1984` / `serial. 1984` no longer cross a sentence boundary.
    - Docstring, SERIAL_RE comment and docs/co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
    [corpus_lineage.py]
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2026-10-05 fix(corpus_lineage): R3b slot reads a slashed word whole and treats Unicode dashes as separators (#527, PR #536 review 2)
    The negation slot captured `([a-z]+)`, i.e. only the letters after the last
    `/`, so `n/a serial 1984` was read as `a` and `w/o serial 1984` as `o`; no
    deny-list entry could ever match them. The slot word is now
    `[a-z]+(?:\s*/\s*[a-z]+)*`, read whole (whitespace round the slash removed,
    as `s / n` already allows), and `n/a`, `w/o` join SERIAL_NEGATIONS. The
    separator class gains U+2010..U+2015 so `no—serial 1984` and
    `no–serial 1984` are read like `no-serial 1984`. Side effect, controlled:
    `yes/no serial no. 103852` is no longer over-rejected as `no`.
    The finite deny-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
    [corpus_lineage.py]
2026-10-05 corpus_lineage R3b: deny a slashed slot token when any / component is a negation (#527)
    Red-first controls for used / no, boxed/no, kit / unknown, working / missing
    through names_a_unit() and check(); yes/no pinned as fail-closed residual.
    [corpus_lineage.py]
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2026-10-07 gate-379: make the #374 candidate a mandatory gate; keep REFUSED injected runs unrun
    Q6 requires the rejected #374 candidate to FAIL (PASS fails, absent/REFUSED
    leaves the decision REFUSED). injected_outcome() preserves QUALIFIED/NOT
    QUALIFIED/REFUSED as True/False/None and records the injected decision.
    [gate_calibrate.py]
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2026-10-09 [#568] synth_count.py: refuse on missing yosys / failed run / no cells line; .sh is an exec shim
    Gated in make verify and verify-fast (no yosys needed: tests use shims).
    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
    [synth_count.py, test_synth_count.py]
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2026-10-09 [#557] freeze: declare REFUSED Fischer readings; onset-phase worst case 17.5 c
    PR #601 review. glide_cents REFUSES at DECAY knob 0 (tau ~15 ms), and two
    untouched Fischer conditions (U-F-T50-D00, U-F-T00-D00) feed the primary
    median, but the record only said what a refused retrigger reading meant.
    - record: primary_metric.refused_readings. A refusal is never a number. A
    reference/shipped refusal is excluded from both medians and listed. A
    candidate refusal where shipped measured is a FAILURE. Fewer than 6 measured
    conditions, or a lost TONE/DECAY holdout, gives REFUSED, never a pass.
    The predicted refusals come from the closed form only.
    - check enforces that the rule is present, co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
    [bd_glide_phase_sweep.py, bd_pitch_predeclaration.py]
2026-10-09 [#557] Doctor: validate baseline numbers, satisfiability on the untouched median, fixed sweep grid, scoped worst case
    - min-improvement REFUSES bool/string/non-finite/negative baseline numbers and a negative evaluated threshold
    - satisfiable() uses the shipped untouched median (equality satisfies); without --readings the one-take figure is a diagnostic and no claim is made
    - bd_glide_phase_sweep: 0.5 Hz pitch grid, record-derived knobs, edge scan; record states declared-knob worst (13.63 c) and range-wide worst (34.21 c) separately
    - check() pins min_measured_conditions to its derivation; TONE holdout twin test
    - doc: wrong-then-right count updated (7, 4 by reviewer)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
    [bd_glide_phase_sweep.py, bd_pitch_predeclaration.py]
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2026-10-09 compile_dag.load_results: REFUSE a corrupt results file (#600)
    A present-but-unparseable dag-results.json read as {} (no evidence),
    and --run then overwrote it with partial results. Absent is still {};
    corrupt or non-object now exits REFUSED. Includes the defeating input
    (valid JSON, wrong shape) and a check against the committed file.
    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
    [compile_dag.py]
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2026-10-09 [#611] lead-drive: injected controls for baseline-mismatch and unchanged-audio refusals; refuse NaN baseline deviation; correct README claim
    Loom-Story: 2AMLogic/gf180-parasynth#611
    Loom-Trace-Id: e866f49c0c137e031fe619974a820abd
    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
    [lead_drive_337.py, test_lead_drive_337.py]
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2026-10-09 [#608] Guard controls must refuse for their intended reason
    Judge feedback on #612: --expect refused accepted any REFUSED, so
    BROKEN_REPRO and GARBAGE counted as caught when iverilog/vvp were simply
    absent (verification rule 5, unrelated-refusal false green).
    - Refusals now carry stable reason codes (NO_TOOL, NO_VERSION,
    COMPILE_FAILED, RUN_FAILED, TIMEOUT, OUTPUT_UNPARSEABLE,
    CONTROL_NOT_EXPECTED); vvp is threaded through instead of hardcoded.
    - --expect refused requires the inject's intended reason
    (NO_IVERILOG->NO_TOOL, BROKEN_REPRO->CONTROL_NOT_EXPECTED,
    GARBAGE->OUTPUT_UNPARSEABLE). Mutant controls first require a clean
    baseline (KNOWN_DEFECT/FIXED); otherwise NO_VERDICT, exi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
    [check_iverilog_generate_case_string.py]
2026-10-09 Nightly controls: replace blind I2S_SWAP with a discriminating serializer bench (#619)
    I2S_SWAP cannot fire at the whole chip (core strobes at cycle 156 > 127), so
    nightly's --expect-fail on it failed and blocked later controls. Add
    verify_i2s_tx.py/tb_i2s_tx.v (strobe at cycle 20, right channel observable),
    run it clean and with I2S_SWAP in nightly and make controls, swap the
    whole-chip row for I2S_DELAY, and make the test_rtl.py swap test assert the
    blindness rather than a catch.
    Loom-Story: 2AMLogic/gf180-parasynth#619
    Loom-Trace-Id: 6f70d8a7f0df0aeb5d3d0b4be40b16ed
    Loom-Build: 0.19.950 72047016af9d66c08f900bb94c642a66dfd75fc5 cle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
    [test_rtl.py, verify_i2s_tx.py]
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2026-10-09 fix(r1_harvest): emit an explicit missing row for every expected run with no receipt (#609)
    The first version skipped a run directory without a receipt and said the
    scorecard reports NO VERDICT. That holds only when a whole gate is empty.
    With T-LIVE-MIDI rtl present and sim absent, playability read PASS on half its
    evidence (#628 review).
    The harvester now compares baseline rows with ROWS and appends a row with
    verdict NO VERDICT, receipt_valid false and missing true for each expected
    (trial, mode) that is absent. A run with a missing row exits non-zero. The
    scorecard needs no change: gate_verdict requires every row PASS, and
    trust_rows maps receipt_valid false to NO VERDICT. The partial-a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
    [r1_harvest_controls.py]
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
