2AMLogic/gf180-parasynth/(notices)

Notices in the files:
docs/DESIGN.md:
against a real TR-808 (s/n 103852, CC0). Its section 8 withdraws one
